liyuxuan3003/PrismGC/Test/lmj/WII_2nd/29366194135649415.jpg

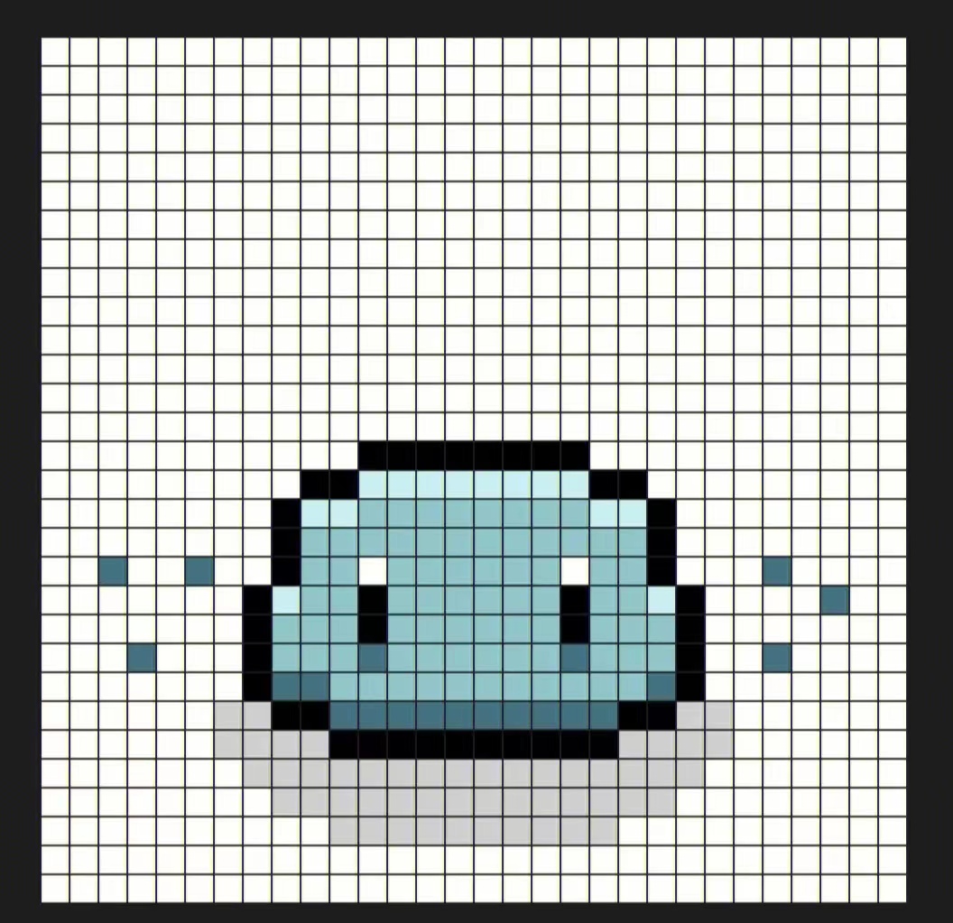
Test/lmj/WII_2nd/29366194135649415.jpg
