liyuxuan3003/PrismGC/Test/lmj/nunchuckarduinoExample-master/Readme.md

README
======

This is an example how to collect the gyroscope from a Nun Chuck device and send the information throught usb port.

Acknowledgments
===============

This project is a modified veriosn of nunchuck library found at:
http://www.windmeadow.com/node/42
