liyuxuan3003/PrismGC/Report/20230817-PrismGCDocumentFinal/Appendix.tex

\section{游戏地图展示}

\begin{TableLong}[游戏地图展示]{|c|c|c|}
    \xcell<c>[2ex][0ex]{}&
    \xcell<c>[2ex][0ex]{}&
    \xcell<c>[2ex][0ex]{}\\*
    \tiny\ttfamily RDRU L&
    \tiny\ttfamily DRUL DRUL D&
    \tiny\ttfamily ULDR DLUR DLU\\*
    关卡01&关卡02&关卡03\\ \hlinelig
    \xcell<c>[2ex][0ex]{}&
    \xcell<c>[2ex][0ex]{}&
    \xcell<c>[2ex][0ex]{}\\*
    \tiny\ttfamily DRRU&
    \tiny\ttfamily DRUL DDRU RDUL D&
    \tiny\ttfamily UDRD LUDR\\*
    关卡04&关卡05&关卡06\\ \hlinelig
    \xcell<c>[2ex][0ex]{}&
    \xcell<c>[2ex][0ex]{}&
    \xcell<c>[2ex][0ex]{}\\*
    \tiny\ttfamily DRDR LDRR UDR&
    \tiny\ttfamily RDLU RLUL D&
    \tiny\ttfamily DRRU RDLU DRL\\*
    关卡07&关卡08&关卡09\\ \hlinelig
    \xcell<c>[2ex][0ex]{}&
    \xcell<c>[2ex][0ex]{}&
    \xcell<c>[2ex][0ex]{}\\*
    \tiny\ttfamily DRDL URDU L&
    \tiny\ttfamily LULR RDDU&
    \tiny\ttfamily UURR UULL DURD DRDD D\\*
    关卡10&关卡11&关卡12\\ \hlinelig
    \xcell<c>[2ex][0ex]{}&
    \xcell<c>[2ex][0ex]{}&
    \xcell<c>[2ex][0ex]{}\\*
    \tiny\ttfamily DRUU LDLD DRRU U&
    \tiny\ttfamily RRDU UULL LDDD RRRR U&
    \tiny\ttfamily RLDU RDRU DDD\\*
    关卡13&关卡14&关卡15\\ \hlinelig
    \xcell<c>[2ex][0ex]{}&
    \xcell<c>[2ex][0ex]{}&
    \xcell<c>[2ex][0ex]{}\\*
    \tiny\ttfamily RDLD RDLL URRD&
    \tiny\ttfamily RULD LUDR URDR&
    \tiny\ttfamily DLUR DRUR DR\\*
    关卡16&关卡17&关卡18\\ \hlinelig
    \xcell<c>[2ex][0ex]{}&
    \xcell<c>[2ex][0ex]{}&
    \xcell<c>[2ex][0ex]{}\\*
    \tiny\ttfamily DRUL DR&
    \tiny\ttfamily LDRU RLLD RULD LURU LDRD&
    \tiny\ttfamily LURU LDRU LDDL RRUU L\\*
    关卡19&关卡20&关卡21\\ \hlinelig
    \xcell<c>[2ex][0ex]{}&
    \xcell<c>[2ex][0ex]{}&
    \xcell<c>[2ex][0ex]{}\\*
    \tiny\ttfamily DDDL RURU RDLL URDL RUR&
    \tiny\ttfamily LDRD LDRL URD&
    \tiny\ttfamily DURD RDLU RDDL DLUR UDLU RDLU\\*
    关卡22&关卡23&关卡24\\ \hlinelig
    \xcell<c>[2ex][0ex]{}&
    \xcell<c>[2ex][0ex]{}&
    \xcell<c>[2ex][0ex]{}\\*
    \tiny\ttfamily DRUL RUDR ULRD UD&
    \tiny\ttfamily RDLL LLLD DRDD L&
    \tiny\ttfamily URDL LULD RULD RRDL UULU RDRU RD\\*
    关卡25&关卡26&关卡27\\ \hlinelig
    \xcell<c>[2ex][0ex]{}&
    \xcell<c>[2ex][0ex]{}&
    \xcell<c>[2ex][0ex]{}\\*
    \tiny\ttfamily RDLU DRUR DRUL&
    \tiny\ttfamily LRUL URD&
    \tiny\ttfamily ULRU LDUL LDLU RU\\*
    关卡28&关卡29&关卡30\\ \hlinelig
    \xcell<c>[2ex][0ex]{}&
    \xcell<c>[2ex][0ex]{}&
    \xcell<c>[2ex][0ex]{}\\*
    \tiny\ttfamily LDRD URDL LRD&
    \tiny\ttfamily LDLD DULD LUU&
    \tiny\ttfamily LDUR DRU\\*
    关卡31&关卡32&关卡33\\ \hlinelig
    \xcell<c>[2ex][0ex]{}&
    \xcell<c>[2ex][0ex]{}&
    \xcell<c>[2ex][0ex]{}\\*
    \tiny\ttfamily RDLU RDRU&
    \tiny\ttfamily RDLU RURU&
    \tiny\ttfamily RULR DURD LDLU RDRU DLUR DURU LURD\\*
    关卡34&关卡35&关卡36\\ \hlinelig
    \xcell<c>[2ex][0ex]{}&
    \xcell<c>[2ex][0ex]{}&
    \xcell<c>[2ex][0ex]{}\\*
    \tiny\ttfamily UURL DLUL URUR DLRR DLUL DLUR ULDR&
    \tiny\ttfamily LUUU RRDL UURU D&
    \tiny\ttfamily DRUL DRUD LLLU RUL\\*
    关卡37&关卡38&关卡39\\ \hlinelig
    \xcell<c>[2ex][0ex]{}&
    \xcell<c>[2ex][0ex]{}&
    \xcell<c>[2ex][0ex]{}\\*
    \tiny\ttfamily URDL RLUL URDL RLRU LDRL DLUL&
    \tiny\ttfamily LRLU LU&
    \tiny\ttfamily DDDR ULDR ULD\\*
    关卡40&关卡41&关卡42\\ \hlinelig
    \xcell<c>[2ex][0ex]{}&
    \xcell<c>[2ex][0ex]{}&
    \xcell<c>[2ex][0ex]{}\\*
    \tiny\ttfamily DRDU LURD DR&
    \tiny\ttfamily ULRL DUDR UDLR LRUL URU&
    \tiny\ttfamily DRUR ULRD L\\*
    关卡43&关卡44&关卡45\\ \hlinelig
    \xcell<c>[2ex][0ex]{}&
    \xcell<c>[2ex][0ex]{}&
    \xcell<c>[2ex][0ex]{}\\*
    \tiny\ttfamily RDRU LDLU URLD LRDU RDL&
    \tiny\ttfamily LUDL DRD&
    \tiny\ttfamily DRUR DLDL RUL\\*
    关卡46&关卡47&关卡48\\ \hlinelig
\end{TableLong}
