liyuxuan3003/PrismGC/Inventor/Datasheet.md

# 数据
- 定位孔横向间距 111.760mm（一半是55.880mm）
- 定位孔纵向间距  59.696mm（一半是29.848mm）
- 板子横向距离 119.380mm
- 板子纵向距离  67.310mm
- 内部横向距离 120.380mm
- 内部纵向距离  88.000mm
- 外部横向距离 122.780mm
- 外部纵向距离  95.400mm
- 板间距  15.11mm
- 单板厚度 10.00mm
- 电路板厚度 1.60mm
- USB中心距离下侧边沿 15.240mm 距离中心 +18.415mm
- USB下边沿上 距离 电路板下 2.95mm
- USB上边沿上 距离 电路板下 9.05mm
- USB边沿厚度 1.00mm
- USB下侧开槽 距离 电路板下 0.95mm
- USB上册开槽 距离 电路板下 10.05mm
- USB横向宽度 14.40mm
- USB横向开槽 16.40mm
- HDMI中心距离下测边沿 38.100mm 距离中心 -4.445mm
- HDMI下边沿上 距离 电路板下 2.80mm
- HDMI上边沿上 距离 电路板下 7.85mm
- HDMI下侧开槽 距离 电路板下 1.30mm
- HDMI上侧开槽 距离 电路板下 8.85mm
- HDMI边沿厚度 0.50mm
- HDMI横向宽度 15.10mm
- HDMI横向开槽 17.10mm

- 3.5中心距离下测边沿 55.118mm 距离中心 21.463mm
- 3.5直径 5mm
- 3.5开槽直径 6mm
- 3.5中心距板底 4.1mm

- WII横向 12.25mm
- WII纵向 7.20mm 5.88mm
- 向上 3.94mm
- 向下 5.26mm
- 向左 向右 7.125mm
- WII中心距离下侧边沿 14.478mm 距离中心 -19.177 

- TypeC中心距离下侧边沿 34.290 距离中心 0.635
- TypeC横向 9.00mm
- TypeC纵向 3.30mm /2=1.65mm
- TypeC横向开槽 11.00mm
- TypeC纵向开槽 5.30mm
