liyuxuan3003/PrismGC/Project/AHBLiteList.md

# AHBLite 外设列表
0. RAMCODE      0x0000_0000 - 0x0000_FFFF
1. RAMDATA      0x2000_0000 - 0x2000_FFFF
2. SDRAM        0x4000_0000
3. Timer        0x6000_0000
4. GPIO         0x6001_0000
5. UART         0x6002_0000
6. IIC          0x6003_0000
7. GPULite      0x6004_0000
8. Buzzer       0x6005_0000
9. Digit        0x6006_0000
10. KeyBoard    0x6007_0000
