liyuxuan3003/PrismGC/Report/20230817-PrismGCDocumentFinal/image/FrontPage.docx

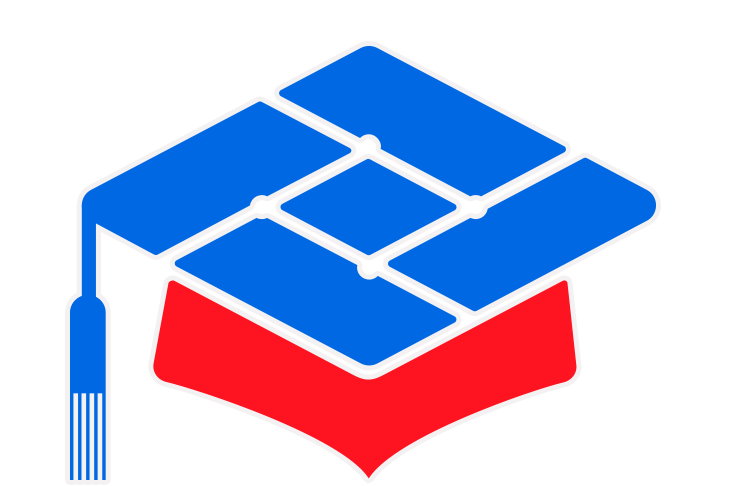
[picture p3: figure]
bff91a9c0ef4a7c5f3d8e6b5bfef969

第七届

全国大学生集成电路创新创业大赛

报告类型*： 设计报告

参赛杯赛*： 安谋科技（Arm China）杯

作品名称*： PrismGC

队伍编号*： CICC1164

团队名称*： 棱镜
