liyuxuan3003/PrismGC/Report/20230819-PrismGCpptFinal/演讲稿_视频版.md

# 基于ARM处理器的智能游戏机 演讲稿

大家好，我们是棱镜项目组。

这是我们游戏机系统的总体框图，以安路科技EG4S20为中心，输入外设主要是WII Nunchunk手柄，输出的话，画面是通过HDMI协议，到这块显示屏，分辨率为1024x600。音频就是通过3.5mm音频接口，到这个外置的扬声器。

这个是我们游戏机系统的一个硬件构成，电路板是有两层，上面是硬木课堂EG4S20核心板，下面呢是我们决赛期间自制的扩展板。自制扩展板的主要用途就是从核心板引出各个对外的接口，比如HDMI接口、3.5mm音频接口、II Nunchunk手柄接口。

我们的系统架构如下，硬件部分主要是M0处理器和AHBLite总线，以及一些需要复杂时序的功能的模块，比如显示编码，硬件部分的意义就是将外设封装为若干寄存器，使得软件部分不需要关心驱动外设所需的时序，而是可以直接通过寄存器操作外设的工作状态。软件部分就主要是用来实现游戏的具体内容等。

我们主要有两个设计亮点。

其一是HDMI显示。硬件上我们是自己实现了HDMI编码和VESA时序，这里面过程充运用了安路提供的IP资源，包括硬件锁相环PLL和端口倍频ODDR。硬件上SDRAM做了一块显存，显示内容是由软件控制，所以我们游戏画面就可以做的比较丰富，比如这个史莱姆和苹果啊，还有字符的显示。尤其值得一提的是，显示中我们引入了Ping Pong机制，有效避免了屏幕闪烁的问题。

其二是WII Nunchunk手柄，它通讯用的是IIC协议，通过挂GPIO然后软件实现。手柄的功能很丰富，这边C和Z两个按键，有一个摇杆，内部还有加速度传感器，实现了体感控制，提供给我们游戏机一个智能化的的交互体验。

接下来，将通过实机演示展示游戏机功能。
