liyuxuan3003/PrismGC/Report/20230817-PrismGCDocumentFinal/PrismGCDocumentFinal.tex

\documentclass{xDocument}

\usepackage{pdfpages}

\usepackage{xCommon}
\usepackage{xMath}
\usepackage{xFloat}
\usepackage{xTikz}

\usepackage{Local}

\begin{document}

\title{PrismGC 设计报告}

\includepdf{image/FrontPage.pdf}

\pagestyle{fancy}

\input{Abstract.tex}
\clearpage

\tableofcontents
\clearpage

\input{Section01.tex}
\clearpage
\input{Section02.tex}
\clearpage
\input{Section03.tex}
\clearpage
\input{Section04.tex}
\clearpage
\appendix
\input{Appendix.tex}

\end{document}
