liyuxuan3003/PrismGC/Test/lmj/lmjreport/gamediscription.md

# 游戏背景
一只小史莱姆在它的旅程中经过一片极地，恰逢此时，雪霁银装素，桔高映琼枝。新奇的景色勾起史莱姆的一片玩心。而史莱姆在雪地上撒欢了一段时间后发现，它已经迷失在雪地中，在这天寒地冻的环境中，它迫切地需要收集食物并达到庇护点以存活下去。因此，史莱姆开始了它的行动……
# 游戏简介
## 基本玩法介绍
在每一关游戏开始时，史莱姆会从固定出发点出发，它可以在冰面上沿着一个方向直线滑行，直到其遇到其他方块。史莱姆的目标是进入到木屋躲避严寒，在这个基础上，史莱姆还会收集尽可能多的食物以抵御严寒。
## 方块介绍
- 冰面：最普遍的基本方块；史莱姆可以自由通过方块，但无法主动停下。
- 雪堆：基本方块之一；虽然冰面难以停下，但借助雪堆的阻挡，史莱姆可以停止在冰面上。
- 碎石：堆积在冰面上的碎石，可以阻拦一次冲撞，但被冲撞之后会破碎，无法再阻挡史莱姆。
- 法阵：疑似本地土著留下的神秘法阵；一般成对出现，经过时会被强制传送至另外一处。
- 木屋：在雪地中提供保护的场所；是史莱姆行动的终点，也是其得以存活的依靠。
- 机关：雪地中残留的弹射机关；史莱姆经过时，机关会启动，将史莱姆往对应方向弹射。（
- 苹果：史莱姆的食物；在达到庇护所的路程中，史莱姆想收集足够多的苹果。
- 更多方块正在发现中……
## 游戏操作
史莱姆和选关菜单内的游标的移动方向主要包括上下左右四个方向的移动，分别由按钮10，2，7，5操作；此外，按键15可以用于返回主界面，3可用于从主界面进入选关菜单，6可用于确认选关而进入对应关卡。顺便一提，选关游标达到边界时会自动翻页，若达到边界（目前是32关）则不再移动。
## 智能输入
由于按键操作较为复杂，并不直观，因此我们采用了鸡腿手柄作为智能输入。玩家可以通过操作手柄上摇杆的横纵坐标达成对应的上下左右的移动，C按钮控制确认。当玩家按住Z按钮时，可以通过甩动手柄，达成上下左右的移动。

# 游戏类型
## 游戏分类
该游戏属于休闲益智类游戏。
## 游戏评分
其成绩评判主要有：是否抵达庇护所、收集的食物数量（以苹果表示）以及整个过程所用的步数。玩家应使用尽可能短的步程，收集足够多的食物并达到庇护所。因此，行动过程中与特殊方格的交互及其顺序就比较考验玩家的思考。
