liyuxuan3003/PrismGC/Test/lmj/lmjreport/shit_preparation.md

# 采用鸡腿手柄输入的方法和意义
1. 方法不知道（思路：介绍手柄协议-如何实现和板子的连接-最后达成什么功能）
2. 意义是解决了键盘输入不边界、不直观的问题，并且可以和投屏机器搭配使用，让玩家在游玩的同时又可以有身体交互，防止久坐引发的一系列健康问题。
# 存储相关（小概率）
# 显示相关（小概率）
# 如何制成移动效果，如何交互，如何判定移动到某处结束
# 设计过程中碰到了什么困难，如何解决
# 如何绘制地图和判定地图上每个方格的逻辑
### 个人意见：zy做的部分应该是重点提问部分；至于lmj做的显示图层，实际上可提问内容较少；另外，lyx做的硬件部分，除非很专业的老师当答辩老师，不然不会作为重点
