liyuxuan3003/PrismGC/Project/Resouce.md

# 资源链接汇总

请各位积极添加觉得有用的资源链接，先添加，后整理。

## 报名网站
- 赛题：http://univ.ciciec.com/nd.jsp?id=553#_jcp=1
- 赛氪报名平台：https://www.saikr.com/

## 菜鸟教程
- Verilog：https://www.runoob.com/w3cnote/verilog-tutorial.html
- Git：https://www.runoob.com/git/git-tutorial.html
- C：https://www.runoob.com/cprogramming/c-tutorial.html

## 硬木课堂（FPGA板卡）
- 购买链接（EG4S20板卡）：https://m.tb.cn/h.UKXtKNy?tk=QpYEd85fy2n
- 购买链接（PH1A60板卡）：https://m.tb.cn/h.UphTriw?tk=f27Xd85UWIf
- EG4S20资料1（x）：https://www.yuque.com/yingmuketang/01/qha859
- EG4S20资料2（v）：https://www.yuque.com/yingmuketang/01/zhdvgh
- Cortex-M0资料：https://www.yuque.com/yingmuketang/01/evn0qh

## 正点原子（STM32单片机）
- 购买链接：https://m.tb.cn/h.UnNLJDv?tk=er2AdhwGp7E
- 购买型号：精英+4.3存屏+STLINK下载器
- 资料：http://openedv.com/thread-340250-1-1.html

## WII手柄
- 手柄购买链接（左手弯柄又名鸡腿）：https://m.tb.cn/h.UpxegpN?tk=SNyRd8YcN7s
- 手柄转接器购买链接：https://m.tb.cn/h.UKwwcpI?tk=5UGsd857Dhc
- 资料：https://www.instructables.com/Wii-Nunchuck-as-general-purpose-controller-via-Ard/
- 用Verilog实现IIC协议：https://blog.csdn.net/qq_43550173/article/details/90384126
- https://blog.csdn.net/ssj925319/article/details/126427237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
- IIC总线协议详情：https://zhuanlan.zhihu.com/p/149364473
- WII手柄直连经验：https://tieba.baidu.com/p/6314558646 （doubtful）
## 梯子
- 鹰云VPN：https://yinyun.me/

## ARM
- Compiler5下载页面：https://developer.arm.com/downloads/view/ACOMP5

## 零散资料
- Cortex-M0软件开发与Keil开发工具实战介绍：https://www.bilibili.com/video/BV1YV411r7M2/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
- Keil配置Compiler5：https://blog.csdn.net/mikusure/article/details/124899626
