liyuxuan3003/PrismGC/Report/20230817-PrismGCDocumentFinal/image/002_3D.pdf

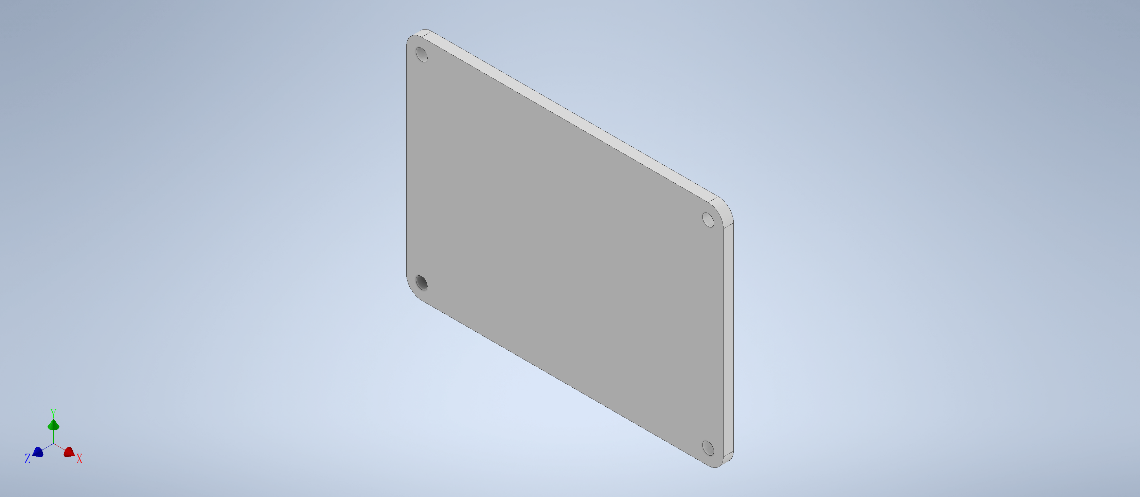
[picture p24: page 1]
