liyuxuan3003/PrismGC/Report/20230817-PrismGCDocumentFinal/image/PrismGCNew_3D.pdf

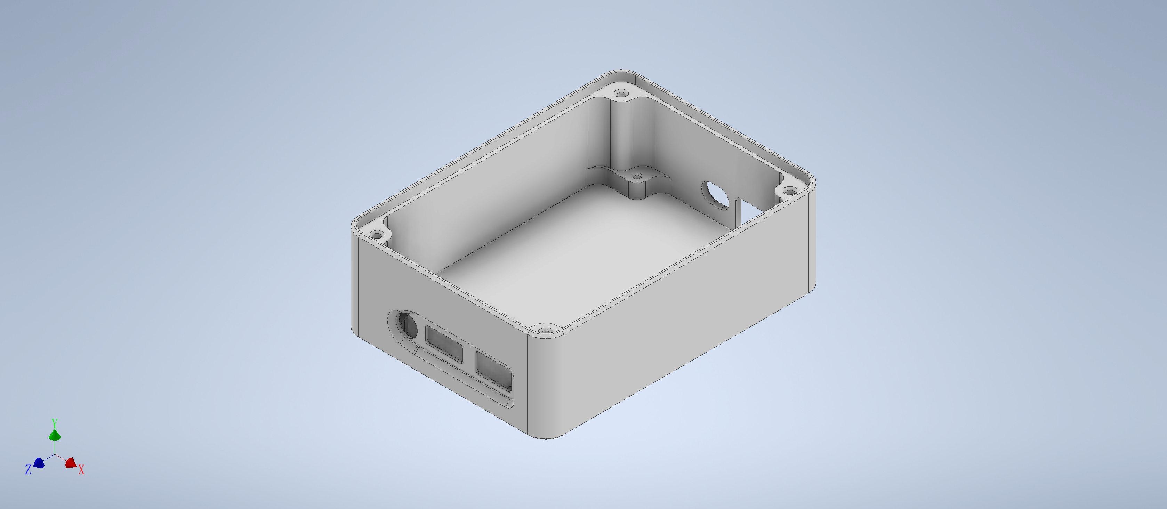
[picture p25: page 1]
