liyuxuan3003/PrismGC/Report/20230817-PrismGCDocumentFinal/image/1.png

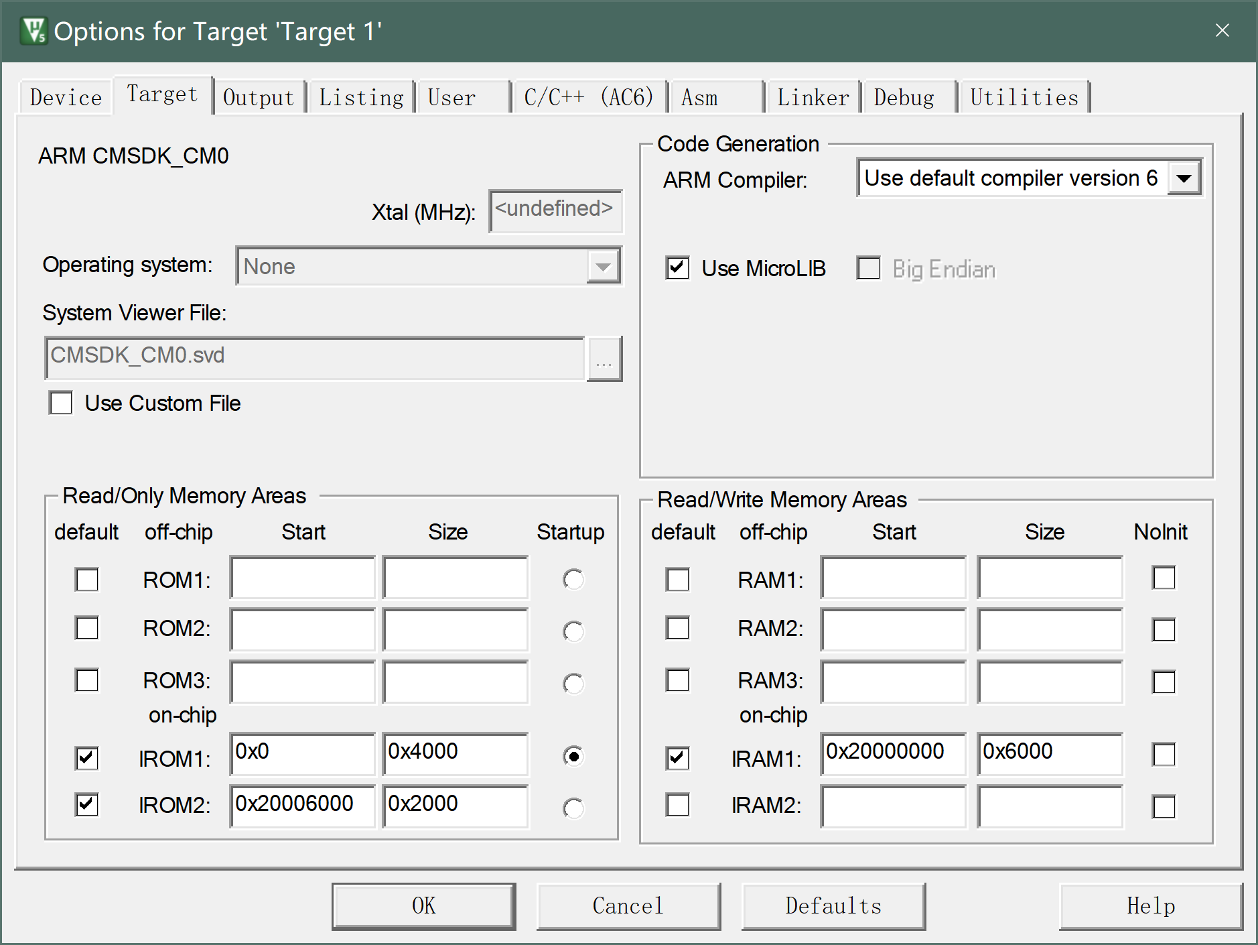
Report/20230817-PrismGCDocumentFinal/image/1.png
