liyuxuan3003/PrismGC/Report/20230817-PrismGCDocumentFinal/image/2.png

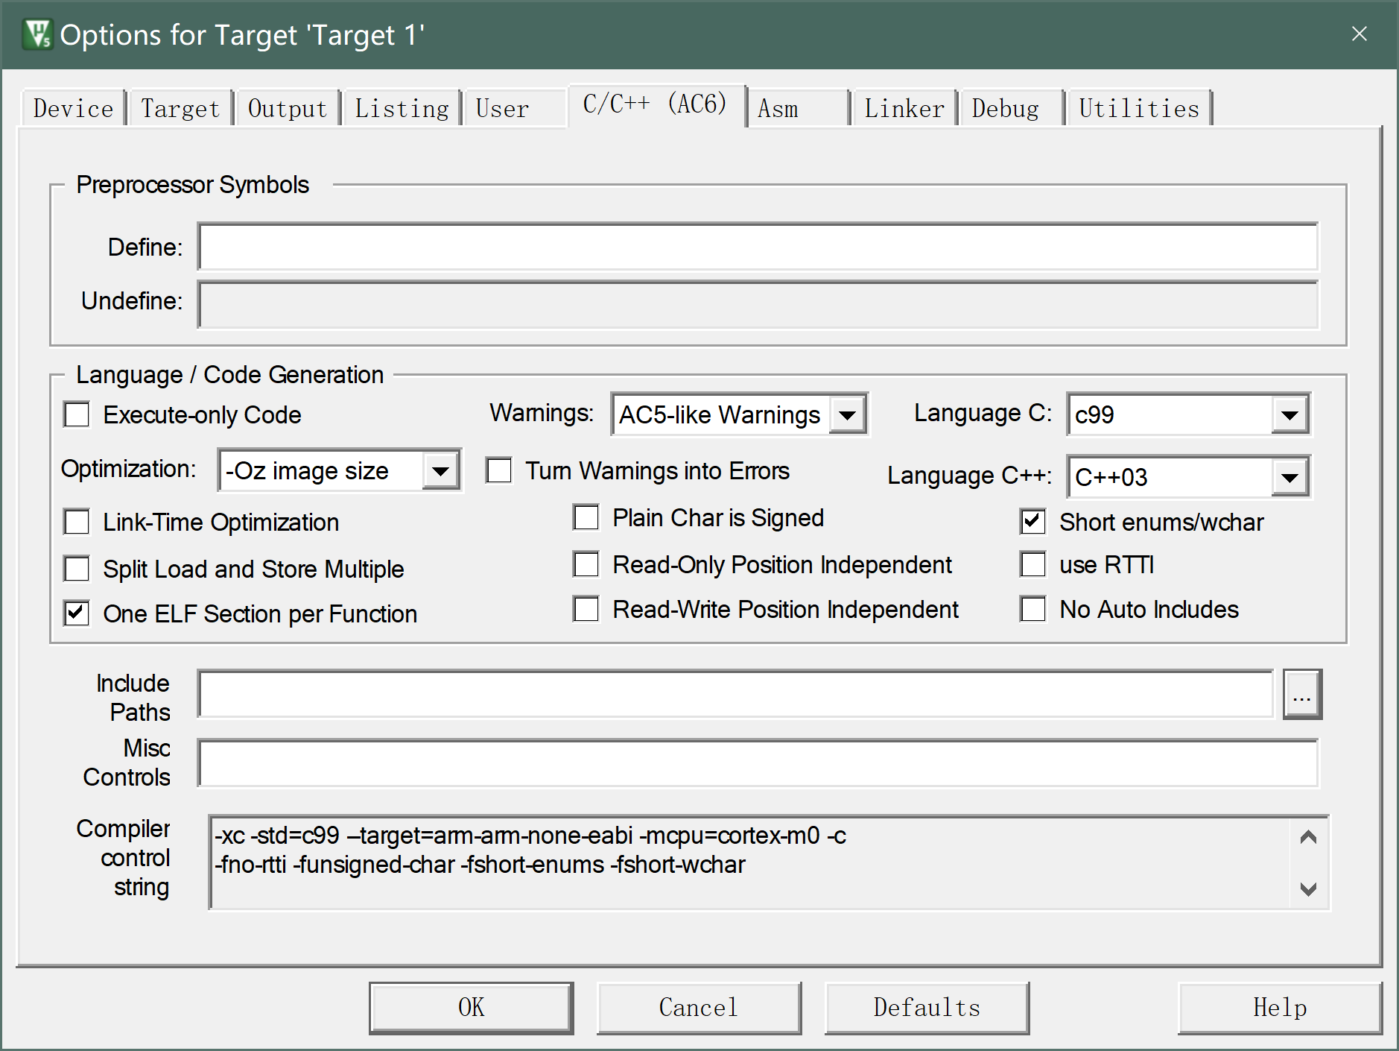
Report/20230817-PrismGCDocumentFinal/image/2.png
