liyuxuan3003/PrismGC/Report/20230819-PrismGCpptFinal/2.png

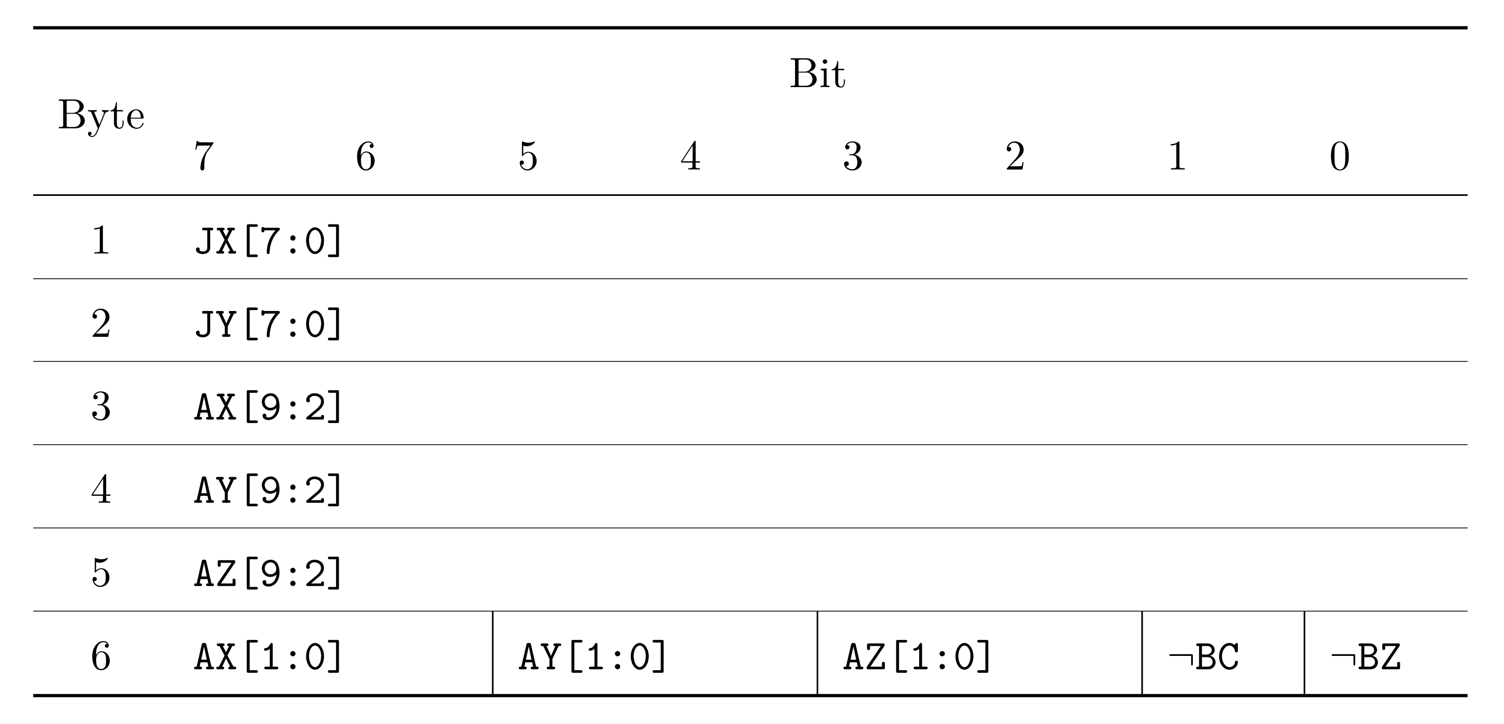
Report/20230819-PrismGCpptFinal/2.png
