liyuxuan3003/PrismGC/Report/20230819-PrismGCpptFinal/WII.jpg

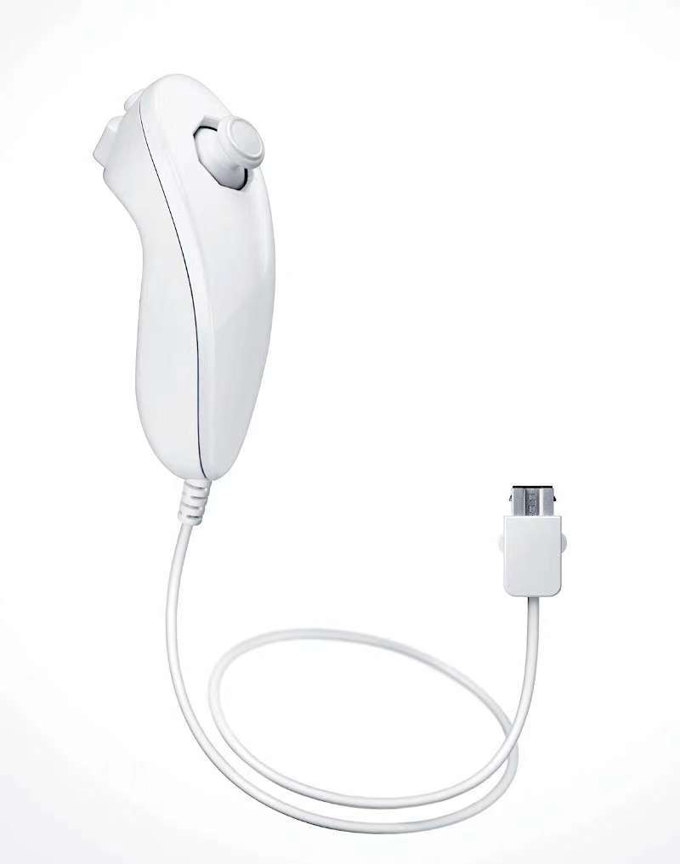
Report/20230819-PrismGCpptFinal/WII.jpg
