liyuxuan3003/PrismGC/Report/20230819-PrismGCpptFinal/屏幕截图 2023-08-19 195324.png

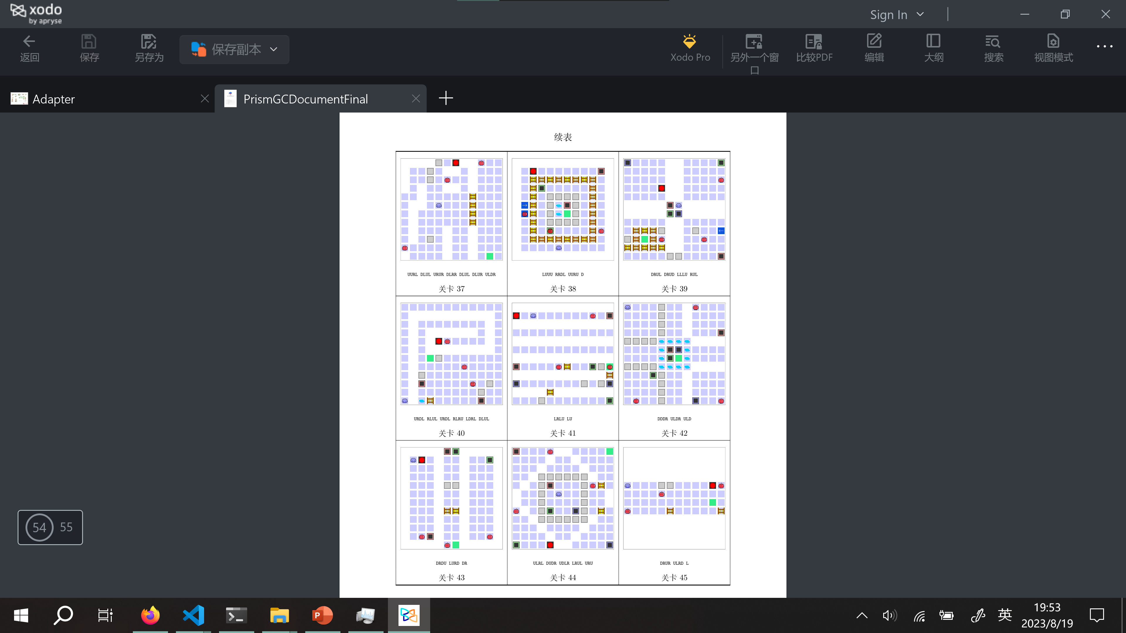
Report/20230819-PrismGCpptFinal/屏幕截图 2023-08-19 195324.png
