liyuxuan3003/PrismGC/Inventor/PrismGCUpNew.stp

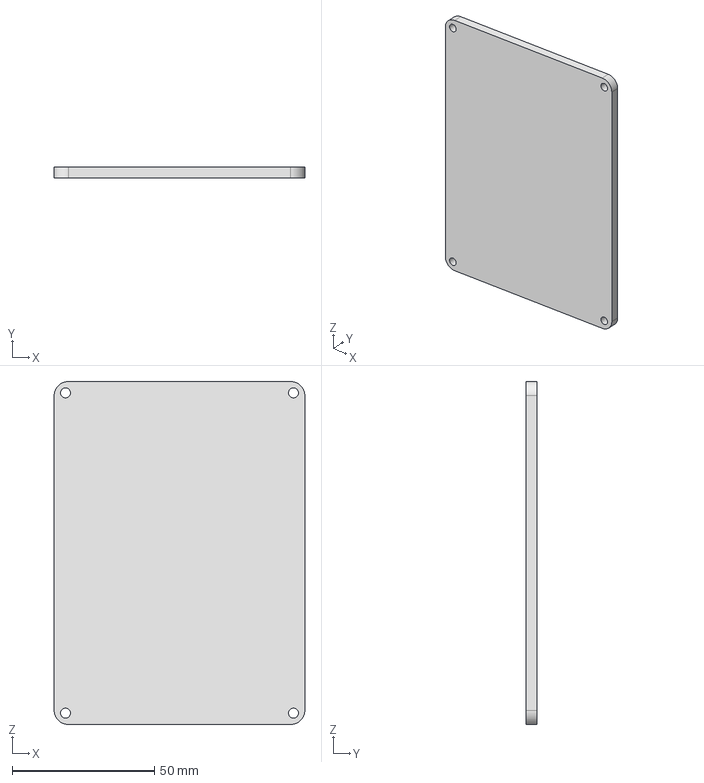
[picture p38: CAD file, 2023-08-12]
Inventor/PrismGCUpNew.stp
88.0 x 4.00 x 120.4 mm
