liyuxuan3003/PrismGC/Inventor/Upload/PrismGCNew.stp

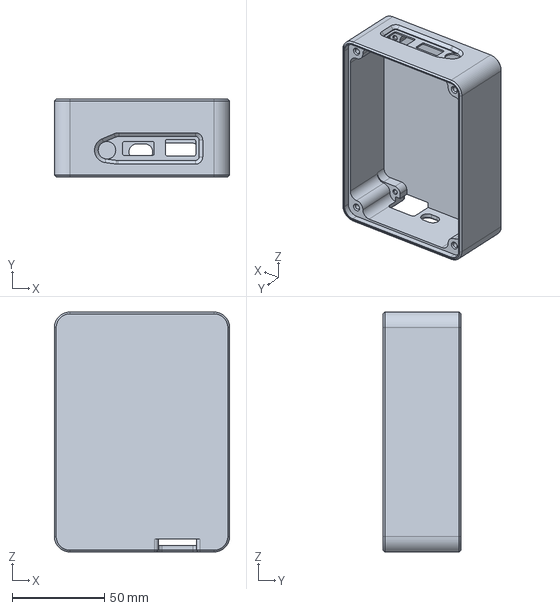
[picture p39: CAD file, 2023-08-12]
Inventor/Upload/PrismGCNew.stp
95.0 x 42.1 x 130.0 mm
