liyuxuan3003/PrismGC/Inventor/PrismGCNew.stp

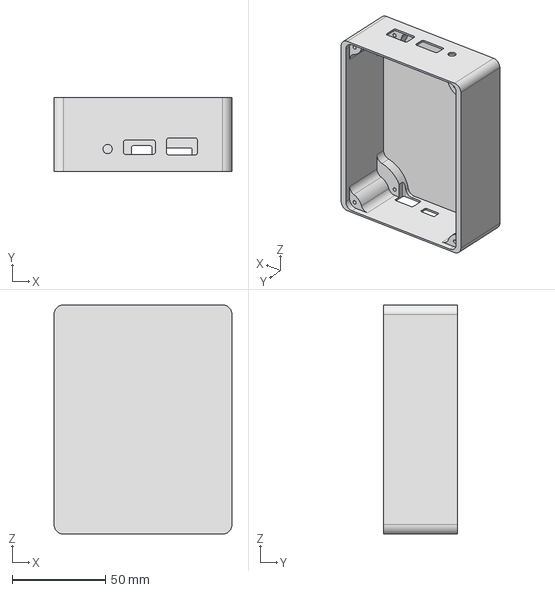
[picture p40: CAD file, 2023-08-12]
Inventor/PrismGCNew.stp
95.4 x 39.8 x 122.8 mm
