liyuxuan3003/PrismGC/Inventor/Upload/Product1.stp

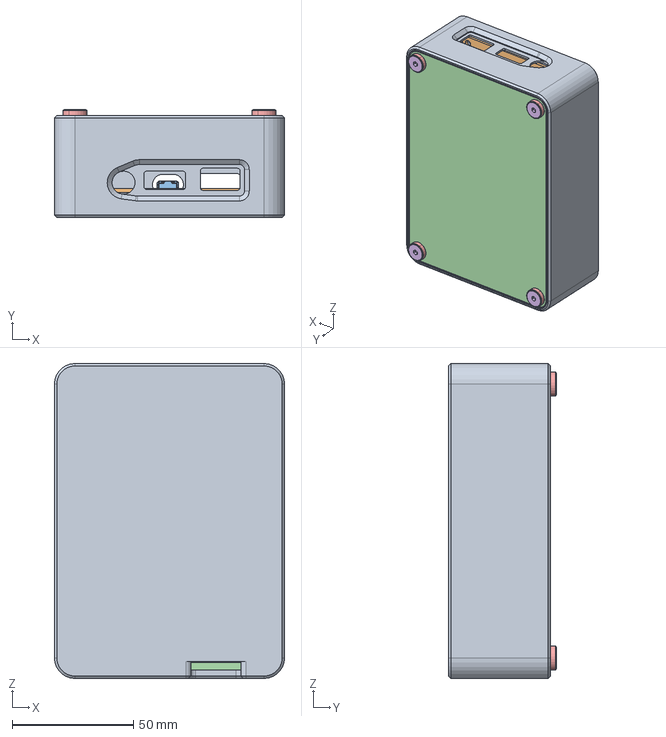
[picture p41: CAD file, 2023-08-12]
Inventor/Upload/Product1.stp
95.0 x 44.6 x 130.0 mm
