liyuxuan3003/PrismGC/Inventor/Upload/002.stp

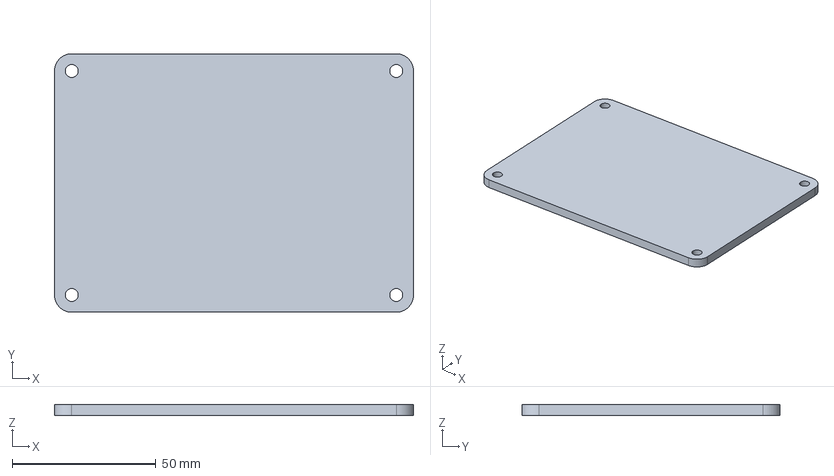
[picture p42: CAD file, 2023-08-12]
Inventor/Upload/002.stp
125.0 x 90.0 x 4.00 mm
