liyuxuan3003/PrismGC/(list of files, cad)

Other CAD files:
Inventor/OldVersions/PrismGCUpNew.0001.dwg
Inventor/OldVersions/PrismGCNew.0004.dwg
Inventor/OldVersions/PrismGC.0004.ipt
Inventor/OldVersions/PrismGCNew.0015.ipt
Inventor/OldVersions/PrismGCUpNew.0001.ipt
Inventor/PrismGC.ipt
Inventor/PrismGCNew.dwg
Inventor/PrismGCNew.ipt
Inventor/PrismGCUpNew.dwg
Inventor/PrismGCUpNew.ipt
Inventor/Upload/002.dwg
Inventor/Upload/PrismGCNew.dwg
