liyuxuan3003/PrismGC/Test/lmj/M0_Experiments/Experiments/Task1/keil/code.htm

# Static Call Graph for image .\code.axf

#<CALLGRAPH># ARM Linker, 6160001: Last Updated: Thu Mar 17 17:03:38 2022

### Maximum Stack Usage = 0 bytes + Unknown(Untraceable Function Pointers)

### Call chain for Maximum Stack Depth:

### Function Pointers

- Reset_Handler from startup_cmsdk_cm0.o(.text) referenced from startup_cmsdk_cm0.o(RESET)

### Global Symbols

Reset_Handler (Thumb, 12 bytes, Stack size 0 bytes, startup_cmsdk_cm0.o(.text))
[Address Reference Count : 1]

- startup_cmsdk_cm0.o(RESET)

### Local Symbols

### Undefined Global Symbols
