liyuxuan3003/PrismGC/Test/lmj/M0_Experiments/Experiments/Task4/keil/code.htm

# Static Call Graph for image .\code.axf

#<CALLGRAPH># ARM Linker, 5060960: Last Updated: Sat Apr 02 21:36:13 2022

### Maximum Stack Usage = 8 bytes + Unknown(Untraceable Function Pointers)

### Call chain for Maximum Stack Depth:

KEY0_Handler ⇒ KEY0

### Function Pointers

- KEY0_Handler from startup_cmsdk_cm0.o(.text) referenced from startup_cmsdk_cm0.o(RESET)
- KEY1_Handler from startup_cmsdk_cm0.o(.text) referenced from startup_cmsdk_cm0.o(RESET)
- KEY2_Handler from startup_cmsdk_cm0.o(.text) referenced from startup_cmsdk_cm0.o(RESET)
- KEY3_Handler from startup_cmsdk_cm0.o(.text) referenced from startup_cmsdk_cm0.o(RESET)
- Reset_Handler from startup_cmsdk_cm0.o(.text) referenced from startup_cmsdk_cm0.o(RESET)
- __main from entry.o(.ARM.Collect$$$$00000000) referenced from startup_cmsdk_cm0.o(.text)
- main from main.o(i.main) referenced from entry9a.o(.ARM.Collect$$$$0000000B)

### Global Symbols

__main (Thumb, 0 bytes, Stack size unknown bytes, entry.o(.ARM.Collect$$$$00000000))
[Address Reference Count : 1]

- startup_cmsdk_cm0.o(.text)

_main_stk (Thumb, 0 bytes, Stack size unknown bytes, entry2.o(.ARM.Collect$$$$00000001))

_main_scatterload (Thumb, 0 bytes, Stack size unknown bytes, entry5.o(.ARM.Collect$$$$00000004))

[Calls]

- >> __scatterload

__main_after_scatterload (Thumb, 0 bytes, Stack size unknown bytes, entry5.o(.ARM.Collect$$$$00000004))

[Called By]

- >> __scatterload

_main_clock (Thumb, 0 bytes, Stack size unknown bytes, entry7b.o(.ARM.Collect$$$$00000008))

_main_cpp_init (Thumb, 0 bytes, Stack size unknown bytes, entry8b.o(.ARM.Collect$$$$0000000A))

_main_init (Thumb, 0 bytes, Stack size unknown bytes, entry9a.o(.ARM.Collect$$$$0000000B))

__rt_lib_shutdown_fini (Thumb, 0 bytes, Stack size unknown bytes, entry12b.o(.ARM.Collect$$$$0000000E))

[Calls]

- >> __arm_fini_ (Weak Reference)

__rt_final_cpp (Thumb, 0 bytes, Stack size unknown bytes, entry10a.o(.ARM.Collect$$$$0000000F))

__rt_final_exit (Thumb, 0 bytes, Stack size unknown bytes, entry11a.o(.ARM.Collect$$$$00000011))

Reset_Handler (Thumb, 8 bytes, Stack size 0 bytes, startup_cmsdk_cm0.o(.text))

KEY0_Handler (Thumb, 8 bytes, Stack size 0 bytes, startup_cmsdk_cm0.o(.text))

[Stack]

- Max Depth = 8
- Call Chain = KEY0_Handler ⇒ KEY0

[Calls]

- >> KEY0

[Address Reference Count : 1]

- startup_cmsdk_cm0.o(RESET)

KEY1_Handler (Thumb, 8 bytes, Stack size 0 bytes, startup_cmsdk_cm0.o(.text))

[Stack]

- Max Depth = 8
- Call Chain = KEY1_Handler ⇒ KEY1

[Calls]

- >> KEY1

[Address Reference Count : 1]

- startup_cmsdk_cm0.o(RESET)

KEY2_Handler (Thumb, 8 bytes, Stack size 0 bytes, startup_cmsdk_cm0.o(.text))

[Stack]

- Max Depth = 8
- Call Chain = KEY2_Handler ⇒ KEY2

[Calls]

- >> KEY2

[Address Reference Count : 1]

- startup_cmsdk_cm0.o(RESET)

KEY3_Handler (Thumb, 8 bytes, Stack size 0 bytes, startup_cmsdk_cm0.o(.text))

[Stack]

- Max Depth = 8
- Call Chain = KEY3_Handler ⇒ KEY3

[Calls]

- >> KEY3

[Address Reference Count : 1]

- startup_cmsdk_cm0.o(RESET)

__scatterload (Thumb, 28 bytes, Stack size 0 bytes, init.o(.text))

[Calls]

- >> __main_after_scatterload

[Called By]

- >> _main_scatterload

__scatterload_rt2 (Thumb, 0 bytes, Stack size 0 bytes, init.o(.text), UNUSED)

KEY0 (Thumb, 10 bytes, Stack size 8 bytes, keyboard.o(i.KEY0))

[Stack]

- Max Depth = 8
- Call Chain = KEY0

[Calls]

- >> SetWaterLightMode

[Called By]

- >> KEY0_Handler

KEY1 (Thumb, 10 bytes, Stack size 8 bytes, keyboard.o(i.KEY1))

[Stack]

- Max Depth = 8
- Call Chain = KEY1

[Calls]

- >> SetWaterLightMode

[Called By]

- >> KEY1_Handler

KEY2 (Thumb, 10 bytes, Stack size 8 bytes, keyboard.o(i.KEY2))

[Stack]

- Max Depth = 8
- Call Chain = KEY2

[Calls]

- >> SetWaterLightMode

[Called By]

- >> KEY2_Handler

KEY3 (Thumb, 10 bytes, Stack size 8 bytes, keyboard.o(i.KEY3))

[Stack]

- Max Depth = 8
- Call Chain = KEY3

[Calls]

- >> SetWaterLightMode

[Called By]

- >> KEY3_Handler

SetWaterLightMode (Thumb, 8 bytes, Stack size 0 bytes, code_def.o(i.SetWaterLightMode))

[Called By]

- >> KEY3
- >> KEY2
- >> KEY1
- >> KEY0

SetWaterLightSpeed (Thumb, 8 bytes, Stack size 0 bytes, code_def.o(i.SetWaterLightSpeed))

[Called By]

- >> main

__scatterload_copy (Thumb, 14 bytes, Stack size unknown bytes, handlers.o(i.__scatterload_copy), UNUSED)

__scatterload_null (Thumb, 2 bytes, Stack size unknown bytes, handlers.o(i.__scatterload_null), UNUSED)

__scatterload_zeroinit (Thumb, 14 bytes, Stack size unknown bytes, handlers.o(i.__scatterload_zeroinit), UNUSED)

main (Thumb, 16 bytes, Stack size 0 bytes, main.o(i.main))

[Calls]

- >> SetWaterLightSpeed

[Address Reference Count : 1]

- entry9a.o(.ARM.Collect$$$$0000000B)

### Local Symbols

### Undefined Global Symbols

__arm_fini_ (Unknown, 0 bytes, Stack size 0 bytes, UNDEFINED)

[Called By]

- >> __rt_lib_shutdown_fini
