liyuxuan3003/PrismGC/Test/lmj/M0_Experiments/Experiments/Task8/keil/code.htm

# Static Call Graph for image .\code.axf

#<CALLGRAPH># ARM Linker, 5060960: Last Updated: Sun Apr 03 13:05:47 2022

### Maximum Stack Usage = 28 bytes + Unknown(Untraceable Function Pointers)

### Call chain for Maximum Stack Depth:

UART_Handler ⇒ UARTHandle ⇒ UARTString ⇒ WriteUART

### Function Pointers

- Reset_Handler from startup_cmsdk_cm0.o(.text) referenced from startup_cmsdk_cm0.o(RESET)
- UART_Handler from startup_cmsdk_cm0.o(.text) referenced from startup_cmsdk_cm0.o(RESET)
- __main from entry.o(.ARM.Collect$$$$00000000) referenced from startup_cmsdk_cm0.o(.text)
- main from main.o(i.main) referenced from entry9a.o(.ARM.Collect$$$$0000000B)

### Global Symbols

__main (Thumb, 0 bytes, Stack size unknown bytes, entry.o(.ARM.Collect$$$$00000000))
[Address Reference Count : 1]

- startup_cmsdk_cm0.o(.text)

_main_stk (Thumb, 0 bytes, Stack size unknown bytes, entry2.o(.ARM.Collect$$$$00000001))

_main_scatterload (Thumb, 0 bytes, Stack size unknown bytes, entry5.o(.ARM.Collect$$$$00000004))

[Calls]

- >> __scatterload

__main_after_scatterload (Thumb, 0 bytes, Stack size unknown bytes, entry5.o(.ARM.Collect$$$$00000004))

[Called By]

- >> __scatterload

_main_clock (Thumb, 0 bytes, Stack size unknown bytes, entry7b.o(.ARM.Collect$$$$00000008))

_main_cpp_init (Thumb, 0 bytes, Stack size unknown bytes, entry8b.o(.ARM.Collect$$$$0000000A))

_main_init (Thumb, 0 bytes, Stack size unknown bytes, entry9a.o(.ARM.Collect$$$$0000000B))

__rt_lib_shutdown_fini (Thumb, 0 bytes, Stack size unknown bytes, entry12b.o(.ARM.Collect$$$$0000000E))

[Calls]

- >> __arm_fini_ (Weak Reference)

__rt_final_cpp (Thumb, 0 bytes, Stack size unknown bytes, entry10a.o(.ARM.Collect$$$$0000000F))

__rt_final_exit (Thumb, 0 bytes, Stack size unknown bytes, entry11a.o(.ARM.Collect$$$$00000011))

Reset_Handler (Thumb, 8 bytes, Stack size 0 bytes, startup_cmsdk_cm0.o(.text))

UART_Handler (Thumb, 8 bytes, Stack size 0 bytes, startup_cmsdk_cm0.o(.text))

[Stack]

- Max Depth = 28
- Call Chain = UART_Handler ⇒ UARTHandle ⇒ UARTString ⇒ WriteUART

[Calls]

- >> UARTHandle

[Address Reference Count : 1]

- startup_cmsdk_cm0.o(RESET)

strlen (Thumb, 14 bytes, Stack size 0 bytes, strlen.o(.text))

[Called By]

- >> UARTString

__scatterload (Thumb, 28 bytes, Stack size 0 bytes, init.o(.text))

[Calls]

- >> __main_after_scatterload

[Called By]

- >> _main_scatterload

__scatterload_rt2 (Thumb, 0 bytes, Stack size 0 bytes, init.o(.text), UNUSED)

Delay (Thumb, 18 bytes, Stack size 0 bytes, code_def.o(i.Delay))

[Called By]

- >> main

ReadUART (Thumb, 10 bytes, Stack size 0 bytes, code_def.o(i.ReadUART))

[Called By]

- >> UARTHandle

ReadUARTState (Thumb, 10 bytes, Stack size 0 bytes, code_def.o(i.ReadUARTState))

[Called By]

- >> WriteUART

SetWaterLightMode (Thumb, 8 bytes, Stack size 0 bytes, code_def.o(i.SetWaterLightMode))

[Called By]

- >> main

SetWaterLightSpeed (Thumb, 8 bytes, Stack size 0 bytes, code_def.o(i.SetWaterLightSpeed))

[Called By]

- >> main

UARTHandle (Thumb, 28 bytes, Stack size 8 bytes, code_def.o(i.UARTHandle))

[Stack]

- Max Depth = 28
- Call Chain = UARTHandle ⇒ UARTString ⇒ WriteUART

[Calls]

- >> WriteUART
- >> UARTString
- >> ReadUART

[Called By]

- >> UART_Handler

UARTString (Thumb, 28 bytes, Stack size 16 bytes, code_def.o(i.UARTString))

[Stack]

- Max Depth = 20
- Call Chain = UARTString ⇒ WriteUART

[Calls]

- >> strlen
- >> WriteUART

[Called By]

- >> main
- >> UARTHandle

WriteUART (Thumb, 22 bytes, Stack size 4 bytes, code_def.o(i.WriteUART))

[Stack]

- Max Depth = 4
- Call Chain = WriteUART

[Calls]

- >> ReadUARTState

[Called By]

- >> UARTString
- >> UARTHandle

__scatterload_copy (Thumb, 14 bytes, Stack size unknown bytes, handlers.o(i.__scatterload_copy), UNUSED)

__scatterload_null (Thumb, 2 bytes, Stack size unknown bytes, handlers.o(i.__scatterload_null), UNUSED)

__scatterload_zeroinit (Thumb, 14 bytes, Stack size unknown bytes, handlers.o(i.__scatterload_zeroinit), UNUSED)

main (Thumb, 94 bytes, Stack size 0 bytes, main.o(i.main))

[Stack]

- Max Depth = 20
- Call Chain = main ⇒ UARTString ⇒ WriteUART

[Calls]

- >> UARTString
- >> SetWaterLightSpeed
- >> SetWaterLightMode
- >> Delay

[Address Reference Count : 1]

- entry9a.o(.ARM.Collect$$$$0000000B)

### Local Symbols

### Undefined Global Symbols

__arm_fini_ (Unknown, 0 bytes, Stack size 0 bytes, UNDEFINED)

[Called By]

- >> __rt_lib_shutdown_fini
