liyuxuan3003/PrismGC/Test/lmj/M0_Experiments/Experiments/Task9/keil/BuzzerNLCD.htm

# Static Call Graph for image .\BuzzerNLCD.axf

#<CALLGRAPH># ARM Linker, 5060960: Last Updated: Sun Apr 03 21:48:30 2022

### Maximum Stack Usage = 156 bytes + Unknown(Functions without stacksize, Untraceable Function Pointers)

### Call chain for Maximum Stack Depth:

__rt_entry_main ⇒ main ⇒ PlayCol ⇒ drawCol ⇒ LCD_Fill ⇒ LCD_SetCursor ⇒ LCD_WR_REG

### Functions with no stack information

- __user_initial_stackheap

### Function Pointers

- BeatFin_Handler from startup_cmsdk_cm0.o(.text) referenced from startup_cmsdk_cm0.o(RESET)
- KEY_Handler from startup_cmsdk_cm0.o(.text) referenced from startup_cmsdk_cm0.o(RESET)
- LCDINI_Handler from startup_cmsdk_cm0.o(.text) referenced from startup_cmsdk_cm0.o(RESET)
- Reset_Handler from startup_cmsdk_cm0.o(.text) referenced from startup_cmsdk_cm0.o(RESET)
- SysTick_Handler from startup_cmsdk_cm0.o(.text) referenced from startup_cmsdk_cm0.o(RESET)
- __main from __main.o(!!!main) referenced from startup_cmsdk_cm0.o(.text)

### Global Symbols

__main (Thumb, 8 bytes, Stack size 0 bytes, __main.o(!!!main))

[Calls]

- >> __scatterload
- >> __rt_entry

__scatterload (Thumb, 0 bytes, Stack size unknown bytes, __scatter.o(!!!scatter))

[Called By]

- >> __main

__scatterload_rt2 (Thumb, 52 bytes, Stack size unknown bytes, __scatter.o(!!!scatter), UNUSED)

[Calls]

- >> __rt_entry

__scatterload_rt2_thumb_only (Thumb, 0 bytes, Stack size unknown bytes, __scatter.o(!!!scatter), UNUSED)

__scatterload_null (Thumb, 0 bytes, Stack size unknown bytes, __scatter.o(!!!scatter), UNUSED)

__scatterload_zeroinit (Thumb, 28 bytes, Stack size unknown bytes, __scatter_zi.o(!!handler_zi), UNUSED)

__rt_lib_init (Thumb, 0 bytes, Stack size unknown bytes, libinit.o(.ARM.Collect$$libinit$$00000000))

[Called By]

- >> __rt_entry_li

__rt_lib_init_alloca_1 (Thumb, 0 bytes, Stack size unknown bytes, libinit2.o(.ARM.Collect$$libinit$$0000002E))

__rt_lib_init_argv_1 (Thumb, 0 bytes, Stack size unknown bytes, libinit2.o(.ARM.Collect$$libinit$$0000002C))

__rt_lib_init_atexit_1 (Thumb, 0 bytes, Stack size unknown bytes, libinit2.o(.ARM.Collect$$libinit$$0000001B))

__rt_lib_init_clock_1 (Thumb, 0 bytes, Stack size unknown bytes, libinit2.o(.ARM.Collect$$libinit$$00000021))

__rt_lib_init_cpp_1 (Thumb, 0 bytes, Stack size unknown bytes, libinit2.o(.ARM.Collect$$libinit$$00000032))

__rt_lib_init_exceptions_1 (Thumb, 0 bytes, Stack size unknown bytes, libinit2.o(.ARM.Collect$$libinit$$00000030))

__rt_lib_init_fp_1 (Thumb, 0 bytes, Stack size unknown bytes, libinit2.o(.ARM.Collect$$libinit$$00000002))

__rt_lib_init_fp_trap_1 (Thumb, 0 bytes, Stack size unknown bytes, libinit2.o(.ARM.Collect$$libinit$$0000001F))

__rt_lib_init_getenv_1 (Thumb, 0 bytes, Stack size unknown bytes, libinit2.o(.ARM.Collect$$libinit$$00000023))

__rt_lib_init_heap_1 (Thumb, 0 bytes, Stack size unknown bytes, libinit2.o(.ARM.Collect$$libinit$$0000000A))

__rt_lib_init_lc_collate_1 (Thumb, 0 bytes, Stack size unknown bytes, libinit2.o(.ARM.Collect$$libinit$$00000011))

__rt_lib_init_lc_ctype_1 (Thumb, 0 bytes, Stack size unknown bytes, libinit2.o(.ARM.Collect$$libinit$$00000013))

__rt_lib_init_lc_monetary_1 (Thumb, 0 bytes, Stack size unknown bytes, libinit2.o(.ARM.Collect$$libinit$$00000015))

__rt_lib_init_lc_numeric_1 (Thumb, 0 bytes, Stack size unknown bytes, libinit2.o(.ARM.Collect$$libinit$$00000017))

__rt_lib_init_lc_time_1 (Thumb, 0 bytes, Stack size unknown bytes, libinit2.o(.ARM.Collect$$libinit$$00000019))

__rt_lib_init_preinit_1 (Thumb, 0 bytes, Stack size unknown bytes, libinit2.o(.ARM.Collect$$libinit$$00000004))

__rt_lib_init_rand_1 (Thumb, 0 bytes, Stack size unknown bytes, libinit2.o(.ARM.Collect$$libinit$$0000000E))

__rt_lib_init_return (Thumb, 0 bytes, Stack size unknown bytes, libinit2.o(.ARM.Collect$$libinit$$00000033))

__rt_lib_init_signal_1 (Thumb, 0 bytes, Stack size unknown bytes, libinit2.o(.ARM.Collect$$libinit$$0000001D))

__rt_lib_init_stdio_1 (Thumb, 0 bytes, Stack size unknown bytes, libinit2.o(.ARM.Collect$$libinit$$00000025))

__rt_lib_init_user_alloc_1 (Thumb, 0 bytes, Stack size unknown bytes, libinit2.o(.ARM.Collect$$libinit$$0000000C))

__rt_lib_shutdown (Thumb, 0 bytes, Stack size unknown bytes, libshutdown.o(.ARM.Collect$$libshutdown$$00000000))

[Called By]

- >> __rt_exit_ls

__rt_lib_shutdown_cpp_1 (Thumb, 0 bytes, Stack size unknown bytes, libshutdown2.o(.ARM.Collect$$libshutdown$$00000004))

__rt_lib_shutdown_fini_1 (Thumb, 0 bytes, Stack size unknown bytes, libshutdown2.o(.ARM.Collect$$libshutdown$$00000002))

__rt_lib_shutdown_fp_trap_1 (Thumb, 0 bytes, Stack size unknown bytes, libshutdown2.o(.ARM.Collect$$libshutdown$$00000009))

__rt_lib_shutdown_heap_1 (Thumb, 0 bytes, Stack size unknown bytes, libshutdown2.o(.ARM.Collect$$libshutdown$$00000011))

__rt_lib_shutdown_return (Thumb, 0 bytes, Stack size unknown bytes, libshutdown2.o(.ARM.Collect$$libshutdown$$00000012))

__rt_lib_shutdown_signal_1 (Thumb, 0 bytes, Stack size unknown bytes, libshutdown2.o(.ARM.Collect$$libshutdown$$0000000C))

__rt_lib_shutdown_stdio_1 (Thumb, 0 bytes, Stack size unknown bytes, libshutdown2.o(.ARM.Collect$$libshutdown$$00000006))

__rt_lib_shutdown_user_alloc_1 (Thumb, 0 bytes, Stack size unknown bytes, libshutdown2.o(.ARM.Collect$$libshutdown$$0000000E))

__rt_entry (Thumb, 0 bytes, Stack size unknown bytes, __rtentry.o(.ARM.Collect$$rtentry$$00000000))

[Called By]

- >> __scatterload_rt2
- >> __main

__rt_entry_presh_1 (Thumb, 0 bytes, Stack size unknown bytes, __rtentry2.o(.ARM.Collect$$rtentry$$00000002))

__rt_entry_sh (Thumb, 0 bytes, Stack size unknown bytes, __rtentry4.o(.ARM.Collect$$rtentry$$00000004))

[Stack]

- Max Depth = 8 + Unknown Stack Size
- Call Chain = __rt_entry_sh ⇒ __user_setup_stackheap

[Calls]

- >> __user_setup_stackheap

__rt_entry_li (Thumb, 0 bytes, Stack size unknown bytes, __rtentry2.o(.ARM.Collect$$rtentry$$0000000A))

[Calls]

- >> __rt_lib_init

__rt_entry_postsh_1 (Thumb, 0 bytes, Stack size unknown bytes, __rtentry2.o(.ARM.Collect$$rtentry$$00000009))

__rt_entry_main (Thumb, 0 bytes, Stack size unknown bytes, __rtentry2.o(.ARM.Collect$$rtentry$$0000000D))

[Stack]

- Max Depth = 156 + Unknown Stack Size
- Call Chain = __rt_entry_main ⇒ main ⇒ PlayCol ⇒ drawCol ⇒ LCD_Fill ⇒ LCD_SetCursor ⇒ LCD_WR_REG

[Calls]

- >> exit
- >> main

__rt_entry_postli_1 (Thumb, 0 bytes, Stack size unknown bytes, __rtentry2.o(.ARM.Collect$$rtentry$$0000000C))

__rt_exit (Thumb, 0 bytes, Stack size unknown bytes, rtexit.o(.ARM.Collect$$rtexit$$00000000))

[Called By]

- >> exit

__rt_exit_ls (Thumb, 0 bytes, Stack size unknown bytes, rtexit2.o(.ARM.Collect$$rtexit$$00000003))

[Calls]

- >> __rt_lib_shutdown

__rt_exit_prels_1 (Thumb, 0 bytes, Stack size unknown bytes, rtexit2.o(.ARM.Collect$$rtexit$$00000002))

__rt_exit_exit (Thumb, 0 bytes, Stack size unknown bytes, rtexit2.o(.ARM.Collect$$rtexit$$00000004))

[Calls]

- >> _sys_exit

Reset_Handler (Thumb, 8 bytes, Stack size 0 bytes, startup_cmsdk_cm0.o(.text))

SysTick_Handler (Thumb, 8 bytes, Stack size 0 bytes, startup_cmsdk_cm0.o(.text))

[Stack]

- Max Depth = 4
- Call Chain = SysTick_Handler ⇒ SysTickHandler

[Calls]

- >> SysTickHandler

[Address Reference Count : 1]

- startup_cmsdk_cm0.o(RESET)

KEY_Handler (Thumb, 8 bytes, Stack size 0 bytes, startup_cmsdk_cm0.o(.text))

[Stack]

- Max Depth = 8
- Call Chain = KEY_Handler ⇒ KEY

[Calls]

- >> KEY

[Address Reference Count : 1]

- startup_cmsdk_cm0.o(RESET)

LCDINI_Handler (Thumb, 8 bytes, Stack size 0 bytes, startup_cmsdk_cm0.o(.text))

[Calls]

- >> LCD_INI_FINISH

[Address Reference Count : 1]

- startup_cmsdk_cm0.o(RESET)

BeatFin_Handler (Thumb, 8 bytes, Stack size 0 bytes, startup_cmsdk_cm0.o(.text))

[Calls]

- >> BEAT

[Address Reference Count : 1]

- startup_cmsdk_cm0.o(RESET)

__user_initial_stackheap (Thumb, 0 bytes, Stack size unknown bytes, startup_cmsdk_cm0.o(.text))

[Called By]

- >> __user_setup_stackheap

_memset_w (Thumb, 26 bytes, Stack size 0 bytes, rt_memclr.o(.text), UNUSED)

[Called By]

- >> __rt_memclr_w
- >> _memset

_memset (Thumb, 30 bytes, Stack size 0 bytes, rt_memclr.o(.text), UNUSED)

[Calls]

- >> _memset_w

[Called By]

- >> __aeabi_memclr

__aeabi_memclr (Thumb, 4 bytes, Stack size 0 bytes, rt_memclr.o(.text), UNUSED)

[Calls]

- >> _memset

__rt_memclr (Thumb, 0 bytes, Stack size 0 bytes, rt_memclr.o(.text), UNUSED)

__aeabi_memclr4 (Thumb, 0 bytes, Stack size 0 bytes, rt_memclr.o(.text))

[Called By]

- >> PlayCol

__aeabi_memclr8 (Thumb, 0 bytes, Stack size 0 bytes, rt_memclr.o(.text), UNUSED)

__rt_memclr_w (Thumb, 4 bytes, Stack size 0 bytes, rt_memclr.o(.text), UNUSED)

[Calls]

- >> _memset_w

__aeabi_uidiv (Thumb, 0 bytes, Stack size 0 bytes, aeabi_sdiv.o(.text), UNUSED)

__aeabi_uidivmod (Thumb, 20 bytes, Stack size 0 bytes, aeabi_sdiv.o(.text))

[Called By]

- >> drawCol

__aeabi_idiv (Thumb, 0 bytes, Stack size 8 bytes, aeabi_sdiv.o(.text), UNUSED)

__aeabi_idivmod (Thumb, 326 bytes, Stack size 8 bytes, aeabi_sdiv.o(.text), UNUSED)

__use_two_region_memory (Thumb, 2 bytes, Stack size 0 bytes, heapauxi.o(.text), UNUSED)

__rt_heap_escrow$2region (Thumb, 2 bytes, Stack size 0 bytes, heapauxi.o(.text), UNUSED)

__rt_heap_expand$2region (Thumb, 2 bytes, Stack size 0 bytes, heapauxi.o(.text), UNUSED)

__user_setup_stackheap (Thumb, 62 bytes, Stack size 8 bytes, sys_stackheap_outer.o(.text))

[Stack]

- Max Depth = 8 + Unknown Stack Size
- Call Chain = __user_setup_stackheap

[Calls]

- >> __user_perproc_libspace
- >> __user_initial_stackheap

[Called By]

- >> __rt_entry_sh

exit (Thumb, 16 bytes, Stack size 8 bytes, exit.o(.text))

[Stack]

- Max Depth = 8 + Unknown Stack Size
- Call Chain = exit

[Calls]

- >> __rt_exit
- >> _call_atexit_fns (Weak Reference)

[Called By]

- >> __rt_entry_main

__user_libspace (Thumb, 8 bytes, Stack size 0 bytes, libspace.o(.text), UNUSED)

__user_perproc_libspace (Thumb, 0 bytes, Stack size 0 bytes, libspace.o(.text))

[Called By]

- >> __user_setup_stackheap

__user_perthread_libspace (Thumb, 0 bytes, Stack size 0 bytes, libspace.o(.text), UNUSED)

_sys_exit (Thumb, 8 bytes, Stack size 0 bytes, sys_exit.o(.text))

[Called By]

- >> __rt_exit_exit

__I$use$semihosting (Thumb, 0 bytes, Stack size 0 bytes, use_no_semi.o(.text), UNUSED)

__use_no_semihosting_swi (Thumb, 2 bytes, Stack size 0 bytes, use_no_semi.o(.text), UNUSED)

__decompress (Thumb, 0 bytes, Stack size unknown bytes, __dclz77c.o(.text), UNUSED)

__decompress2 (Thumb, 96 bytes, Stack size unknown bytes, __dclz77c.o(.text), UNUSED)

__semihosting_library_function (Thumb, 0 bytes, Stack size unknown bytes, indicate_semi.o(.text), UNUSED)

BEAT (Thumb, 20 bytes, Stack size 0 bytes, main.o(i.BEAT))

[Called By]

- >> BeatFin_Handler

KEY (Thumb, 126 bytes, Stack size 8 bytes, main.o(i.KEY))

[Stack]

- Max Depth = 8
- Call Chain = KEY

[Calls]

- >> StopBGM
- >> StartBGM
- >> ResetBGM
- >> PlayBGM

[Called By]

- >> KEY_Handler

LCD_Fill (Thumb, 80 bytes, Stack size 44 bytes, lcd.o(i.LCD_Fill))

[Stack]

- Max Depth = 60
- Call Chain = LCD_Fill ⇒ LCD_SetCursor ⇒ LCD_WR_REG

[Calls]

- >> LCD_WriteRAM_Prepare
- >> LCD_WR_DATA
- >> LCD_SetCursor

[Called By]

- >> drawCol

LCD_INI_FINISH (Thumb, 8 bytes, Stack size 0 bytes, code_def.o(i.LCD_INI_FINISH))

[Called By]

- >> LCDINI_Handler

LCD_Init (Thumb, 12 bytes, Stack size 0 bytes, lcd.o(i.LCD_Init))

[Called By]

- >> main

LCD_SetCursor (Thumb, 44 bytes, Stack size 12 bytes, lcd.o(i.LCD_SetCursor))

[Stack]

- Max Depth = 16
- Call Chain = LCD_SetCursor ⇒ LCD_WR_REG

[Calls]

- >> LCD_WR_REG
- >> LCD_WR_DATA

[Called By]

- >> LCD_Fill

LCD_WR_DATA (Thumb, 34 bytes, Stack size 4 bytes, lcd.o(i.LCD_WR_DATA))

[Stack]

- Max Depth = 4
- Call Chain = LCD_WR_DATA

[Calls]

- >> MakeData

[Called By]

- >> LCD_SetCursor
- >> LCD_Fill

LCD_WR_REG (Thumb, 32 bytes, Stack size 4 bytes, lcd.o(i.LCD_WR_REG))

[Stack]

- Max Depth = 4
- Call Chain = LCD_WR_REG

[Calls]

- >> MakeData

[Called By]

- >> LCD_WriteRAM_Prepare
- >> LCD_SetCursor

LCD_WriteRAM_Prepare (Thumb, 10 bytes, Stack size 4 bytes, lcd.o(i.LCD_WriteRAM_Prepare))

[Stack]

- Max Depth = 8
- Call Chain = LCD_WriteRAM_Prepare ⇒ LCD_WR_REG

[Calls]

- >> LCD_WR_REG

[Called By]

- >> LCD_Fill

MakeData (Thumb, 130 bytes, Stack size 0 bytes, lcd.o(i.MakeData))

[Called By]

- >> LCD_WR_REG
- >> LCD_WR_DATA

PlayBGM (Thumb, 28 bytes, Stack size 0 bytes, code_def.o(i.PlayBGM))

[Called By]

- >> KEY

PlayCol (Thumb, 148 bytes, Stack size 64 bytes, main.o(i.PlayCol))

[Stack]

- Max Depth = 156
- Call Chain = PlayCol ⇒ drawCol ⇒ LCD_Fill ⇒ LCD_SetCursor ⇒ LCD_WR_REG

[Calls]

- >> __aeabi_memclr4
- >> drawCol

[Called By]

- >> main

ResetBGM (Thumb, 16 bytes, Stack size 0 bytes, code_def.o(i.ResetBGM))

[Called By]

- >> KEY

SYSInit (Thumb, 16 bytes, Stack size 8 bytes, code_def.o(i.SYSInit))

[Stack]

- Max Depth = 8
- Call Chain = SYSInit

[Calls]

- >> Set_SysTick_CTRL

[Called By]

- >> main

Set_SysTick_CTRL (Thumb, 6 bytes, Stack size 0 bytes, systick.o(i.Set_SysTick_CTRL))

[Called By]

- >> SysTickHandler
- >> SYSInit

StartBGM (Thumb, 18 bytes, Stack size 0 bytes, code_def.o(i.StartBGM))

[Called By]

- >> KEY

StopBGM (Thumb, 16 bytes, Stack size 0 bytes, code_def.o(i.StopBGM))

[Called By]

- >> KEY

SysTickHandler (Thumb, 24 bytes, Stack size 4 bytes, systick.o(i.SysTickHandler))

[Stack]

- Max Depth = 4
- Call Chain = SysTickHandler

[Calls]

- >> Set_SysTick_CTRL

[Called By]

- >> SysTick_Handler

drawCol (Thumb, 134 bytes, Stack size 32 bytes, main.o(i.drawCol))

[Stack]

- Max Depth = 92
- Call Chain = drawCol ⇒ LCD_Fill ⇒ LCD_SetCursor ⇒ LCD_WR_REG

[Calls]

- >> __aeabi_uidivmod
- >> LCD_Fill

[Called By]

- >> PlayCol

main (Thumb, 80 bytes, Stack size 0 bytes, main.o(i.main))

[Stack]

- Max Depth = 156
- Call Chain = main ⇒ PlayCol ⇒ drawCol ⇒ LCD_Fill ⇒ LCD_SetCursor ⇒ LCD_WR_REG

[Calls]

- >> PlayCol
- >> LCD_Init
- >> SYSInit

[Called By]

- >> __rt_entry_main

### Local Symbols

### Undefined Global Symbols

_call_atexit_fns (ARM, 0 bytes, Stack size 0 bytes, UNDEFINED)

[Called By]

- >> exit
