liyuxuan3003/PrismGC/Test/zy/Keil/ProjectFolderTemplate/Output/atk_f103.htm

# Static Call Graph for image ..\..\Output\atk_f103.axf

#<CALLGRAPH># ARM Linker, 5060960: Last Updated: Sat Mar 18 14:53:30 2023

### Maximum Stack Usage = 128 bytes + Unknown(Functions without stacksize, Cycles, Untraceable Function Pointers)

### Call chain for Maximum Stack Depth:

__rt_entry_main ⇒ main ⇒ __2printf ⇒ _printf_char_file ⇒ _printf_char_common ⇒ __printf

### Functions with no stack information

- __user_initial_stackheap

### Mutually Recursive functions

- NMI_Handler ⇒ NMI_Handler
- HardFault_Handler ⇒ HardFault_Handler
- MemManage_Handler ⇒ MemManage_Handler
- BusFault_Handler ⇒ BusFault_Handler
- UsageFault_Handler ⇒ UsageFault_Handler
- SVC_Handler ⇒ SVC_Handler
- DebugMon_Handler ⇒ DebugMon_Handler
- PendSV_Handler ⇒ PendSV_Handler
- SysTick_Handler ⇒ SysTick_Handler
- ADC1_2_IRQHandler ⇒ ADC1_2_IRQHandler

### Function Pointers

- ADC1_2_IRQHandler from startup_stm32f103xe.o(.text) referenced from startup_stm32f103xe.o(RESET)
- ADC3_IRQHandler from startup_stm32f103xe.o(.text) referenced from startup_stm32f103xe.o(RESET)
- BusFault_Handler from startup_stm32f103xe.o(.text) referenced from startup_stm32f103xe.o(RESET)
- CAN1_RX1_IRQHandler from startup_stm32f103xe.o(.text) referenced from startup_stm32f103xe.o(RESET)
- CAN1_SCE_IRQHandler from startup_stm32f103xe.o(.text) referenced from startup_stm32f103xe.o(RESET)
- DMA1_Channel1_IRQHandler from startup_stm32f103xe.o(.text) referenced from startup_stm32f103xe.o(RESET)
- DMA1_Channel2_IRQHandler from startup_stm32f103xe.o(.text) referenced from startup_stm32f103xe.o(RESET)
- DMA1_Channel3_IRQHandler from startup_stm32f103xe.o(.text) referenced from startup_stm32f103xe.o(RESET)
- DMA1_Channel4_IRQHandler from startup_stm32f103xe.o(.text) referenced from startup_stm32f103xe.o(RESET)
- DMA1_Channel5_IRQHandler from startup_stm32f103xe.o(.text) referenced from startup_stm32f103xe.o(RESET)
- DMA1_Channel6_IRQHandler from startup_stm32f103xe.o(.text) referenced from startup_stm32f103xe.o(RESET)
- DMA1_Channel7_IRQHandler from startup_stm32f103xe.o(.text) referenced from startup_stm32f103xe.o(RESET)
- DMA2_Channel1_IRQHandler from startup_stm32f103xe.o(.text) referenced from startup_stm32f103xe.o(RESET)
- DMA2_Channel2_IRQHandler from startup_stm32f103xe.o(.text) referenced from startup_stm32f103xe.o(RESET)
- DMA2_Channel3_IRQHandler from startup_stm32f103xe.o(.text) referenced from startup_stm32f103xe.o(RESET)
- DMA2_Channel4_5_IRQHandler from startup_stm32f103xe.o(.text) referenced from startup_stm32f103xe.o(RESET)
- DebugMon_Handler from startup_stm32f103xe.o(.text) referenced from startup_stm32f103xe.o(RESET)
- EXTI0_IRQHandler from startup_stm32f103xe.o(.text) referenced from startup_stm32f103xe.o(RESET)
- EXTI15_10_IRQHandler from startup_stm32f103xe.o(.text) referenced from startup_stm32f103xe.o(RESET)
- EXTI1_IRQHandler from startup_stm32f103xe.o(.text) referenced from startup_stm32f103xe.o(RESET)
- EXTI2_IRQHandler from startup_stm32f103xe.o(.text) referenced from startup_stm32f103xe.o(RESET)
- EXTI3_IRQHandler from startup_stm32f103xe.o(.text) referenced from startup_stm32f103xe.o(RESET)
- EXTI4_IRQHandler from startup_stm32f103xe.o(.text) referenced from startup_stm32f103xe.o(RESET)
- EXTI9_5_IRQHandler from startup_stm32f103xe.o(.text) referenced from startup_stm32f103xe.o(RESET)
- FLASH_IRQHandler from startup_stm32f103xe.o(.text) referenced from startup_stm32f103xe.o(RESET)
- FSMC_IRQHandler from startup_stm32f103xe.o(.text) referenced from startup_stm32f103xe.o(RESET)
- HardFault_Handler from startup_stm32f103xe.o(.text) referenced from startup_stm32f103xe.o(RESET)
- I2C1_ER_IRQHandler from startup_stm32f103xe.o(.text) referenced from startup_stm32f103xe.o(RESET)
- I2C1_EV_IRQHandler from startup_stm32f103xe.o(.text) referenced from startup_stm32f103xe.o(RESET)
- I2C2_ER_IRQHandler from startup_stm32f103xe.o(.text) referenced from startup_stm32f103xe.o(RESET)
- I2C2_EV_IRQHandler from startup_stm32f103xe.o(.text) referenced from startup_stm32f103xe.o(RESET)
- MemManage_Handler from startup_stm32f103xe.o(.text) referenced from startup_stm32f103xe.o(RESET)
- NMI_Handler from startup_stm32f103xe.o(.text) referenced from startup_stm32f103xe.o(RESET)
- PVD_IRQHandler from startup_stm32f103xe.o(.text) referenced from startup_stm32f103xe.o(RESET)
- PendSV_Handler from startup_stm32f103xe.o(.text) referenced from startup_stm32f103xe.o(RESET)
- RCC_IRQHandler from startup_stm32f103xe.o(.text) referenced from startup_stm32f103xe.o(RESET)
- RTC_Alarm_IRQHandler from startup_stm32f103xe.o(.text) referenced from startup_stm32f103xe.o(RESET)
- RTC_IRQHandler from startup_stm32f103xe.o(.text) referenced from startup_stm32f103xe.o(RESET)
- Reset_Handler from startup_stm32f103xe.o(.text) referenced from startup_stm32f103xe.o(RESET)
- SDIO_IRQHandler from startup_stm32f103xe.o(.text) referenced from startup_stm32f103xe.o(RESET)
- SPI1_IRQHandler from startup_stm32f103xe.o(.text) referenced from startup_stm32f103xe.o(RESET)
- SPI2_IRQHandler from startup_stm32f103xe.o(.text) referenced from startup_stm32f103xe.o(RESET)
- SPI3_IRQHandler from startup_stm32f103xe.o(.text) referenced from startup_stm32f103xe.o(RESET)
- SVC_Handler from startup_stm32f103xe.o(.text) referenced from startup_stm32f103xe.o(RESET)
- SysTick_Handler from startup_stm32f103xe.o(.text) referenced from startup_stm32f103xe.o(RESET)
- TAMPER_IRQHandler from startup_stm32f103xe.o(.text) referenced from startup_stm32f103xe.o(RESET)
- TIM1_BRK_IRQHandler from startup_stm32f103xe.o(.text) referenced from startup_stm32f103xe.o(RESET)
- TIM1_CC_IRQHandler from startup_stm32f103xe.o(.text) referenced from startup_stm32f103xe.o(RESET)
- TIM1_TRG_COM_IRQHandler from startup_stm32f103xe.o(.text) referenced from startup_stm32f103xe.o(RESET)
- TIM1_UP_IRQHandler from startup_stm32f103xe.o(.text) referenced from startup_stm32f103xe.o(RESET)
- TIM2_IRQHandler from startup_stm32f103xe.o(.text) referenced from startup_stm32f103xe.o(RESET)
- TIM3_IRQHandler from startup_stm32f103xe.o(.text) referenced from startup_stm32f103xe.o(RESET)
- TIM4_IRQHandler from startup_stm32f103xe.o(.text) referenced from startup_stm32f103xe.o(RESET)
- TIM5_IRQHandler from startup_stm32f103xe.o(.text) referenced from startup_stm32f103xe.o(RESET)
- TIM6_IRQHandler from startup_stm32f103xe.o(.text) referenced from startup_stm32f103xe.o(RESET)
- TIM7_IRQHandler from startup_stm32f103xe.o(.text) referenced from startup_stm32f103xe.o(RESET)
- TIM8_BRK_IRQHandler from startup_stm32f103xe.o(.text) referenced from startup_stm32f103xe.o(RESET)
- TIM8_CC_IRQHandler from startup_stm32f103xe.o(.text) referenced from startup_stm32f103xe.o(RESET)
- TIM8_TRG_COM_IRQHandler from startup_stm32f103xe.o(.text) referenced from startup_stm32f103xe.o(RESET)
- TIM8_UP_IRQHandler from startup_stm32f103xe.o(.text) referenced from startup_stm32f103xe.o(RESET)
- UART4_IRQHandler from startup_stm32f103xe.o(.text) referenced from startup_stm32f103xe.o(RESET)
- UART5_IRQHandler from startup_stm32f103xe.o(.text) referenced from startup_stm32f103xe.o(RESET)
- USART1_IRQHandler from usart.o(i.USART1_IRQHandler) referenced from startup_stm32f103xe.o(RESET)
- USART2_IRQHandler from startup_stm32f103xe.o(.text) referenced from startup_stm32f103xe.o(RESET)
- USART3_IRQHandler from startup_stm32f103xe.o(.text) referenced from startup_stm32f103xe.o(RESET)
- USBWakeUp_IRQHandler from startup_stm32f103xe.o(.text) referenced from startup_stm32f103xe.o(RESET)
- USB_HP_CAN1_TX_IRQHandler from startup_stm32f103xe.o(.text) referenced from startup_stm32f103xe.o(RESET)
- USB_LP_CAN1_RX0_IRQHandler from startup_stm32f103xe.o(.text) referenced from startup_stm32f103xe.o(RESET)
- UsageFault_Handler from startup_stm32f103xe.o(.text) referenced from startup_stm32f103xe.o(RESET)
- WWDG_IRQHandler from startup_stm32f103xe.o(.text) referenced from startup_stm32f103xe.o(RESET)
- __main from __main.o(!!!main) referenced from startup_stm32f103xe.o(.text)
- _printf_input_char from _printf_char_common.o(.text) referenced from _printf_char_common.o(.text)
- fputc from usart.o(i.fputc) referenced from _printf_char_file.o(.text)

### Global Symbols

__main (Thumb, 8 bytes, Stack size 0 bytes, __main.o(!!!main))

[Calls]

- >> __rt_entry
- >> __scatterload

__scatterload (Thumb, 0 bytes, Stack size unknown bytes, __scatter.o(!!!scatter))

[Called By]

- >> __main

__scatterload_rt2 (Thumb, 44 bytes, Stack size unknown bytes, __scatter.o(!!!scatter), UNUSED)

[Calls]

- >> __rt_entry

__scatterload_rt2_thumb_only (Thumb, 0 bytes, Stack size unknown bytes, __scatter.o(!!!scatter), UNUSED)

__scatterload_null (Thumb, 0 bytes, Stack size unknown bytes, __scatter.o(!!!scatter), UNUSED)

__scatterload_copy (Thumb, 26 bytes, Stack size unknown bytes, __scatter_copy.o(!!handler_copy), UNUSED)

[Calls]

- >> __scatterload_copy

[Called By]

- >> __scatterload_copy

__scatterload_zeroinit (Thumb, 28 bytes, Stack size unknown bytes, __scatter_zi.o(!!handler_zi), UNUSED)

_printf_d (Thumb, 0 bytes, Stack size unknown bytes, _printf_d.o(.ARM.Collect$$_printf_percent$$00000009))

[Stack]

- Max Depth = 56 + Unknown Stack Size
- Call Chain = _printf_d ⇒ _printf_int_dec ⇒ _printf_int_common

[Calls]

- >> _printf_int_dec

_printf_percent (Thumb, 0 bytes, Stack size unknown bytes, _printf_percent.o(.ARM.Collect$$_printf_percent$$00000000))

[Called By]

- >> __printf

_printf_percent_end (Thumb, 0 bytes, Stack size unknown bytes, _printf_percent_end.o(.ARM.Collect$$_printf_percent$$00000017))

__rt_lib_init (Thumb, 0 bytes, Stack size unknown bytes, libinit.o(.ARM.Collect$$libinit$$00000000))

[Called By]

- >> __rt_entry_li

__rt_lib_init_alloca_1 (Thumb, 0 bytes, Stack size unknown bytes, libinit2.o(.ARM.Collect$$libinit$$0000002E))

__rt_lib_init_argv_1 (Thumb, 0 bytes, Stack size unknown bytes, libinit2.o(.ARM.Collect$$libinit$$0000002C))

__rt_lib_init_atexit_1 (Thumb, 0 bytes, Stack size unknown bytes, libinit2.o(.ARM.Collect$$libinit$$0000001B))

__rt_lib_init_clock_1 (Thumb, 0 bytes, Stack size unknown bytes, libinit2.o(.ARM.Collect$$libinit$$00000021))

__rt_lib_init_cpp_1 (Thumb, 0 bytes, Stack size unknown bytes, libinit2.o(.ARM.Collect$$libinit$$00000032))

__rt_lib_init_exceptions_1 (Thumb, 0 bytes, Stack size unknown bytes, libinit2.o(.ARM.Collect$$libinit$$00000030))

__rt_lib_init_fp_1 (Thumb, 0 bytes, Stack size unknown bytes, libinit2.o(.ARM.Collect$$libinit$$00000002))

__rt_lib_init_fp_trap_1 (Thumb, 0 bytes, Stack size unknown bytes, libinit2.o(.ARM.Collect$$libinit$$0000001F))

__rt_lib_init_getenv_1 (Thumb, 0 bytes, Stack size unknown bytes, libinit2.o(.ARM.Collect$$libinit$$00000023))

__rt_lib_init_heap_1 (Thumb, 0 bytes, Stack size unknown bytes, libinit2.o(.ARM.Collect$$libinit$$0000000A))

__rt_lib_init_lc_collate_1 (Thumb, 0 bytes, Stack size unknown bytes, libinit2.o(.ARM.Collect$$libinit$$00000011))

__rt_lib_init_lc_ctype_1 (Thumb, 0 bytes, Stack size unknown bytes, libinit2.o(.ARM.Collect$$libinit$$00000013))

__rt_lib_init_lc_monetary_1 (Thumb, 0 bytes, Stack size unknown bytes, libinit2.o(.ARM.Collect$$libinit$$00000015))

__rt_lib_init_lc_numeric_1 (Thumb, 0 bytes, Stack size unknown bytes, libinit2.o(.ARM.Collect$$libinit$$00000017))

__rt_lib_init_lc_time_1 (Thumb, 0 bytes, Stack size unknown bytes, libinit2.o(.ARM.Collect$$libinit$$00000019))

__rt_lib_init_preinit_1 (Thumb, 0 bytes, Stack size unknown bytes, libinit2.o(.ARM.Collect$$libinit$$00000004))

__rt_lib_init_rand_1 (Thumb, 0 bytes, Stack size unknown bytes, libinit2.o(.ARM.Collect$$libinit$$0000000E))

__rt_lib_init_return (Thumb, 0 bytes, Stack size unknown bytes, libinit2.o(.ARM.Collect$$libinit$$00000033))

__rt_lib_init_signal_1 (Thumb, 0 bytes, Stack size unknown bytes, libinit2.o(.ARM.Collect$$libinit$$0000001D))

__rt_lib_init_stdio_1 (Thumb, 0 bytes, Stack size unknown bytes, libinit2.o(.ARM.Collect$$libinit$$00000025))

__rt_lib_init_user_alloc_1 (Thumb, 0 bytes, Stack size unknown bytes, libinit2.o(.ARM.Collect$$libinit$$0000000C))

__rt_lib_shutdown (Thumb, 0 bytes, Stack size unknown bytes, libshutdown.o(.ARM.Collect$$libshutdown$$00000000))

[Called By]

- >> __rt_exit_ls

__rt_lib_shutdown_cpp_1 (Thumb, 0 bytes, Stack size unknown bytes, libshutdown2.o(.ARM.Collect$$libshutdown$$00000004))

__rt_lib_shutdown_fini_1 (Thumb, 0 bytes, Stack size unknown bytes, libshutdown2.o(.ARM.Collect$$libshutdown$$00000002))

__rt_lib_shutdown_fp_trap_1 (Thumb, 0 bytes, Stack size unknown bytes, libshutdown2.o(.ARM.Collect$$libshutdown$$00000009))

__rt_lib_shutdown_heap_1 (Thumb, 0 bytes, Stack size unknown bytes, libshutdown2.o(.ARM.Collect$$libshutdown$$00000011))

__rt_lib_shutdown_return (Thumb, 0 bytes, Stack size unknown bytes, libshutdown2.o(.ARM.Collect$$libshutdown$$00000012))

__rt_lib_shutdown_signal_1 (Thumb, 0 bytes, Stack size unknown bytes, libshutdown2.o(.ARM.Collect$$libshutdown$$0000000C))

__rt_lib_shutdown_stdio_1 (Thumb, 0 bytes, Stack size unknown bytes, libshutdown2.o(.ARM.Collect$$libshutdown$$00000006))

__rt_lib_shutdown_user_alloc_1 (Thumb, 0 bytes, Stack size unknown bytes, libshutdown2.o(.ARM.Collect$$libshutdown$$0000000E))

__rt_entry (Thumb, 0 bytes, Stack size unknown bytes, __rtentry.o(.ARM.Collect$$rtentry$$00000000))

[Called By]

- >> __main
- >> __scatterload_rt2

__rt_entry_presh_1 (Thumb, 0 bytes, Stack size unknown bytes, __rtentry2.o(.ARM.Collect$$rtentry$$00000002))

__rt_entry_sh (Thumb, 0 bytes, Stack size unknown bytes, __rtentry4.o(.ARM.Collect$$rtentry$$00000004))

[Stack]

- Max Depth = 8 + Unknown Stack Size
- Call Chain = __rt_entry_sh ⇒ __user_setup_stackheap

[Calls]

- >> __user_setup_stackheap

__rt_entry_li (Thumb, 0 bytes, Stack size unknown bytes, __rtentry2.o(.ARM.Collect$$rtentry$$0000000A))

[Calls]

- >> __rt_lib_init

__rt_entry_postsh_1 (Thumb, 0 bytes, Stack size unknown bytes, __rtentry2.o(.ARM.Collect$$rtentry$$00000009))

__rt_entry_main (Thumb, 0 bytes, Stack size unknown bytes, __rtentry2.o(.ARM.Collect$$rtentry$$0000000D))

[Stack]

- Max Depth = 128 + Unknown Stack Size
- Call Chain = __rt_entry_main ⇒ main ⇒ __2printf ⇒ _printf_char_file ⇒ _printf_char_common ⇒ __printf

[Calls]

- >> exit
- >> main

__rt_entry_postli_1 (Thumb, 0 bytes, Stack size unknown bytes, __rtentry2.o(.ARM.Collect$$rtentry$$0000000C))

__rt_exit (Thumb, 0 bytes, Stack size unknown bytes, rtexit.o(.ARM.Collect$$rtexit$$00000000))

[Called By]

- >> exit

__rt_exit_ls (Thumb, 0 bytes, Stack size unknown bytes, rtexit2.o(.ARM.Collect$$rtexit$$00000003))

[Calls]

- >> __rt_lib_shutdown

__rt_exit_prels_1 (Thumb, 0 bytes, Stack size unknown bytes, rtexit2.o(.ARM.Collect$$rtexit$$00000002))

__rt_exit_exit (Thumb, 0 bytes, Stack size unknown bytes, rtexit2.o(.ARM.Collect$$rtexit$$00000004))

[Calls]

- >> _sys_exit

Reset_Handler (Thumb, 4 bytes, Stack size 0 bytes, startup_stm32f103xe.o(.text))
[Address Reference Count : 1]

- startup_stm32f103xe.o(RESET)

NMI_Handler (Thumb, 2 bytes, Stack size 0 bytes, startup_stm32f103xe.o(.text))

[Calls]

- >> NMI_Handler

[Called By]

- >> NMI_Handler

[Address Reference Count : 1]

- startup_stm32f103xe.o(RESET)

HardFault_Handler (Thumb, 2 bytes, Stack size 0 bytes, startup_stm32f103xe.o(.text))

[Calls]

- >> HardFault_Handler

[Called By]

- >> HardFault_Handler

[Address Reference Count : 1]

- startup_stm32f103xe.o(RESET)

MemManage_Handler (Thumb, 2 bytes, Stack size 0 bytes, startup_stm32f103xe.o(.text))

[Calls]

- >> MemManage_Handler

[Called By]

- >> MemManage_Handler

[Address Reference Count : 1]

- startup_stm32f103xe.o(RESET)

BusFault_Handler (Thumb, 2 bytes, Stack size 0 bytes, startup_stm32f103xe.o(.text))

[Calls]

- >> BusFault_Handler

[Called By]

- >> BusFault_Handler

[Address Reference Count : 1]

- startup_stm32f103xe.o(RESET)

UsageFault_Handler (Thumb, 2 bytes, Stack size 0 bytes, startup_stm32f103xe.o(.text))

[Calls]

- >> UsageFault_Handler

[Called By]

- >> UsageFault_Handler

[Address Reference Count : 1]

- startup_stm32f103xe.o(RESET)

SVC_Handler (Thumb, 2 bytes, Stack size 0 bytes, startup_stm32f103xe.o(.text))

[Calls]

- >> SVC_Handler

[Called By]

- >> SVC_Handler

[Address Reference Count : 1]

- startup_stm32f103xe.o(RESET)

DebugMon_Handler (Thumb, 2 bytes, Stack size 0 bytes, startup_stm32f103xe.o(.text))

[Calls]

- >> DebugMon_Handler

[Called By]

- >> DebugMon_Handler

[Address Reference Count : 1]

- startup_stm32f103xe.o(RESET)

PendSV_Handler (Thumb, 2 bytes, Stack size 0 bytes, startup_stm32f103xe.o(.text))

[Calls]

- >> PendSV_Handler

[Called By]

- >> PendSV_Handler

[Address Reference Count : 1]

- startup_stm32f103xe.o(RESET)

SysTick_Handler (Thumb, 2 bytes, Stack size 0 bytes, startup_stm32f103xe.o(.text))

[Calls]

- >> SysTick_Handler

[Called By]

- >> SysTick_Handler

[Address Reference Count : 1]

- startup_stm32f103xe.o(RESET)

ADC1_2_IRQHandler (Thumb, 0 bytes, Stack size 0 bytes, startup_stm32f103xe.o(.text))

[Calls]

- >> ADC1_2_IRQHandler

[Called By]

- >> ADC1_2_IRQHandler

[Address Reference Count : 1]

- startup_stm32f103xe.o(RESET)

ADC3_IRQHandler (Thumb, 0 bytes, Stack size 0 bytes, startup_stm32f103xe.o(.text))
[Address Reference Count : 1]

- startup_stm32f103xe.o(RESET)

CAN1_RX1_IRQHandler (Thumb, 0 bytes, Stack size 0 bytes, startup_stm32f103xe.o(.text))
[Address Reference Count : 1]

- startup_stm32f103xe.o(RESET)

CAN1_SCE_IRQHandler (Thumb, 0 bytes, Stack size 0 bytes, startup_stm32f103xe.o(.text))
[Address Reference Count : 1]

- startup_stm32f103xe.o(RESET)

DMA1_Channel1_IRQHandler (Thumb, 0 bytes, Stack size 0 bytes, startup_stm32f103xe.o(.text))
[Address Reference Count : 1]

- startup_stm32f103xe.o(RESET)

DMA1_Channel2_IRQHandler (Thumb, 0 bytes, Stack size 0 bytes, startup_stm32f103xe.o(.text))
[Address Reference Count : 1]

- startup_stm32f103xe.o(RESET)

DMA1_Channel3_IRQHandler (Thumb, 0 bytes, Stack size 0 bytes, startup_stm32f103xe.o(.text))
[Address Reference Count : 1]

- startup_stm32f103xe.o(RESET)

DMA1_Channel4_IRQHandler (Thumb, 0 bytes, Stack size 0 bytes, startup_stm32f103xe.o(.text))
[Address Reference Count : 1]

- startup_stm32f103xe.o(RESET)

DMA1_Channel5_IRQHandler (Thumb, 0 bytes, Stack size 0 bytes, startup_stm32f103xe.o(.text))
[Address Reference Count : 1]

- startup_stm32f103xe.o(RESET)

DMA1_Channel6_IRQHandler (Thumb, 0 bytes, Stack size 0 bytes, startup_stm32f103xe.o(.text))
[Address Reference Count : 1]

- startup_stm32f103xe.o(RESET)

DMA1_Channel7_IRQHandler (Thumb, 0 bytes, Stack size 0 bytes, startup_stm32f103xe.o(.text))
[Address Reference Count : 1]

- startup_stm32f103xe.o(RESET)

DMA2_Channel1_IRQHandler (Thumb, 0 bytes, Stack size 0 bytes, startup_stm32f103xe.o(.text))
[Address Reference Count : 1]

- startup_stm32f103xe.o(RESET)

DMA2_Channel2_IRQHandler (Thumb, 0 bytes, Stack size 0 bytes, startup_stm32f103xe.o(.text))
[Address Reference Count : 1]

- startup_stm32f103xe.o(RESET)

DMA2_Channel3_IRQHandler (Thumb, 0 bytes, Stack size 0 bytes, startup_stm32f103xe.o(.text))
[Address Reference Count : 1]

- startup_stm32f103xe.o(RESET)

DMA2_Channel4_5_IRQHandler (Thumb, 0 bytes, Stack size 0 bytes, startup_stm32f103xe.o(.text))
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

TIM4_IRQHandler (Thumb, 0 bytes, Stack size 0 bytes, startup_stm32f103xe.o(.text))
[Address Reference Count : 1]

- startup_stm32f103xe.o(RESET)

TIM5_IRQHandler (Thumb, 0 bytes, Stack size 0 bytes, startup_stm32f103xe.o(.text))
[Address Reference Count : 1]

- startup_stm32f103xe.o(RESET)

TIM6_IRQHandler (Thumb, 0 bytes, Stack size 0 bytes, startup_stm32f103xe.o(.text))
[Address Reference Count : 1]

- startup_stm32f103xe.o(RESET)

TIM7_IRQHandler (Thumb, 0 bytes, Stack size 0 bytes, startup_stm32f103xe.o(.text))
[Address Reference Count : 1]

- startup_stm32f103xe.o(RESET)

TIM8_BRK_IRQHandler (Thumb, 0 bytes, Stack size 0 bytes, startup_stm32f103xe.o(.text))
[Address Reference Count : 1]

- startup_stm32f103xe.o(RESET)

TIM8_CC_IRQHandler (Thumb, 0 bytes, Stack size 0 bytes, startup_stm32f103xe.o(.text))
[Address Reference Count : 1]

- startup_stm32f103xe.o(RESET)

TIM8_TRG_COM_IRQHandler (Thumb, 0 bytes, Stack size 0 bytes, startup_stm32f103xe.o(.text))
[Address Reference Count : 1]

- startup_stm32f103xe.o(RESET)

TIM8_UP_IRQHandler (Thumb, 0 bytes, Stack size 0 bytes, startup_stm32f103xe.o(.text))
[Address Reference Count : 1]

- startup_stm32f103xe.o(RESET)

UART4_IRQHandler (Thumb, 0 bytes, Stack size 0 bytes, startup_stm32f103xe.o(.text))
[Address Reference Count : 1]

- startup_stm32f103xe.o(RESET)

UART5_IRQHandler (Thumb, 0 bytes, Stack size 0 bytes, startup_stm32f103xe.o(.text))
[Address Reference Count : 1]

- startup_stm32f103xe.o(RESET)

USART2_IRQHandler (Thumb, 0 bytes, Stack size 0 bytes, startup_stm32f103xe.o(.text))
[Address Reference Count : 1]

- startup_stm32f103xe.o(RESET)

USART3_IRQHandler (Thumb, 0 bytes, Stack size 0 bytes, startup_stm32f103xe.o(.text))
[Address Reference Count : 1]

- startup_stm32f103xe.o(RESET)

USBWakeUp_IRQHandler (Thumb, 0 bytes, Stack size 0 bytes, startup_stm32f103xe.o(.text))
[Address Reference Count : 1]

- startup_stm32f103xe.o(RESET)

USB_HP_CAN1_TX_IRQHandler (Thumb, 0 bytes, Stack size 0 bytes, startup_stm32f103xe.o(.text))
[Address Reference Count : 1]

- startup_stm32f103xe.o(RESET)

USB_LP_CAN1_RX0_IRQHandler (Thumb, 0 bytes, Stack size 0 bytes, startup_stm32f103xe.o(.text))
[Address Reference Count : 1]

- startup_stm32f103xe.o(RESET)

WWDG_IRQHandler (Thumb, 0 bytes, Stack size 0 bytes, startup_stm32f103xe.o(.text))
[Address Reference Count : 1]

- startup_stm32f103xe.o(RESET)

__user_initial_stackheap (Thumb, 0 bytes, Stack size unknown bytes, startup_stm32f103xe.o(.text))

[Called By]

- >> __user_setup_stackheap

__use_no_semihosting (Thumb, 2 bytes, Stack size 0 bytes, use_no_semi_2.o(.text), UNUSED)

__2printf (Thumb, 20 bytes, Stack size 24 bytes, noretval__2printf.o(.text))

[Stack]

- Max Depth = 128 + Unknown Stack Size
- Call Chain = __2printf ⇒ _printf_char_file ⇒ _printf_char_common ⇒ __printf

[Calls]

- >> _printf_char_file

[Called By]

- >> main

__printf (Thumb, 104 bytes, Stack size 24 bytes, __printf.o(.text))

[Stack]

- Max Depth = 24 + Unknown Stack Size
- Call Chain = __printf

[Calls]

- >> _printf_percent

[Called By]

- >> _printf_char_common

_printf_int_dec (Thumb, 104 bytes, Stack size 24 bytes, _printf_dec.o(.text))

[Stack]

- Max Depth = 56
- Call Chain = _printf_int_dec ⇒ _printf_int_common

[Calls]

- >> _printf_int_common

[Called By]

- >> _printf_d

__use_two_region_memory (Thumb, 2 bytes, Stack size 0 bytes, heapauxi.o(.text), UNUSED)

__rt_heap_escrow$2region (Thumb, 2 bytes, Stack size 0 bytes, heapauxi.o(.text), UNUSED)

__rt_heap_expand$2region (Thumb, 2 bytes, Stack size 0 bytes, heapauxi.o(.text), UNUSED)

__semihosting$guard (Thumb, 0 bytes, Stack size 0 bytes, use_no_semi.o(.text), UNUSED)

__use_no_semihosting_swi (Thumb, 2 bytes, Stack size 0 bytes, use_no_semi.o(.text), UNUSED)

_printf_int_common (Thumb, 178 bytes, Stack size 32 bytes, _printf_intcommon.o(.text))

[Stack]

- Max Depth = 32
- Call Chain = _printf_int_common

[Called By]

- >> _printf_int_dec

_printf_char_file (Thumb, 32 bytes, Stack size 16 bytes, _printf_char_file.o(.text))

[Stack]

- Max Depth = 104 + Unknown Stack Size
- Call Chain = _printf_char_file ⇒ _printf_char_common ⇒ __printf

[Calls]

- >> ferror
- >> _printf_char_common

[Called By]

- >> __2printf

_printf_char_common (Thumb, 32 bytes, Stack size 64 bytes, _printf_char_common.o(.text))

[Stack]

- Max Depth = 88 + Unknown Stack Size
- Call Chain = _printf_char_common ⇒ __printf

[Calls]

- >> __printf

[Called By]

- >> _printf_char_file

ferror (Thumb, 8 bytes, Stack size 0 bytes, ferror.o(.text))

[Called By]

- >> _printf_char_file

__user_setup_stackheap (Thumb, 74 bytes, Stack size 8 bytes, sys_stackheap_outer.o(.text))

[Stack]

- Max Depth = 8 + Unknown Stack Size
- Call Chain = __user_setup_stackheap

[Calls]

- >> __user_perproc_libspace
- >> __user_initial_stackheap

[Called By]

- >> __rt_entry_sh

exit (Thumb, 18 bytes, Stack size 8 bytes, exit.o(.text))

[Stack]

- Max Depth = 8 + Unknown Stack Size
- Call Chain = exit

[Calls]

- >> __rt_exit

[Called By]

- >> __rt_entry_main

__user_libspace (Thumb, 8 bytes, Stack size 0 bytes, libspace.o(.text), UNUSED)

__user_perproc_libspace (Thumb, 0 bytes, Stack size 0 bytes, libspace.o(.text))

[Called By]

- >> __user_setup_stackheap

__user_perthread_libspace (Thumb, 0 bytes, Stack size 0 bytes, libspace.o(.text), UNUSED)

USART1_IRQHandler (Thumb, 118 bytes, Stack size 0 bytes, usart.o(i.USART1_IRQHandler))
[Address Reference Count : 1]

- startup_stm32f103xe.o(RESET)

_sys_exit (Thumb, 4 bytes, Stack size 0 bytes, usart.o(i._sys_exit))

[Called By]

- >> __rt_exit_exit

delay_init (Thumb, 34 bytes, Stack size 0 bytes, delay.o(i.delay_init))

[Called By]

- >> main

delay_ms (Thumb, 50 bytes, Stack size 16 bytes, delay.o(i.delay_ms))

[Stack]

- Max Depth = 16
- Call Chain = delay_ms

[Calls]

- >> delay_us

[Called By]

- >> main

delay_us (Thumb, 72 bytes, Stack size 0 bytes, delay.o(i.delay_us))

[Called By]

- >> delay_ms

fputc (Thumb, 24 bytes, Stack size 0 bytes, usart.o(i.fputc))
[Address Reference Count : 1]

- _printf_char_file.o(.text)

main (Thumb, 48 bytes, Stack size 0 bytes, main.o(i.main))

[Stack]

- Max Depth = 128 + Unknown Stack Size
- Call Chain = main ⇒ __2printf ⇒ _printf_char_file ⇒ _printf_char_common ⇒ __printf

[Calls]

- >> __2printf
- >> usart_init
- >> sys_stm32_clock_init
- >> delay_ms
- >> delay_init

[Called By]

- >> __rt_entry_main

sys_clock_set (Thumb, 164 bytes, Stack size 8 bytes, sys.o(i.sys_clock_set))

[Stack]

- Max Depth = 8
- Call Chain = sys_clock_set

[Called By]

- >> sys_stm32_clock_init

sys_gpio_set (Thumb, 234 bytes, Stack size 36 bytes, sys.o(i.sys_gpio_set))

[Stack]

- Max Depth = 36
- Call Chain = sys_gpio_set

[Called By]

- >> usart_init

sys_nvic_init (Thumb, 116 bytes, Stack size 24 bytes, sys.o(i.sys_nvic_init))

[Stack]

- Max Depth = 24
- Call Chain = sys_nvic_init

[Calls]

- >> sys_nvic_priority_group_config

[Called By]

- >> usart_init

sys_nvic_set_vector_table (Thumb, 12 bytes, Stack size 0 bytes, sys.o(i.sys_nvic_set_vector_table))

[Called By]

- >> sys_stm32_clock_init

sys_stm32_clock_init (Thumb, 100 bytes, Stack size 8 bytes, sys.o(i.sys_stm32_clock_init))

[Stack]

- Max Depth = 16
- Call Chain = sys_stm32_clock_init ⇒ sys_clock_set

[Calls]

- >> sys_nvic_set_vector_table
- >> sys_clock_set

[Called By]

- >> main

usart_init (Thumb, 180 bytes, Stack size 24 bytes, usart.o(i.usart_init))

[Stack]

- Max Depth = 60
- Call Chain = usart_init ⇒ sys_gpio_set

[Calls]

- >> sys_nvic_init
- >> sys_gpio_set

[Called By]

- >> main

### Local Symbols

sys_nvic_priority_group_config (Thumb, 32 bytes, Stack size 0 bytes, sys.o(i.sys_nvic_priority_group_config))

[Called By]

- >> sys_nvic_init

_printf_input_char (Thumb, 10 bytes, Stack size 0 bytes, _printf_char_common.o(.text))
[Address Reference Count : 1]

- _printf_char_common.o(.text)

### Undefined Global Symbols
