liyuxuan3003/PrismGC/Test/lmj/M0_Experiments/Experiments/Task7/keil/code.htm

# Static Call Graph for image .\code.axf

#<CALLGRAPH># ARM Linker, 5060960: Last Updated: Sat Apr 02 21:43:45 2022

### Maximum Stack Usage = 0 bytes + Unknown(Untraceable Function Pointers)

### Call chain for Maximum Stack Depth:

### Function Pointers

- KEY_Handler from startup_cmsdk_cm0.o(.text) referenced from startup_cmsdk_cm0.o(RESET)
- Reset_Handler from startup_cmsdk_cm0.o(.text) referenced from startup_cmsdk_cm0.o(RESET)
- __main from main.o(i.__main) referenced from startup_cmsdk_cm0.o(.text)

### Global Symbols

Reset_Handler (Thumb, 8 bytes, Stack size 0 bytes, startup_cmsdk_cm0.o(.text))

KEY_Handler (Thumb, 8 bytes, Stack size 0 bytes, startup_cmsdk_cm0.o(.text))

[Calls]

- >> KEY_ISR

[Address Reference Count : 1]

- startup_cmsdk_cm0.o(RESET)

KEY_ISR (Thumb, 8 bytes, Stack size 0 bytes, keyboard.o(i.KEY_ISR))

[Called By]

- >> KEY_Handler

__main (Thumb, 82 bytes, Stack size 0 bytes, main.o(i.__main))
[Address Reference Count : 1]

- startup_cmsdk_cm0.o(.text)

### Local Symbols

### Undefined Global Symbols
