liyuxuan3003/PrismGC/Test/lmj/apple.png

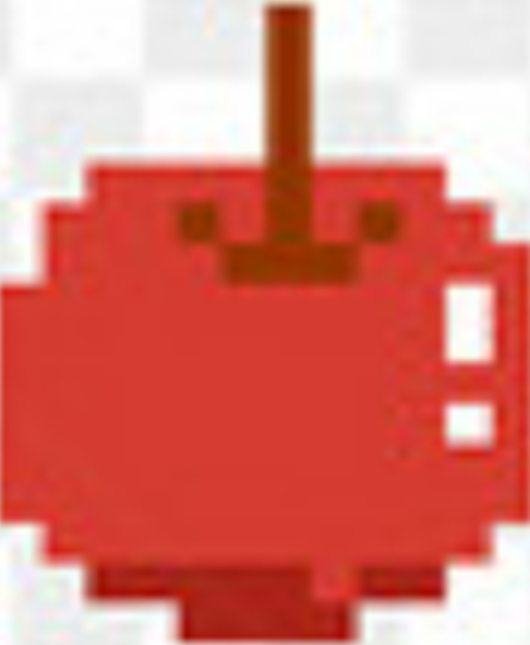
Test/lmj/apple.png
