liyuxuan3003/PrismGC/Test/lmj/slime2.png

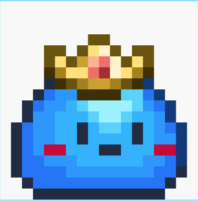
Test/lmj/slime2.png
