liyuxuan3003/PrismGC/Project/Todo.md

# 任务列表

## 考试周假期

- 解决VPN的问题，我用的VPN在Resource.md中有，但2023/03/10时访问提示403，如果你们仍然遇到这个问题，请考虑自行寻找其他的VPN提供商，但建议选择可以使用Clash For Windows客户端的VPN服务，开源的代理软件相对让人放心一些。
- 积极在Resource.md中记录你在学习中觉得有用的链接。
- 张岩的任务
    1. 安装新版本的Code Block，确保之前经过李宇轩修改后的猜数字的游戏可以被正确的编译。
    2. 在Resource.md中填写一下，上次让你买的正点原子的单片机具体是哪个配置的（找找你的淘宝记录），我之后可能考虑也要买一块。
    3. 初步研究正点原子的那块板子的教程（购买链接里面有教程链接），找到你现阶段需要的基础教程，梳理一下你要学什么，尽快就此向我做汇报。
    4. 深入研究正点原子的板子，开学时我需要看到显示屏能被点亮且可以显示你希望显示的内容。
- 李铭杰的任务
    1. 继续学习Resource.md中EG4S20资料2内的12个实验，开学时我需要看到你能完成并理解这12个实验，创造性的改动是鼓励的。
- 李宇轩的任务
    1. 继续研究如何在FPGA上烧写并使用Cortex-M0。

这一周任务仍以学习为主，开学后项目就要开始逐步推进。
