liyuxuan3003/PrismGC/Static/EG4S20_BG256.pdf

D | D
C | C
B | B
A | A

Title

Size | Number | | Revision

A3

Date: | 2021/12/31 | Sheet | of
File: | D:\work\..\Connector.SchDoc | Drawn By:
正面 | 背面

# 双排母

1 | 2
3 | 4
5 | 6
7 | 8
9 | 10
11 12
13 14
15 16
17 18
19 20
21 22
23 24
25 26
27 28
29 30
31 32
33 34
35 36
37 38
39 40

P2

贴片2.54mm，2x20,双排母,有固定柱

2 | 1
4 | 3
6 | 5
8 | 7
10 | 9
12 11
14 13
16 15
18 17
20 19
22 21
24 23
26 25
28 27
30 29
32 31
34 33
36 35
38 37
40 39

Y

贴片2.54mm，2x20,双排母,有固定柱

P3

OUT_3.3V | GND | OUT_3.3V | GND T4 | R5 | T4 | R5
T5 | T6 | T5 | T6
T7 | T8 | T7 | T8
T9 | R9 | T9 | R9
T12 | R12 | T12 | R12
T13 | N5 | T13 | N5
P5 | M6 | P5 | M6
N6 | P6 | N6 | P6
L7 | M7 | L7 | M7
T14 | R14 | T14 | R14
T15 | R15 | T15 | R15
P7 | L8 | P7 | L8
N8 | P8 | N8 | P8
M9 | N9 | M9 | N9
P9 | L10 | P9 | L10
M10 | P11 | M10 | P11
M12 | N12 | M12 | N12
P12 | R16 | P12 | R16
VBUS | GND | VBUS | GND
GND | GND | GND
GND | OUT_3.3V

VBUS

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
上 1 2

3 4

5 6

7 8

9 10

11 12

13 14

15 16

17 18

19 20

21 22

23 24

25 26

27 28

29 30

31 32

33 34

35 36

37 38

39 40

41 42

43 44

45 46

47 48

49 50

51 52

53 54

55 56

57 58

59 60 30X2排针，2.54mm

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
# N3 双排针

VBUS

GND

OUT_3.3V

GNGDNGDNGDNGDNGDND | GND | GND
GND
GNGDNGDNGDNGDNGDNGDNGDNGDND | GNGDND | GNGDND | GND
| | | OUT_3.3V

VBUS

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
下 1 2

3 4

5 6

7 8

9 10

11 12

13 14

15 16

17 18

19 20

21 22

23 24

25 26

27 28

29 30

31 32

33 34

35 36

37 38

39 40

41 42

43 44

45 46

47 48

49 50

51 52

53 54

55 56

57 58

59 60 30X2排针，2.54mm

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
PIP5019 | PIP5020
PIP5021 | PIP5022
PIP5023 | PIP5024

## COP5

PIP602 | PIP601
PIP604 | PIP603
PIP606 | PIP605
PIP608 | PIP607
PIP6010 | PIP609
PIP6012 | PIP6011
PIP6014 | PIP6013
PIP6016 | PIP6015
PIP6018 | PIP6017
PIP6020 | PIP6019
PIP6022 | PIP6021
PIP6024 | PIP6023

## COP6

# BANK0

# BANK1

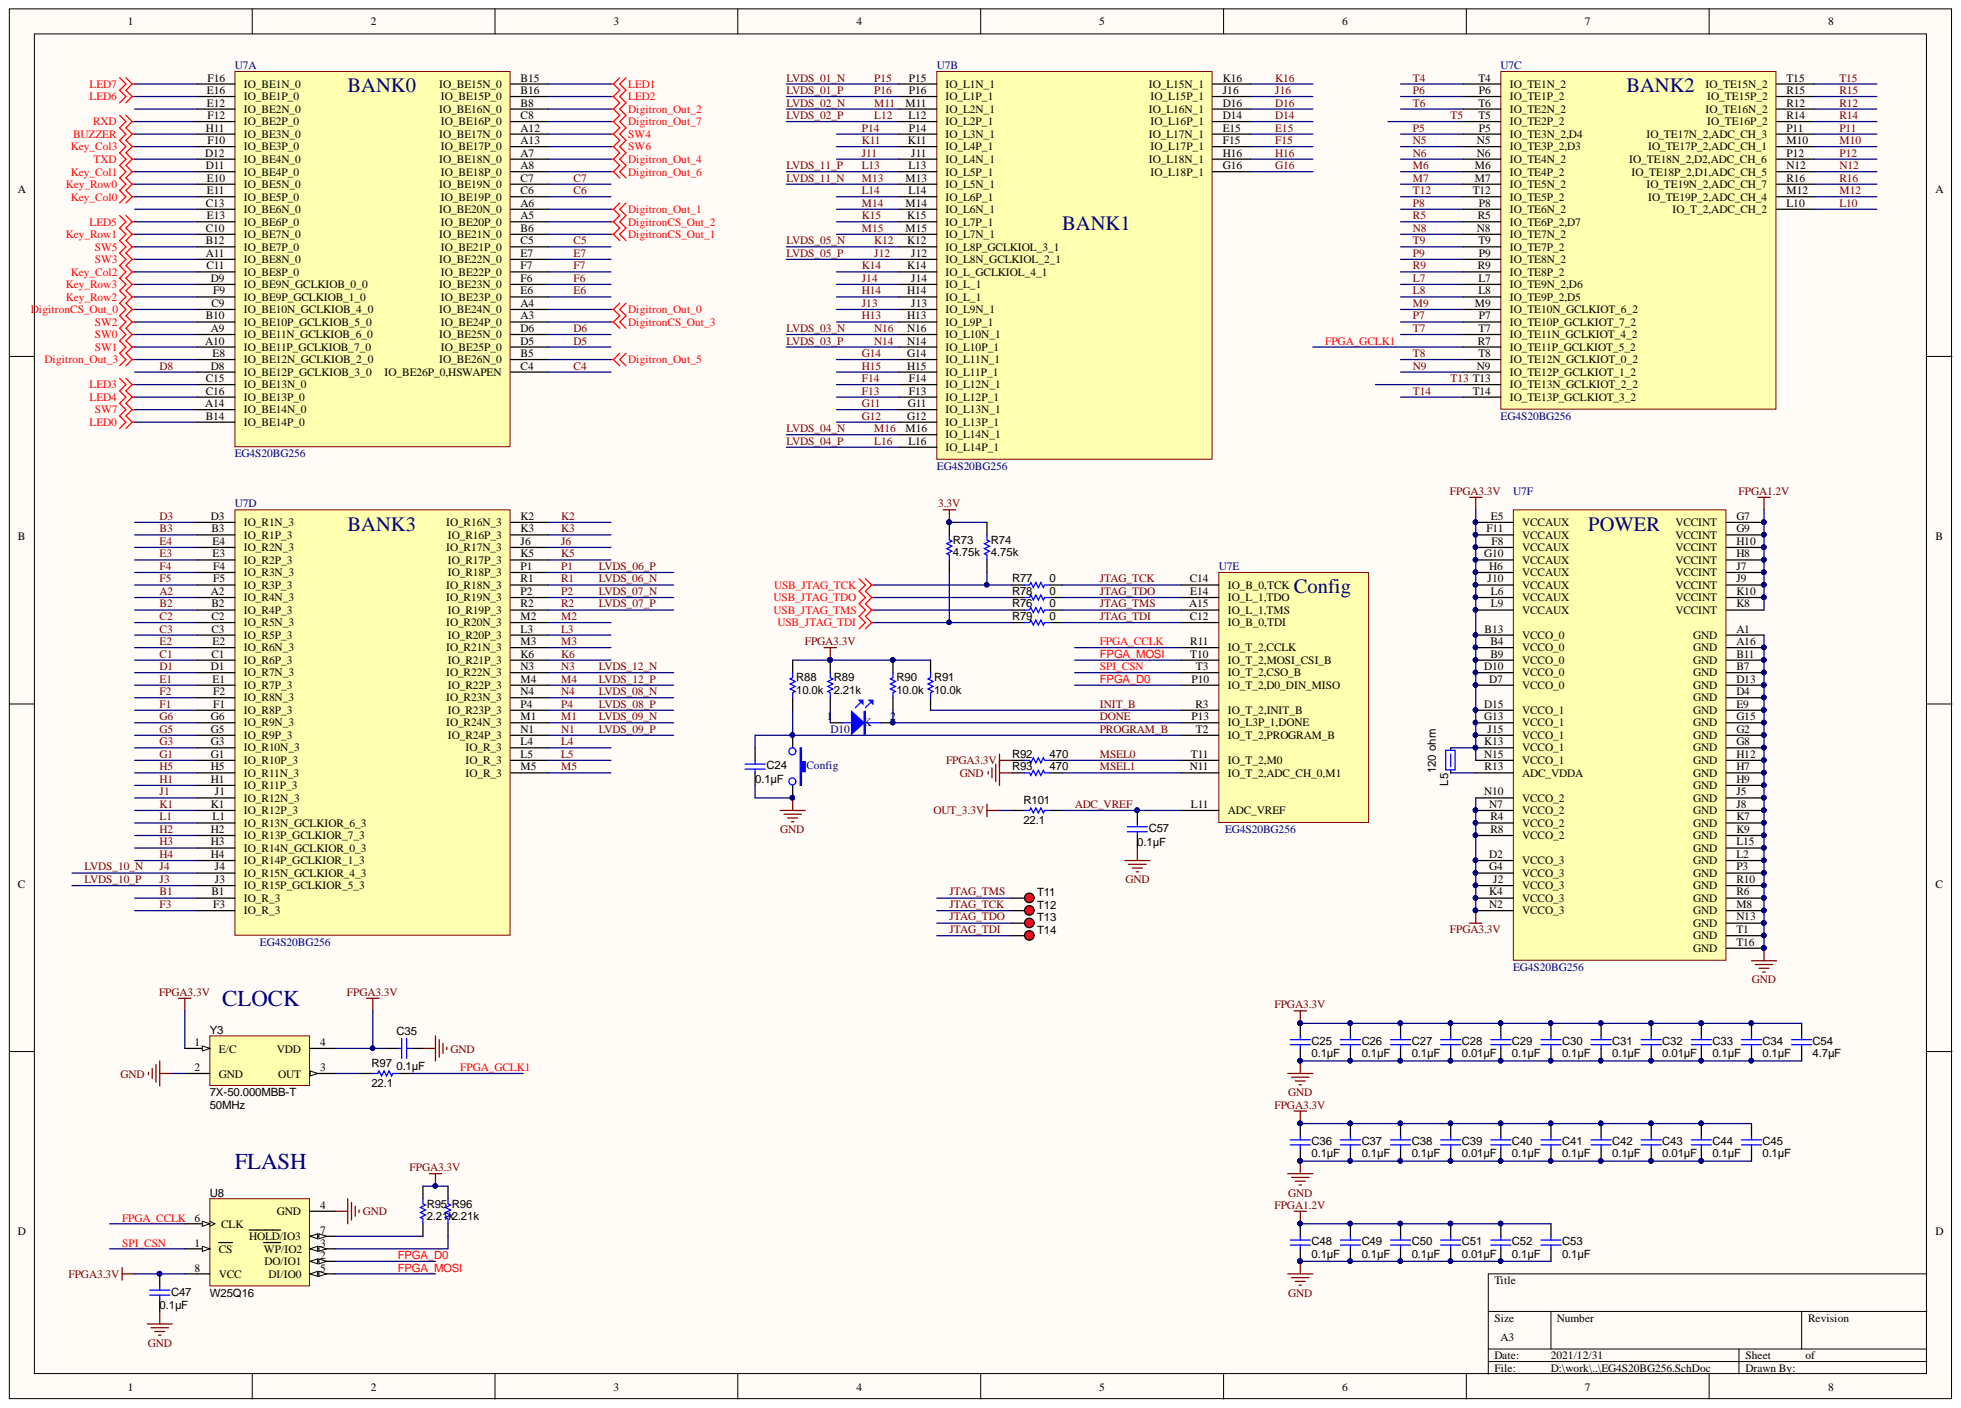
[picture p45: page 2]

A | A

## USB2_D1+

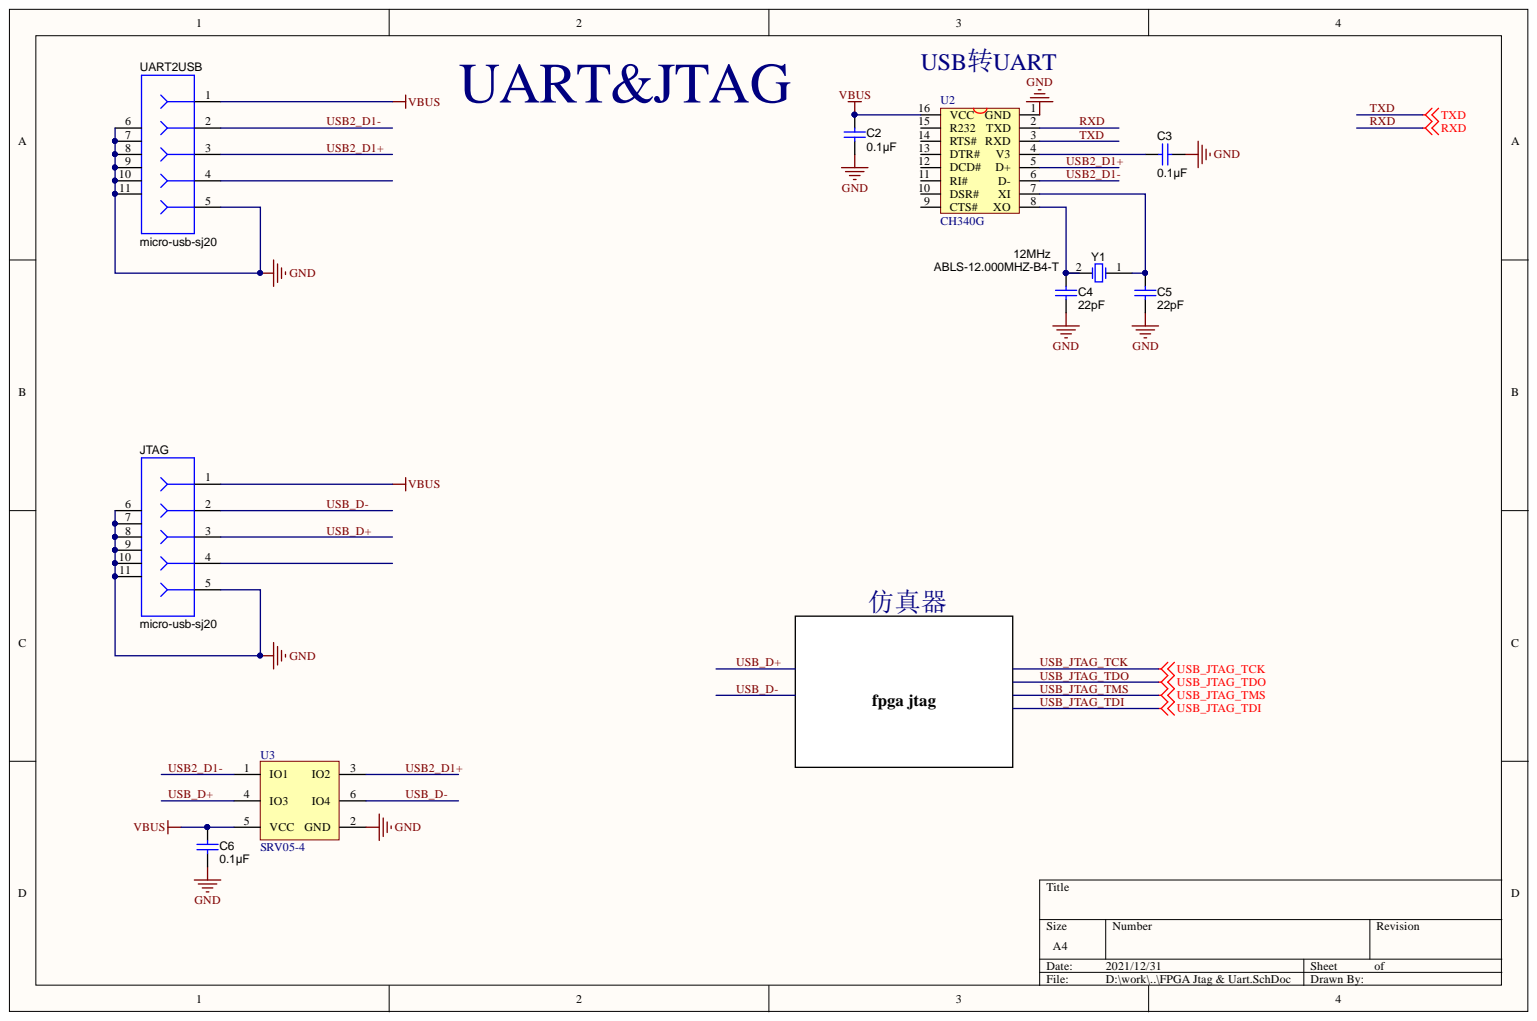
[picture p46: page 3]

SW

# 四位共阴数码管

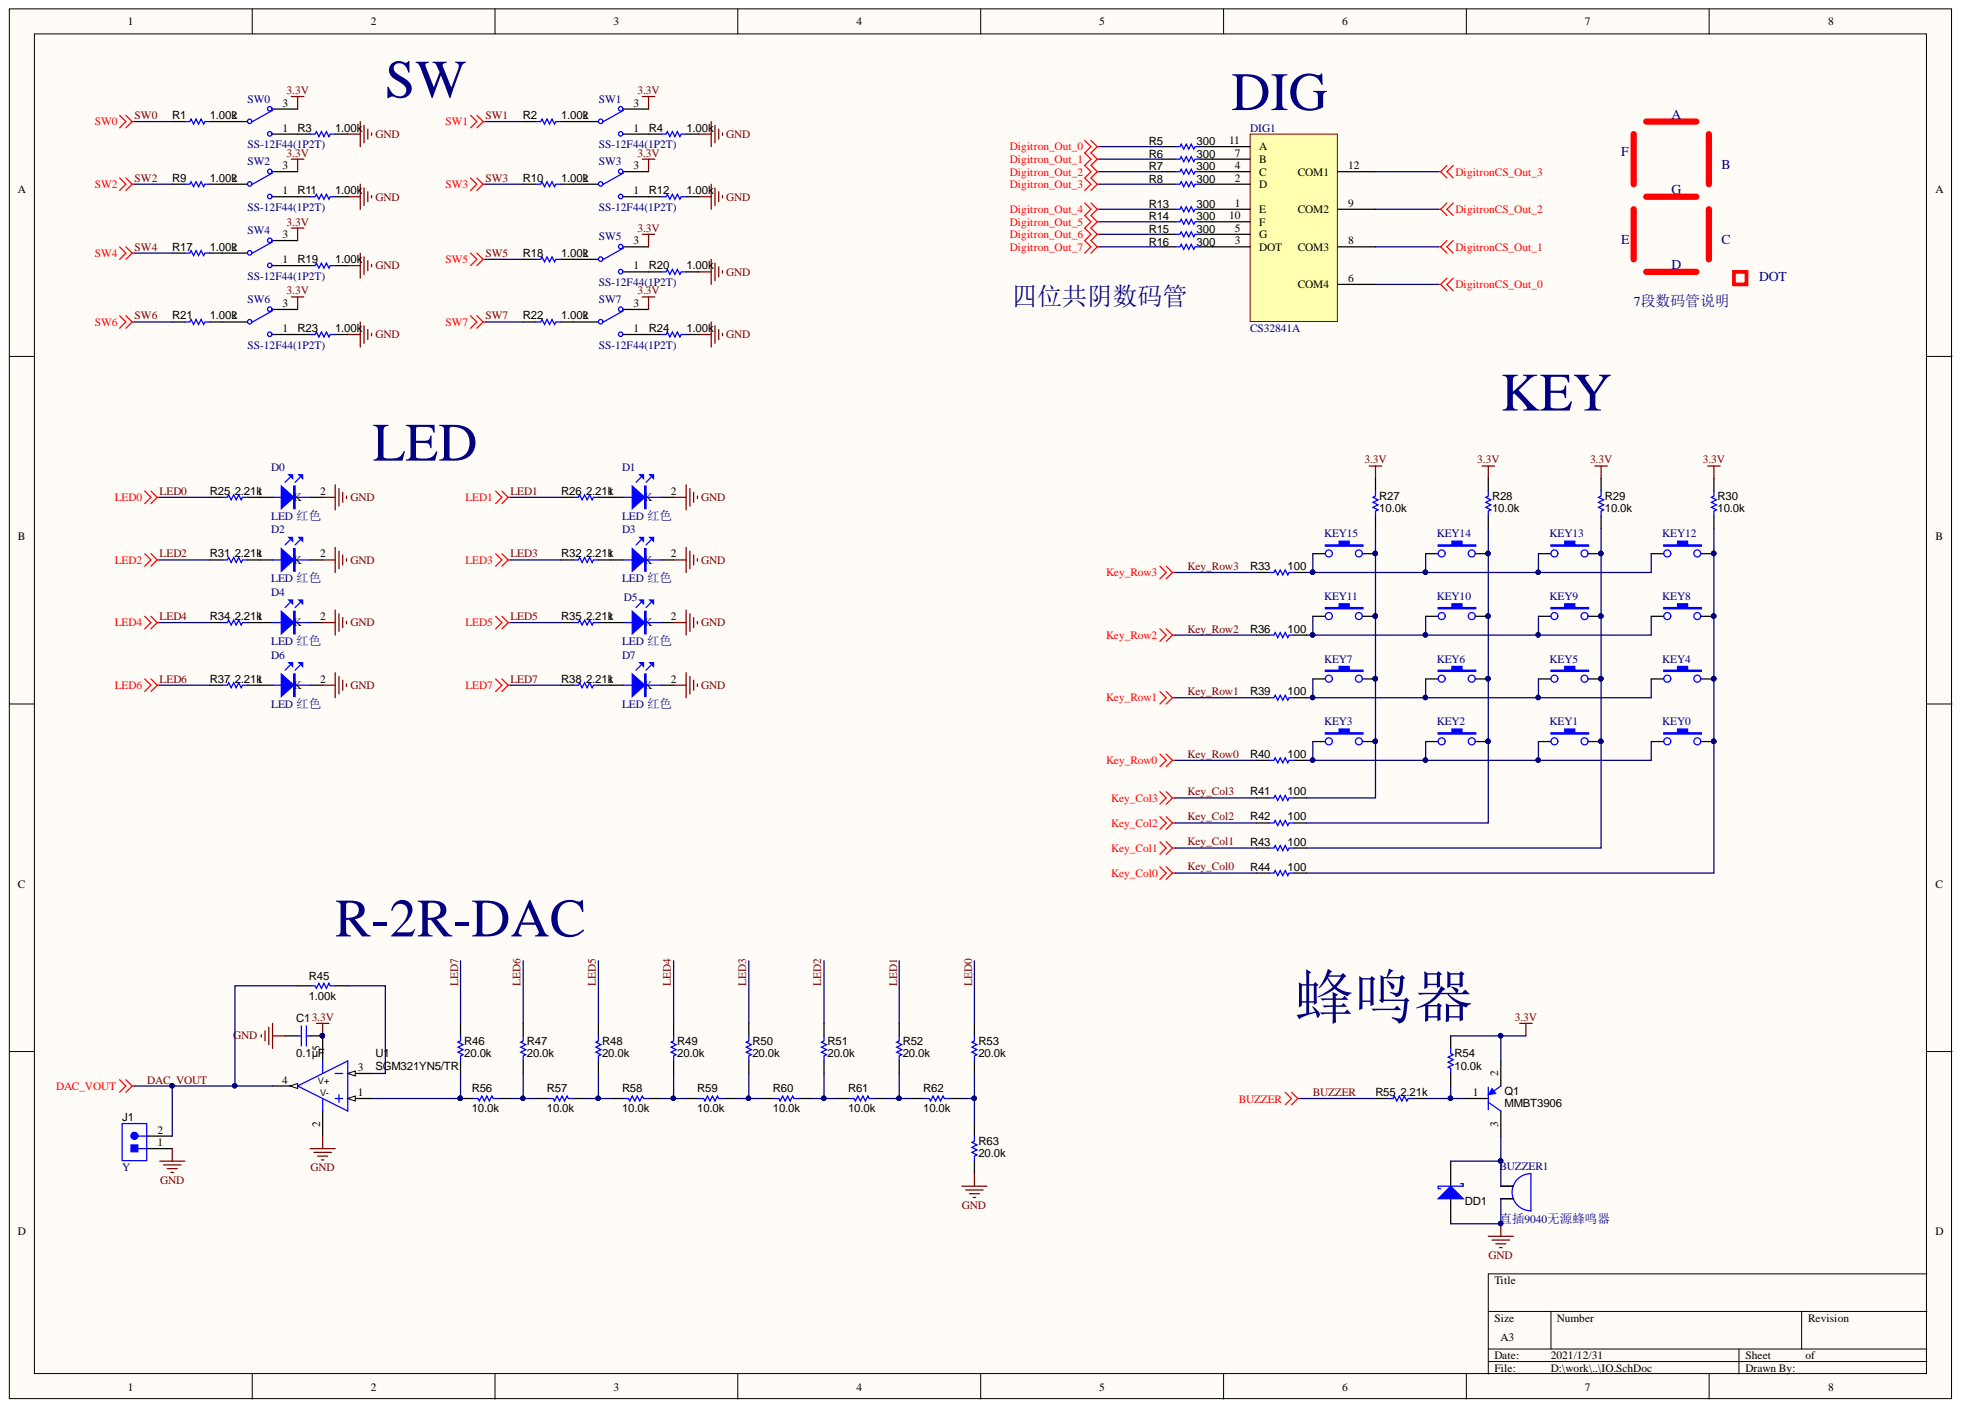
[picture p47: page 4]

A | A

# Power

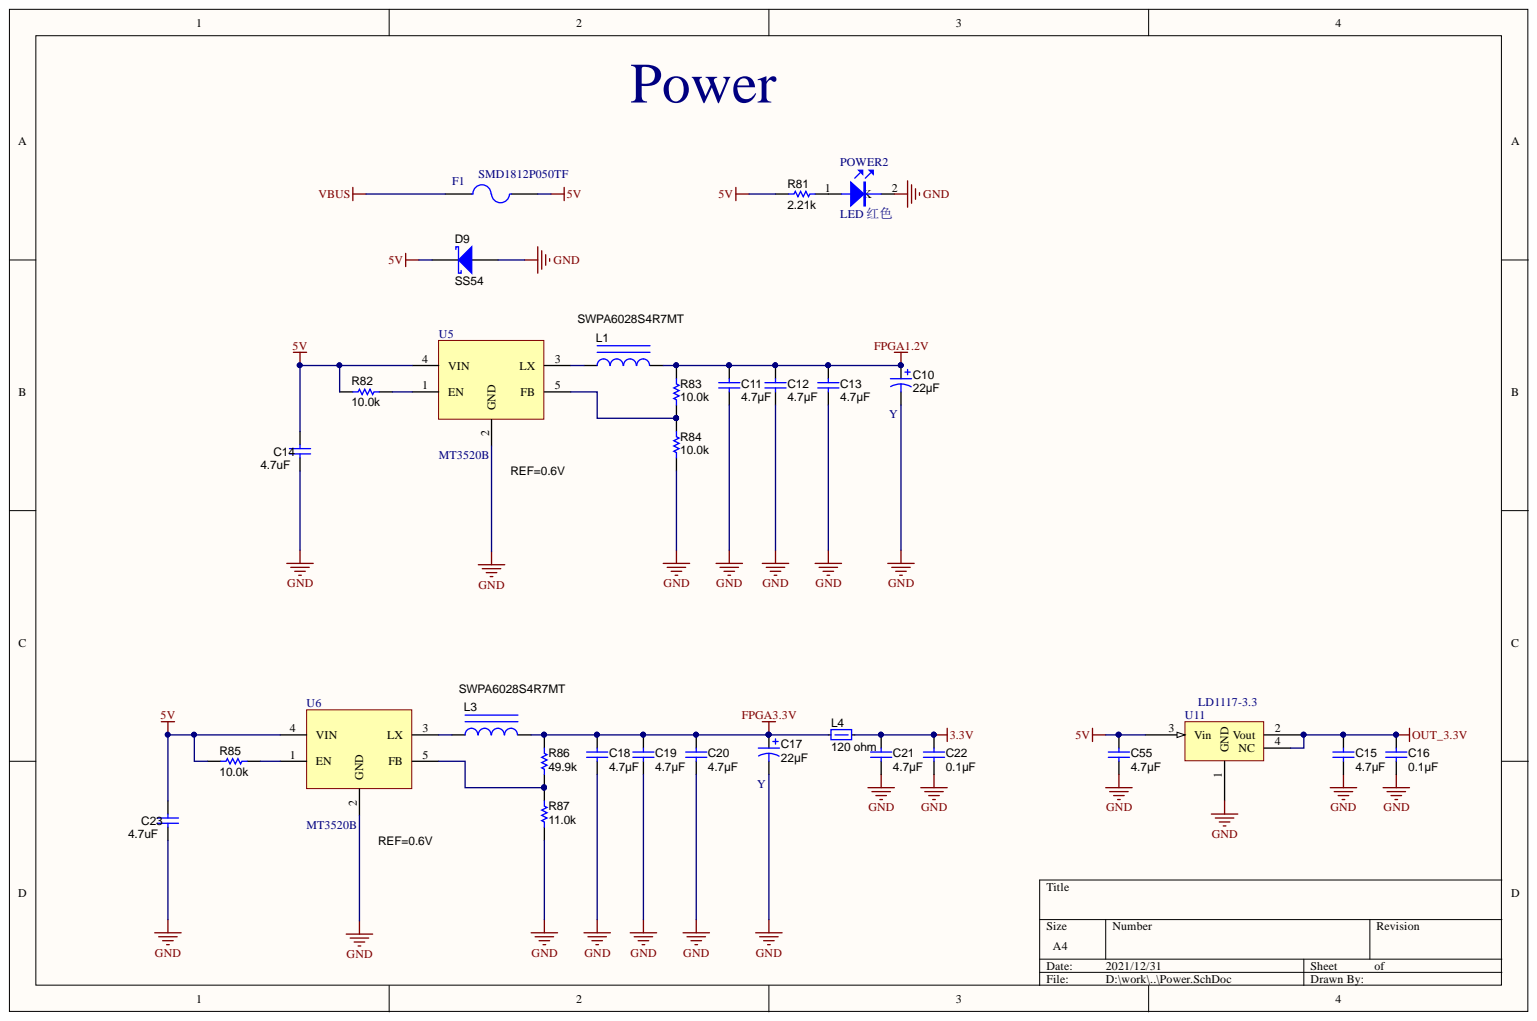
[picture p48: page 5]
