liyuxuan3003/PrismGC/Inventor/Upload/002.pdf

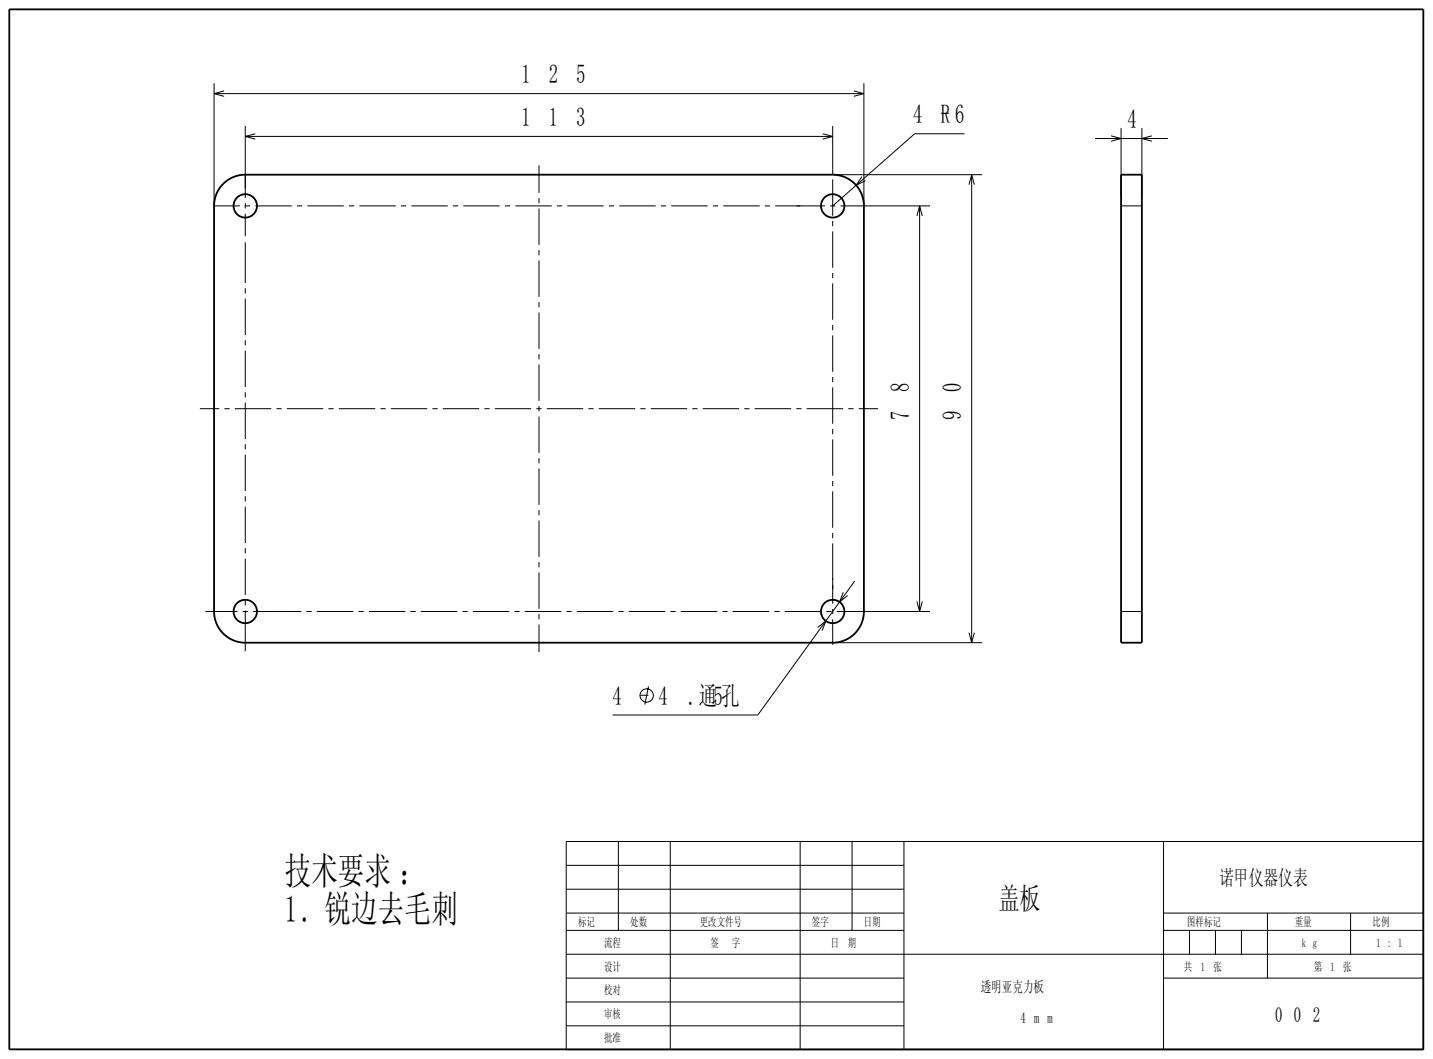
[picture p49: page 1]

标记 | 处数 | 更改文件号 | 签字 | 日期 | 图样标记 | 重量 | 比例
流程 | 签 字 | 日 期 | | | | | kg | 1:1

设计 | | | 透明亚克力板 4mm | 共 1 张 | | | 第 1 张

校对 | | | | 002
审核
