liyuxuan3003/PrismGC/Report/20230817-PrismGCDocumentFinal/image/Adapter_PCB.pdf

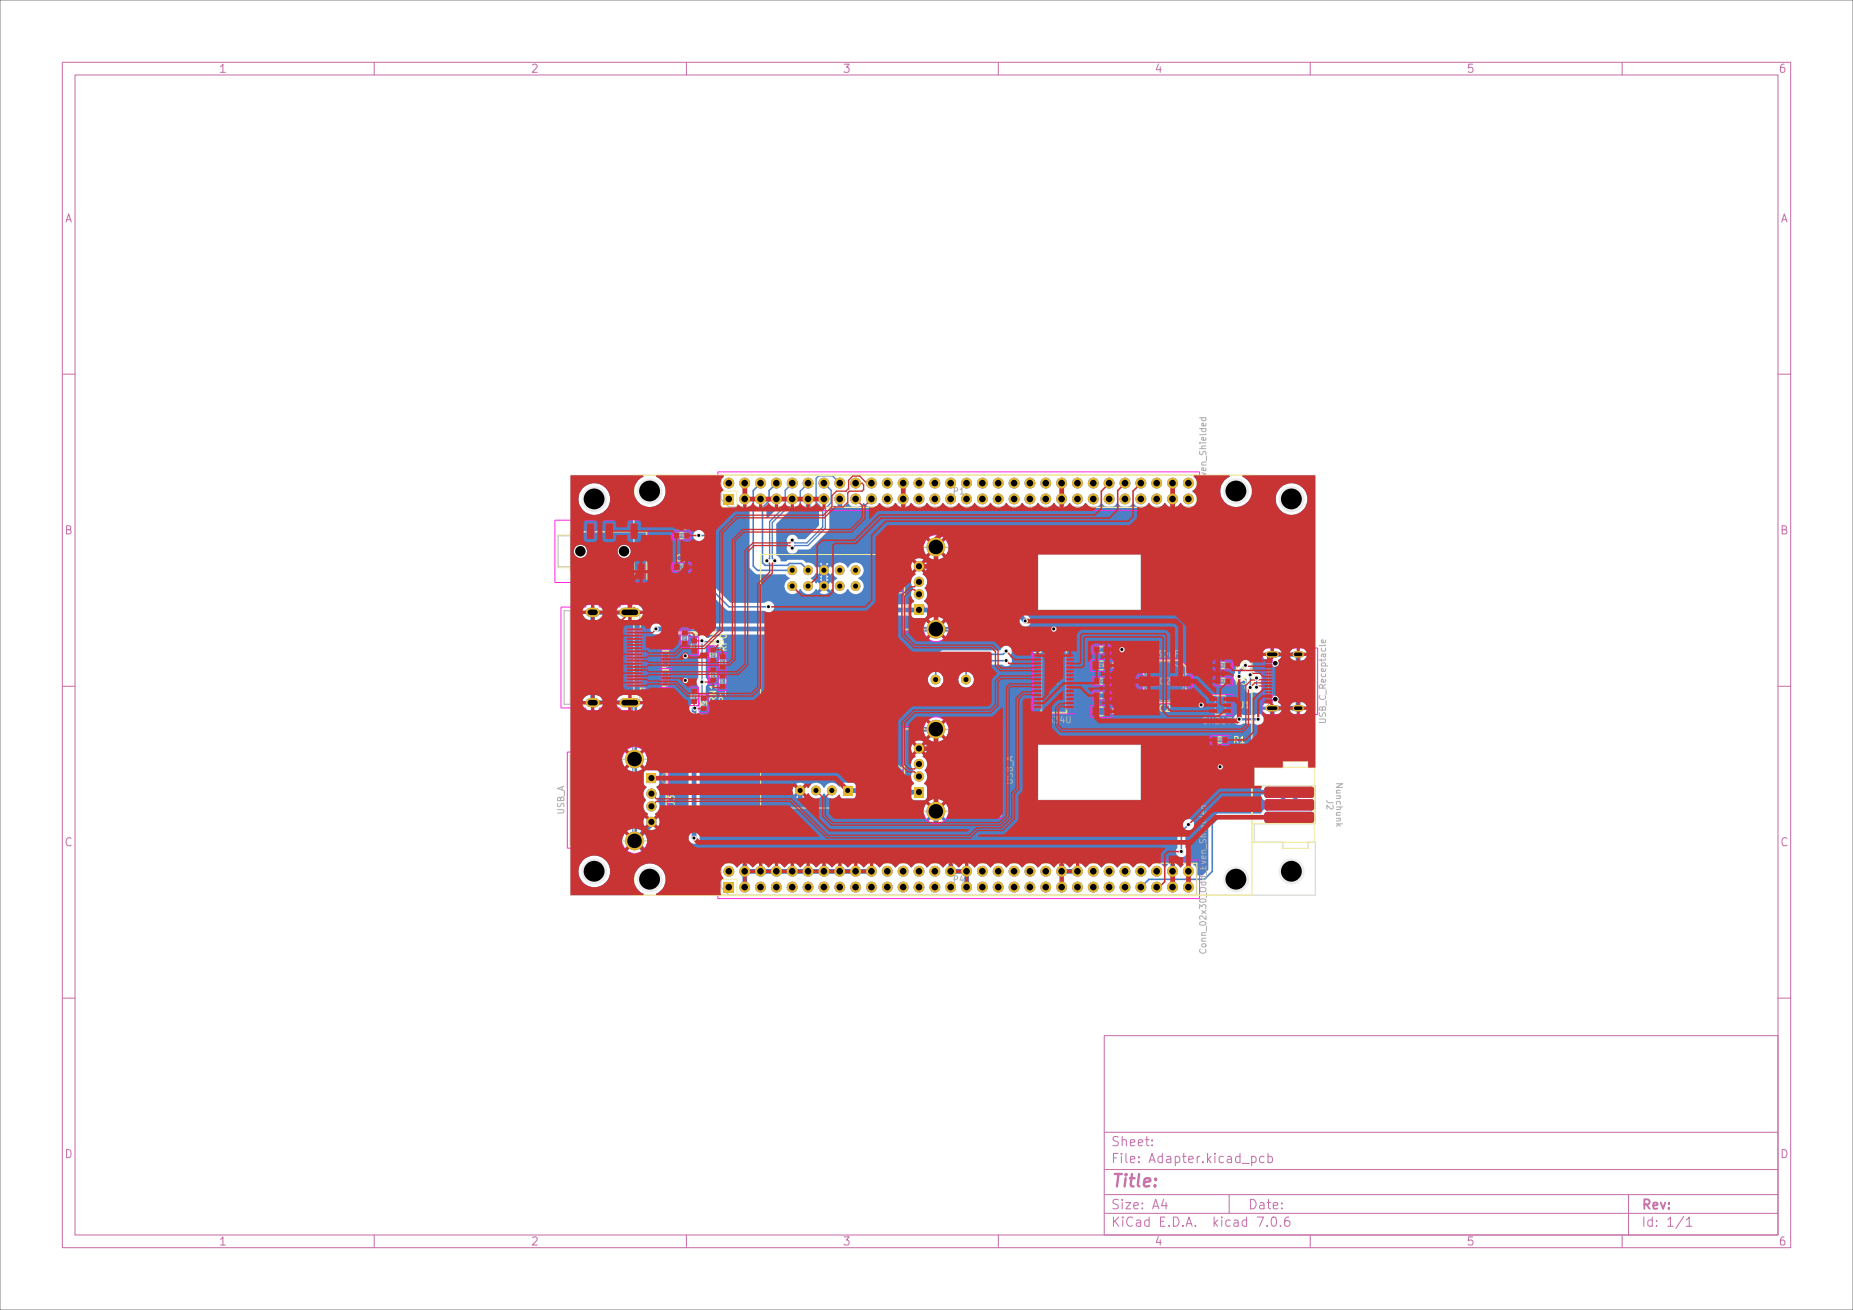
[picture p50: page 1]
