liyuxuan3003/PrismGC/Report/20230817-PrismGCDocumentFinal/image/Adapter.pdf

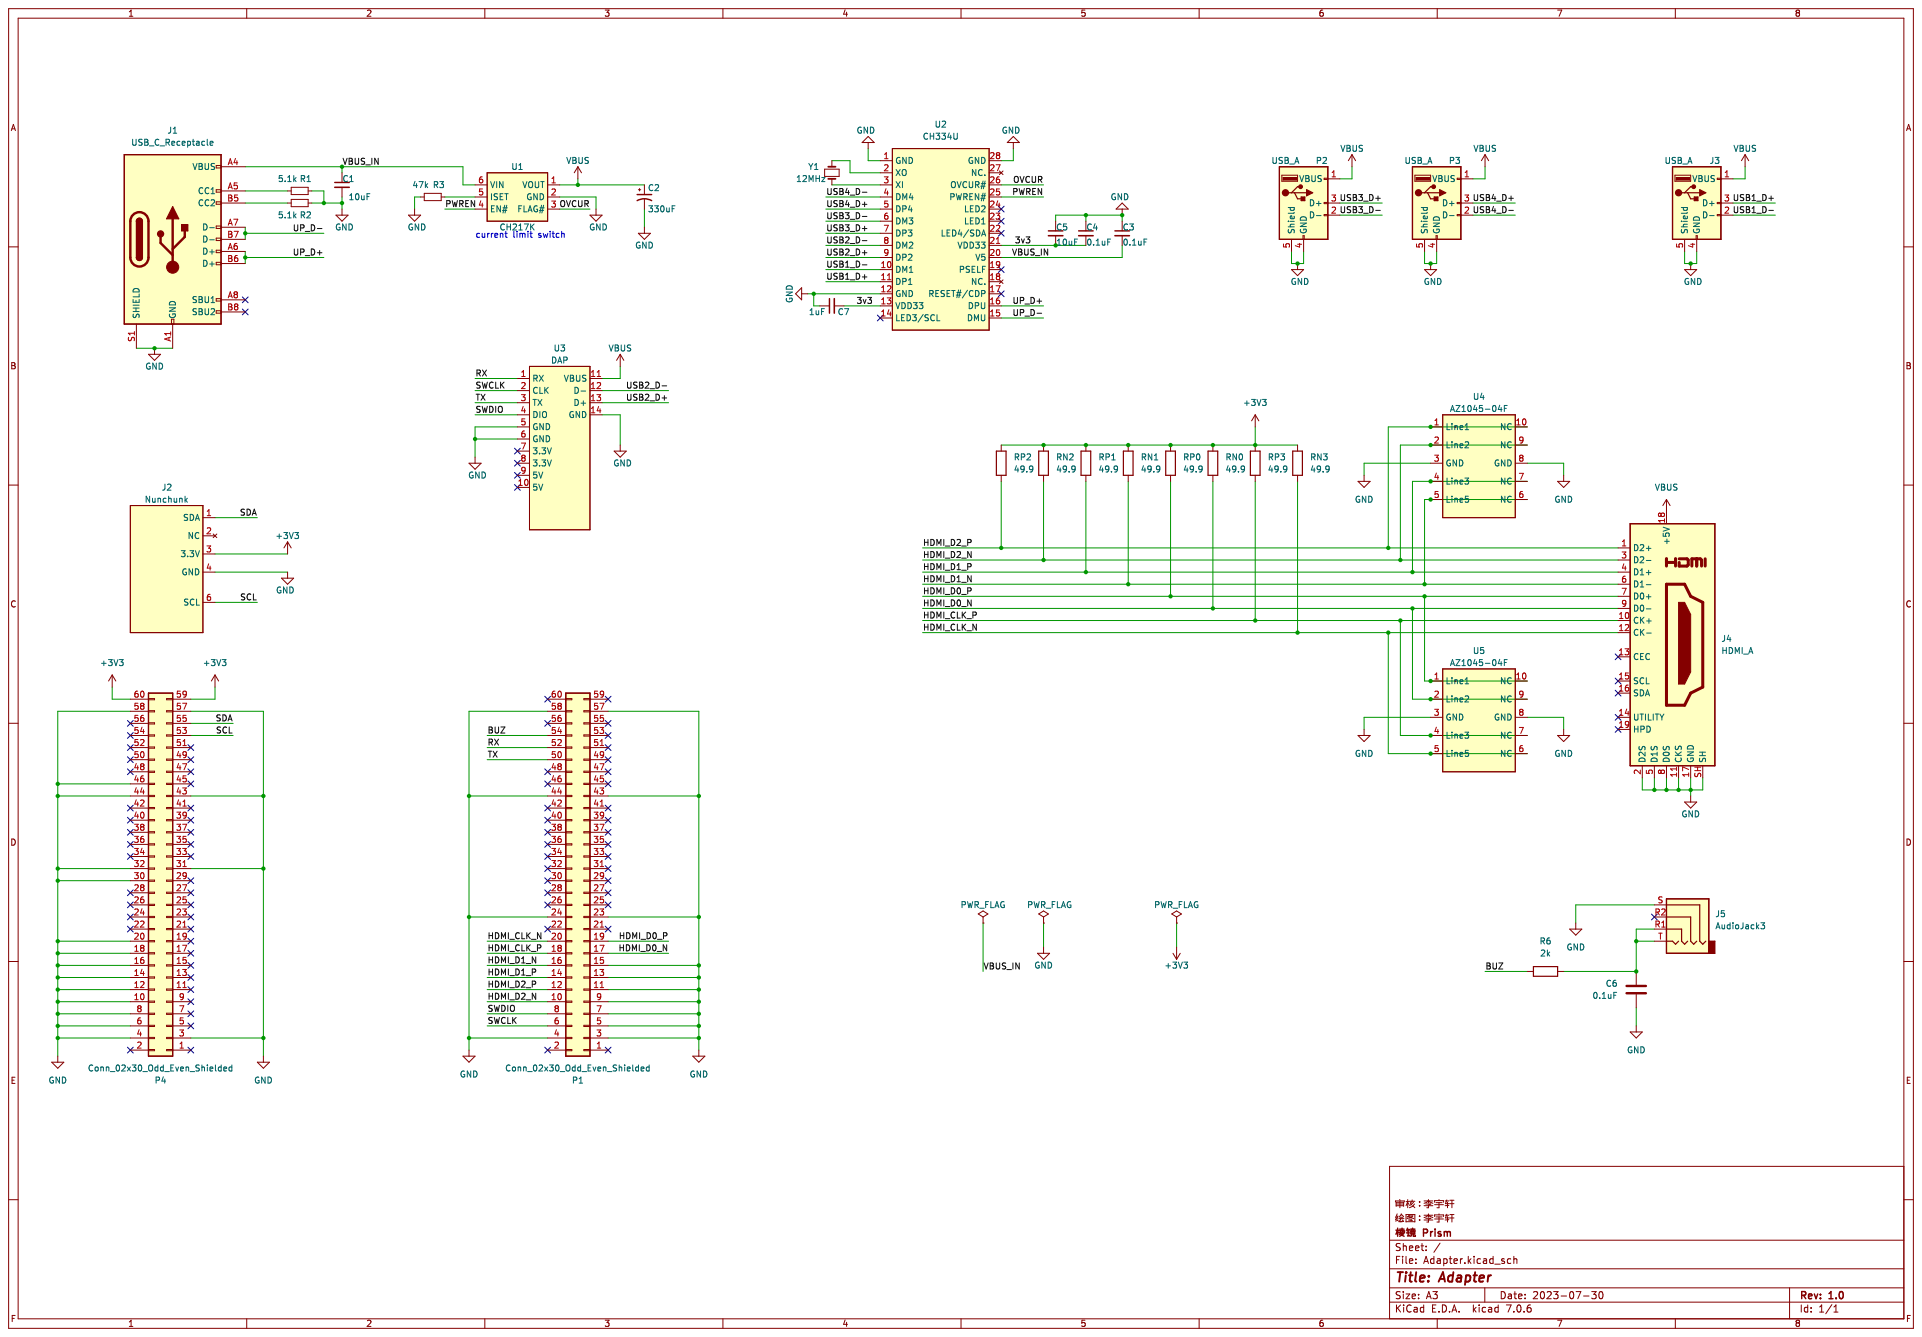
[picture p51: page 1]
