liyuxuan3003/PrismGC/Inventor/PrismGCNew.pdf

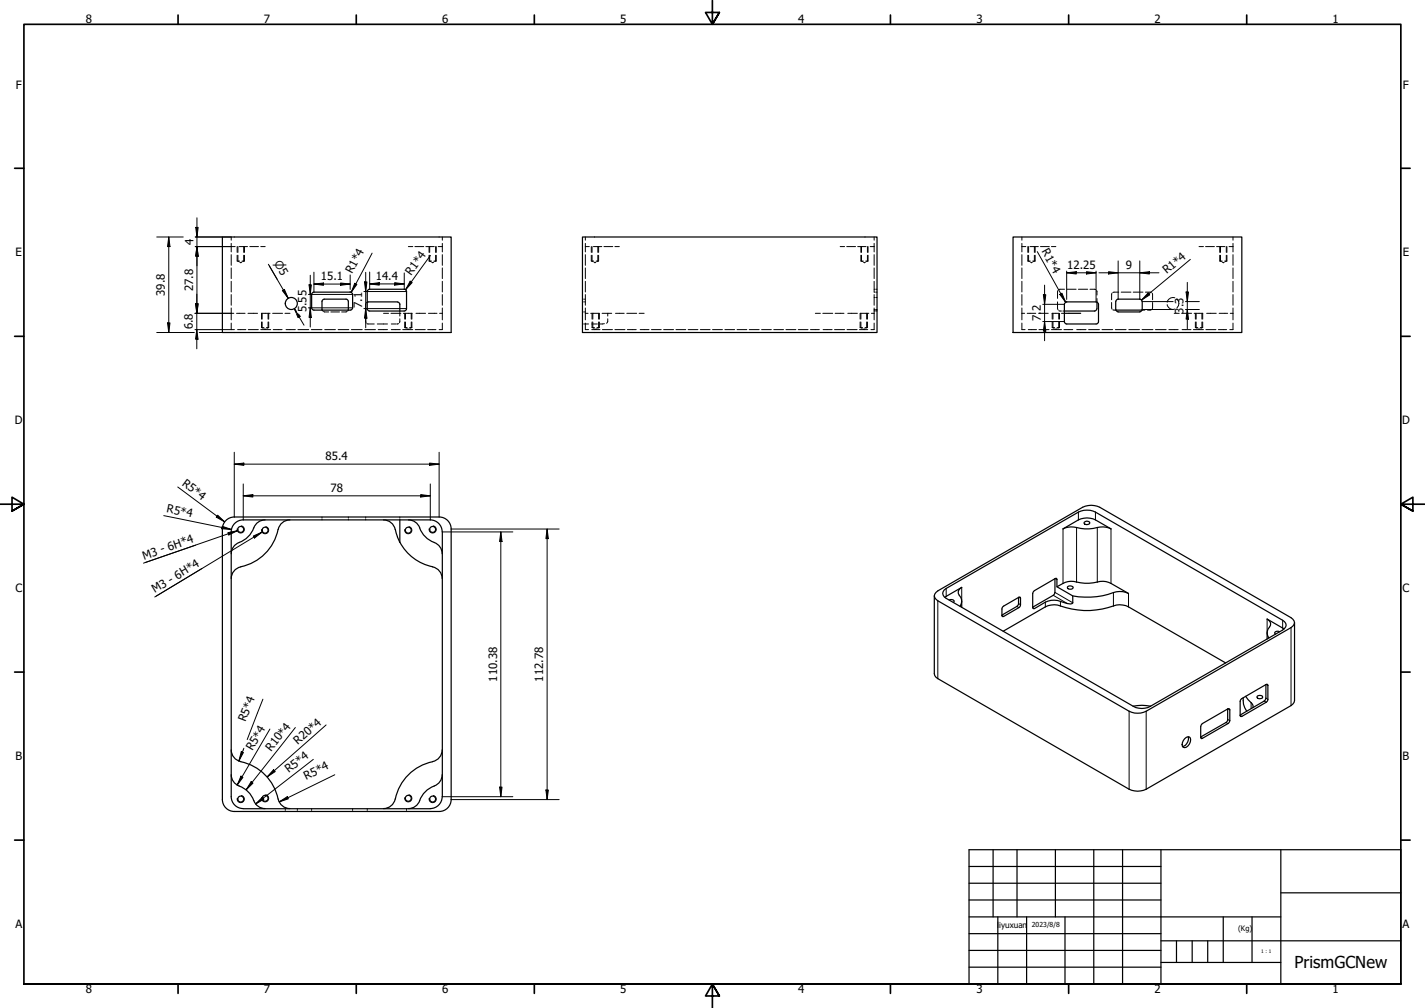
[picture p52: page 1]
F liyuxuan; PrismGCNew 1 : 1
