liyuxuan3003/PrismGC/Inventor/PrismGCUpNew.pdf

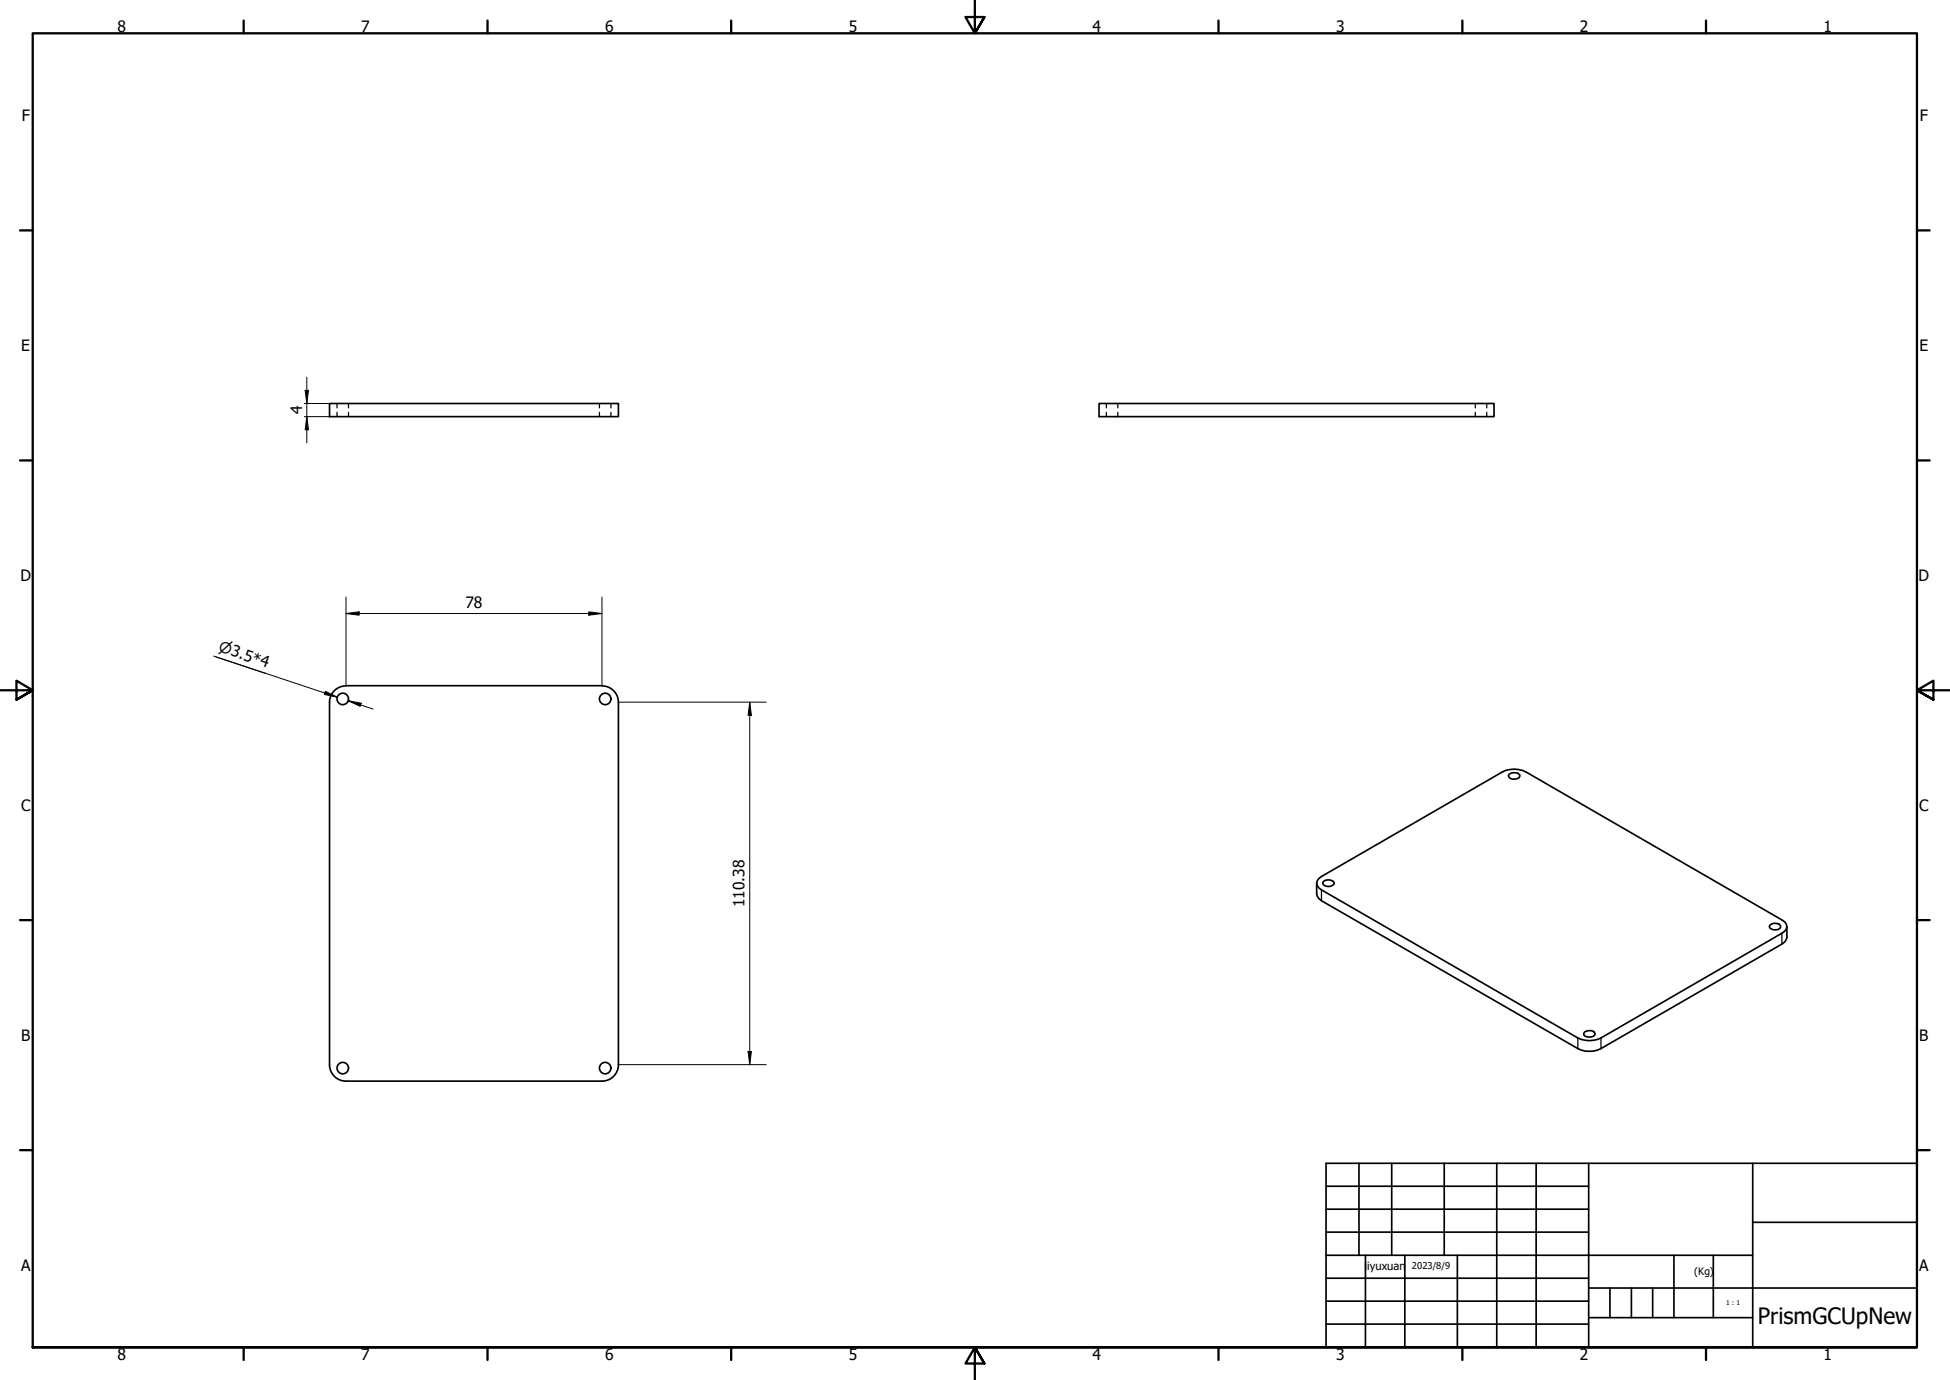
[picture p53: page 1]
