liyuxuan3003/PrismGC/Static/EG4S_VGA_HDMI_Ethnernet_SD_DAP.pdf

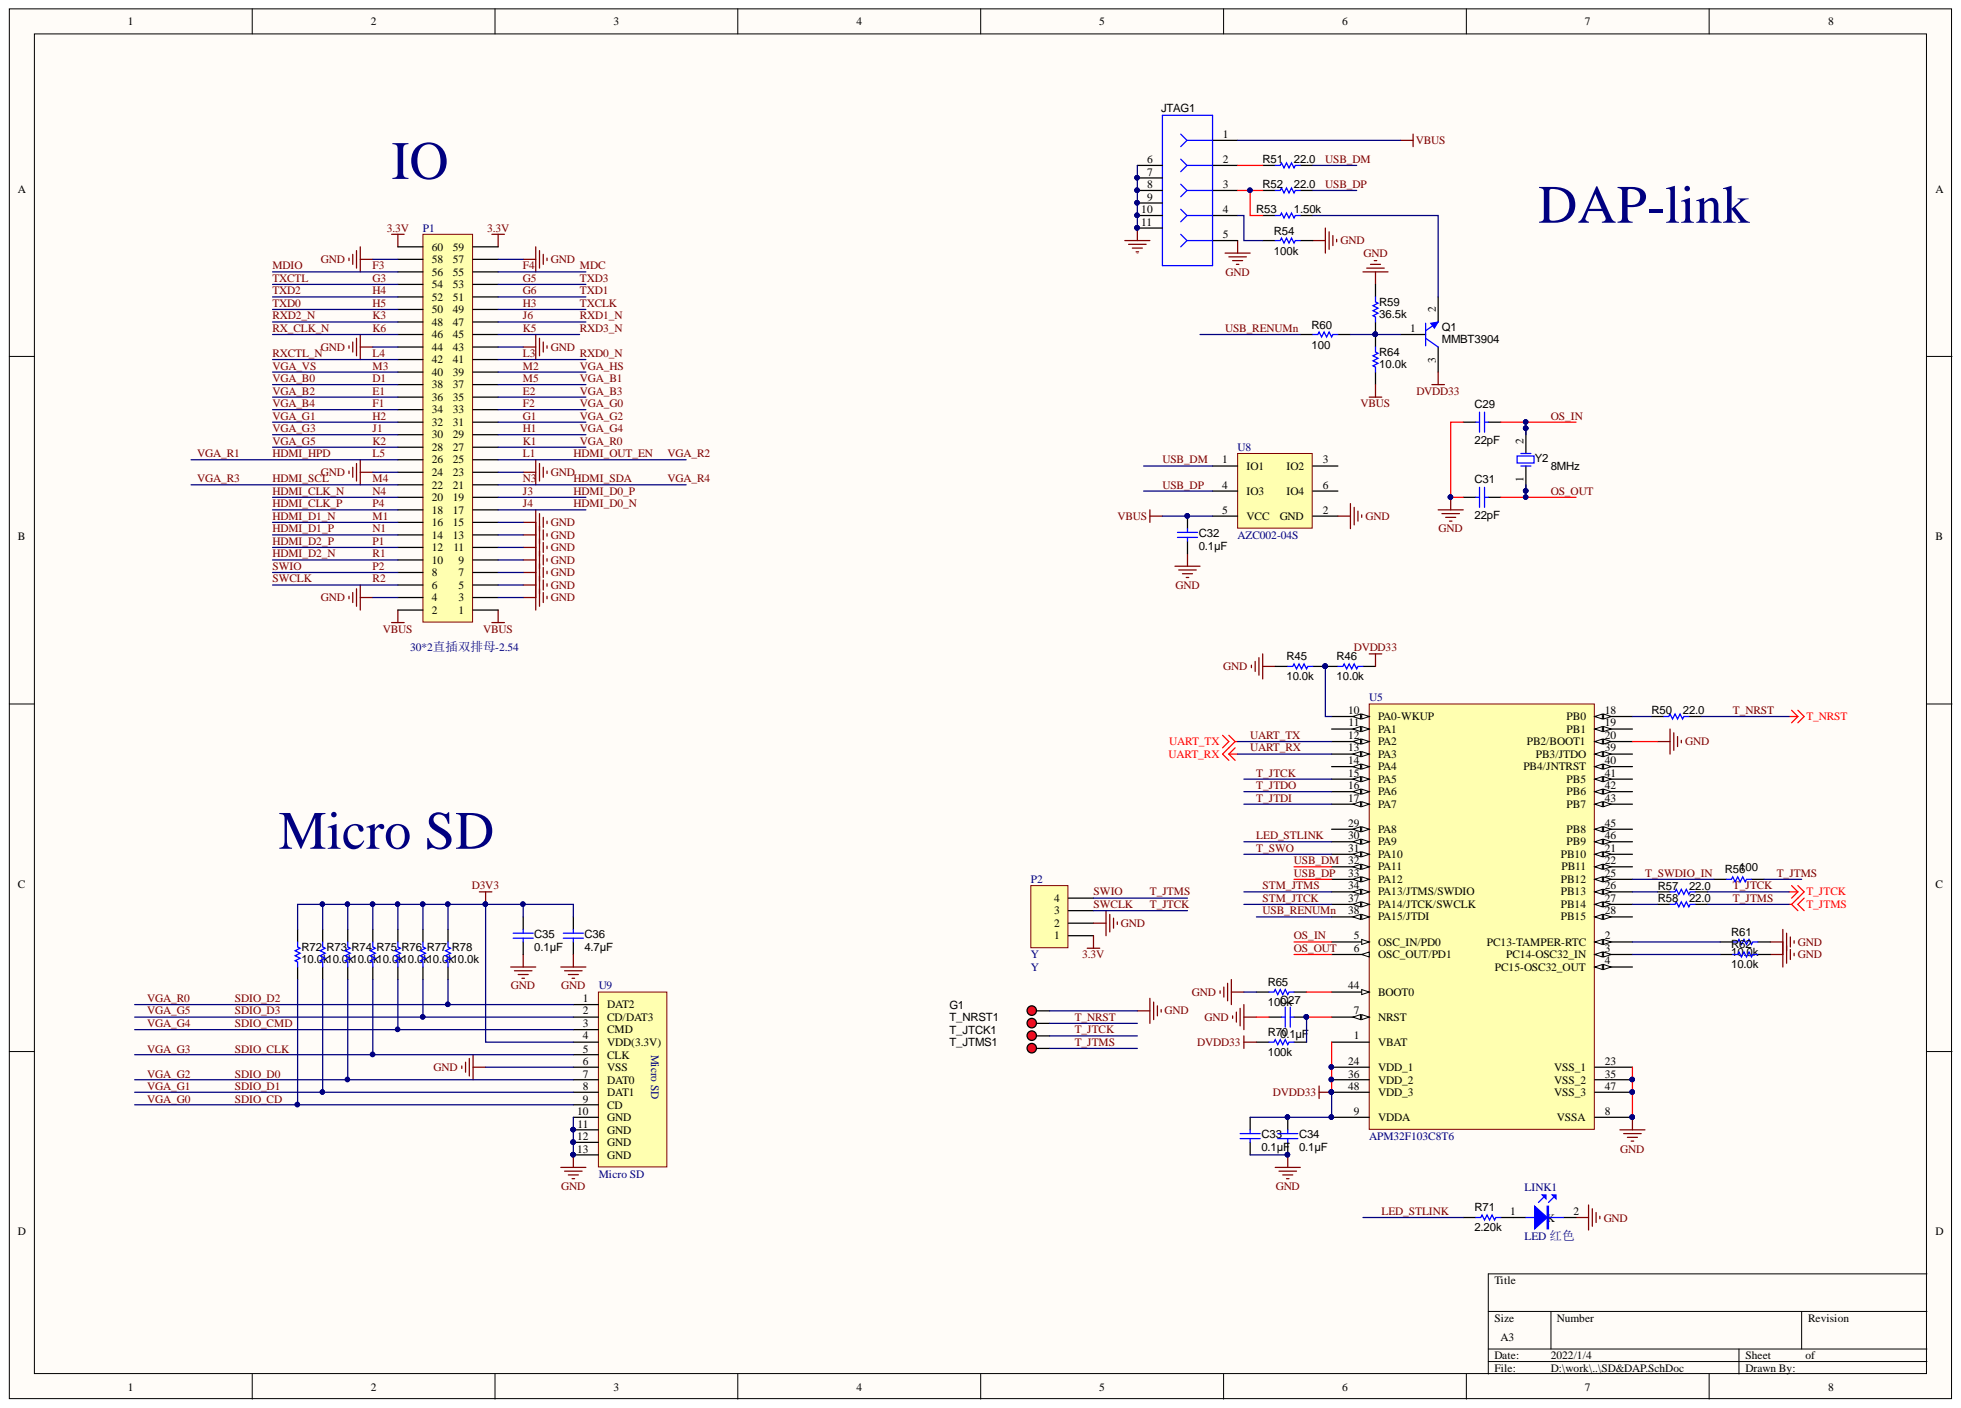
[picture p54: page 1]

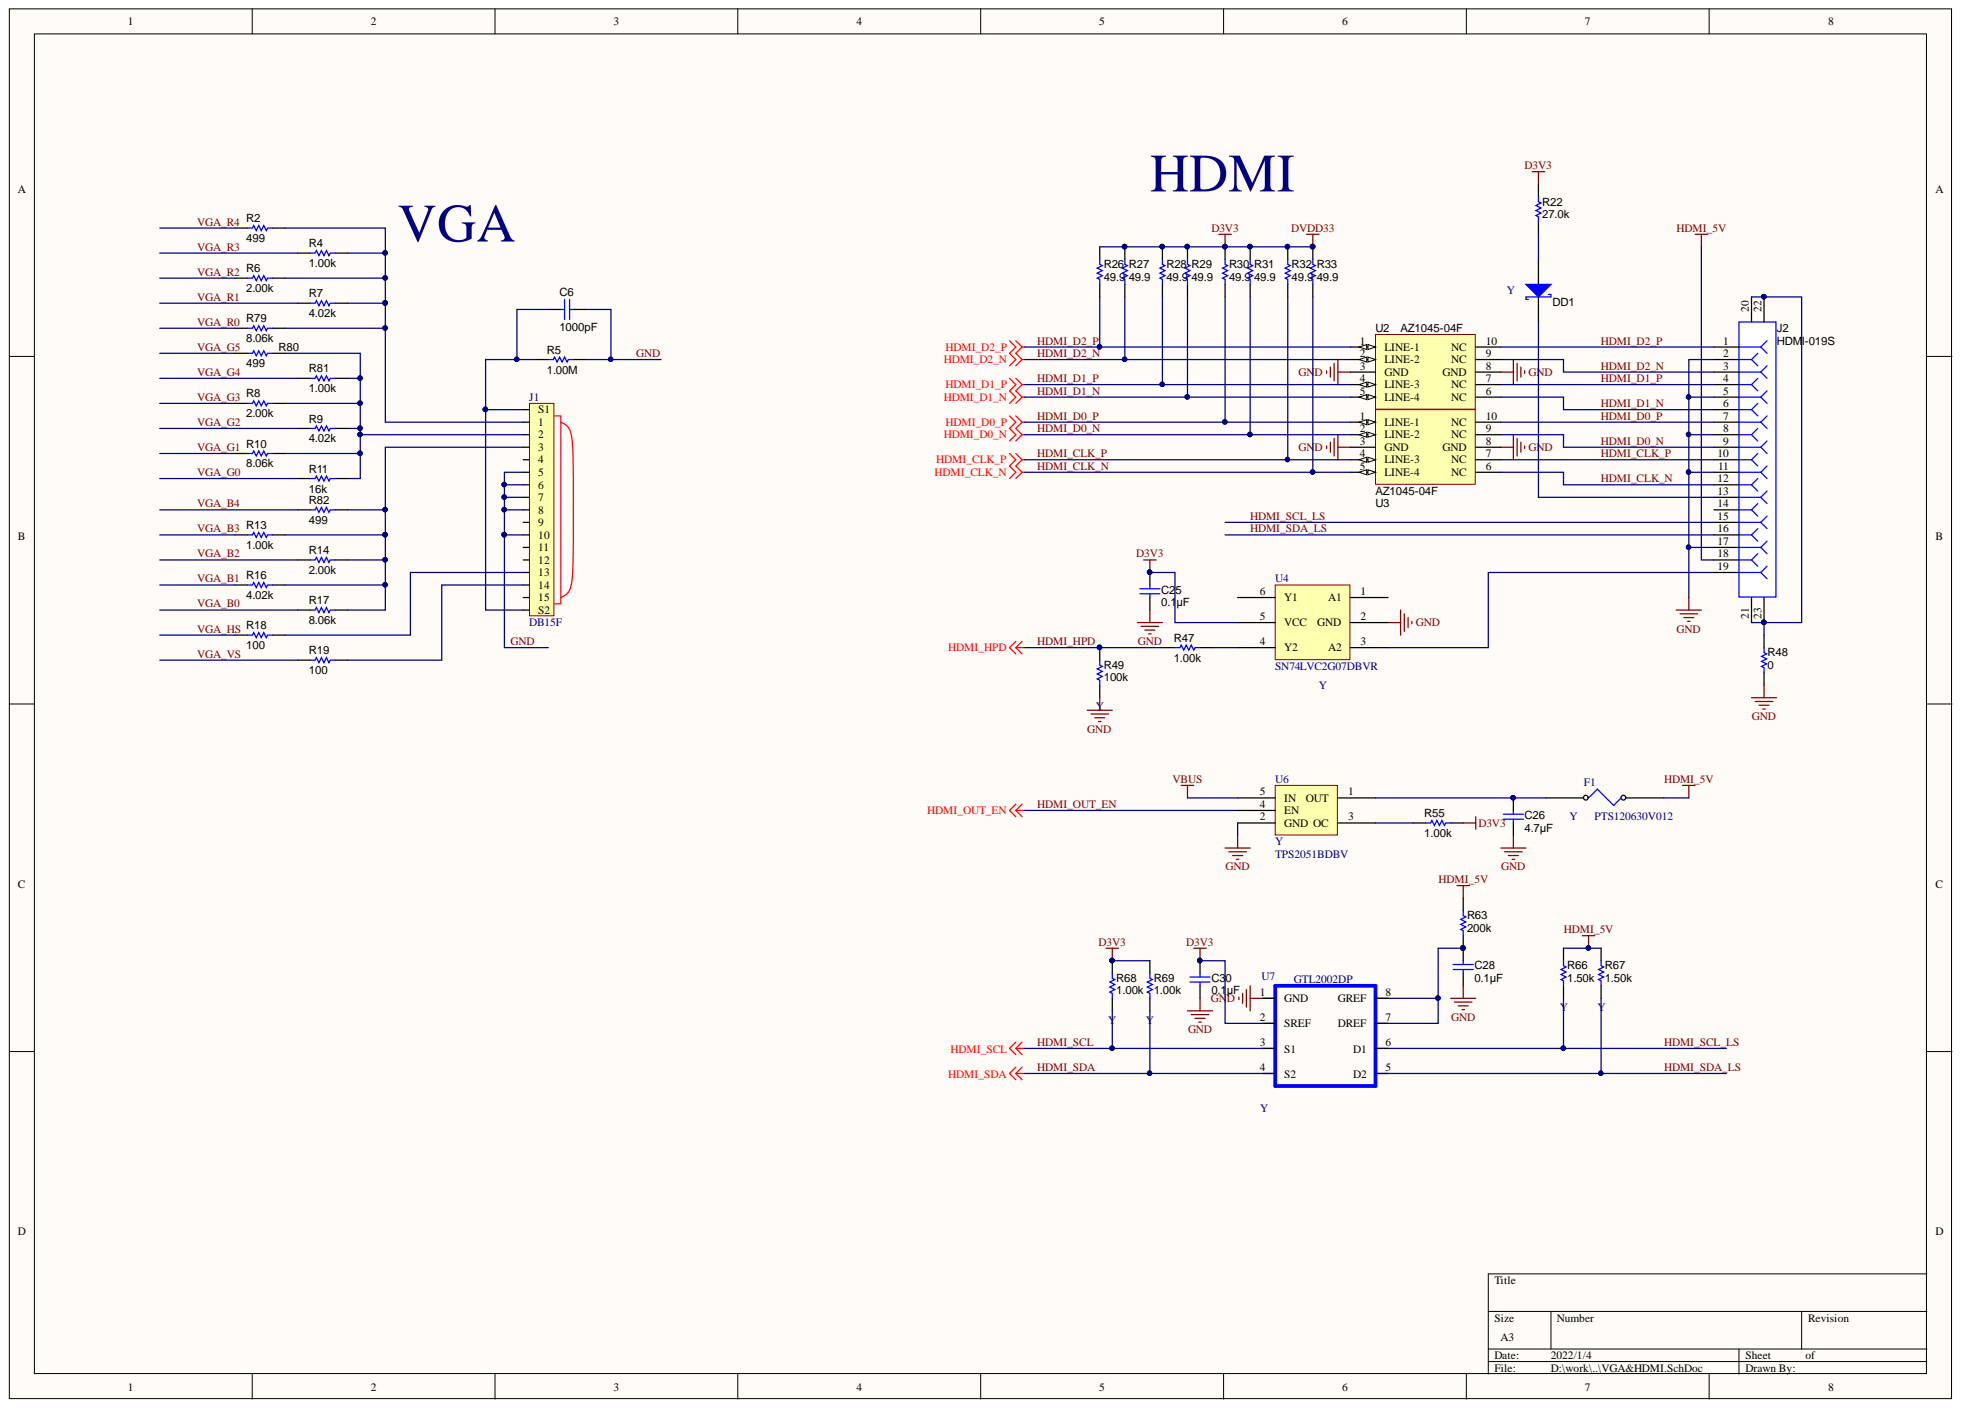
[picture p55: page 2]

6 | | 3456789

8 | G | N D H D M I_D0_N
7 | | H D M I_C L K_P | 1011

17
18

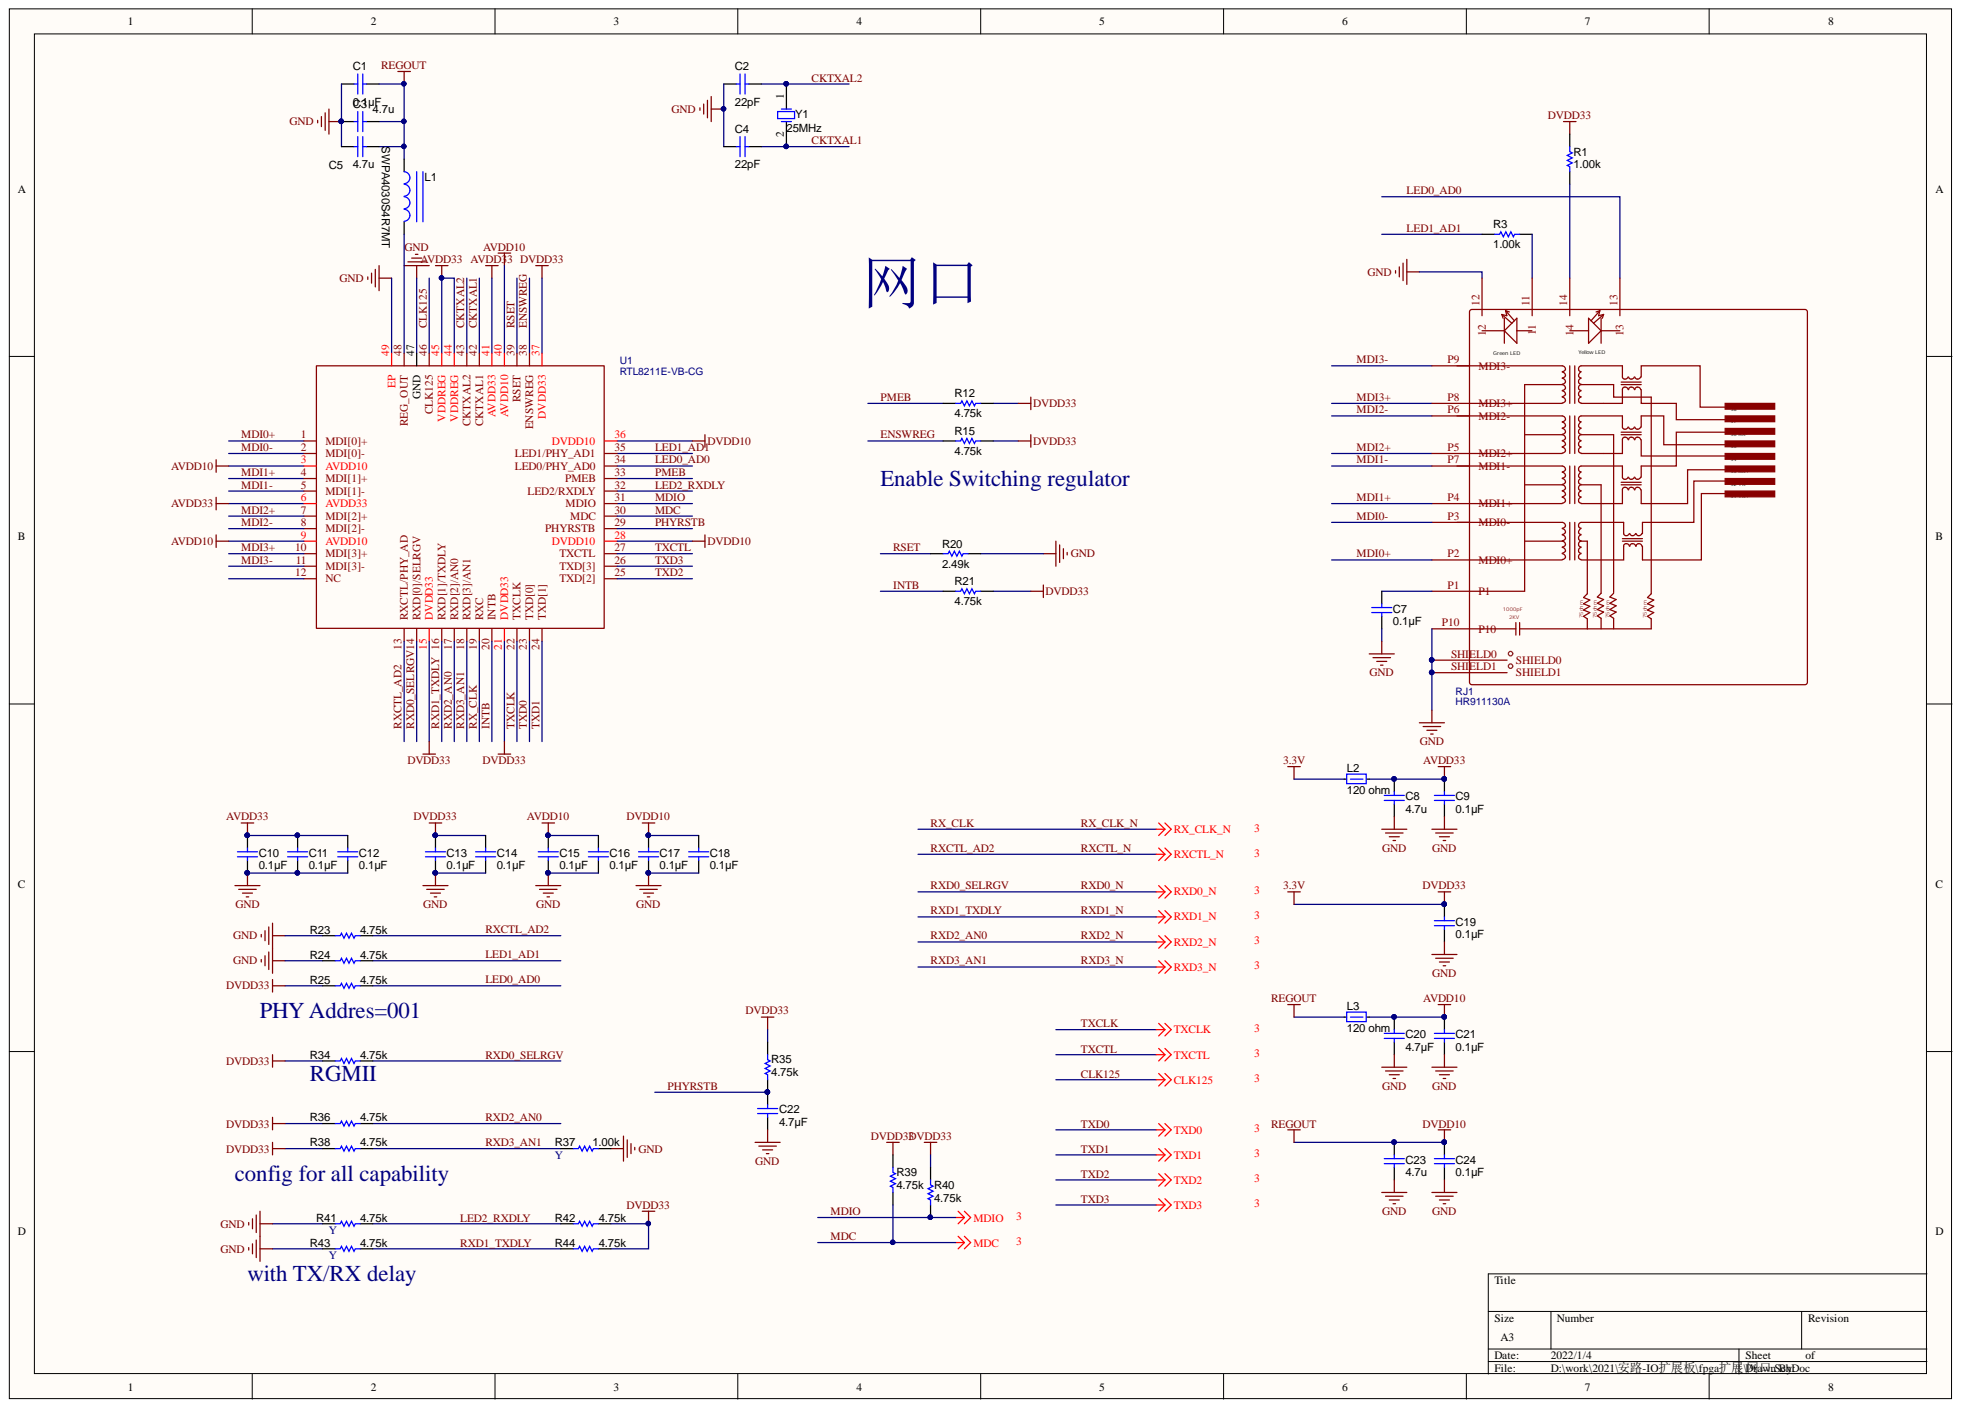
[picture p56: page 3]

with TX/RX delay
