liyuxuan3003/PrismGC/Inventor/Upload/PrismGCNew.pdf

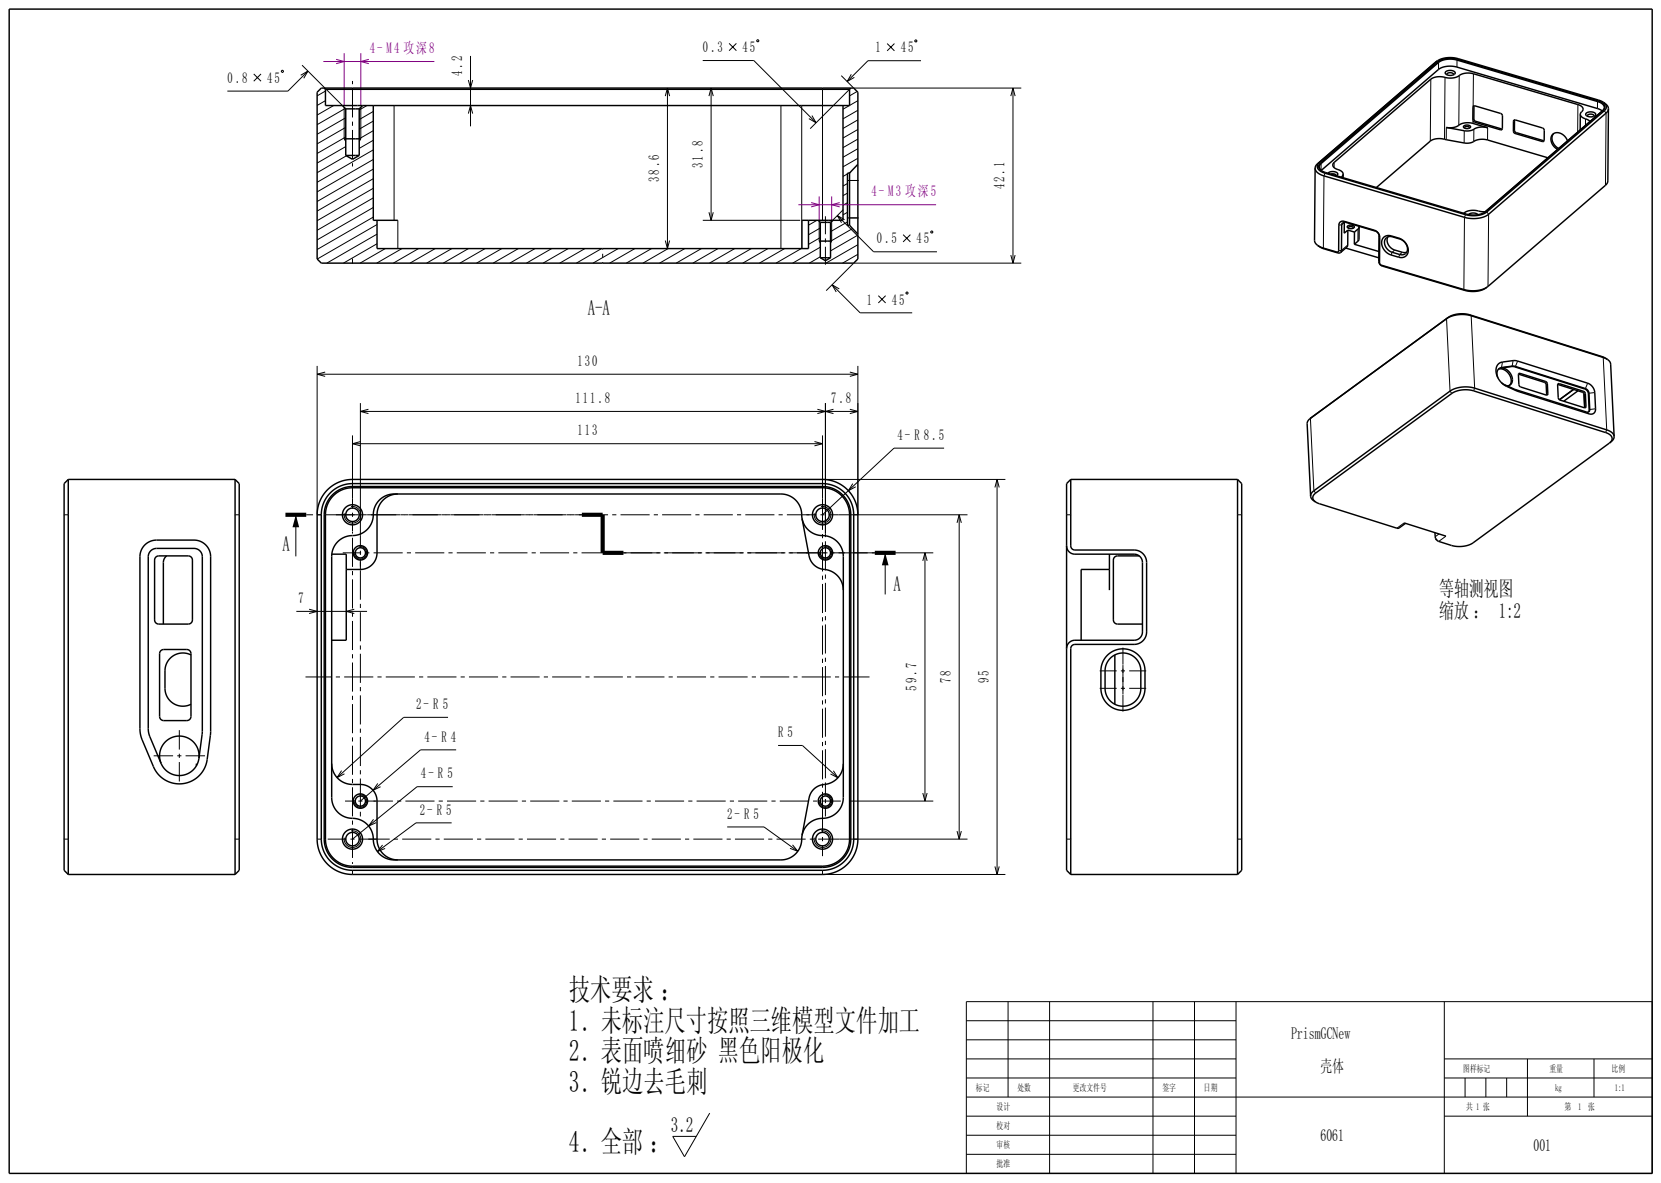
[picture p57: page 1]
1. 未标注尺寸按照三维模型文件加工 2. 表面喷细砂 黑色阳极化 3. 锐边去毛刺

PrismGCNew 壳体

图样标记 | 重量 | 比例

标记 | 处数 | 更改文件号 | 签字 | 日期 | | | kg | 1:1

校对 | | | | | | 001
审核
