liyuxuan3003/PrismGC/KiCad/Adapter/Adapter.kicad_pcb

## KiCad design KiCad/Adapter/Adapter.kicad_pcb (2023-08-06)

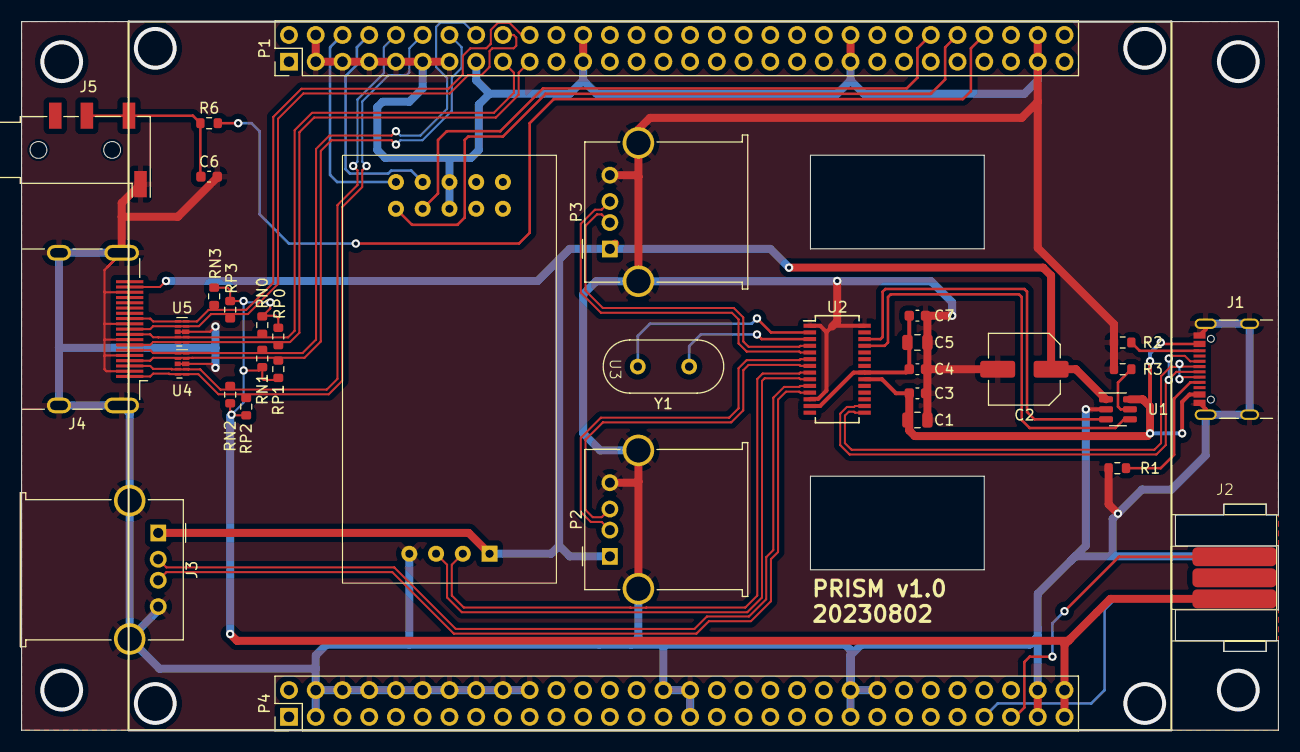
[picture p58: board Adapter.kicad_pcb from above]

Board: 2 copper layers, 119.4 x 67.3 mm, 34 parts (0 on the bottom side), 38 nets.

Parts:
C1, C5: 10uF; C_0805_2012Metric
C2: 330uF; C_Elec_6.3x5.8
C3, C4, C6: 0.1uF; C_0603_1608Metric
C7: 1uF; C_0603_1608Metric
J1: USB_C_Receptacle; USB_C_Receptacle_GCT_USB4105-xx-A_16P_TopMnt_Horizontal
J2: Nunchunk
J3: USB_A; USB_A_Molex_67643_Horizontal
J4: HDMI_A; HDMI_A_Molex_208658-1001_Horizontal
J5: AudioJack3; Jack_3.5mm_KoreanHropartsElec_PJ-320D-4A_Horizontal
P1, P4: Conn_02x30_Odd_Even_Shielded; PinHeader_2x30_P2.54mm_Vertical
P2, P3: USB_A; USB_A_Molex_67643_Horizontal
R1, R2: 5.1k; R_0603_1608Metric
R3: 47k; R_0603_1608Metric
R6: 2k; R_0603_1608Metric
RN0, RN1, RN2, RN3: 49.9; R_0603_1608Metric
RP0, RP1, RP2, RP3: 49.9; R_0603_1608Metric
U1: CH217K; SOT-23-6
U2: CH334U; SSOP-28_3.9x9.9mm_P0.635mm
U3: DAP
U4, U5: AZ1045-04F; Diodes_UDFN-10_1.0x2.5mm_P0.5mm
Y1: 12MHz; Crystal_HC49-4H_Vertical

Connections:
+3V3: J2.3 (3.3V), P4.59, P4.60, RN0.1, RN1.1, RN2.1, RN3.1, RP0.1, RP1.1, RP2.1, RP3.1
/3v3: C4.2, C5.2, C7.2, U2.13 (VDD33), U2.21 (VDD33)
/BUZ: P1.54, R6.2
/HDMI_CLK_N: J4.12 (CK-), P1.20, RN3.2, U5.5 (Line5), U5.6 (NC)
/HDMI_CLK_P: J4.10 (CK+), P1.18, RP3.2, U5.4 (Line3), U5.7 (NC)
/HDMI_D0_N: J4.9 (D0-), P1.17, RN0.2, U5.2 (Line2), U5.9 (NC)
/HDMI_D0_P: J4.7 (D0+), P1.19, RP0.2, U5.1 (Line1), U5.10 (NC)
/HDMI_D1_N: J4.6 (D1-), P1.16, RN1.2, U4.5 (Line5), U4.6 (NC)
/HDMI_D1_P: J4.4 (D1+), P1.14, RP1.2, U4.4 (Line3), U4.7 (NC)
/HDMI_D2_N: J4.3 (D2-), P1.10, RN2.2, U4.2 (Line2), U4.9 (NC)
/HDMI_D2_P: J4.1 (D2+), P1.12, RP2.2, U4.1 (Line1), U4.10 (NC)
/OVCUR: U1.3 (FLAG#), U2.26 (OVCUR#)
/PWREN: U1.4 (EN#), U2.25 (PWREN#)
/RX: P1.52, U3.1 (RX)
/SCL: J2.6 (SCL), P4.53
/SDA: J2.1 (SDA), P4.55
/SWCLK: P1.6, U3.2 (CLK)
/SWDIO: P1.8, U3.4 (DIO)
/TX: P1.50, U3.3 (TX)
/UP_D+: J1.A6 (D+), J1.B6 (D+), U2.16 (DPU)
/UP_D-: J1.A7 (D-), J1.B7 (D-), U2.15 (DMU)
/USB1_D+: J3.3 (D+), U2.11 (DP1)
/USB1_D-: J3.2 (D-), U2.10 (DM1)
/USB2_D+: U2.9 (DP2), U3.13 (D+)
/USB2_D-: U2.8 (DM2), U3.12 (D-)
/USB3_D+: P2.3 (D+), U2.7 (DP3)
/USB3_D-: P2.2 (D-), U2.6 (DM3)
/USB4_D+: P3.3 (D+), U2.5 (DP4)
/USB4_D-: P3.2 (D-), U2.4 (DM4)
/VBUS_IN: C1.1, C3.2, J1.A4 (VBUS), J1.A9 (VBUS), J1.B4 (VBUS), J1.B9 (VBUS), U1.6 (VIN), U2.20 (V5)
GND: C1.2, C2.2, C3.1, C4.1, C5.1, C6.2, C7.1, J1.A1 (GND), J1.A12 (GND), J1.B1 (GND), J1.B12 (GND), J1.S1 (SHIELD), J2.4 (GND), J3.4 (GND), J3.5 (Shield), J4.2 (D2S), J4.5 (D1S), J4.8 (D0S), J4.11 (CKS), J4.17 (GND), J4.SH, J5.S, P1.3, P1.4, P1.5, P1.7, P1.9, P1.11, P1.13, P1.15, P1.23, P1.24, P1.43, P1.44, P1.57, P1.58, P2.4 (GND), P2.5 (Shield), P3.4 (GND), P3.5 (Shield), P4.3, P4.4, P4.6, P4.8, P4.10, P4.12, P4.14, P4.16, P4.18, P4.20, P4.30, P4.31, P4.32, P4.43, P4.44, P4.46, P4.57, P4.58, R1.2, R2.2, R3.1, U1.2 (GND), U2.1 (GND), U2.12 (GND), U2.28 (GND), U3.5 (GND), U3.6 (GND), U3.14 (GND), U4.3 (GND), U4.8 (GND), U5.3 (GND), U5.8 (GND)
unnamed: C6.1, J5.R1, J5.T, R6.1
unnamed: J1.A5 (CC1), R1.1
unnamed: J1.B5 (CC2), R2.1
unnamed: R3.2, U1.5 (ISET)
unnamed: U2.3 (XI), Y1.1
unnamed: U2.2 (XO), Y1.2
VBUS: C2.1, J3.1 (VBUS), J4.18 (+5V), P2.1 (VBUS), P3.1 (VBUS), U1.1 (VOUT), U3.11 (VBUS)
