liyuxuan3003/PrismGC/PrismGC/Keil/src/BlockMap.c

#include "BlockMap.h"

MapCoord _MapCoord(int32_t i,int32_t j)
{
    MapCoord coord={i,j};
    return coord;
}

MapCoord MapCoordPlus(MapCoord a,MapCoord b)
{
    MapCoord result;
    result.i=a.i+b.i;
    result.j=a.j+b.j;
    return result;
}

MapCoord MapCoordMinus(MapCoord a,MapCoord b)
{
    MapCoord result;
    result.i=a.i-b.i;
    result.j=a.j-b.j;
    return result;
}

uint8_t MapCoordEqual(MapCoord a,MapCoord b)
{
    return (a.i==b.i && a.j==b.j);
}

MapCoord PortalAnother(MapCoord here,PortalPair portal)
{
    if(MapCoordEqual(portal.p1,here))
        return portal.p2;
    else
        return portal.p1;
}

void PortalWrite(MapCoord coord,PortalPair *portal)
{
    switch(portal->marker)
    {
        case 0: portal->p1=coord; portal->marker++; break;
        case 1: portal->p2=coord; portal->marker++; break;
        default: break;
    }
}

const LevelMap level1=
{
    {
        {B_BAR,B_BAR,B_BAR,B_BAR,B_BAR,B_BAR,B_BAR,B_BAR,B_BAR,B_BAR,B_BAR,B_BAR},
        {B_BAR,B_BAR,B_BAR,B_BAR,B_BAR,B_BAR,B_BAR,B_BAR,B_BAR,B_BAR,B_BAR,B_BAR},
        {B_BAR,B_BAR,B_BAR,B_BAR,B_BAR,B_BAR,B_BAR,B_BAR,B_BAR,B_BAR,B_BAR,B_BAR},
        {B_BAR,B_BAR,B_BAR,B_BAR,B_BAR,B_BAR,B_BAR,B_BAR,B_BAR,B_BAR,B_BAR,B_BAR},
        {B_ICE,B_ICE,B_ICE,B_ICE,B_ICE,B_BAR,B_BAR,B_ICE,B_ICE,B_ICE,B_END,B_ICE},
        {B_ICE,B_ICE,B_ICE,B_ICE,B_ICE,B_ICE,B_ICE,B_ICE,B_ICE,B_ICE,B_ICE,B_ICE},
        {B_ICE,B_ICE,B_ICE,B_ICE,B_ICE,B_ICE,B_ICE,B_ICE,B_ICE,B_ICE,B_ICE,B_ICE},
        {B_ICE,B_ICE,B_ICE,B_ICE,B_ICE,B_ICE,B_ICE,B_ICE,B_ICE,B_ICE,B_ICE,B_ICE},
        {B_BAR,B_BAR,B_BAR,B_BAR,B_BAR,B_BAR,B_BAR,B_BAR,B_BAR,B_BAR,B_BAR,B_BAR},
        {B_BAR,B_BAR,B_BAR,B_BAR,B_BAR,B_BAR,B_BAR,B_BAR,B_BAR,B_BAR,B_BAR,B_BAR},
        {B_BAR,B_BAR,B_BAR,B_BAR,B_BAR,B_BAR,B_BAR,B_BAR,B_BAR,B_BAR,B_BAR,B_BAR},
        {B_BAR,B_BAR,B_BAR,B_BAR,B_BAR,B_BAR,B_BAR,B_BAR,B_BAR,B_BAR,B_BAR,B_BAR}
    },
    {4,0},
    {{7,4},{4,4},{5,11}},
};
// RDRU L

const LevelMap level2=
{
    {
        {B_ICE,B_BAR,B_ICE,B_ICE,B_ICE,B_ICE,B_BAR,B_ICE,B_ICE,B_ICE,B_ICE,B_ICE},
        {B_ICE,B_ICE,B_ICE,B_ICE,B_ICE,B_ICE,B_ICE,B_ICE,B_ICE,B_ICE,B_ICE,B_ICE},
        {B_ICE,B_ICE,B_ICE,B_ICE,B_ICE,B_ICE,B_ICE,B_ICE,B_ICE,B_ICE,B_ICE,B_ICE},
        {B_ICE,B_ICE,B_ICE,B_ICE,B_ICE,B_BAR,B_ICE,B_ICE,B_ICE,B_ICE,B_ICE,B_ICE},
        {B_BAR,B_ICE,B_ICE,B_ICE,B_ICE,B_ICE,B_ICE,B_ICE,B_ICE,B_ICE,B_ICE,B_ICE},
        {B_ICE,B_ICE,B_ICE,B_ICE,B_ICE,B_ICE,B_ICE,B_ICE,B_ICE,B_ICE,B_ICE,B_ICE},
        {B_BAR,B_ICE,B_ICE,B_ICE,B_ICE,B_ICE,B_ICE,B_ICE,B_ICE,B_ICE,B_ICE,B_ICE},
        {B_ICE,B_ICE,B_ICE,B_ICE,B_ICE,B_ICE,B_ICE,B_ICE,B_ICE,B_ICE,B_BAR,B_ICE},
        {B_ICE,B_ICE,B_ICE,B_ICE,B_ICE,B_ICE,B_ICE,B_ICE,B_ICE,B_ICE,B_ICE,B_ICE},
        {B_ICE,B_ICE,B_ICE,B_ICE,B_ICE,B_ICE,B_ICE,B_ICE,B_ICE,B_ICE,B_ICE,B_ICE},
        {B_ICE,B_ICE,B_BAR,B_ICE,B_ICE,B_ICE,B_ICE,B_ICE,B_ICE,B_ICE,B_ICE,B_ICE},
        {B_ICE,B_ICE,B_ICE,B_ICE,B_ICE,B_ICE,B_ICE,B_END,B_ICE,B_ICE,B_ICE,B_ICE}
    },
    {0,0},
    {{3,0},{0,7},{10,7}},
};
//DRUL DRUL D

const LevelMap level3=
{
    {
        {B_ICE,B_ICE,B_ICE,B_ICE,B_BAR,B_ICE,B_ICE,B_ICE,B_ICE,B_ICE,B_ICE,B_ICE},
        {B_ICE,B_BAR,B_ICE,B_ICE,B_ICE,B_ICE,B_ICE,B_ICE,B_ICE,B_ICE,B_ICE,B_ICE},
        {B_ICE,B_ICE,B_ICE,B_ICE,B_ICE,B_ICE,B_ICE,B_ICE,B_ICE,B_ICE,B_ICE,B_ICE},
        {B_ICE,B_ICE,B_ICE,B_ICE,B_ICE,B_ICE,B_ICE,B_ICE,B_ICE,B_ICE,B_END,B_ICE},
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
        {B_ICE,B_ICE,B_ICE,B_ICE,B_ICE,B_ICE,B_ICE,B_ICE,B_ICE,B_ICE,B_ICE,B_ICE},
        {B_ICE,B_ICE,B_ICE,B_ICE,BUDIR,B_ICE,B_ICE,B_ICE,B_ICE,B_ICE,B_ICE,B_END}
    },
    {0,0},
    {{1,5},{1,11},{5,1}},
};
//DRDR LDRR UDR

const LevelMap level8=
{
    {
        {B_ICE,B_ICE,B_ICE,B_ICE,B_ICE,B_ICE,B_ICE,B_ICE,B_ICE,BDDIR,B_ICE,B_ICE},
        {B_ICE,B_ICE,B_ICE,B_ICE,B_ICE,B_ICE,B_ICE,B_ICE,B_ICE,B_ICE,B_ICE,B_ICE},
        {B_ICE,B_ICE,B_ICE,B_ICE,B_ICE,B_ICE,B_ICE,B_ICE,B_ICE,B_ICE,B_ICE,B_ICE},
        {B_ICE,BDDIR,B_ICE,B_ICE,B_BAR,B_ICE,B_ICE,B_ICE,B_ICE,B_ICE,B_ICE,B_ICE},
        {B_ICE,B_ICE,B_ICE,B_ICE,B_ICE,B_ICE,B_ICE,B_ICE,B_ICE,B_ICE,BLDIR,B_ICE},
        {B_ICE,B_ICE,B_ICE,B_ICE,B_ICE,B_ICE,BUDIR,B_ICE,B_ICE,B_ICE,B_ICE,B_ICE},
        {B_ICE,B_ICE,B_ICE,B_ICE,B_ICE,BLDIR,B_ICE,BRDIR,B_ICE,B_ICE,B_ICE,B_ICE},
        {B_ICE,BRDIR,B_ICE,B_ICE,B_ICE,B_ICE,BDDIR,B_ICE,B_ICE,B_ICE,B_ICE,B_ICE},
        {B_ICE,B_ICE,B_ICE,B_ICE,B_ICE,B_BAR,B_ICE,B_ICE,B_ICE,B_ICE,B_ICE,B_ICE},
        {B_ICE,B_ICE,B_ICE,B_ICE,B_ICE,B_ICE,B_ICE,B_ICE,B_ICE,B_ICE,B_ICE,B_ICE},
        {B_ICE,B_ICE,B_ICE,B_ICE,B_ICE,B_ICE,B_ICE,B_ICE,B_ICE,B_ICE,B_ICE,B_ICE},
        {B_END,B_ICE,B_BAR,B_ICE,B_ICE,B_ICE,B_ICE,B_ICE,B_ICE,B_ICE,B_ICE,B_ICE}
    },
    {6,6},
    {{8,3},{0,7},{7,11}},
};
//RDLU RLUL D

const LevelMap level9=
{
    {
        {B_ICE,B_ICE,B_ICE,BDDIR,B_END,B_ICE,B_ICE,B_ICE,BRDIR,B_ICE,B_ICE,B_ICE},
        {B_ICE,B_ICE,B_ICE,B_ICE,B_ICE,B_ICE,B_ICE,B_ICE,B_ICE,B_ICE,B_ICE,B_ICE},
        {B_ICE,B_ICE,B_ICE,B_ICE,B_ICE,B_ICE,B_ICE,B_ICE,B_ICE,B_ICE,B_ICE,B_ICE},
        {B_ICE,B_ICE,B_ICE,B_ICE,B_ICE,B_ICE,B_ICE,B_ICE,B_ICE,B_ICE,B_ICE,B_ICE},
        {B_ICE,B_ICE,B_ICE,B_BAR,B_ICE,B_ICE,B_ICE,B_ICE,B_ICE,B_ICE,B_ICE,B_ICE},
        {B_ICE,B_ICE,B_ICE,B_ICE,B_ICE,B_ICE,BDDIR,B_ICE,B_ICE,B_ICE,B_ICE,B_ICE},
        {B_BAR,B_ICE,B_ICE,B_ICE,B_ICE,B_ICE,B_ICE,B_ICE,B_ICE,B_ICE,B_ICE,B_ICE},
        {B_ICE,B_ICE,B_ICE,B_ICE,B_ICE,B_ICE,B_ICE,B_ICE,B_ICE,B_ICE,B_ICE,B_ICE},
        {B_ICE,B_ICE,B_ICE,B_ICE,B_ICE,B_ICE,B_ICE,B_ICE,B_ICE,B_ICE,B_ICE,B_ICE},
        {B_ICE,B_ICE,B_ICE,B_ICE,B_ICE,B_ICE,B_ICE,B_ICE,B_ICE,B_ICE,B_ICE,B_ICE},
        {B_ICE,B_ICE,B_ICE,B_ICE,B_ICE,B_ICE,B_ICE,B_ICE,B_ICE,B_ICE,B_ICE,B_ICE},
        {B_ICE,B_ICE,B_ICE,B_ICE,B_ICE,BUDIR,B_ICE,B_ICE,B_ICE,B_ICE,B_ICE,B_BAR}
    },
    {0,0},
    {{7,0},{0,10},{10,7}},
};
//DRRU RDLU DRL

const LevelMap level10=
{
    {
        {B_ICE,B_BAR,B_ICE,B_ICE,B_ICE,B_ICE,B_ICE,B_ICE,B_ICE,BLDIR,B_ICE,B_BAR},
        {B_ICE,B_ICE,B_ICE,B_ICE,B_ICE,B_ICE,B_ICE,B_ICE,B_ICE,B_ICE,B_END,B_ICE},
        {B_ICE,B_ICE,B_ICE,B_ICE,B_ICE,BDDIR,B_ICE,B_ICE,B_ICE,B_ICE,B_ICE,B_ICE},
        {B_ICE,B_ICE,B_ICE,B_BAR,B_ICE,B_ICE,B_ICE,B_ICE,B_ICE,B_ICE,B_ICE,B_ICE},
        {B_ICE,B_ICE,B_ICE,B_ICE,B_ICE,B_ICE,BLDIR,B_ICE,B_ICE,B_ICE,B_ICE,B_ICE},
        {B_ICE,B_ICE,B_ICE,B_ICE,B_ICE,B_ICE,B_ICE,B_ICE,B_ICE,B_ICE,B_ICE,B_ICE},
        {B_ICE,B_ICE,BDDIR,B_ICE,B_ICE,B_ICE,B_ICE,B_ICE,B_ICE,B_ICE,B_ICE,B_ICE},
        {B_BAR,B_ICE,BRDIR,B_ICE,B_ICE,B_ICE,B_ICE,B_ICE,B_ICE,B_ICE,B_ICE,B_ICE},
        {B_ICE,B_ICE,B_ICE,B_ICE,B_ICE,B_ICE,B_ICE,B_ICE,B_ICE,BUDIR,B_ICE,B_ICE},
        {B_ICE,B_ICE,B_ICE,B_ICE,B_ICE,B_ICE,B_ICE,B_ICE,B_ICE,B_ICE,B_ICE,B_ICE},
        {B_ICE,B_ICE,B_ICE,B_ICE,B_ICE,B_BAR,B_ICE,B_ICE,B_ICE,B_ICE,B_ICE,B_ICE},
        {B_ICE,B_ICE,B_ICE,B_ICE,B_ICE,BLDIR,B_ICE,B_ICE,B_ICE,B_ICE,B_ICE,B_ICE}
    },
    {0,0},
    {{7,3},{8,0},{1,11}},
};
//DRDL URDU L

const LevelMap level11=
{
    {
        {B_ICE,B_GRA,B_ICE,B_ICE,B_ICE,B_ICE,B_ICE,B_ICE,B_ICE,B_ICE,B_ICE,B_GRA},
        {B_GRA,B_ICE,B_ICE,B_ICE,B_ICE,B_ICE,B_ICE,B_ICE,B_ICE,B_ICE,B_GRA,B_ICE},
        {B_ICE,B_ICE,B_ICE,B_ICE,B_GRA,B_ICE,B_ICE,B_ICE,B_ICE,B_ICE,B_ICE,B_GRA},
        {B_ICE,B_ICE,B_ICE,B_ICE,B_ICE,B_ICE,B_ICE,B_ICE,B_ICE,B_ICE,B_ICE,B_ICE},
        {B_ICE,B_ICE,B_ICE,B_ICE,B_ICE,B_ICE,B_ICE,B_ICE,B_ICE,B_ICE,B_ICE,B_ICE},
        {B_ICE,BUDIR,B_ICE,B_ICE,B_ICE,B_GRA,B_END,B_ICE,B_ICE,B_ICE,B_ICE,B_ICE},
        {B_BAR,B_ICE,B_ICE,B_ICE,B_ICE,B_GRA,B_ICE,B_ICE,B_ICE,B_ICE,B_ICE,BLDIR},
        {B_ICE,B_ICE,B_ICE,B_ICE,B_ICE,B_ICE,B_ICE,B_ICE,B_ICE,B_ICE,B_ICE,B_ICE},
        {B_ICE,B_ICE,B_ICE,B_ICE,B_ICE,B_ICE,B_ICE,B_ICE,B_ICE,B_ICE,B_ICE,B_ICE},
        {B_ICE,B_ICE,BRDIR,B_ICE,B_ICE,B_ICE,B_ICE,B_ICE,B_ICE,B_ICE,B_ICE,B_ICE},
        {B_ICE,B_ICE,B_ICE,B_ICE,B_ICE,B_ICE,B_ICE,B_GRA,B_ICE,B_ICE,B_ICE,B_ICE},
        {B_ICE,B_ICE,B_ICE,B_ICE,B_ICE,B_ICE,B_ICE,B_ICE,B_ICE,BUDIR,B_ICE,B_ICE}
    },
    {5,4},
    {{0,0},{1,11},{6,10}},
};
//LULR RDDU

const LevelMap level12=
{
    {
        {B_ICE,B_ICE,B_ICE,B_ICE,B_ICE,B_GRA,B_GRA,B_ICE,B_ICE,B_ICE,B_ICE,B_ICE},
        {B_ICE,B_ICE,B_ICE,B_GRA,B_ICE,B_ICE,B_ICE,B_ICE,B_GRA,B_ICE,B_ICE,B_ICE},
        {B_ICE,B_GRA,B_ICE,B_ICE,B_ICE,B_GRA,B_GRA,B_ICE,B_ICE,B_ICE,B_GRA,B_ICE},
        {B_GRA,B_ICE,B_ICE,B_ICE,B_ICE,B_ICE,B_ICE,B_ICE,B_ICE,B_ICE,B_ICE,B_GRA},
        {B_ICE,B_ICE,B_GRA,B_ICE,B_ICE,B_ICE,B_ICE,B_ICE,B_ICE,B_GRA,B_ICE,B_ICE},
        {B_GRA,B_ICE,B_ICE,B_ICE,B_GRA,B_ICE,B_ICE,B_GRA,B_ICE,B_ICE,B_ICE,B_GRA},
        {B_ICE,B_ICE,B_GRA,B_ICE,B_GRA,B_ICE,B_ICE,B_GRA,B_ICE,B_GRA,B_ICE,B_ICE},
        {B_ICE,B_ICE,B_ICE,B_ICE,B_ICE,B_GRA,B_GRA,B_ICE,B_ICE,B_ICE,B_ICE,B_ICE},
        {B_ICE,B_ICE,B_ICE,B_ICE,B_GRA,B_ICE,B_ICE,B_GRA,B_ICE,B_ICE,B_ICE,B_ICE},
        {B_ICE,B_ICE,B_ICE,B_GRA,B_ICE,B_GRA,B_GRA,B_ICE,B_GRA,B_ICE,B_ICE,B_ICE},
        {B_ICE,B_ICE,B_GRA,B_ICE,B_GRA,B_ICE,B_ICE,B_GRA,B_ICE,B_GRA,B_ICE,B_ICE},
        {B_ICE,B_GRA,B_ICE,B_GRA,B_ICE,B_ICE,B_END,B_ICE,B_GRA,B_ICE,B_GRA,B_ICE}
    },
    {11,5},
    {{6,3},{5,6},{8,9}},
};
//UURR UULL DURD DRDD D

const LevelMap level13=
{
    {
        {B_BAR,B_ICE,B_ICE,B_BAR,B_ICE,B_ICE,B_BAR,B_ICE,B_ICE,B_BAR,B_ICE,B_ICE},
        {B_ICE,B_ICE,B_ICE,B_ICE,B_ICE,B_ICE,B_ICE,B_ICE,B_ICE,B_ICE,B_ICE,B_ICE},
        {B_ICE,B_GRA,B_GRA,B_ICE,B_GRA,B_GRA,B_ICE,B_GRA,B_GRA,B_ICE,B_GRA,B_GRA},
        {B_ICE,B_ICE,B_ICE,B_ICE,B_ICE,B_ICE,B_ICE,B_ICE,B_ICE,B_ICE,B_ICE,B_ICE},
        {B_GRA,B_ICE,B_ICE,B_GRA,B_ICE,B_ICE,B_GRA,B_ICE,B_ICE,B_GRA,B_ICE,B_ICE},
        {B_ICE,B_ICE,B_ICE,B_ICE,B_ICE,B_ICE,B_ICE,B_ICE,B_ICE,B_ICE,B_ICE,B_ICE},
        {B_ICE,B_GRA,B_GRA,B_ICE,B_GRA,B_GRA,B_ICE,B_GRA,B_GRA,B_ICE,B_GRA,B_GRA},
        {B_ICE,B_ICE,B_ICE,B_ICE,B_ICE,B_ICE,B_ICE,B_ICE,B_END,B_ICE,B_ICE,B_ICE},
        {B_ICE,B_ICE,B_GRA,B_GRA,B_GRA,B_GRA,B_GRA,B_GRA,B_GRA,B_GRA,B_ICE,B_ICE},
        {B_ICE,B_ICE,B_GRA,B_ICE,B_ICE,B_ICE,B_ICE,B_ICE,B_ICE,B_GRA,B_ICE,B_ICE},
        {B_ICE,B_ICE,B_GRA,B_ICE,B_ICE,B_ICE,B_ICE,B_ICE,B_ICE,B_GRA,B_ICE,B_ICE},
        {B_ICE,B_ICE,B_GRA,B_ICE,B_ICE,B_ICE,B_ICE,B_ICE,B_ICE,B_GRA,B_ICE,B_ICE}
    },
    {3,1},
    {{11,5},{5,5},{1,9}},
};
//DRUU LDLD DRRU U

const LevelMap level14=
{
    {
        {B_ICE,B_ICE,B_GRA,B_ICE,B_ICE,B_ICE,B_ICE,B_ICE,B_ICE,B_GRA,B_ICE,B_ICE},
        {B_ICE,B_ICE,B_GRA,B_ICE,B_ICE,BDDIR,BDDIR,B_ICE,B_ICE,B_GRA,B_ICE,B_ICE},
        {B_GRA,B_GRA,B_GRA,B_ICE,B_ICE,B_ICE,B_ICE,B_ICE,B_END,B_GRA,B_GRA,B_GRA},
        {B_ICE,B_ICE,B_ICE,B_ICE,B_ICE,B_ICE,B_ICE,B_ICE,B_ICE,B_ICE,B_ICE,B_ICE},
        {B_ICE,B_ICE,BDDIR,B_ICE,B_ICE,BLDIR,BLDIR,B_ICE,B_ICE,BDDIR,B_ICE,B_ICE},
        {B_ICE,B_ICE,B_ICE,B_ICE,BRDIR,B_ICE,B_ICE,BDDIR,B_ICE,B_ICE,B_ICE,B_ICE},
        {B_ICE,B_ICE,B_ICE,B_ICE,BRDIR,B_ICE,B_ICE,BDDIR,B_ICE,B_ICE,B_ICE,B_ICE},
        {B_ICE,B_ICE,B_GRA,B_ICE,B_ICE,BUDIR,BDDIR,B_ICE,B_ICE,B_GRA,B_ICE,B_ICE},
        {B_ICE,B_ICE,B_ICE,B_ICE,B_ICE,B_ICE,B_ICE,B_ICE,B_ICE,B_ICE,B_ICE,B_ICE},
        {B_GRA,B_GRA,B_GRA,B_ICE,B_ICE,B_ICE,B_ICE,B_ICE,B_ICE,B_GRA,B_GRA,B_GRA},
        {B_ICE,B_ICE,B_GRA,B_ICE,BLDIR,B_ICE,B_ICE,BRDIR,B_ICE,B_GRA,B_ICE,B_ICE},
        {B_ICE,B_ICE,B_GRA,B_ICE,B_ICE,B_GRA,B_GRA,B_ICE,B_ICE,B_GRA,B_ICE,B_ICE}
    },
    {10,6},
    {{3,0},{0,7},{10,7}},
};
//RRDU UULL LDDD RRRR U

const LevelMap level15=
{
    {
        {B_ICE,B_ICE,BLDIR,B_ICE,B_ICE,B_ICE,B_ICE,B_ICE,B_ICE,B_ICE,B_GRA,B_GRA},
        {B_GRA,B_ICE,B_GRA,B_ICE,B_ICE,B_ICE,B_ICE,B_ICE,B_ICE,BLDIR,B_ICE,B_ICE},
        {BUDIR,B_GRA,B_BAR,B_ICE,B_ICE,B_ICE,B_ICE,B_ICE,B_ICE,B_ICE,B_ICE,B_ICE},
        {B_ICE,B_ICE,B_ICE,B_ICE,B_ICE,B_ICE,B_ICE,B_ICE,B_ICE,B_ICE,B_ICE,B_ICE},
        {B_ICE,B_ICE,B_ICE,B_ICE,B_ICE,B_ICE,B_ICE,B_ICE,B_ICE,B_ICE,B_ICE,B_GRA},
        {B_ICE,B_ICE,B_ICE,B_ICE,B_ICE,B_GRA,B_GRA,B_ICE,B_ICE,B_ICE,B_ICE,B_ICE},
        {B_ICE,B_ICE,B_ICE,B_ICE,B_ICE,B_GRA,B_GRA,B_ICE,B_ICE,B_ICE,B_ICE,B_ICE},
        {B_GRA,B_ICE,B_ICE,B_ICE,B_ICE,B_ICE,B_ICE,B_ICE,B_ICE,B_ICE,B_ICE,B_ICE},
        {B_ICE,B_ICE,B_ICE,B_ICE,B_ICE,B_ICE,B_ICE,B_ICE,B_ICE,B_ICE,B_ICE,B_ICE},
        {B_ICE,B_ICE,B_ICE,B_ICE,B_ICE,B_ICE,B_ICE,B_ICE,B_ICE,B_BAR,B_GRA,BDDIR},
        {B_ICE,BRDIR,B_ICE,B_ICE,B_ICE,B_ICE,B_ICE,B_ICE,B_ICE,B_GRA,B_ICE,B_ICE},
        {B_ICE,B_ICE,B_ICE,B_ICE,B_ICE,BUDIR,BUDIR,B_ICE,B_ICE,BRDIR,B_ICE,B_END}
    },
    {11,0},
    {{1,1},{0,9},{10,10}},
};
//RLDU RDRU DDD

const LevelMap level16=
{
    {
        {B_ICE,B_ICE,B_ICE,B_ICE,B_ICE,B_ICE,B_ICE,B_ICE,B_ICE,B_ICE,B_ICE,B_ICE},
        {B_ICE,B_ICE,B_ICE,B_ICE,B_ICE,B_ICE,B_GRA,B_ICE,B_ICE,B_ICE,B_ICE,B_ICE},
        {B_ICE,B_ICE,B_ICE,B_ICE,B_GRA,B_ICE,B_ICE,B_ICE,B_ICE,B_ICE,B_ICE,B_ICE},
        {B_ICE,B_ICE,BDDIR,BLDIR,B_GRA,B_ICE,BLDIR,BLDIR,B_ICE,B_ICE,B_ICE,B_ICE},
        {B_ICE,B_ICE,BDDIR,BRDIR,BRDIR,B_ICE,B_GRA,BUDIR,B_ICE,B_ICE,B_ICE,B_ICE},
        {B_ICE,B_GRA,BDDIR,BUDIR,B_ICE,B_ICE,B_ICE,BUDIR,B_GRA,B_ICE,B_ICE,B_ICE},
        {B_ICE,B_ICE,B_ICE,B_ICE,B_ICE,B_END,B_ICE,B_ICE,B_ICE,B_ICE,B_ICE,B_GRA},
        {B_GRA,B_ICE,BDDIR,BDDIR,B_ICE,B_ICE,B_ICE,BUDIR,B_ICE,B_GRA,B_ICE,B_ICE},
        {B_ICE,B_ICE,BDDIR,BRDIR,BRDIR,B_ICE,B_GRA,BUDIR,B_ICE,B_ICE,B_ICE,B_ICE},
        {B_ICE,B_ICE,BRDIR,BRDIR,BRDIR,B_ICE,B_GRA,BUDIR,B_ICE,B_ICE,B_ICE,B_ICE},
        {B_ICE,B_ICE,B_ICE,B_ICE,B_ICE,B_ICE,B_GRA,B_ICE,B_ICE,B_ICE,B_ICE,B_ICE},
        {B_ICE,B_ICE,B_ICE,B_ICE,B_GRA,B_ICE,B_ICE,B_ICE,B_ICE,B_ICE,B_ICE,B_ICE}
    },
    {0,0},
    {{6,9},{11,11},{6,7}},
};
//RDLD RDLL URRD

const LevelMap level17=
{
    {
        {B_BAR,B_BAR,B_ICE,B_ICE,B_ICE,B_BAR,B_BAR,B_ICE,B_ICE,B_BAR,B_BAR,B_BAR},
        {B_ICE,B_ICE,B_ICE,B_ICE,B_ICE,B_ICE,B_ICE,B_ICE,B_ICE,B_ICE,B_BAR,B_BAR},
        {B_ICE,B_ICE,B_ICE,B_ICE,B_ICE,B_ICE,B_ICE,B_ICE,B_ICE,B_ICE,B_ICE,B_BAR},
        {B_ICE,B_ICE,B_ICE,B_ICE,B_ICE,B_ICE,B_ICE,B_ICE,B_ICE,B_ICE,B_ICE,B_ICE},
        {B_ICE,B_ICE,B_ICE,B_ICE,B_ICE,B_ICE,B_ICE,B_ICE,B_ICE,B_ICE,B_ICE,B_ICE},
        {B_ICE,B_ICE,B_ICE,B_ICE,B_ICE,B_ICE,B_ICE,B_ICE,B_ICE,B_ICE,B_ICE,B_ICE},
        {B_ICE,B_ICE,B_ICE,B_ICE,B_GRA,B_ICE,B_ICE,B_ICE,B_ICE,B_ICE,B_ICE,B_ICE},
        {B_ICE,B_ICE,B_ICE,B_ICE,B_ICE,B_ICE,B_ICE,B_ICE,B_ICE,B_ICE,B_ICE,B_ICE},
        {B_ICE,B_ICE,B_ICE,B_ICE,B_ICE,B_ICE,B_ICE,B_ICE,B_ICE,B_ICE,B_ICE,B_BAR},
        {B_ICE,B_ICE,B_ICE,B_ICE,B_ICE,B_ICE,B_ICE,B_ICE,B_ICE,B_ICE,B_ICE,B_END},
        {B_ICE,B_ICE,B_ICE,B_GRA,B_GRA,B_ICE,B_ICE,B_ICE,B_ICE,B_ICE,B_ICE,B_BAR},
        {B_BAR,B_BAR,B_BAR,B_BAR,B_BAR,B_BAR,B_BAR,B_BAR,B_BAR,B_BAR,B_BAR,B_BAR}
    },
    {6,0},
    {{0,4},{9,0},{10,2}},
};
//RULD LUDR URDR

const LevelMap level18=
{
    {
        {B_BAR,B_BAR,B_BAR,B_BAR,B_BAR,B_BAR,B_BAR,B_BAR,B_BAR,B_BAR,B_BAR,B_BAR},
        {B_BAR,B_BAR,B_BAR,B_BAR,B_BAR,B_BAR,B_BAR,B_BAR,B_BAR,B_BAR,B_BAR,B_BAR},
        {B_BAR,B_BAR,B_BAR,B_BAR,B_BAR,B_ICE,B_ICE,B_ICE,B_GRA,B_ICE,B_ICE,B_BAR},
        {B_ICE,B_ICE,B_ICE,B_ICE,B_BAR,B_ICE,B_ICE,B_ICE,B_ICE,B_ICE,B_ICE,B_ICE},
        {B_GRA,B_ICE,B_ICE,B_ICE,B_ICE,B_ICE,B_ICE,B_ICE,B_ICE,B_ICE,B_ICE,B_BAR},
        {B_ICE,B_ICE,B_ICE,B_ICE,B_ICE,B_ICE,B_ICE,B_ICE,B_ICE,B_ICE,B_GRA,B_END},
        {B_ICE,B_ICE,B_ICE,B_ICE,B_ICE,B_ICE,B_ICE,B_GRA,B_ICE,B_ICE,B_ICE,B_BAR},
        {B_ICE,B_ICE,B_ICE,B_ICE,B_ICE,B_ICE,B_ICE,B_ICE,B_ICE,B_ICE,B_ICE,B_ICE},
        {B_ICE,B_ICE,B_ICE,B_ICE,B_ICE,B_ICE,B_ICE,B_ICE,B_ICE,B_ICE,B_ICE,B_ICE},
        {B_ICE,B_ICE,B_ICE,B_ICE,B_ICE,B_ICE,B_ICE,B_ICE,B_ICE,B_ICE,B_ICE,B_ICE},
        {B_ICE,B_ICE,B_ICE,B_ICE,B_ICE,B_ICE,B_ICE,B_ICE,B_ICE,B_GRA,B_BAR,B_BAR},
        {B_ICE,B_ICE,B_ICE,B_ICE,B_ICE,B_ICE,B_GRA,B_ICE,B_ICE,B_GRA,B_ICE,B_ICE}
    },
    {2,10},
    {{2,5},{3,3},{11,5}},
};
//DLUR DRUR DR

const LevelMap level19=
{
    {
        {B_BAR,B_BAR,B_BAR,B_BAR,B_BAR,B_BAR,B_BAR,B_BAR,B_BAR,B_BAR,B_BAR,B_BAR},
        {B_BAR,B_BAR,B_BAR,B_BAR,B_BAR,B_BAR,B_BAR,B_BAR,B_BAR,B_BAR,B_BAR,B_BAR},
        {B_ICE,B_ICE,B_ICE,B_ICE,B1POR,B_ICE,B_ICE,B_ICE,B_ICE,B_ICE,B_ICE,B_END},
        {B_ICE,B_ICE,B_BAR,B_BAR,B_ICE,B_ICE,B_ICE,B_ICE,B_ICE,B_ICE,B_ICE,B_BAR},
        {B_ICE,B_ICE,B_BAR,B_BAR,B_ICE,B_ICE,B_ICE,B_ICE,B_ICE,B_ICE,B_ICE,B_BAR},
        {B_ICE,B1POR,B_ICE,B_ICE,B_ICE,B_ICE,B_ICE,B_ICE,B_ICE,B_ICE,B_ICE,B_ICE},
        {B_BAR,B_BAR,B_BAR,B_BAR,B_ICE,B_ICE,B_ICE,B_ICE,B_ICE,B_ICE,B_ICE,B_ICE},
        {B_BAR,B_BAR,B_BAR,B_BAR,B_ICE,B_ICE,B_ICE,B_ICE,B_ICE,B_ICE,B_ICE,B_ICE},
        {B_BAR,B_BAR,B_BAR,B_BAR,B_ICE,B_ICE,B_ICE,B_ICE,B_ICE,B_ICE,B_ICE,B_ICE},
        {B_BAR,B_BAR,B_BAR,B_BAR,B_ICE,B_ICE,B_ICE,B_ICE,B_ICE,B_ICE,B_ICE,B_ICE},
        {B_BAR,B_BAR,B_BAR,B_BAR,B_ICE,B_ICE,B_ICE,B_ICE,B_ICE,B_ICE,B_ICE,B_ICE},
        {B_BAR,B_BAR,B_BAR,B_BAR,B_ICE,B_ICE,B_ICE,B_ICE,B_ICE,B_ICE,B_ICE,B_ICE}
    },
    {2,1},
    {{2,0},{5,4},{11,11}},
};
//DRUL DR

const LevelMap level20=
{
    {
        {B_BAR,B_BAR,B_BAR,B_BAR,B_BAR,B_BAR,B_BAR,B_BAR,B_BAR,B_BAR,B_BAR,B_BAR},
        {B_GRA,B_ICE,B_ICE,B_ICE,B_ICE,B_ICE,B_ICE,B_ICE,B_ICE,B_ICE,B_ICE,B_BAR},
        {B_ICE,B1POR,B_ICE,B_ICE,B_BAR,B_BAR,B_BAR,B_ICE,B_ICE,B_ICE,B_ICE,B_BAR},
        {B_BAR,B_BAR,B_BAR,B_BAR,B_ICE,B_ICE,B_ICE,B_ICE,B_ICE,B_ICE,B_ICE,B_BAR},
        {B_ICE,B_ICE,B_ICE,B_ICE,B_ICE,B_ICE,B_ICE,B_GRA,B_ICE,B_ICE,B_ICE,B_BAR},
        {B_ICE,B_ICE,B_ICE,B_ICE,B_ICE,B_ICE,B_ICE,B_GRA,B_ICE,B_ICE,B_ICE,B_BAR},
        {B_ICE,B_ICE,B_ICE,B_ICE,B_ICE,B_ICE,B_ICE,B_ICE,B_ICE,B_ICE,B_GRA,B_BAR},
        {B_ICE,B_ICE,B_ICE,B_BAR,B_BAR,B_ICE,B_ICE,B_ICE,B_BAR,B_ICE,B_GRA,B_BAR},
        {B_ICE,B_ICE,B_ICE,B_BAR,B_ICE,B_ICE,B_ICE,B_BAR,B_BAR,B_ICE,B_BAR,B_BAR},
        {B_ICE,B_ICE,B_ICE,B_BAR,B_ICE,B_ICE,B_ICE,B_ICE,B_BAR,B_END,B_ICE,B_BAR},
        {B_ICE,B_ICE,B_ICE,B_ICE,B_ICE,B_ICE,B_ICE,B_ICE,B_BAR,B_ICE,B_ICE,B_BAR},
        {B_ICE,B_ICE,B_ICE,B_ICE,B_ICE,B1POR,B_ICE,B_ICE,B_BAR,B_ICE,B_ICE,B_BAR}
    },
    {9,7},
    {{1,10},{11,7},{3,5}},
};
//LDRU RLLD RULD LURU LDRD

const LevelMap level21=
{
    {
        {B3POR,B_ICE,B_ICE,B_ICE,B_BAR,B_ICE,B_ICE,B_BAR,B_ICE,B_ICE,B_ICE,B_ICE},
        {B_ICE,B_ICE,B_GRA,B_GRA,B_BAR,B_ICE,B_ICE,B_BAR,B_ICE,B_GRA,B_ICE,B_ICE},
        {B_ICE,B_ICE,B_GRA,B_ICE,B_BAR,B_ICE,B_ICE,B_BAR,B_ICE,BDDIR,B_GRA,B_ICE},
        {B_ICE,B_ICE,B_GRA,B_ICE,B_BAR,B_ICE,B_GRA,B_BAR,B_ICE,B_ICE,B_ICE,B_ICE},
        {B_BAR,B_BAR,B_BAR,B_BAR,B1POR,B_ICE,B_ICE,B2POR,B_BAR,B_BAR,B_BAR,B_BAR},
        {B_ICE,B_ICE,B_ICE,B_ICE,BUDIR,B_ICE,B_ICE,BRDIR,B_ICE,B_ICE,B_ICE,B_ICE},
        {B_ICE,B_ICE,B_ICE,B_ICE,B_ICE,B_ICE,B_ICE,B_ICE,B_ICE,B_ICE,B_ICE,B_ICE},
        {B_ICE,B_ICE,B_ICE,B_ICE,BDDIR,B_ICE,B_ICE,BDDIR,B_ICE,B_ICE,B_ICE,B_ICE},
        {B_BAR,B_BAR,B_BAR,B_BAR,B_END,B_ICE,B_ICE,B3POR,B_BAR,B_BAR,B_BAR,B_BAR},
        {B_ICE,B_ICE,B_ICE,B_ICE,B_BAR,B_GRA,B_ICE,B_BAR,B_ICE,B_ICE,B_ICE,B_ICE},
        {B_ICE,B_ICE,B_ICE,B_ICE,B_BAR,B_ICE,B_ICE,B_BAR,B_ICE,B_ICE,B_ICE,B_GRA},
        {B2POR,B_ICE,B_ICE,B_ICE,B_BAR,B_ICE,B_ICE,B_BAR,B_ICE,B_ICE,B_ICE,B1POR}
    },
    {6,5},
    {{5,2},{10,8},{2,3}},
};
//LURU LDRU LDDL RRUU L

const LevelMap level22=
{
    {
        {B_ICE,B_GRA,B_GRA,B_ICE,B_BAR,B_ICE,B_ICE,B_BAR,B_ICE,BDDIR,B_ICE,B3POR},
        {B_ICE,B_ICE,B_ICE,B_ICE,B_BAR,B_ICE,B_ICE,B_BAR,B_ICE,B_ICE,B_ICE,B_ICE},
        {B_ICE,B_ICE,B_ICE,B_ICE,B_BAR,B_ICE,B_ICE,B_BAR,B_ICE,B_ICE,B_ICE,B_ICE},
        {B_ICE,B_ICE,B_ICE,B_ICE,B_BAR,B_ICE,B_ICE,B_BAR,B_ICE,B_ICE,B_ICE,B_ICE},
        {B_ICE,B_ICE,B_ICE,B_ICE,B_BAR,B_ICE,B_ICE,B_BAR,B_ICE,B_ICE,B_ICE,B_ICE},
        {B_ICE,B2POR,BDDIR,B_ICE,B_BAR,B_GRA,B_GRA,B_BAR,B_ICE,B_ICE,B_ICE,B_ICE},
        {B_ICE,B_ICE,B_ICE,B_BAR,B_ICE,B_ICE,B_ICE,B_ICE,B_BAR,B_ICE,B_ICE,B_GRA},
        {B_ICE,B_ICE,B_BAR,B_ICE,B_ICE,BLDIR,BRDIR,B_ICE,B_ICE,B_BAR,B_ICE,B_ICE},
        {B_ICE,B_BAR,B_ICE,B_ICE,BRDIR,BRDIR,BRDIR,BDDIR,B_ICE,B_ICE,B_BAR,B_ICE},
        {B_BAR,B1POR,B_ICE,B_ICE,BRDIR,B_ICE,B_END,BDDIR,B1POR,B_ICE,B2POR,B_BAR},
        {B_ICE,B_ICE,B_ICE,B_ICE,BUDIR,BLDIR,BLDIR,BLDIR,B_ICE,B_ICE,B_ICE,B_ICE},
        {B3POR,B_ICE,B_ICE,B_ICE,B_ICE,B_ICE,B_ICE,B_ICE,B_ICE,B_ICE,B_ICE,B_GRA}
    },
    {0,5},
    {{9,5},{5,3},{1,10}},
};
//DDDL RURU RDLL URDL RUR

const LevelMap level23=
{
    {
        {B_BAR,B_ICE,B_ICE,B_ICE,B_ICE,B_ICE,B_ICE,B_ICE,B_ICE,B_ICE,B_ICE,B_BAR},
        {B_BAR,B_ICE,B_ICE,B_ICE,B_ICE,B_ICE,B_ICE,B_ICE,B_ICE,B_GRA,B_ICE,B_BAR},
        {B_GRA,B_BAR,B_ICE,B_ICE,B_ICE,B_ICE,B_ICE,B_ICE,B_ICE,B_ICE,B_BAR,B_ICE},
        {B_ICE,B_ICE,B_BAR,B_ICE,B_GRA,B_ICE,B_ICE,B_ICE,B_ICE,B_BAR,B_ICE,B_ICE},
        {B_ICE,B_ICE,B_ICE,B_BAR,B_ICE,B_ICE,B_ICE,B_ICE,B_BAR,B_ICE,B_ICE,B_ICE},
        {B_ICE,B2POR,B1POR,B_ICE,B_BAR,B1POR,B_ICE,B_BAR,B_ICE,B_ICE,B_ICE,B_ICE},
        {B_ICE,B_ICE,B_ICE,B_ICE,B_ICE,B_BAR,B_BAR,B_ICE,B_ICE,B_ICE,B_ICE,B_ICE},
        {B_ICE,B_GRA,BRDIR,BDDIR,B_ICE,B_BAR,B_BAR,B_ICE,B_ICE,B_ICE,B_ICE,B_ICE},
        {B_ICE,B_ICE,B_ICE,BDDIR,B2POR,B_BAR,B_BAR,B_ICE,B_ICE,B_ICE,B_ICE,B_ICE},
        {B_ICE,BUDIR,BLDIR,BLDIR,B_ICE,B_BAR,B_BAR,B_ICE,B_ICE,B_ICE,B_ICE,B_ICE},
        {B_ICE,B_ICE,B_ICE,B_ICE,B_ICE,B_BAR,B_BAR,B_ICE,B_ICE,B_BAR,B3POR,B_ICE},
        {B_ICE,B_ICE,B_ICE,B_ICE,B3POR,B_BAR,B_BAR,B_ICE,B_ICE,B_BAR,B_END,B_BAR}
    },
    {0,5},
    {{8,2},{0,1},{1,7}},
};
//LDRD LDRL URD

const LevelMap level24=
{
    {
        {B_ICE,B_ICE,B_ICE,B_ICE,B_BAR,B_ICE,B_ICE,B_BAR,B_ICE,B_ICE,B_GRA,B_ICE},
        {BRDIR,B_ICE,B_ICE,B_ICE,BRDIR,B_ICE,B_GRA,BRDIR,B_ICE,B_ICE,B_ICE,B_ICE},
        {BUDIR,B_ICE,B_ICE,B_ICE,B_BAR,B_ICE,B_GRA,B_BAR,B_ICE,B_ICE,B_ICE,B_ICE},
        {B_BAR,B_BAR,BUDIR,B_BAR,B_BAR,B_BAR,B_BAR,B_BAR,B_BAR,BDDIR,B_BAR,B_BAR},
        {B_ICE,B_ICE,B_ICE,B_ICE,B_BAR,B_ICE,B_ICE,B_BAR,B_ICE,B_ICE,B_GRA,B_ICE},
        {B_ICE,B_ICE,B_ICE,B_ICE,B_ICE,B_ICE,B_ICE,B_ICE,B_ICE,B_ICE,B_ICE,B_ICE},
        {B_ICE,B_ICE,BRDIR,B_ICE,B_ICE,B_ICE,B_ICE,B_END,B_ICE,BRDIR,B_ICE,B_ICE},
        {B_ICE,B_ICE,B_ICE,B_ICE,B_BAR,B_ICE,B_ICE,B_BAR,B_GRA,B_ICE,B_ICE,B_ICE},
        {B_BAR,B_BAR,BUDIR,B_BAR,B_BAR,B_BAR,B_BAR,B_BAR,B_BAR,BDDIR,B_BAR,B_BAR},
        {B_ICE,B_ICE,B_ICE,B_ICE,B_BAR,B_ICE,B_ICE,B_BAR,B_GRA,B_ICE,B_ICE,B_ICE},
        {B_ICE,B_ICE,B_ICE,B_ICE,BLDIR,B_ICE,B_ICE,BLDIR,B_ICE,B_ICE,B_ICE,B_ICE},
        {B_ICE,B_GRA,B_ICE,B_ICE,B_BAR,B_ICE,B_ICE,B_BAR,B_ICE,B_ICE,B_ICE,B_GRA}
    },
    {0,0},
    {{0,5},{10,11},{9,0}},
};
//DURD RDLU RDDL DLUR UDLU RDLU

const LevelMap level25=
{
    {
        {B_ICE,B_ICE,B_ICE,B_ICE,B_ICE,B_BAR,B_BAR,B2POR,B3POR,B_ICE,B_ICE,B_ICE},
        {B_ICE,B_ICE,B_ICE,B_ICE,B_ICE,B_BAR,B_BAR,B_ICE,B_ICE,B_ICE,B_ICE,B_ICE},
        {B_ICE,B_ICE,B_ICE,B_ICE,B_ICE,B_BAR,B_BAR,B_ICE,B_ICE,B_ICE,B_ICE,B_ICE},
        {B_ICE,B_ICE,B_ICE,B_ICE,B2POR,B_BAR,B_BAR,B_ICE,B_ICE,B_ICE,B_ICE,B_ICE},
        {B1POR,B_ICE,B_ICE,B_ICE,B_ICE,B_BAR,B_BAR,B_ICE,B_ICE,B_ICE,B_ICE,B_ICE},
        {B_BAR,B_BAR,B_BAR,B_BAR,B_BAR,B_BAR,B_BAR,B_BAR,B_BAR,B_BAR,B_BAR,B_BAR},
        {B_BAR,B_BAR,B_BAR,B_BAR,B_BAR,B_BAR,B_BAR,B_BAR,B_BAR,B_BAR,B_BAR,B_BAR},
        {B1POR,B_ICE,B_ICE,B_ICE,B_ICE,B_BAR,B_BAR,B3POR,B_ICE,B_ICE,B_BAR,B_ICE},
        {B_ICE,B_ICE,B_ICE,B_ICE,B_ICE,B_BAR,B_BAR,B_ICE,B_ICE,B_ICE,B_ICE,B_ICE},
        {B_ICE,B_ICE,B_ICE,B_ICE,B_ICE,B_BAR,B_BAR,B_ICE,B_ICE,BRDIR,B_ICE,B_ICE},
        {B_ICE,B_ICE,B_ICE,B_ICE,B_ICE,B_BAR,B_BAR,B_ICE,B_ICE,B_ICE,B_ICE,B_ICE},
        {B_ICE,B_ICE,B_ICE,B_GRA,B_ICE,B_BAR,B_BAR,B_ICE,B_GRA,B_ICE,B_ICE,B_END}
    },
    {0,0},
    {{8,2},{1,7},{8,11}},
};
//DRUL RUDR ULRD UD

const LevelMap level26=
{
    {
        {B_ICE,B_ICE,B_ICE,B_GRA,B_ICE,B_GRA,B_GRA,B_ICE,B_ICE,B_ICE,B_ICE,B1POR},
        {B_ICE,B_ICE,B_ICE,B_ICE,B_ICE,B_GRA,B_GRA,B_ICE,B_ICE,B_ICE,B_ICE,B_ICE},
        {B_ICE,B_ICE,B_ICE,B_ICE,B_ICE,B_GRA,B_GRA,B_ICE,B_ICE,B_ICE,B_ICE,B_ICE},
        {B_GRA,B_ICE,B_ICE,B_ICE,B_ICE,B_GRA,B_GRA,B_ICE,B_ICE,B_ICE,B_ICE,B_ICE},
        {B_ICE,B2POR,B1POR,B_ICE,B_ICE,B_GRA,B_GRA,B_ICE,B_ICE,B_ICE,B_ICE,B_ICE},
        {B_BAR,B_BAR,B_BAR,B_BAR,B_BAR,B_BAR,B_BAR,B_BAR,B_BAR,B_BAR,B_BAR,B_BAR},
        {B_BAR,B_BAR,B_BAR,B_BAR,B_BAR,B_BAR,B_BAR,B_BAR,B_BAR,B_BAR,B_BAR,B_BAR},
        {B2POR,B_ICE,B_ICE,B_ICE,BRDIR,BRDIR,BRDIR,BRDIR,B_ICE,B_ICE,B_ICE,B_ICE},
        {B_ICE,B_ICE,B_GRA,B_ICE,BUDIR,B_ICE,B_ICE,BDDIR,B_ICE,B_GRA,B_ICE,B_ICE},
        {B_ICE,B_GRA,B_GRA,B_ICE,BUDIR,B_ICE,B_ICE,BDDIR,B_ICE,B_GRA,B_GRA,B_ICE},
        {B_ICE,B_ICE,B_ICE,B_ICE,BUDIR,B_ICE,B_ICE,BDDIR,B_ICE,B_ICE,B_ICE,B_ICE},
        {B_ICE,B_END,B_ICE,B_ICE,BLDIR,BLDIR,BLDIR,BLDIR,B_ICE,B_ICE,B_ICE,B_GRA}
    },
    {0,0},
    {{2,2},{4,3},{8,11}},
};
//RDLL LLLD DRDD L

const LevelMap level27=
{
    {
        {B1POR,B_ICE,B_ICE,B_ICE,B_ICE,B_BAR,B_BAR,B_ICE,B_ICE,BDDIR,B_ICE,B_ICE},
        {BDDIR,B_GRA,B_ICE,B_ICE,B_ICE,B_BAR,B_BAR,B_ICE,B_ICE,B_ICE,B_ICE,B3POR},
        {B_ICE,B_ICE,BDDIR,B_ICE,B_ICE,B_BAR,B_BAR,B_ICE,B_ICE,B_ICE,B_ICE,B_ICE},
        {B_ICE,B_ICE,B_ICE,B_ICE,B_BAR,B_ICE,B_ICE,B_BAR,B_ICE,B_ICE,B_ICE,B_ICE},
        {B_ICE,BUDIR,B_ICE,B_BAR,B_GRA,B_ICE,B_ICE,B_GRA,B_BAR,B_GRA,B_ICE,B_GRA},
        {B_BAR,B_BAR,B_BAR,B_ICE,B_ICE,B1POR,B3POR,B_ICE,B_ICE,B_BAR,B_BAR,B_BAR},
        {B_BAR,B_BAR,B_BAR,B_ICE,B_ICE,B2POR,B_END,B_ICE,B_ICE,B_BAR,B_BAR,B_BAR},
        {B_ICE,B_ICE,B_ICE,B_BAR,B_GRA,B_ICE,B_ICE,B_GRA,B_GRA,B_ICE,B_ICE,B_ICE},
        {B_ICE,B_ICE,B_ICE,B_ICE,B_BAR,B_ICE,B_ICE,B_GRA,B_ICE,B_ICE,B_ICE,B_ICE},
        {B_ICE,B_ICE,B_ICE,B_ICE,B_ICE,B_BAR,B_BAR,B_ICE,B_ICE,B_ICE,B_ICE,B_ICE},
        {B_ICE,B_ICE,B_ICE,B_ICE,B_ICE,B_BAR,B_BAR,B_ICE,B_ICE,B_ICE,B_ICE,B_ICE},
        {B2POR,B_ICE,B_ICE,B_ICE,B_ICE,B_BAR,B_BAR,B_ICE,B_ICE,B_ICE,B_ICE,B_ICE}
    },
    {6,4},
    {{11,11},{11,1},{0,7}},
};
//URDL LULD RULD RRDL UULU RDRU RD

const LevelMap level28=
{
    {
        {B_BAR,B_BAR,B_BAR,B_BAR,B_BAR,B_BAR,B_BAR,B_BAR,B_BAR,B_BAR,B_BAR,B_BAR},
        {B_ICE,B_ICE,B_ICE,B_ICE,B_BAR,B_ICE,B_ICE,B_ICE,B_BAR,B_BAR,B_BAR,B_ICE},
        {B_BAR,B_ICE,B_ICE,B_ICE,B_ICE,B_ICE,B_ICE,B_ICE,B_BAR,B_GRA,B_GRA,B_ICE},
        {B_ICE,B_END,B_ICE,B_ICE,B_ICE,B_ICE,B_ICE,B_ICE,B_ICE,B_ICE,B_ICE,B_ICE},
        {B_BAR,B_ICE,B_ICE,B_ICE,B_ICE,B_ICE,B_ICE,B_ICE,B_ICE,B_ICE,B_ICE,B_ICE},
        {B_ICE,B_ICE,B_ICE,B_ICE,B_ICE,B_ICE,B_ICE,B_ICE,B_ICE,B_ICE,B_ICE,B_ICE},
        {B_ICE,B_ICE,B_ICE,B_ICE,B_ICE,B_ICE,B_ICE,B_ICE,B_ICE,B_ICE,B_ICE,B_ICE},
        {B_ICE,B_ICE,B_ICE,B_ICE,B_ICE,B_ICE,B_ICE,B_ICE,B_ICE,B_ICE,B_ICE,B_ICE},
        {B_ICE,B_ICE,B_ICE,B_ICE,B_ICE,B_ICE,B_ICE,B_ICE,B_ICE,B_ICE,B_ICE,B_ICE},
        {B_ICE,B_ICE,B_ICE,B_ICE,B_ICE,B_ICE,B_ICE,B_ICE,B_ICE,B_ICE,B_ICE,B_ICE},
        {B_ICE,B_ICE,B_ICE,B_ICE,B_ICE,B_ICE,B_ICE,B_ICE,B_ICE,B_ICE,B_ICE,B_BAR},
        {B_ICE,B_ICE,B_ICE,B_BAR,B_ICE,B_ICE,B_ICE,B_ICE,B_ICE,B_ICE,B_ICE,B_ICE}
    },
    {1,0},
    {{5,0},{11,2},{10,10}},
};
//RDLU DRUR DRUL

const LevelMap level29=
{
    {
        {B_BAR,B_BAR,B_BAR,B_BAR,B_BAR,B_BAR,B_BAR,B_BAR,B_BAR,B_BAR,B_BAR,B_BAR},
        {B_BAR,B_BAR,B_BAR,B_BAR,B_BAR,B_BAR,B_BAR,B_BAR,B_BAR,B_BAR,B_BAR,B_BAR},
        {B_BAR,B_BAR,B_ICE,B_ICE,B_ICE,B_ICE,B_ICE,B_ICE,B_ICE,B_ICE,B_GRA,B_BAR},
        {B_BAR,B_ICE,B_ICE,B_ICE,B_ICE,B_ICE,B_ICE,B_ICE,B_ICE,B_ICE,B_ICE,B_BAR},
        {B_BAR,B_ICE,B_ICE,B_ICE,B_BAR,B_BAR,B_BAR,B_ICE,B_ICE,B_ICE,B_ICE,B_BAR},
        {B_BAR,B_ICE,B_ICE,B_ICE,B_GRA,B_GRA,B_GRA,B_ICE,B_ICE,B_ICE,B_BAR,B_BAR},
        {B_BAR,B_ICE,B_ICE,B_ICE,B_ICE,B_ICE,B_GRA,B_ICE,B_ICE,B_ICE,B_ICE,B_BAR},
        {B_BAR,B_GRA,B_ICE,B_ICE,B_ICE,B_ICE,B_ICE,B_ICE,B_ICE,B_ICE,B_ICE,B_BAR},
        {B_BAR,B_ICE,B_ICE,B_ICE,B_ICE,B_ICE,B_ICE,B_BAR,B_BAR,B_END,B_BAR,B_BAR},
        {B_BAR,B_BAR,B_BAR,B_BAR,B_ICE,B_ICE,B_ICE,B_BAR,B_BAR,B_ICE,B_ICE,B_BAR},
        {B_BAR,B_BAR,B_BAR,B_BAR,B_BAR,B_BAR,B_BAR,B_BAR,B_BAR,B_BAR,B_BAR,B_BAR},
        {B_BAR,B_BAR,B_BAR,B_BAR,B_BAR,B_BAR,B_BAR,B_BAR,B_BAR,B_BAR,B_BAR,B_BAR}
    },
    {9,6},
    {{9,4},{6,2},{5,9}},
};
//LRUL URD

const LevelMap level30=
{
    {
        {B_BAR,B_BAR,B_BAR,B_BAR,B_BAR,B_BAR,B_BAR,B_BAR,B_BAR,B_BAR,B_BAR,B_BAR},
        {B_ICE,B_ICE,B_END,B_GRA,B_GRA,B_GRA,B_GRA,B_GRA,B_ICE,B_ICE,B_ICE,B_BAR},
        {B_BAR,B_BAR,B_ICE,B_BAR,B_ICE,B_ICE,B_ICE,B_ICE,B_ICE,B_ICE,B_ICE,B_BAR},
        {B_BAR,B_ICE,B_ICE,B_ICE,B_ICE,B_ICE,B_ICE,B_ICE,B_ICE,B_ICE,B_ICE,B_BAR},
        {B_BAR,B_ICE,B_ICE,B_ICE,B_ICE,B_ICE,B_ICE,B_ICE,B_ICE,B_ICE,B_ICE,B_BAR},
        {B_ICE,B_ICE,B_ICE,B_GRA,B_ICE,B_ICE,B_ICE,B_ICE,B_ICE,B_ICE,B_ICE,B_BAR},
        {B_ICE,B_ICE,B_ICE,B_ICE,B_GRA,B_ICE,B_ICE,B_ICE,B_BAR,B_BAR,B_ICE,B_BAR},
        {B_ICE,B_BAR,B_BAR,B_ICE,B_ICE,B_ICE,B_ICE,B_ICE,B_ICE,B_ICE,B_ICE,B_BAR},
        {B_ICE,B_ICE,B_ICE,B_ICE,B_ICE,B_ICE,B_ICE,B_ICE,B_ICE,B_ICE,B_ICE,B_BAR},
        {B_ICE,B_ICE,B_ICE,B_ICE,B_ICE,B_ICE,B_ICE,B_ICE,B_ICE,B_ICE,B_ICE,B_BAR},
        {B_ICE,B_ICE,B_ICE,B_ICE,B_ICE,B_ICE,B_ICE,B_ICE,B_ICE,B_ICE,B_ICE,B_BAR},
        {B_BAR,B_BAR,B_BAR,B_ICE,B_ICE,B_ICE,B_BAR,B_ICE,B_ICE,B_ICE,B_ICE,B_BAR}
    },
    {10,4},
    {{7,3},{5,8},{2,2}},
};
//ULRU LDUL LDLU RU

const LevelMap level31=
{
    {
        {B_BAR,B_BAR,B_BAR,B_ICE,B_ICE,B_ICE,B_ICE,B_ICE,B_ICE,B_ICE,B_ICE,B_ICE},
        {B_BAR,B_BAR,B_ICE,B_ICE,B_ICE,B_ICE,B_ICE,B_ICE,B_ICE,B_ICE,B_BAR,B_ICE},
        {B_BAR,B_BAR,B_ICE,B_ICE,B_ICE,B_ICE,B_ICE,B_ICE,B_ICE,B_ICE,B_ICE,B_ICE},
        {B_BAR,B_BAR,B_ICE,B_ICE,B_ICE,B_ICE,B_ICE,B_ICE,B_ICE,B_ICE,B_BAR,B_ICE},
        {B_BAR,B_BAR,B_ICE,B_ICE,B_ICE,B_ICE,B_ICE,B_ICE,B_ICE,B_ICE,B_BAR,B_ICE},
        {B_ICE,B_ICE,B_ICE,B_ICE,B_ICE,B_ICE,B_ICE,B_ICE,B_ICE,B_ICE,B_BAR,B_ICE},
        {B_BAR,B_ICE,B_ICE,B_ICE,B_ICE,B_ICE,B_ICE,B_ICE,B_ICE,B_ICE,B_BAR,B_ICE},
        {B_BAR,BUDIR,B_ICE,B_ICE,B_ICE,B_ICE,B_ICE,B_ICE,B_ICE,B_ICE,B_BAR,B_ICE},
        {B_BAR,BDDIR,B_GRA,B_GRA,B_ICE,B_ICE,B_ICE,B_ICE,B_ICE,B_ICE,B_ICE,B_ICE},
        {B_BAR,B_ICE,B_BAR,B_BAR,B_BAR,B_BAR,B_ICE,B_ICE,B_ICE,B_ICE,B_BAR,B_BAR},
        {B_BAR,B_ICE,B_ICE,B_GRA,B_ICE,B_ICE,B_ICE,B_ICE,B_ICE,B_ICE,B_BAR,B_BAR},
        {B_BAR,B_BAR,B_END,B_ICE,B_BAR,B_BAR,B_BAR,B_BAR,B_BAR,B_BAR,B_BAR,B_BAR}
    },
    {3,9},
    {{7,9},{10,9},{0,11}},
};
//LDRD URDL LRD

const LevelMap level32=
{
    {
        {B_ICE,B_ICE,B_ICE,B_BAR,B_BAR,B_BAR,B_BAR,B_GRA,B_ICE,B_ICE,B_ICE,B_BAR},
        {B_BAR,B_END,B_ICE,B_ICE,B_ICE,B_ICE,B_ICE,B_ICE,B_ICE,B_ICE,B_ICE,B_BAR},
        {B_ICE,B_ICE,B_ICE,B_ICE,B_ICE,B_ICE,B_ICE,B_ICE,B_ICE,B_ICE,B_ICE,B_BAR},
        {B_ICE,B_ICE,B_ICE,B_ICE,B_ICE,B_ICE,B_ICE,B_ICE,B_ICE,B_ICE,B_ICE,B_BAR},
        {B_ICE,B_ICE,B_ICE,B_BAR,B_BAR,B_BAR,B_BAR,B_ICE,B_ICE,B_ICE,B_ICE,B_BAR},
        {B_BAR,B_GRA,B_GRA,B_BAR,B_GRA,B_BAR,BRDIR,B_ICE,B_ICE,B_ICE,B_ICE,B_ICE},
        {B_ICE,B_ICE,B_ICE,B_ICE,B_ICE,B_ICE,B_BAR,B_ICE,B_ICE,B_ICE,B_ICE,B_ICE},
        {B_ICE,B_ICE,B_ICE,B_ICE,B_ICE,B_ICE,B_ICE,B_ICE,B_ICE,B_ICE,B_ICE,B_BAR},
        {B_ICE,B_ICE,B_ICE,B_ICE,B_ICE,B_ICE,B_ICE,B_ICE,B_ICE,B_ICE,B_ICE,B_BAR},
        {B_ICE,B_ICE,B_ICE,B_ICE,B_ICE,B_ICE,B_ICE,B_ICE,B_ICE,B_ICE,B_ICE,B_BAR},
        {B_GRA,B_ICE,B_ICE,B_ICE,B_ICE,B_ICE,B_ICE,B_GRA,B_ICE,B_ICE,B_ICE,B_BAR},
        {B_BAR,B_GRA,B_ICE,B_ICE,B_ICE,B_ICE,B_ICE,B1POR,B_BAR,B1POR,B_ICE,B_BAR}
    },
    {5,11},
    {{5,7},{1,9},{9,1}},
};
//LDLD DULD LUU

const LevelMap level33=
{
    {
        {B_BAR,B_BAR,B_BAR,B_BAR,B_BAR,B_BAR,B_BAR,B_BAR,B_BAR,B_BAR,B_BAR,B_BAR},
        {B_ICE,B_ICE,B_ICE,B_ICE,B_ICE,B_ICE,B_ICE,B_ICE,B_ICE,B_ICE,B_ICE,B_GRA},
        {B_ICE,B_ICE,B_ICE,B_ICE,B_ICE,B_ICE,B_ICE,B_ICE,B_ICE,B_ICE,B_ICE,B_GRA},
        {B_ICE,B_ICE,B_ICE,B_ICE,B_ICE,B_ICE,B_ICE,B_ICE,B_ICE,B_ICE,B_ICE,B_ICE},
        {B_ICE,B_ICE,B_ICE,B_ICE,B_BAR,B_BAR,B_BAR,B_BAR,B_ICE,B_ICE,B_ICE,B_END},
        {B_ICE,B_ICE,B_ICE,B_ICE,B_ICE,B_ICE,B_ICE,B_ICE,B_ICE,B_ICE,B_ICE,B_ICE},
        {B_ICE,B_ICE,B_ICE,B_ICE,B_ICE,B_ICE,B_ICE,B_ICE,B_ICE,B_ICE,B_ICE,B_ICE},
        {B_ICE,B_ICE,B_ICE,B_TRP,B_ICE,B_ICE,B_ICE,B_ICE,B_ICE,B_ICE,B_ICE,B_ICE},
        {B_ICE,B_ICE,B_ICE,B_TRP,B_ICE,B_ICE,B_ICE,B_ICE,B_ICE,B_ICE,B_ICE,B_ICE},
        {B_ICE,B_ICE,B_GRA,B_TRP,B_ICE,B_ICE,B_ICE,B_ICE,B_ICE,B_ICE,B_ICE,B_ICE},
        {B_BAR,B_BAR,B_BAR,B_BAR,B_BAR,B_BAR,B_BAR,B_BAR,B_BAR,B_BAR,B_BAR,B_BAR},
        {B_BAR,B_BAR,B_BAR,B_BAR,B_BAR,B_BAR,B_BAR,B_BAR,B_BAR,B_BAR,B_BAR,B_BAR}
    },
    {5,11},
    {{7,0},{1,1},{9,11}},
};
// LDUR DRU

const LevelMap level34=
{
    {
        {B_BAR,B_BAR,B_BAR,B_BAR,B_BAR,B_BAR,B_BAR,B_BAR,B_BAR,B_BAR,B_BAR,B_BAR},
        {B_ICE,B_ICE,B_BAR,B_ICE,BLDIR,B_ICE,B_ICE,B_ICE,B_ICE,B_ICE,B_ICE,B_ICE},
        {B_ICE,B_ICE,B_ICE,B_ICE,B_ICE,B_ICE,B_ICE,B_ICE,B_ICE,B_ICE,B_ICE,B_ICE},
        {B_GRA,B_ICE,B_ICE,B_ICE,B_ICE,B_ICE,B_ICE,B_ICE,B_ICE,B_ICE,B_ICE,B_ICE},
        {B_ICE,B_ICE,B_ICE,B_ICE,BUDIR,B_BAR,B_BAR,B_BAR,B_ICE,B_ICE,B_END,B_ICE},
        {B_ICE,B_ICE,B_ICE,B_BUT,BUDIR,B_ICE,B_ICE,B_ICE,B_ICE,B_ICE,B_ICE,B_ICE},
        {B_ICE,B_ICE,B_ICE,B_ICE,B_MCG,B_ICE,B_ICE,B_ICE,B_ICE,B_ICE,B_ICE,B_MCG},
        {B_ICE,B_ICE,B_ICE,B_ICE,B_GRA,B_ICE,B_ICE,B_ICE,B_ICE,B_ICE,B_ICE,B_MCG},
        {B_ICE,B_ICE,B_ICE,B_MCG,B_MCG,B_ICE,B_ICE,B_ICE,B_ICE,B_ICE,B_ICE,B_ICE},
        {B_ICE,B_ICE,B_ICE,B_ICE,B_ICE,B_ICE,B_ICE,B_ICE,B_ICE,B_ICE,B_ICE,B_ICE},
        {B_ICE,B_ICE,B_ICE,B_ICE,B_ICE,B_ICE,B_ICE,B_ICE,B_ICE,B_ICE,B_ICE,B_GRA},
        {B_BAR,B_BAR,B_BAR,B_BAR,B_BAR,B_BAR,B_BAR,B_BAR,B_BAR,B_BAR,B_BAR,B_BAR}
    },
    {5,0},
    {{1,3},{7,0},{4,0}}
};
// RDLU RDRU

const LevelMap level35=
{
    {
        {B_BAR,B_BAR,B_BAR,B_BAR,B_BAR,B_BAR,B_BAR,B_BAR,B_BAR,B_BAR,B_BAR,B_BAR},
        {B_ICE,B_ICE,B_ICE,B_ICE,B_ICE,B_ICE,B_ICE,B_ICE,B_ICE,B_ICE,B_ICE,B_ICE},
        {B_ICE,B_ICE,B_ICE,B_ICE,B_ICE,B_ICE,B_ICE,B_ICE,B_ICE,B_ICE,B_ICE,B_ICE},
        {B_ICE,B_ICE,B_ICE,B_GRA,B_BAR,B_BAR,B_BAR,B_BAR,B_ICE,B_ICE,B_END,B_ICE},
        {B_ICE,B_ICE,B_ICE,B_GRA,B_ICE,B_ICE,B_ICE,B_ICE,B_ICE,B_ICE,B_ICE,B_MCG},
        {B_ICE,B_ICE,B_ICE,B_ICE,B_ICE,B_ICE,B_ICE,B_ICE,B_ICE,B_ICE,B_ICE,B_MCG},
        {B_GRA,B_ICE,B_ICE,B_ICE,B_MCG,B_ICE,B_ICE,B_ICE,B_ICE,B_ICE,B_ICE,B_ICE},
        {B_ICE,B_ICE,B_BUT,B_ICE,B_MCG,B_TRP,B_ICE,B_ICE,B_ICE,B_ICE,B_ICE,B_ICE},
        {B_ICE,B_ICE,B_ICE,B_ICE,B_ICE,B_ICE,B_ICE,B_ICE,B_ICE,B_ICE,B_ICE,B_ICE},
        {B_ICE,B_ICE,B_ICE,B_ICE,B_ICE,B_ICE,B_ICE,B_ICE,B_ICE,B_ICE,B_ICE,B_ICE},
        {B_BAR,B_BAR,B_BAR,B_BAR,B_BAR,B_BAR,B_BAR,B_BAR,B_BAR,B_BAR,B_BAR,B_BAR},
        {B_BAR,B_BAR,B_BAR,B_BAR,B_BAR,B_BAR,B_BAR,B_BAR,B_BAR,B_BAR,B_BAR,B_BAR}
    },
    {4,0},
    {{7,0},{7,3},{9,2}}
};
// RDLU RURU

const LevelMap level36=
{
    {
        {B_ICE,B_ICE,B_MCG,B_ICE,B_ICE,B_ICE,B_MCG,B_ICE,B_ICE,B_BAR,B_ICE,B1POR},
        {B_ICE,B_ICE,B_MCG,B_ICE,B_ICE,B_ICE,B_ICE,B_ICE,B_ICE,B_BAR,B2POR,B_ICE},
        {B_MCG,B_MCG,B_MCG,B_ICE,B_ICE,B_END,B_ICE,B_ICE,B_ICE,B_BAR,B_BAR,B_BAR},
        {B_ICE,B_ICE,B_ICE,B_ICE,B_ICE,B_ICE,B_ICE,B_ICE,B_ICE,B_ICE,B_ICE,B_ICE},
        {B_ICE,B_ICE,B_ICE,B_ICE,B_ICE,B_ICE,B_ICE,B_ICE,B_ICE,B_ICE,B_ICE,B_ICE},
        {B_ICE,B_ICE,B_ICE,B_ICE,B_ICE,B_ICE,B_ICE,B_ICE,BLDIR,B_ICE,B_ICE,B_ICE},
        {B_ICE,B_ICE,B_ICE,B_ICE,B_ICE,B_ICE,B_ICE,B_ICE,B_ICE,B_ICE,B_ICE,B_ICE},
        {B_ICE,B_ICE,B_ICE,B_ICE,B_ICE,B_ICE,B_ICE,B_ICE,B_ICE,B_ICE,B_ICE,B_ICE},
        {B_ICE,B_ICE,B_ICE,B_ICE,B_ICE,B_ICE,B_ICE,B_ICE,B_ICE,B_ICE,B_ICE,B_ICE},
        {B_ICE,B_ICE,B_ICE,B_ICE,B_ICE,B_ICE,B_ICE,B_ICE,B_ICE,B_BAR,B_BAR,B_BAR},
        {B_ICE,B_ICE,B_ICE,B_ICE,B_ICE,B_ICE,B_ICE,B_ICE,B_ICE,B_BAR,B_BUT,B_ICE},
        {B1POR,B_ICE,B_ICE,B_ICE,B_ICE,B_ICE,B_ICE,B_MCG,B_ICE,B_BAR,B_ICE,B2POR}
    },
    {11,4},
    {{0,0},{3,1},{1,5}}
};
// RULR DURD LDLU RDRU DLUR DURU LURD

const LevelMap level37=
{
    {
        {B_BAR,B_BAR,B_BAR,B_BAR,B_GRA,B_ICE,B_BUT,B_BAR,B_BAR,B_ICE,B_ICE,B_ICE},
        {B_BAR,B_ICE,B_ICE,B_GRA,B_ICE,B_BAR,B_BAR,B_ICE,B_BAR,B_ICE,B_ICE,B_ICE},
        {B_BAR,B_ICE,B_ICE,B_GRA,B_ICE,B_ICE,B_ICE,B_ICE,B_BAR,B_ICE,B_ICE,B_ICE},
        {B_BAR,B_ICE,B_BAR,B_ICE,B_ICE,B_BAR,B_BAR,B_ICE,B_BAR,B_ICE,B_ICE,B_ICE},
        {B_ICE,B_ICE,B_BAR,B_ICE,B_ICE,B_ICE,B_ICE,B_ICE,B_MCG,B_ICE,B_ICE,B_ICE},
        {B_ICE,B_BAR,B_BAR,B_ICE,B_ICE,B_ICE,B_ICE,B_ICE,B_MCG,B_ICE,B_ICE,B_ICE},
        {B_ICE,B_BAR,B_ICE,B_ICE,B_ICE,B_ICE,B_ICE,B_ICE,B_MCG,B_ICE,B_ICE,B_ICE},
        {B_ICE,B_BAR,B_ICE,B_ICE,B_ICE,B_ICE,B_ICE,B_ICE,B_MCG,B_ICE,B_ICE,B_ICE},
        {B_ICE,B_BAR,B_ICE,B_ICE,B_ICE,B_BAR,B_ICE,B_ICE,B_BAR,B_ICE,B_ICE,B_ICE},
        {B_ICE,B_BAR,B_ICE,B_GRA,B_ICE,B_BAR,B_ICE,B_ICE,B_BAR,B_ICE,B_ICE,B_ICE},
        {B_ICE,B_ICE,B_ICE,B_ICE,B_ICE,B_BAR,B_ICE,B_ICE,B_BAR,B_ICE,B_ICE,B_ICE},
        {B_BAR,B_ICE,B_ICE,B_ICE,B_ICE,B_BAR,B_ICE,B_ICE,B_BAR,B_ICE,B_END,B_ICE}
    },
    {5,4},
    {{10,0},{2,5},{0,9}}
};
// UURL DLUL URUR DLRR DLUL DLUR ULDR

const LevelMap level38=
{
    {
        {B_BAR,B_BAR,B_BAR,B_BAR,B_BAR,B_BAR,B_BAR,B_BAR,B_BAR,B_BAR,B_BAR,B_BAR},
        {B_BAR,B_ICE,B_BUT,B_ICE,B_ICE,B_ICE,B_ICE,B_ICE,B_ICE,B_ICE,B1POR,B_BAR},
        {B_BAR,B_ICE,B_MCG,B_MCG,B_MCG,B_MCG,B_MCG,B_MCG,B_MCG,B_MCG,B_ICE,B_BAR},
        {B_BAR,B_ICE,B_MCG,B2POR,B_ICE,B_ICE,B_ICE,B_ICE,B_ICE,B_MCG,B_ICE,B_BAR},
        {B_BAR,B_ICE,B_MCG,B_ICE,B_GRA,B_GRA,B_GRA,B_GRA,B_ICE,B_MCG,B_ICE,B_BAR},
        {B_BAR,BRDIR,B_MCG,B_ICE,B_GRA,B_TRP,B1POR,B_GRA,B_ICE,B_MCG,B_ICE,B_BAR},
        {B_BAR,BRDIR,B_MCG,B_ICE,B_GRA,B_TRP,B_END,B_GRA,B_ICE,B_MCG,B_ICE,B_BAR},
        {B_BAR,B_ICE,B_MCG,B_ICE,B_GRA,B_GRA,B_GRA,B_GRA,B_ICE,B_MCG,B_ICE,B_BAR},
        {B_BAR,B_ICE,B_MCG,B_ICE,B2POR,B_ICE,B_ICE,B_ICE,B_ICE,B_MCG,B_ICE,B_BAR},
        {B_BAR,B_ICE,B_MCG,B_MCG,B_MCG,B_MCG,B_MCG,B_MCG,B_MCG,B_MCG,B_ICE,B_BAR},
        {B_BAR,B_ICE,B_ICE,B_ICE,B_ICE,B_ICE,B_ICE,B_ICE,B_ICE,B_ICE,B_ICE,B_BAR},
        {B_BAR,B_BAR,B_BAR,B_BAR,B_BAR,B_BAR,B_BAR,B_BAR,B_BAR,B_BAR,B_BAR,B_BAR}
    },
    {10,5},
    {{6,1},{8,4},{8,10}}
};
//LUUU RRDL UURU D

const LevelMap level39=
{
    {
        {B3POR,B_ICE,B_ICE,B_ICE,B_ICE,B_BAR,B_BAR,B_ICE,B_ICE,B_ICE,B_ICE,B2POR},
        {B_ICE,B_ICE,B_ICE,B_ICE,B_ICE,B_BAR,B_BAR,B_ICE,B_ICE,B_ICE,B_ICE,B_ICE},
        {B_ICE,B_ICE,B_ICE,B_ICE,B_ICE,B_BAR,B_BAR,B_ICE,B_ICE,B_ICE,B_ICE,B_ICE},
        {B_ICE,B_ICE,B_ICE,B_ICE,B_BUT,B_BAR,B_BAR,B_ICE,B_ICE,B_ICE,B_ICE,B_ICE},
        {B_ICE,B_ICE,B_ICE,B_ICE,B_ICE,B_BAR,B_BAR,B_ICE,B_ICE,B_ICE,B_ICE,B_ICE},
        {B_BAR,B_BAR,B_BAR,B_BAR,B_BAR,B1POR,B_ICE,B_BAR,B_BAR,B_BAR,B_BAR,B_BAR},
        {B_BAR,B_BAR,B_BAR,B_BAR,B_BAR,B2POR,B3POR,B_BAR,B_BAR,B_BAR,B_BAR,B_BAR},
        {B_ICE,B_ICE,B_ICE,B_ICE,B_ICE,B_BAR,B_BAR,B_ICE,B_ICE,B_ICE,B_ICE,B_ICE},
        {B_ICE,B_MCG,B_MCG,B_MCG,B_GRA,B_BAR,B_BAR,B_ICE,B_GRA,B_ICE,B_ICE,BLDIR},
        {B_GRA,B_MCG,B_END,B_MCG,B_ICE,B_BAR,B_BAR,B_ICE,B_ICE,B_ICE,B_ICE,B_ICE},
        {B_MCG,B_MCG,B_MCG,B_MCG,B_MCG,B_BAR,B_BAR,B_ICE,B_ICE,B_ICE,B_ICE,B_ICE},
        {B_ICE,B_ICE,B_ICE,B_ICE,B_ICE,B_GRA,B_GRA,B_ICE,B_ICE,B_ICE,B_ICE,B1POR}
    },
    {5,6},
    {{2,11},{9,4},{9,9}}
};
//DRUL DRUD LLLU RUL

const LevelMap level40=
{
    {
        {B_ICE,B_ICE,B_ICE,B_ICE,B_ICE,B_ICE,B_ICE,B_ICE,B_ICE,B_ICE,B_ICE,B_ICE},
        {B_ICE,B_BAR,B_BAR,B_BAR,B_BAR,B_BAR,B_BAR,B_BAR,B_BAR,B_BAR,B_BAR,B_ICE},
        {B_ICE,B_BAR,B_ICE,B_ICE,B_ICE,B_ICE,B_ICE,B_ICE,B_ICE,B_ICE,B_BAR,B_ICE},
        {B_ICE,B_BAR,B_ICE,B_BAR,B_BAR,B_BAR,B_BAR,B_BAR,B_BAR,B_ICE,B_BAR,B_ICE},
        {B_ICE,B_BAR,B_ICE,B_BAR,B_BUT,B_ICE,B_ICE,B_ICE,B_ICE,B_ICE,B_BAR,B_ICE},
        {B_ICE,B_BAR,B_ICE,B_BAR,B_BAR,B_BAR,B_BAR,B_BAR,B_BAR,B_BAR,B_BAR,B_ICE},
        {B_ICE,B_BAR,B_ICE,B_END,B_GRA,B_ICE,B_ICE,B_ICE,B_ICE,B_ICE,B_ICE,B_ICE},
        {B_ICE,B_BAR,B_ICE,B_ICE,B_ICE,B_ICE,B_ICE,B_ICE,B_ICE,B_ICE,B_ICE,B_ICE},
        {B_ICE,B_BAR,B_GRA,B_ICE,B_ICE,B_ICE,B_ICE,B_ICE,B_ICE,B_ICE,B_ICE,B_ICE},
        {B_ICE,B_BAR,B1POR,B_ICE,B_ICE,B_ICE,B_ICE,B_ICE,B_ICE,B_ICE,B_GRA,B_ICE},
        {B_ICE,B_BAR,B_ICE,B_ICE,B_ICE,B_ICE,B_ICE,B_ICE,B_ICE,B_GRA,B_ICE,B_ICE},
        {B_ICE,B_BAR,B_TRP,B_MCG,B_ICE,B_ICE,B_ICE,B_ICE,B_ICE,B1POR,B_ICE,B_ICE}
    },
    {11,0},
    {{4,5},{9,8},{7,7}}
};
//URDL RLUL URDL RLRU LDRL DLUL

const LevelMap level41=
{
    {
        {B_BAR,B_BAR,B_BAR,B_BAR,B_BAR,B_BAR,B_BAR,B_BAR,B_BAR,B_BAR,B_BAR,B_BAR},
        {B_BUT,B_ICE,B_ICE,B_ICE,B_ICE,B_ICE,B_ICE,B_ICE,B_ICE,B_ICE,B_ICE,B1POR},
        {B_BAR,B_BAR,B_BAR,B_BAR,B_BAR,B_BAR,B_BAR,B_BAR,B_BAR,B_BAR,B_BAR,B_BAR},
        {B_ICE,B_ICE,B_ICE,B_ICE,B_ICE,B_ICE,B_ICE,B_ICE,B_ICE,B_ICE,B_ICE,B_ICE},
        {B_BAR,B_BAR,B_BAR,B_BAR,B_BAR,B_BAR,B_BAR,B_BAR,B_BAR,B_BAR,B_BAR,B_BAR},
        {B_ICE,B_ICE,B_ICE,B_ICE,B_ICE,B_ICE,B_ICE,B_ICE,B_ICE,B_ICE,B_ICE,B_ICE},
        {B_BAR,B_BAR,B_BAR,B_BAR,B_BAR,B_BAR,B_BAR,B_BAR,B_BAR,B_BAR,B_BAR,B_BAR},
        {B1POR,B_ICE,B_ICE,B_ICE,B_ICE,B_ICE,B_MCG,B_ICE,B_ICE,B2POR,B_GRA,B_END},
        {B_BAR,B_BAR,B_BAR,B_BAR,B_BAR,B_BAR,B_BAR,B_BAR,B_BAR,B_BAR,B_BAR,B_MCG},
        {B3POR,B_ICE,B_ICE,B_ICE,B_ICE,B_ICE,B_ICE,B_ICE,B_GRA,B_ICE,B_GRA,B3POR},
        {B_BAR,B_BAR,B_BAR,B_BAR,B_MCG,B_BAR,B_BAR,B_BAR,B_BAR,B_BAR,B_BAR,B_BAR},
        {B_ICE,B_ICE,B_ICE,B_GRA,B_ICE,B_ICE,B_ICE,B_ICE,B_ICE,B_ICE,B_ICE,B2POR}
    },
    {1,2},
    {{1,9},{7,5},{7,11}}
};
//LRLU LU

const LevelMap level42=
{
    {
        {B_ICE,B_ICE,B_ICE,B_ICE,B_GRA,B_ICE,B_ICE,B_BAR,B_ICE,B_ICE,B_ICE,B_ICE},
        {B_ICE,B_ICE,B_ICE,B_ICE,B_GRA,B_ICE,B_ICE,B_BAR,B_ICE,B_ICE,B_ICE,B_ICE},
        {B_ICE,B_ICE,B_ICE,B_ICE,B_GRA,B_ICE,B_ICE,B_BAR,B_ICE,B_ICE,B_ICE,B_ICE},
        {B_ICE,B_ICE,B_ICE,B_ICE,B_GRA,B_ICE,B_ICE,B_BAR,B_ICE,B_ICE,B_ICE,B1POR},
        {B_GRA,B_GRA,B_GRA,B_GRA,B_TRP,B_TRP,B_TRP,B_TRP,B_BAR,B_BAR,B_BAR,B_BAR},
        {B_ICE,B_ICE,B_ICE,B_ICE,B_TRP,B1POR,B3POR,B_TRP,B_ICE,B_ICE,B_ICE,B_ICE},
        {B_ICE,B_ICE,B_ICE,B_ICE,B_TRP,B2POR,B_END,B_TRP,B_ICE,B_ICE,B_ICE,B_ICE},
        {B_GRA,B_GRA,B_GRA,B_GRA,B_TRP,B_TRP,B_TRP,B_TRP,B_BAR,B_BAR,B_BAR,B_BAR},
        {B_ICE,B_ICE,B_ICE,B2POR,B_GRA,B_ICE,B_ICE,B_BAR,B_ICE,B_ICE,B_ICE,B_ICE},
        {B_ICE,B_ICE,B_ICE,B_ICE,B_GRA,B_ICE,B_ICE,B_BAR,B_ICE,B_ICE,B_ICE,B_ICE},
        {B_ICE,B_ICE,B_ICE,B_ICE,B_GRA,B_ICE,B_ICE,B_BAR,B_ICE,B_ICE,B_ICE,B_ICE},
        {B_ICE,B_ICE,B_ICE,B_ICE,B_GRA,B_ICE,B_ICE,B_BAR,B3POR,B_ICE,B_ICE,B_ICE}
    },
    {0,0},
    {{11,1},{0,8},{11,11}}
};
//DDDR ULDR ULD

const LevelMap level43=
{
    {
        {B_BAR,B_BAR,B_BAR,B_BAR,B_BAR,B1POR,B2POR,B_BAR,B_BAR,B_BAR,B_BAR,B_BAR},
        {B_BAR,B_ICE,B_BUT,B_ICE,B_BAR,B_ICE,B_ICE,B_BAR,B_ICE,B_ICE,B2POR,B_BAR},
        {B_BAR,B_ICE,B_ICE,B_ICE,B_BAR,B_ICE,B_ICE,B_BAR,B_ICE,B_ICE,B_ICE,B_BAR},
        {B_BAR,B_ICE,B_ICE,B_ICE,B_BAR,B_ICE,B_ICE,B_BAR,B_ICE,B_ICE,B_ICE,B_BAR},
        {B_BAR,B_ICE,B_ICE,B_ICE,B_BAR,B_GRA,B_GRA,B_BAR,B_ICE,B_ICE,B_ICE,B_BAR},
        {B_BAR,B_ICE,B_ICE,B_ICE,B_BAR,B_ICE,B_ICE,B_BAR,B_ICE,B_ICE,B_ICE,B_BAR},
        {B_BAR,B_ICE,B_ICE,B_ICE,B_BAR,B_ICE,B_ICE,B_BAR,B_ICE,B_ICE,B_ICE,B_BAR},
        {B_BAR,B_ICE,B_ICE,B_ICE,B_BAR,B_MCG,B_MCG,B_BAR,B_ICE,B_ICE,B_ICE,B_BAR},
        {B_BAR,B_ICE,B_ICE,B_ICE,B_BAR,B_ICE,B_ICE,B_BAR,B_ICE,B_ICE,B_ICE,B_BAR},
        {B_BAR,B_ICE,B_ICE,B_ICE,B_BAR,B_ICE,B_ICE,B_BAR,B_ICE,B_ICE,B_ICE,B_BAR},
        {B_BAR,B_ICE,B_ICE,B1POR,B_BAR,B_ICE,B_ICE,B_BAR,B_ICE,B_ICE,B_ICE,B_BAR},
        {B_BAR,B_BAR,B_BAR,B_BAR,B_BAR,B_ICE,B_END,B_BAR,B_BAR,B_BAR,B_BAR,B_BAR}
    },
    {1,1},
    {{10,2},{11,5},{10,10}}
};
//DRDU LURD DR

const LevelMap level44=
{
    {
        {B1POR,B_ICE,B_ICE,B_ICE,B_ICE,B_BAR,B_BAR,B_ICE,B_ICE,B_ICE,B_ICE,B_END},
        {B_ICE,B_ICE,B_ICE,B_ICE,B_BAR,B_ICE,B_ICE,B_BAR,B_ICE,B_ICE,B_ICE,B_ICE},
        {B_ICE,B_ICE,B_ICE,B_BAR,B_ICE,B_ICE,B_ICE,B_ICE,B_BAR,B_ICE,B_ICE,B_ICE},
        {B_ICE,B_ICE,B_BAR,B_GRA,B_GRA,B_GRA,B_GRA,B_GRA,B_GRA,B_BAR,B_ICE,B_ICE},
        {B_ICE,B_BAR,B_ICE,B_GRA,B1POR,B_ICE,B_ICE,B_ICE,B_GRA,B_ICE,B_MCG,B_ICE},
        {B_BAR,B_ICE,B_ICE,B_GRA,B_ICE,B_ICE,B_ICE,B_ICE,B_GRA,B_ICE,B_ICE,B_BAR},
        {B_BAR,B_ICE,B_ICE,B_GRA,B_ICE,B_ICE,B_ICE,B_ICE,B_GRA,B_ICE,B_ICE,B_BAR},
        {B_ICE,B_BAR,B_ICE,B_GRA,B2POR,B_ICE,B_ICE,B3POR,B_GRA,B_ICE,B_MCG,B_ICE},
        {B_ICE,B_ICE,B_BAR,B_GRA,B_GRA,B_GRA,B_GRA,B_GRA,B_GRA,B_BAR,B_ICE,B_ICE},
        {B_ICE,B_ICE,B_ICE,B_BAR,B_ICE,B_ICE,B_ICE,B_ICE,B_BAR,B_ICE,B_ICE,B_ICE},
        {B_ICE,B_ICE,B_ICE,B_ICE,B_BAR,B_ICE,B_ICE,B_BAR,B_ICE,B_ICE,B_ICE,B_ICE},
        {B2POR,B_ICE,B_ICE,B_ICE,B_BUT,B_BAR,B_BAR,B_ICE,B_ICE,B_ICE,B_ICE,B3POR}
    },
    {5,5},
    {{0,4},{7,0},{4,9}}
};
//ULRL DUDR UDLR LRUL URU

const LevelMap level45=
{
    {
        {B_BAR,B_BAR,B_BAR,B_BAR,B_BAR,B_BAR,B_BAR,B_BAR,B_BAR,B_BAR,B_BAR,B_BAR},
        {B_BAR,B_BAR,B_BAR,B_BAR,B_BAR,B_BAR,B_BAR,B_BAR,B_BAR,B_BAR,B_BAR,B_BAR},
        {B_BAR,B_BAR,B_BAR,B_BAR,B_BAR,B_BAR,B_BAR,B_BAR,B_BAR,B_BAR,B_BAR,B_BAR},
        {B_BAR,B_BAR,B_BAR,B_BAR,B_BAR,B_BAR,B_BAR,B_BAR,B_BAR,B_BAR,B_BAR,B_BAR},
        {B_ICE,B_ICE,B_ICE,B_ICE,B_GRA,B_GRA,B_ICE,B_ICE,B_ICE,B_ICE,B_BUT,B_ICE},
        {B_ICE,B_ICE,B_ICE,B_ICE,B_ICE,B_ICE,B_ICE,B_ICE,B_ICE,B_ICE,B_ICE,B_ICE},
        {B_ICE,B_ICE,B_ICE,B_ICE,B_ICE,B_ICE,B_ICE,B_ICE,B_ICE,B_ICE,B_END,B_ICE},
        {B_ICE,B_ICE,B_ICE,B_ICE,B_ICE,B_MCG,B_ICE,B_ICE,B_ICE,B_ICE,B_ICE,B_MCG},
        {B_BAR,B_BAR,B_BAR,B_BAR,B_BAR,B_BAR,B_BAR,B_BAR,B_BAR,B_BAR,B_BAR,B_BAR},
        {B_BAR,B_BAR,B_BAR,B_BAR,B_BAR,B_BAR,B_BAR,B_BAR,B_BAR,B_BAR,B_BAR,B_BAR},
        {B_BAR,B_BAR,B_BAR,B_BAR,B_BAR,B_BAR,B_BAR,B_BAR,B_BAR,B_BAR,B_BAR,B_BAR},
        {B_BAR,B_BAR,B_BAR,B_BAR,B_BAR,B_BAR,B_BAR,B_BAR,B_BAR,B_BAR,B_BAR,B_BAR}
    },
    {4,0},
    {{7,0},{5,4},{4,11}}
};
//DRUR ULRD L

const LevelMap level46=
{
    {
        {B_ICE,B_ICE,B_GRA,B_GRA,B_ICE,B_BAR,B_BAR,B_ICE,B_GRA,B_GRA,B_ICE,B2POR},
        {B_ICE,B_ICE,B_ICE,B_ICE,B_BAR,B_ICE,B_ICE,B_BAR,B_ICE,B_ICE,B_ICE,B_ICE},
        {B_ICE,B_ICE,B_ICE,B_BAR,B_ICE,B_ICE,B_ICE,B_ICE,B_BAR,B_ICE,B_ICE,B_ICE},
        {B_ICE,B_ICE,B_ICE,B_GRA,B_TRP,B_ICE,B_ICE,B_TRP,B_GRA,B_ICE,B_ICE,B_ICE},
        {B_ICE,B_ICE,B_ICE,B_MCG,B_ICE,B_ICE,B_ICE,B_ICE,B_MCG,B_ICE,B_ICE,B_ICE},
        {B_ICE,B_ICE,B_ICE,B_MCG,B_ICE,B_END,B1POR,B_ICE,B_MCG,B_ICE,B_ICE,B_GRA},
        {B_ICE,B_ICE,B_ICE,B_MCG,B_ICE,B3POR,B2POR,B_ICE,B_MCG,B_ICE,B_ICE,B_GRA},
        {B_ICE,B_ICE,B_ICE,B_MCG,B_ICE,B_ICE,B_ICE,B_ICE,B_MCG,B_ICE,B_ICE,B_ICE},
        {B_ICE,B_ICE,B_ICE,B_GRA,B_TRP,B_ICE,B_ICE,B_TRP,B_GRA,B_ICE,B_ICE,B_ICE},
        {B_ICE,B_ICE,B_ICE,B_BAR,B_ICE,B_ICE,B_ICE,B_ICE,B_BAR,B_ICE,B_ICE,B_ICE},
        {B_ICE,B_ICE,B_ICE,B_ICE,B_BAR,B_ICE,B_ICE,B_BAR,B_ICE,B_ICE,B_ICE,B_ICE},
        {B1POR,B_ICE,B_ICE,B_GRA,B_ICE,B_BAR,B_BAR,B_BUT,B_ICE,B_ICE,B_ICE,B3POR}
    },
    {0,0},
    {{11,2},{4,11},{0,10}}
};
//RDRU LDLU URLD LRDU RDL

const LevelMap level47=
{
    {
        {B_BAR,B_BAR,B_BAR,B_BAR,B_BAR,B_BAR,B_BAR,B_BAR,B_BAR,B_BAR,B_BAR,B_BAR},
        {B_BAR,B_BAR,B_BAR,B_BAR,B_BAR,B_BAR,B_BAR,B_BAR,B_BAR,B_BAR,B_BAR,B_BAR},
        {B_BAR,B_BAR,B_BAR,B_BAR,B_BAR,B_BAR,B_BAR,B_BAR,B_BAR,B_BAR,B_BAR,B_BAR},
        {B_BAR,B_BAR,B_ICE,B_ICE,B_ICE,B_ICE,B_ICE,B1POR,B_BAR,B_BAR,B_BAR,B_BAR},
        {B_BAR,B_BAR,B_ICE,B2POR,B_BAR,B_BAR,B_BAR,B_ICE,B_TRP,B_BAR,B_BAR,B_BAR},
        {B_BAR,B_BAR,B_BAR,B_BAR,B_ICE,B_ICE,B_ICE,B_ICE,B_ICE,B_BAR,B_BAR,B_BAR},
        {B_BAR,B_BAR,B2POR,B_BUT,B_ICE,B_MCG,B_ICE,B_ICE,B_GRA,B_BAR,B_BAR,B_BAR},
        {B_BAR,B_BAR,B_ICE,B_BAR,B_ICE,B_ICE,B_BAR,B_ICE,B_BAR,B_BAR,B_BAR,B_BAR},
        {B_BAR,B_BAR,B_ICE,B_BAR,B_ICE,B_ICE,B_BAR,B_END,B_ICE,B_BAR,B_BAR,B_BAR},
        {B_BAR,B_BAR,B1POR,B_ICE,B_ICE,B_GRA,B_BAR,B_ICE,B_ICE,B_BAR,B_BAR,B_BAR},
        {B_BAR,B_BAR,B_BAR,B_BAR,B_BAR,B_BAR,B_BAR,B_BAR,B_BAR,B_BAR,B_BAR,B_BAR},
        {B_BAR,B_BAR,B_BAR,B_BAR,B_BAR,B_BAR,B_BAR,B_BAR,B_BAR,B_BAR,B_BAR,B_BAR}
    },
    {8,5},
    {{3,2},{5,4},{6,7}}
};
// LUDL DRD

const LevelMap level48=
{
    {
        {B_BAR,B_BAR,B_BAR,B_BAR,B_BAR,B_BAR,B_BAR,B_BAR,B_BAR,B_BAR,B_BAR,B_BAR},
        {B_BAR,B_BAR,B_BAR,B_BAR,B_BAR,B_BAR,B_BAR,B_BAR,B_ICE,B_BAR,B_BAR,B_BAR},
        {B_BAR,B_BAR,B_ICE,B_TRP,B_MCG,B_MCG,B_ICE,B_ICE,B_ICE,B_GRA,B_BAR,B_BAR},
        {B_BAR,B_BAR,B_ICE,B_END,B_ICE,B_ICE,B_ICE,B_ICE,B_ICE,B_BAR,B_BAR,B_BAR},
        {B_BAR,B_BAR,B_BAR,B_ICE,B_ICE,B_ICE,B_ICE,B_ICE,B_ICE,B_BAR,B_BAR,B_BAR},
        {B_BAR,B_BAR,B_ICE,B_ICE,B_ICE,B_ICE,B_ICE,B_ICE,B_ICE,B_ICE,B_BAR,B_BAR},
        {B_BAR,B_BAR,B_ICE,B_ICE,B_ICE,B_ICE,B_ICE,B_ICE,B_ICE,B_ICE,B_BAR,B_BAR},
        {B_BAR,B_BAR,B_BAR,B_BAR,B_ICE,B_ICE,B_ICE,B_ICE,B_ICE,B_ICE,B_BAR,B_BAR},
        {B_BAR,B_BAR,B_ICE,B_ICE,B_ICE,B_ICE,B_GRA,B_ICE,B_BAR,B_BAR,B_BAR,B_BAR},
        {B_BAR,B_BAR,B_BUT,B_ICE,B_ICE,B_ICE,B_BAR,B_ICE,B_ICE,B_ICE,B_BAR,B_BAR},
        {B_BAR,B_BAR,B_BAR,B_BAR,B_BAR,B_MCG,B_BAR,B_BAR,B_BAR,B_BAR,B_BAR,B_BAR},
        {B_BAR,B_BAR,B_BAR,B_BAR,B_BAR,B_BAR,B_BAR,B_BAR,B_BAR,B_BAR,B_BAR,B_BAR}
    },
    {8,2},
    {{2,7},{8,5},{7,4}}
};
// DRUR DLDL RUL

// const LevelMap level33=
// {
//     {
//         {B_ICE,B_ICE,B_ICE,B_ICE,B_ICE,B_ICE,B_ICE,B_ICE,B_ICE,B_ICE,B_ICE,B_ICE},
//         {B_ICE,B_ICE,B_ICE,B_ICE,B_ICE,B_ICE,B_ICE,B_ICE,B_ICE,B_ICE,B_ICE,B_ICE},
//         {B_ICE,B_ICE,B_ICE,B_ICE,B_ICE,B_ICE,B_ICE,B_ICE,B_ICE,B_ICE,B_ICE,B_ICE},
//         {B_ICE,B_ICE,B_ICE,B_ICE,B_ICE,B_ICE,B_ICE,B_ICE,B_ICE,B_ICE,B_ICE,B_ICE},
//         {B_ICE,B_ICE,B_ICE,B_ICE,B_ICE,B_ICE,B_ICE,B_ICE,B_ICE,B_ICE,B_ICE,B_ICE},
//         {B_ICE,B_ICE,B_ICE,B_ICE,B_ICE,B_ICE,B_ICE,B_ICE,B_ICE,B_ICE,B_ICE,B_ICE},
//         {B_ICE,B_ICE,B_ICE,B_ICE,B_ICE,B_ICE,B_ICE,B_ICE,B_ICE,B_ICE,B_ICE,B_ICE},
//         {B_ICE,B_ICE,B_ICE,B_ICE,B_ICE,B_ICE,B_ICE,B_ICE,B_ICE,B_ICE,B_ICE,B_ICE},
//         {B_ICE,B_ICE,B_ICE,B_ICE,B_ICE,B_ICE,B_ICE,B_ICE,B_ICE,B_ICE,B_ICE,B_ICE},
//         {B_ICE,B_ICE,B_ICE,B_ICE,B_ICE,B_ICE,B_ICE,B_ICE,B_ICE,B_ICE,B_ICE,B_ICE},
//         {B_ICE,B_ICE,B_ICE,B_ICE,B_ICE,B_ICE,B_ICE,B_ICE,B_ICE,B_ICE,B_ICE,B_ICE},
//         {B_ICE,B_ICE,B_ICE,B_ICE,B_ICE,B_ICE,B_ICE,B_ICE,B_ICE,B_ICE,B_ICE,B_ICE}
//     },
//     {5,11},
//     {{5,7},{1,9},{9,1}},
// };

//LDLD DULD LUU

//LDRU RLLD RULD LURU LDRD
//DULD RURL DLLU RULD RD
