liyuxuan3003/PrismGC/PrismGC/TD/rtl/AHBLite.v

/*
 * Copyright (c) 2023 by Liyuxuan, all rights reserved.
 */

`include "GlobalDefine.v"

module AHBLite
(
    input           HCLK,
    input           HRESETn,
    input[31:0]     HADDR,
    input[2:0]      HBURST,
    input           HMASTLOCK,
    input[3:0]      HPROT,
    input[2:0]      HSIZE,
    input[1:0]      HTRANS,
    input[31:0]     HWDATA,
    input           HWRITE,
    output          HREADY,
    output[31:0]    HRDATA,
    output          HRESP,
    output[31:0]    IRQ,
    output          TXD,
    input           RXD,
    output          HDMI_CLK_P,
    output          HDMI_D2_P,
    output          HDMI_D1_P,
    output          HDMI_D0_P,
    output[4:0]     VGA_R,
    output[5:0]     VGA_G,
    output[4:0]     VGA_B,
    output          VGA_HS,
    output          VGA_VS,
    output[7:0]     SEG,
    output[3:0]     SEGCS,
    output          BUZ,
    output          AUD,
    input[3:0]      COL,
    output[3:0]     ROW,
    inout[31:0]     io_pin0,
    inout[31:0]     io_pin1,
    inout[31:0]     io_pin2,
    inout[31:0]     io_pin3
);

assign IRQ[31:1] = 0;

wire[2**`DEVICES_EXP-1:0]    HSEL_A;
wire[2**`DEVICES_EXP-1:0]    HREADYOUT_A;
wire[2**`DEVICES_EXP-1:0]    HRESP_A;
wire[2**`DEVICES_EXP*32-1:0] HRDATA_A;

// Decoder
AHBLiteDecoder uDecoder
(
    .HADDR(HADDR),
    .HSEL_A(HSEL_A)
);

// Slave MUX
AHBLiteSlaveMux uSlaveMUX
(
    // CLOCK & RST
    .HCLK(HCLK),
    .HRESETn(HRESETn),
    .HREADY(HREADY),

    .HSEL_A(HSEL_A),
    .HREADYOUT_A(HREADYOUT_A),
    .HRESP_A(HRESP_A),
    .HRDATA_A(HRDATA_A),

    .HREADYOUT(HREADY),
    .HRESP(HRESP),
    .HRDATA(HRDATA)
);

// RamCode
AHBLiteBlockROM #(.ADDR_WIDTH(`RAM_CODE_WIDTH)) uAHBROMCode
(
    .HCLK(HCLK),
    .HRESETn(HRESETn),
    .HSEL(HSEL_A[`idRAMCode]),
    .HADDR(HADDR),
    .HPROT(HPROT),
    .HSIZE(HSIZE),
    .HTRANS(HTRANS),
    .HWDATA(HWDATA),
    .HWRITE(HWRITE),
    .HRDATA(HRDATA_A[`idRAMCode*32+:32]),
    .HREADY(HREADY),
    .HREADYOUT(HREADYOUT_A[`idRAMCode]),
    .HRESP(HRESP_A[`idRAMCode])
);
// AHBLiteBlockRAM #(.ADDR_WIDTH(`RAM_CODE_WIDTH)) uAHBRAMCode
// (
//     .HCLK(HCLK),
//     .HRESETn(HRESETn),
//     .HSEL(HSEL_A[`idRAMCode]),
//     .HADDR(HADDR),
//     .HPROT(HPROT),
//     .HSIZE(HSIZE),
//     .HTRANS(HTRANS),
//     .HWDATA(HWDATA),
//     .HWRITE(HWRITE),
//     .HRDATA(HRDATA_A[`idRAMCode*32+:32]),
//     .HREADY(HREADY),
//     .HREADYOUT(HREADYOUT_A[`idRAMCode]),
//     .HRESP(HRESP_A[`idRAMCode])
// );

// RamData
AHBLiteBlockRAM #(.ADDR_WIDTH(`RAM_DATA_WIDTH)) uAHBRAMData
(
    .HCLK(HCLK),
    .HRESETn(HRESETn),
    .HSEL(HSEL_A[`idRAMData]),
    .HADDR(HADDR),
    .HPROT(HPROT),
    .HSIZE(HSIZE),
    .HTRANS(HTRANS),
    .HWDATA(HWDATA),
    .HWRITE(HWRITE),
    .HRDATA(HRDATA_A[`idRAMData*32+:32]),
    .HREADY(HREADY),
    .HREADYOUT(HREADYOUT_A[`idRAMData]),
    .HRESP(HRESP_A[`idRAMData])
);

// GPIO
AHBLiteGPIO uAHBGPIO
(
    .HCLK(HCLK),
    .HRESETn(HRESETn),
    .HSEL(HSEL_A[`idGPIO]),
    .HADDR(HADDR),
    .HPROT(HPROT),
    .HSIZE(HSIZE),
    .HTRANS(HTRANS),
    .HWDATA(HWDATA),
    .HWRITE(HWRITE),
    .HRDATA(HRDATA_A[`idGPIO*32+:32]),
    .HREADY(HREADY),
    .HREADYOUT(HREADYOUT_A[`idGPIO]),
    .HRESP(HRESP_A[`idGPIO]),
    .io_pin0(io_pin0),
    .io_pin1(io_pin1),
    .io_pin2(io_pin2),
    .io_pin3(io_pin3)
);

// UART
AHBLiteUART uAHBUART
(
    .HCLK(HCLK),
    .HRESETn(HRESETn),
    .HSEL(HSEL_A[`idUART]),
    .HADDR(HADDR),
    .HPROT(HPROT),
    .HSIZE(HSIZE),
    .HTRANS(HTRANS),
    .HWDATA(HWDATA),
    .HWRITE(HWRITE),
    .HRDATA(HRDATA_A[`idUART*32+:32]),
    .HREADY(HREADY),
    .HREADYOUT(HREADYOUT_A[`idUART]),
    .HRESP(HRESP_A[`idUART]),
    .IRQ(IRQ[0]),
    .TXD(TXD),
    .RXD(RXD)
);

// Digit
AHBLiteDigit uAHBDigit
(
    .HCLK(HCLK),
    .HRESETn(HRESETn),
    .HSEL(HSEL_A[`idDigit]),
    .HADDR(HADDR),
    .HPROT(HPROT),
    .HSIZE(HSIZE),
    .HTRANS(HTRANS),
    .HWDATA(HWDATA),
    .HWRITE(HWRITE),
    .HRDATA(HRDATA_A[`idDigit*32+:32]),
    .HREADY(HREADY),
    .HREADYOUT(HREADYOUT_A[`idDigit]),
    .HRESP(HRESP_A[`idDigit]),
    .SEG(SEG),
    .SEGCS(SEGCS)
);

// Buzzer
AHBLiteBuzzer uAHBBuzzer
(
    .HCLK(HCLK),
    .HRESETn(HRESETn),
    .HSEL(HSEL_A[`idBuzzer]),
    .HADDR(HADDR),
    .HPROT(HPROT),
    .HSIZE(HSIZE),
    .HTRANS(HTRANS),
    .HWDATA(HWDATA),
    .HWRITE(HWRITE),
    .HRDATA(HRDATA_A[`idBuzzer*32+:32]),
    .HREADY(HREADY),
    .HREADYOUT(HREADYOUT_A[`idBuzzer]),
    .HRESP(HRESP_A[`idBuzzer]),
    .BUZ(BUZ),
    .AUD(AUD)
);

// KeyBoard
AHBLiteKeyBoard uAHBKeyBoard
(
    .HCLK(HCLK),
    .HRESETn(HRESETn),
    .HSEL(HSEL_A[`idKeyBoard]),
    .HADDR(HADDR),
    .HPROT(HPROT),
    .HSIZE(HSIZE),
    .HTRANS(HTRANS),
    .HWDATA(HWDATA),
    .HWRITE(HWRITE),
    .HRDATA(HRDATA_A[`idKeyBoard*32+:32]),
    .HREADY(HREADY),
    .HREADYOUT(HREADYOUT_A[`idKeyBoard]),
    .HRESP(HRESP_A[`idKeyBoard]),
    .COL(COL),
    .ROW(ROW)
);

// Timer
AHBLiteTimer uAHBTimer
(
    .HCLK(HCLK),
    .HRESETn(HRESETn),
    .HSEL(HSEL_A[`idTimer]),
    .HADDR(HADDR),
    .HPROT(HPROT),
    .HSIZE(HSIZE),
    .HTRANS(HTRANS),
    .HWDATA(HWDATA),
    .HWRITE(HWRITE),
    .HRDATA(HRDATA_A[`idTimer*32+:32]),
    .HREADY(HREADY),
    .HREADYOUT(HREADYOUT_A[`idTimer]),
    .HRESP(HRESP_A[`idTimer])
);

// GPU
AHBLiteGPU uAHBGPU
(
    .HCLK(HCLK),
    .HRESETn(HRESETn),
    .HSEL(HSEL_A[`idGPULite]),
    .HADDR(HADDR),
    .HPROT(HPROT),
    .HSIZE(HSIZE),
    .HTRANS(HTRANS),
    .HWDATA(HWDATA),
    .HWRITE(HWRITE),
    .HRDATA(HRDATA_A[`idGPULite*32+:32]),
    .HREADY(HREADY),
    .HREADYOUT(HREADYOUT_A[`idGPULite]),
    .HRESP(HRESP_A[`idGPULite]),
    .HDMI_CLK_P(HDMI_CLK_P),
    .HDMI_D2_P(HDMI_D2_P),
    .HDMI_D1_P(HDMI_D1_P),
    .HDMI_D0_P(HDMI_D0_P)
);

// wire clkPixel;
// wire clkTMDS;
// wire clkSdr;
// wire clkSdrShift;

// SystemPLL uSystemPLL
// (
//     .refclk(HCLK),
//     .reset(~HRESETn),
//     .clk0_out(clkPixel),
//     .clk1_out(clkTMDS),
//     .clk2_out(clkSdr),
//     .clk3_out(clkSdrShift)
// );

endmodule
