liyuxuan3003/PrismGC/PrismGC/Keil/src/GlobalDefine.h

#ifndef GLOBALDEFINE_H
#define GLOBALDEFINE_H

#define PAGE_MAIN       0
#define PAGE_BLOCK_GAME 1
#define PAGE_I2C_TEST   2
#define PAGE_CHAR_TEST  3
#define PAGE_MAZE_GAME  4
#define PAGE_MENU       5
#define PAGE_END        8   // DO NOT USE 6 or 7 HERE !

#define FRAME 150
#define APPLEFRAME 20

#define RED    0xFF0000
#define GREEN  0x00FF00
#define BLUE   0x0000FF
#define BLACK  0x000000
#define WHITE  0xFFFFFF
#define ORANGE 0xFF6633
#define YELLOW 0xFFFF00
#define PURPLE 0x800080
#define CHOCOLATE 0xD2691E
#define SADDLEBROWN 0x8B4513
#define GREYBLUE 0x13458B
#define BISQUE 0xFFE4C4
#define WHI 0xC4E4FF
#define OLIVEDRAB 0x556B2F
#define GOLD 0xFFD700

#endif
