liyuxuan3003/PrismGC/PrismGC/TD/rtl/SystemPLL/SystemInitDelay.v

/*
 * Copyright (c) 2023 by Liyuxuan, all rights reserved.
 */

module SystemInitDelay
#(
    parameter SYS_DELAY_TOP = 24'd2500000    //50ms system init delay
)
(
    //global clock
    input   clk,        //50MHz
    input   rst_n,
    
    //system interface
    output  delay_done
);

//------------------------------------------
//Delay 50ms for steady state when power on
reg    [23:0] delay_cnt = 24'd0;
always@(posedge clk or negedge rst_n)
begin
    if(!rst_n)
        delay_cnt <= 0;
    else if(delay_cnt < SYS_DELAY_TOP - 1'b1)
        delay_cnt <= delay_cnt + 1'b1;
    else
        delay_cnt <= SYS_DELAY_TOP - 1'b1;
end
assign    delay_done = (delay_cnt == SYS_DELAY_TOP - 1'b1)? 1'b1 : 1'b0;

endmodule
