liyuxuan3003/PrismGC/PrismGC/TD/rtl/Mux16_1.v

/*
 * Copyright (c) 2023 by Liyuxuan, all rights reserved.
 */

module Mux16_1 #(parameter WIDTH = 1)
(
    input [16-1:0] sel,
    input [16*WIDTH-1:0] sigIn,
    output[WIDTH-1:0]   sigOut,
    input[WIDTH-1:0]    sigOutDefault
);

assign sigOut = 
    (sel == 16'b0000_0000_0000_0001) ? sigIn[ 1*WIDTH-1: 0*WIDTH] :
    (sel == 16'b0000_0000_0000_0010) ? sigIn[ 2*WIDTH-1: 1*WIDTH] :
    (sel == 16'b0000_0000_0000_0100) ? sigIn[ 3*WIDTH-1: 2*WIDTH] :
    (sel == 16'b0000_0000_0000_1000) ? sigIn[ 4*WIDTH-1: 3*WIDTH] :
    (sel == 16'b0000_0000_0001_0000) ? sigIn[ 5*WIDTH-1: 4*WIDTH] :
    (sel == 16'b0000_0000_0010_0000) ? sigIn[ 6*WIDTH-1: 5*WIDTH] :
    (sel == 16'b0000_0000_0100_0000) ? sigIn[ 7*WIDTH-1: 6*WIDTH] :
    (sel == 16'b0000_0000_1000_0000) ? sigIn[ 8*WIDTH-1: 7*WIDTH] :
    (sel == 16'b0000_0001_0000_0000) ? sigIn[ 9*WIDTH-1: 8*WIDTH] :
    (sel == 16'b0000_0010_0000_0000) ? sigIn[10*WIDTH-1: 9*WIDTH] :
    (sel == 16'b0000_0100_0000_0000) ? sigIn[11*WIDTH-1:10*WIDTH] :
    (sel == 16'b0000_1000_0000_0000) ? sigIn[12*WIDTH-1:11*WIDTH] :
    (sel == 16'b0001_0000_0000_0000) ? sigIn[13*WIDTH-1:12*WIDTH] :
    (sel == 16'b0010_0000_0000_0000) ? sigIn[14*WIDTH-1:13*WIDTH] :
    (sel == 16'b0100_0000_0000_0000) ? sigIn[15*WIDTH-1:14*WIDTH] :
    (sel == 16'b1000_0000_0000_0000) ? sigIn[16*WIDTH-1:15*WIDTH] : sigOutDefault;
    
endmodule
