liyuxuan3003/PrismGC/PrismGC/Keil/src/Peripheral.h

#ifndef PERIPHERAL_H
#define PERIPHERAL_H

#define RAM_CODE_BASE       0x00000000
#define RAM_DATA_BASE       0x20000000
#define SDRAM_BASE          0x40000000
#define TIMER_BASE          0x60010000
#define GPIO_BASE           0x60020000
#define UART_BASE           0x60030000
#define IIC_BASE            0x60040000
#define GPU_LITE_BASE       0x60050000
#define HDMI_BASE           0x60060000
#define BUZZER_BASE         0x60070000
#define DIGIT_BASE          0x60080000
#define KEYBOARD_BASE       0x60090000

#endif
