liyuxuan3003/PrismGC/PrismGC/TD/al_ip/Test2_sim.v

// Verilog netlist created by TD v5.0.30786
// Sun Aug 13 22:34:12 2023

`timescale 1ns / 1ps
module RomTest  // Test2.v(14)
  (
  addra,
  clka,
  rsta,
  doa
  );

  input [12:0] addra;  // Test2.v(18)
  input clka;  // Test2.v(19)
  input rsta;  // Test2.v(20)
  output [31:0] doa;  // Test2.v(16)

  wire [0:0] addra_piped;
  wire inst_doa_i0_000;
  wire inst_doa_i0_001;
  wire inst_doa_i0_002;
  wire inst_doa_i0_003;
  wire inst_doa_i0_004;
  wire inst_doa_i0_005;
  wire inst_doa_i0_006;
  wire inst_doa_i0_007;
  wire inst_doa_i1_000;
  wire inst_doa_i1_001;
  wire inst_doa_i1_002;
  wire inst_doa_i1_003;
  wire inst_doa_i1_004;
  wire inst_doa_i1_005;
  wire inst_doa_i1_006;
  wire inst_doa_i1_007;

  assign doa[31] = doa[15];
  assign doa[30] = doa[14];
  assign doa[29] = doa[13];
  assign doa[28] = doa[12];
  assign doa[27] = doa[11];
  assign doa[26] = doa[10];
  assign doa[25] = doa[1];
  assign doa[24] = doa[0];
  assign doa[23] = doa[15];
  assign doa[22] = doa[14];
  assign doa[21] = doa[13];
  assign doa[20] = doa[12];
  assign doa[19] = doa[11];
  assign doa[18] = doa[10];
  assign doa[17] = doa[1];
  assign doa[16] = doa[0];
  assign doa[9] = doa[1];
  assign doa[8] = doa[0];
  assign doa[7] = doa[15];
  assign doa[6] = doa[14];
  assign doa[5] = doa[13];
  assign doa[4] = doa[12];
  assign doa[3] = doa[11];
  assign doa[2] = doa[10];
  AL_DFF_X addra_pipe (
    .ar(1'b0),
    .as(1'b0),
    .clk(clka),
    .d(addra[12]),
    .en(1'b1),
    .sr(rsta),
    .ss(1'b0),
    .q(addra_piped));
  EG_PHY_CONFIG #(
    .DONE_PERSISTN("ENABLE"),
    .INIT_PERSISTN("ENABLE"),
    .JTAG_PERSISTN("DISABLE"),
    .PROGRAMN_PERSISTN("DISABLE"))
    config_inst ();
  // address_offset=0;data_offset=0;depth=4096;width=8;num_section=1;width_per_section=8;section_size=32;working_depth=4096;working_width=8;mode_ecc=0;address_step=1;bytes_in_per_section=1;
  EG_PHY_BRAM32K #(
    .CLKBMUX("0"),
    .CSAMUX("INV"),
    .CSBMUX("0"),
    .DATA_WIDTH_A("8"),
    .DATA_WIDTH_B("8"),
    .INIT_00(256'hFFFFFFFFFFFFFFFFFFFFFFFFFFFFFFFFFFFFFFFFFFFFFFFFFFFFFFFFFFFFFFFF),
    .INIT_01(256'hFFFFFFFFFFFFFFFFFFFFFFFFFFFFFFFFFFFFFFFFFFFFFFFFFFFFFFFFFFFFFFFF),
    .INIT_02(256'hFFFFFFFFFFFFFFFFFFFFFFFFFFFFFFFFFFFFFFFFFFFFFFFFFFFFFFFFFFFFFFFF),
    .INIT_03(256'hFFFFFFFFFFFFFFFFFFFFFFFFFFFFFFFFFFFFFFFFFFFFFFFFFFFFFFFFFFFFFFFF),
    .INIT_04(256'hFFFFFFFFFFFFFFFFFFFFFFFFFFFFFFFFFFFFFFFFFFFFFFFFFFFFFFFFFFFFFFFF),
    .INIT_05(256'hFFFFFFFFFFFFFFFFFFFFFFFFFFFFFFFFFFFFFFFFFFFFFFFFFFFFFFFFFFFFFFFF),
    .INIT_06(256'hFFFFFFFFFFFFFFFFFFFFFFFFFFFFFFFFFFFFFFFFFFFFFFFFFFFFFFFFFFFFFFFF),
    .INIT_07(256'hFFFFFFFFFFFFFFFFFFFFFFFFFFFFFFFFFFFFFFFFFFFFFFFFFFFFFFFFFFFFFFFF),
    .INIT_08(256'hFFFFFFFFFFFFFFFFFFFFFFFFFFFFFFFFFFFFFFFFFFFFFFFFFFFFFFFFFFFFFFFF),
    .INIT_09(256'hFFFFFFFFFFFFFFFFFFFFFFFFFFFFFFFFFFFFFFFFFFFFFFFFFFFFFFFFFFFFFFFF),
    .INIT_0A(256'hFFFFFFFFFFFFFFFFFFFFFFFFFFFFFFFFFFFFFFFFFFFFFFFFFFFFFFFFFFFFFFFF),
    .INIT_0B(256'hFFFFFFFFFFFFFFFFFFFFFFFFFFFFFFFFFFFFFFFFFFFFFFFFFFFFFFFFFFFFFFFF),
    .INIT_0C(256'hFFFFFFFFFFFFFFFFFFFFFFFFFFFFFFFFFFFFFFFFFFFFFFFFFFFFFFFFFFFFFFFF),
    .INIT_0D(256'hFFFFFFFFFFFFFFFFFFFFFFFFFFFFFFFFFFFFFFFFFFFFFFFFFFFFFFFFFFFFFFFF),
    .INIT_0E(256'hFFFFFFFFFFFFFFFFFFFFFFFFFFFFFFFFFFFFFFFFFFFFFFFFFFFFFFFFFFFFFFFF),
    .INIT_0F(256'hFFFFFFFFFFFFFFFFFFFFFFFFFFFFFFFFFFFFFFFFFFFFFFFFFFFFFFFFFFFFFFFF),
    .INIT_10(256'hFFFFFFFFFFFFFFFFFFFFFFFFFFFFFFFFFFFFFFFFFFFFFFFFFFFFFFFFFFFFFFFF),
    .INIT_11(256'hFFFFFFFFFFFFFFFFFFFFFFFFFFFFFFFFFFFFFFFFFFFFFFFFFFFFFFFFFFFFFFFF),
    .INIT_12(256'hFFFFFFFFFFFFFFFFFFFFFFFFFFFFFFFFFFFFFFFFFFFFFFFFFFFFFFFFFFFFFFFF),
    .INIT_13(256'hFFFFFFFFFFFFFFFFFFFFFFFFFFFFFFFFFFFFFFFFFFFFFFFFFFFFFFFFFFFFFFFF),
    .INIT_14(256'hFFFFFFFFFFFFFFFFFFFFFFFFFFFFFFFFFFFFFFFFFFFFFFFFFFFFFFFFFFFFFFFF),
    .INIT_15(256'hFFFFFFFFFFFFFFFFFFFFFFFFFFFFFFFFFFFFFFFFFFFFFFFFFFFFFFFFFFFFFFFF),
    .INIT_16(256'hFFFFFFFFFFFFFFFFFFFFFFFFFFFFFFFFFFFFFFFFFFFFFFFFFFFFFFFFFFFFFFFF),
    .INIT_17(256'hFFFFFFFFFFFFFFFFFFFFFFFFFFFFFFFFFFFFFFFFFFFFFFFFFFFFFFFFFFFFFFFF),
    .INIT_18(256'hFFFFFFFFFFFFFFFFFFFFFFFFFFFFFFFFFFFFFFFFFFFFFFFFFFFFFFFFFFFFFFFF),
    .INIT_19(256'hFFFFFFFFFFFFFFFFFFFFFFFFFFFFFFFFFFFFFFFFFFFFFFFFFFFFFFFFFFFFFFFF),
    .INIT_1A(256'hFFFFFFFFFFFFFFFFFFFFFFFFFFFFFFFFFFFFFFFFFFFFFFFFFFFFFFFFFFFFFFFF),
    .INIT_1B(256'hFFFFFFFFFFFFFFFFFFFFFFFFFFFFFFFFFFFFFFFFFFFFFFFFFFFFFFFFFFFFFFFF),
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
    .INIT_71(256'hFFFFFFFFFFFFFFFFFFFFFFFFFFFFFFFFFFFFFFFFFFFFFFFFFFFFFFFFFFFFFFFF),
    .INIT_72(256'hFFFFFFFFFFFFFFFFFFFFFFFFFFFFFFFFFFFFFFFFFFFFFFFFFFFFFFFFFFFFFFFF),
    .INIT_73(256'hFFFFFFFFFFFFFFFFFFFFFFFFFFFFFFFFFFFFFFFFFFFFFFFFFFFFFFFFFFFFFFFF),
    .INIT_74(256'hFFFFFFFFFFFFFFFFFFFFFFFFFFFFFFFFFFFFFFFFFFFFFFFFFFFFFFFFFFFFFFFF),
    .INIT_75(256'hFFFFFFFFFFFFFFFFFFFFFFFFFFFFFFFFFFFFFFFFFFFFFFFFFFFFFFFFFFFFFFFF),
    .INIT_76(256'hFFFFFFFFFFFFFFFFFFFFFFFFFFFFFFFFFFFFFFFFFFFFFFFFFFFFFFFFFFFFFFFF),
    .INIT_77(256'hFFFFFFFFFFFFFFFFFFFFFFFFFFFFFFFFFFFFFFFFFFFFFFFFFFFFFFFFFFFFFFFF),
    .INIT_78(256'hFFFFFFFFFFFFFFFFFFFFFFFFFFFFFFFFFFFFFFFFFFFFFFFFFFFFFFFFFFFFFFFF),
    .INIT_79(256'hFFFFFFFFFFFFFFFFFFFFFFFFFFFFFFFFFFFFFFFFFFFFFFFFFFFFFFFFFFFFFFFF),
    .INIT_7A(256'hFFFFFFFFFFFFFFFFFFFFFFFFFFFFFFFFFFFFFFFFFFFFFFFFFFFFFFFFFFFFFFFF),
    .INIT_7B(256'hFFFFFFFFFFFFFFFFFFFFFFFFFFFFFFFFFFFFFFFFFFFFFFFFFFFFFFFFFFFFFFFF),
    .INIT_7C(256'hFFFFFFFFFFFFFFFFFFFFFFFFFFFFFFFFFFFFFFFFFFFFFFFFFFFFFFFFFFFFFFFF),
    .INIT_7D(256'hFFFFFFFFFFFFFFFFFFFFFFFFFFFFFFFFFFFFFFFFFFFFFFFFFFFFFFFFFFFFFFFF),
    .INIT_7E(256'hFFFFFFFFFFFFFFFFFFFFFFFFFFFFFFFFFFFFFFFFFFFFFFFFFFFFFFFFFFFFFFFF),
    .INIT_7F(256'hFFFFFFFFFFFFFFFFFFFFFFFFFFFFFFFFFFFFFFFFFFFFFFFFFFFFFFFFFFFFFFFF),
    .MODE("SP16K"),
    .OCEAMUX("0"),
    .OCEBMUX("0"),
    .REGMODE_A("NOREG"),
    .REGMODE_B("NOREG"),
    .RSTBMUX("0"),
    .SRMODE("SYNC"),
    .WEAMUX("0"),
    .WEBMUX("0"),
    .WRITEMODE_A("NORMAL"),
    .WRITEMODE_B("NORMAL"))
    inst_8192x32_sub_000000_000 (
    .addra(addra[11:1]),
    .addrb(11'b00000000000),
    .bytea(addra[0]),
    .byteb(1'b0),
    .clka(clka),
    .csa(addra[12]),
    .dia({open_n51,open_n52,open_n53,open_n54,open_n55,open_n56,open_n57,open_n58,8'b00000000}),
    .rsta(rsta),
    .doa({open_n80,open_n81,open_n82,open_n83,open_n84,open_n85,open_n86,open_n87,inst_doa_i0_007,inst_doa_i0_006,inst_doa_i0_005,inst_doa_i0_004,inst_doa_i0_003,inst_doa_i0_002,inst_doa_i0_001,inst_doa_i0_000}));
  // address_offset=4096;data_offset=0;depth=4096;width=8;num_section=1;width_per_section=8;section_size=32;working_depth=4096;working_width=8;mode_ecc=0;address_step=1;bytes_in_per_section=1;
  EG_PHY_BRAM32K #(
    .CLKBMUX("0"),
    .CSBMUX("0"),
    .DATA_WIDTH_A("8"),
    .DATA_WIDTH_B("8"),
    .INIT_00(256'hFFFFFFFFFFFFFFFFFFFFFFFFFFFFFFFFFFFFFFFFFFFFFFFFFFFFFFFFFFFFFFFF),
    .INIT_01(256'hFFFFFFFFFFFFFFFFFFFFFFFFFFFFFFFFFFFFFFFFFFFFFFFFFFFFFFFFFFFFFFFF),
    .INIT_02(256'hFFFFFFFFFFFFFFFFFFFFFFFFFFFFFFFFFFFFFFFFFFFFFFFFFFFFFFFFFFFFFFFF),
    .INIT_03(256'hFFFFFFFFFFFFFFFFFFFFFFFFFFFFFFFFFFFFFFFFFFFFFFFFFFFFFFFFFFFFFFFF),
    .INIT_04(256'hFFFFFFFFFFFFFFFFFFFFFFFFFFFFFFFFFFFFFFFFFFFFFFFFFFFFFFFFFFFFFFFF),
    .INIT_05(256'hFFFFFFFFFFFFFFFFFFFFFFFFFFFFFFFFFFFFFFFFFFFFFFFFFFFFFFFFFFFFFFFF),
    .INIT_06(256'hFFFFFFFFFFFFFFFFFFFFFFFFFFFFFFFFFFFFFFFFFFFFFFFFFFFFFFFFFFFFFFFF),
    .INIT_07(256'hFFFFFFFFFFFFFFFFFFFFFFFFFFFFFFFFFFFFFFFFFFFFFFFFFFFFFFFFFFFFFFFF),
    .INIT_08(256'hFFFFFFFFFFFFFFFFFFFFFFFFFFFFFFFFFFFFFFFFFFFFFFFFFFFFFFFFFFFFFFFF),
    .INIT_09(256'hFFFFFFFFFFFFFFFFFFFFFFFFFFFFFFFFFFFFFFFFFFFFFFFFFFFFFFFFFFFFFFFF),
    .INIT_0A(256'hFFFFFFFFFFFFFFFFFFFFFFFFFFFFFFFFFFFFFFFFFFFFFFFFFFFFFFFFFFFFFFFF),
    .INIT_0B(256'hFFFFFFFFFFFFFFFFFFFFFFFFFFFFFFFFFFFFFFFFFFFFFFFFFFFFFFFFFFFFFFFF),
    .INIT_0C(256'hFFFFFFFFFFFFFFFFFFFFFFFFFFFFFFFFFFFFFFFFFFFFFFFFFFFFFFFFFFFFFFFF),
    .INIT_0D(256'hFFFFFFFFFFFFFFFFFFFFFFFFFFFFFFFFFFFFFFFFFFFFFFFFFFFFFFFFFFFFFFFF),
    .INIT_0E(256'hFFFFFFFFFFFFFFFFFFFFFFFFFFFFFFFFFFFFFFFFFFFFFFFFFFFFFFFFFFFFFFFF),
    .INIT_0F(256'hFFFFFFFFFFFFFFFFFFFFFFFFFFFFFFFFFFFFFFFFFFFFFFFFFFFFFFFFFFFFFFFF),
    .INIT_10(256'hFFFFFFFFFFFFFFFFFFFFFFFFFFFFFFFFFFFFFFFFFFFFFFFFFFFFFFFFFFFFFFFF),
    .INIT_11(256'hFFFFFFFFFFFFFFFFFFFFFFFFFFFFFFFFFFFFFFFFFFFFFFFFFFFFFFFFFFFFFFFF),
    .INIT_12(256'hFFFFFFFFFFFFFFFFFFFFFFFFFFFFFFFFFFFFFFFFFFFFFFFFFFFFFFFFFFFFFFFF),
    .INIT_13(256'hFFFFFFFFFFFFFFFFFFFFFFFFFFFFFFFFFFFFFFFFFFFFFFFFFFFFFFFFFFFFFFFF),
    .INIT_14(256'hFFFFFFFFFFFFFFFFFFFFFFFFFFFFFFFFFFFFFFFFFFFFFFFFFFFFFFFFFFFFFFFF),
    .INIT_15(256'hFFFFFFFFFFFFFFFFFFFFFFFFFFFFFFFFFFFFFFFFFFFFFFFFFFFFFFFFFFFFFFFF),
    .INIT_16(256'hFFFFFFFFFFFFFFFFFFFFFFFFFFFFFFFFFFFFFFFFFFFFFFFFFFFFFFFFFFFFFFFF),
    .INIT_17(256'hFFFFFFFFFFFFFFFFFFFFFFFFFFFFFFFFFFFFFFFFFFFFFFFFFFFFFFFFFFFFFFFF),
    .INIT_18(256'hFFFFFFFFFFFFFFFFFFFFFFFFFFFFFFFFFFFFFFFFFFFFFFFFFFFFFFFFFFFFFFFF),
    .INIT_19(256'hFFFFFFFFFFFFFFFFFFFFFFFFFFFFFFFFFFFFFFFFFFFFFFFFFFFFFFFFFFFFFFFF),
    .INIT_1A(256'hFFFFFFFFFFFFFFFFFFFFFFFFFFFFFFFFFFFFFFFFFFFFFFFFFFFFFFFFFFFFFFFF),
    .INIT_1B(256'hFFFFFFFFFFFFFFFFFFFFFFFFFFFFFFFFFFFFFFFFFFFFFFFFFFFFFFFFFFFFFFFF),
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
    .INIT_71(256'hFFFFFFFFFFFFFFFFFFFFFFFFFFFFFFFFFFFFFFFFFFFFFFFFFFFFFFFFFFFFFFFF),
    .INIT_72(256'hFFFFFFFFFFFFFFFFFFFFFFFFFFFFFFFFFFFFFFFFFFFFFFFFFFFFFFFFFFFFFFFF),
    .INIT_73(256'hFFFFFFFFFFFFFFFFFFFFFFFFFFFFFFFFFFFFFFFFFFFFFFFFFFFFFFFFFFFFFFFF),
    .INIT_74(256'hFFFFFFFFFFFFFFFFFFFFFFFFFFFFFFFFFFFFFFFFFFFFFFFFFFFFFFFFFFFFFFFF),
    .INIT_75(256'hFFFFFFFFFFFFFFFFFFFFFFFFFFFFFFFFFFFFFFFFFFFFFFFFFFFFFFFFFFFFFFFF),
    .INIT_76(256'hFFFFFFFFFFFFFFFFFFFFFFFFFFFFFFFFFFFFFFFFFFFFFFFFFFFFFFFFFFFFFFFF),
    .INIT_77(256'hFFFFFFFFFFFFFFFFFFFFFFFFFFFFFFFFFFFFFFFFFFFFFFFFFFFFFFFFFFFFFFFF),
    .INIT_78(256'hFFFFFFFFFFFFFFFFFFFFFFFFFFFFFFFFFFFFFFFFFFFFFFFFFFFFFFFFFFFFFFFF),
    .INIT_79(256'hFFFFFFFFFFFFFFFFFFFFFFFFFFFFFFFFFFFFFFFFFFFFFFFFFFFFFFFFFFFFFFFF),
    .INIT_7A(256'hFFFFFFFFFFFFFFFFFFFFFFFFFFFFFFFFFFFFFFFFFFFFFFFFFFFFFFFFFFFFFFFF),
    .INIT_7B(256'hFFFFFFFFFFFFFFFFFFFFFFFFFFFFFFFFFFFFFFFFFFFFFFFFFFFFFFFFFFFFFFFF),
    .INIT_7C(256'hFFFFFFFFFFFFFFFFFFFFFFFFFFFFFFFFFFFFFFFFFFFFFFFFFFFFFFFFFFFFFFFF),
    .INIT_7D(256'hFFFFFFFFFFFFFFFFFFFFFFFFFFFFFFFFFFFFFFFFFFFFFFFFFFFFFFFFFFFFFFFF),
    .INIT_7E(256'hFFFFFFFFFFFFFFFFFFFFFFFFFFFFFFFFFFFFFFFFFFFFFFFFFFFFFFFFFFFFFFFF),
    .INIT_7F(256'hFFFFFFFFFFFFFFFFFFFFFFFFFFFFFFFFFFFFFFFFFFFFFFFFFFFFFFFFFFFFFFFF),
    .MODE("SP16K"),
    .OCEAMUX("0"),
    .OCEBMUX("0"),
    .REGMODE_A("NOREG"),
    .REGMODE_B("NOREG"),
    .RSTBMUX("0"),
    .SRMODE("SYNC"),
    .WEAMUX("0"),
    .WEBMUX("0"),
    .WRITEMODE_A("NORMAL"),
    .WRITEMODE_B("NORMAL"))
    inst_8192x32_sub_004096_000 (
    .addra(addra[11:1]),
    .addrb(11'b00000000000),
    .bytea(addra[0]),
    .byteb(1'b0),
    .clka(clka),
    .csa(addra[12]),
    .dia({open_n108,open_n109,open_n110,open_n111,open_n112,open_n113,open_n114,open_n115,8'b00000000}),
    .rsta(rsta),
    .doa({open_n137,open_n138,open_n139,open_n140,open_n141,open_n142,open_n143,open_n144,inst_doa_i1_007,inst_doa_i1_006,inst_doa_i1_005,inst_doa_i1_004,inst_doa_i1_003,inst_doa_i1_002,inst_doa_i1_001,inst_doa_i1_000}));
  AL_MUX \inst_doa_mux_b0/al_mux_b0_0_0  (
    .i0(inst_doa_i0_000),
    .i1(inst_doa_i1_000),
    .sel(addra_piped),
    .o(doa[0]));
  AL_MUX \inst_doa_mux_b1/al_mux_b0_0_0  (
    .i0(inst_doa_i0_001),
    .i1(inst_doa_i1_001),
    .sel(addra_piped),
    .o(doa[1]));
  AL_MUX \inst_doa_mux_b10/al_mux_b0_0_0  (
    .i0(inst_doa_i0_002),
    .i1(inst_doa_i1_002),
    .sel(addra_piped),
    .o(doa[10]));
  AL_MUX \inst_doa_mux_b11/al_mux_b0_0_0  (
    .i0(inst_doa_i0_003),
    .i1(inst_doa_i1_003),
    .sel(addra_piped),
    .o(doa[11]));
  AL_MUX \inst_doa_mux_b12/al_mux_b0_0_0  (
    .i0(inst_doa_i0_004),
    .i1(inst_doa_i1_004),
    .sel(addra_piped),
    .o(doa[12]));
  AL_MUX \inst_doa_mux_b13/al_mux_b0_0_0  (
    .i0(inst_doa_i0_005),
    .i1(inst_doa_i1_005),
    .sel(addra_piped),
    .o(doa[13]));
  AL_MUX \inst_doa_mux_b14/al_mux_b0_0_0  (
    .i0(inst_doa_i0_006),
    .i1(inst_doa_i1_006),
    .sel(addra_piped),
    .o(doa[14]));
  AL_MUX \inst_doa_mux_b15/al_mux_b0_0_0  (
    .i0(inst_doa_i0_007),
    .i1(inst_doa_i1_007),
    .sel(addra_piped),
    .o(doa[15]));

endmodule 

module AL_DFF_X
  (
  ar,
  as,
  clk,
  d,
  en,
  sr,
  ss,
  q
  );

  input ar;
  input as;
  input clk;
  input d;
  input en;
  input sr;
  input ss;
  output q;

  wire enout;
  wire srout;
  wire ssout;

  AL_MUX u_en (
    .i0(q),
    .i1(d),
    .sel(en),
    .o(enout));
  AL_MUX u_reset (
    .i0(ssout),
    .i1(1'b0),
    .sel(sr),
    .o(srout));
  AL_DFF u_seq (
    .clk(clk),
    .d(srout),
    .reset(ar),
    .set(as),
    .q(q));
  AL_MUX u_set (
    .i0(enout),
    .i1(1'b1),
    .sel(ss),
    .o(ssout));

endmodule 

module AL_MUX
  (
  input i0,
  input i1,
  input sel,
  output o
  );

  wire not_sel, sel_i0, sel_i1;
  not u0 (not_sel, sel);
  and u1 (sel_i1, sel, i1);
  and u2 (sel_i0, not_sel, i0);
  or u3 (o, sel_i1, sel_i0);

endmodule

module AL_DFF
  (
  input reset,
  input set,
  input clk,
  input d,
  output reg q
  );

  parameter INI = 1'b0;

  // synthesis translate_off
  tri0 gsrn = glbl.gsrn;

  always @(gsrn)
  begin
    if(!gsrn)
      assign q = INI;
    else
      deassign q;
  end
  // synthesis translate_on

  always @(posedge reset or posedge set or posedge clk)
  begin
    if (reset)
      q <= 1'b0;
    else if (set)
      q <= 1'b1;
    else
      q <= d;
  end

endmodule
