liyuxuan3003/PrismGC/PrismGC/TD/al_ip/Test3_sim.v

// Verilog netlist created by TD v5.0.30786
// Sun Aug 13 22:56:59 2023

`timescale 1ns / 1ps
module TestRAM  // Test3.v(14)
  (
  addra,
  addrb,
  cea,
  ceb,
  clka,
  clkb,
  dia,
  oceb,
  rstb,
  dob
  );

  input [12:0] addra;  // Test3.v(35)
  input [12:0] addrb;  // Test3.v(36)
  input cea;  // Test3.v(37)
  input ceb;  // Test3.v(38)
  input clka;  // Test3.v(40)
  input clkb;  // Test3.v(41)
  input [31:0] dia;  // Test3.v(34)
  input oceb;  // Test3.v(39)
  input rstb;  // Test3.v(42)
  output [31:0] dob;  // Test3.v(31)

  parameter ADDR_WIDTH_A = 13;
  parameter ADDR_WIDTH_B = 13;
  parameter DATA_DEPTH_A = 8192;
  parameter DATA_DEPTH_B = 8192;
  parameter DATA_WIDTH_A = 32;
  parameter DATA_WIDTH_B = 32;
  parameter REGMODE_A = "NOREG";
  parameter REGMODE_B = "OUTREG";
  parameter WRITEMODE_A = "NORMAL";
  parameter WRITEMODE_B = "NORMAL";
  wire [0:2] addrb_piped;
  wire [0:2] addrb_piped_piped;
  wire  \inst_dob_mux_b0/B0_0 ;
  wire  \inst_dob_mux_b0/B0_1 ;
  wire  \inst_dob_mux_b0/B0_2 ;
  wire  \inst_dob_mux_b0/B0_3 ;
  wire  \inst_dob_mux_b0/B1_0 ;
  wire  \inst_dob_mux_b0/B1_1 ;
  wire  \inst_dob_mux_b1/B0_0 ;
  wire  \inst_dob_mux_b1/B0_1 ;
  wire  \inst_dob_mux_b1/B0_2 ;
  wire  \inst_dob_mux_b1/B0_3 ;
  wire  \inst_dob_mux_b1/B1_0 ;
  wire  \inst_dob_mux_b1/B1_1 ;
  wire  \inst_dob_mux_b10/B0_0 ;
  wire  \inst_dob_mux_b10/B0_1 ;
  wire  \inst_dob_mux_b10/B0_2 ;
  wire  \inst_dob_mux_b10/B0_3 ;
  wire  \inst_dob_mux_b10/B1_0 ;
  wire  \inst_dob_mux_b10/B1_1 ;
  wire  \inst_dob_mux_b11/B0_0 ;
  wire  \inst_dob_mux_b11/B0_1 ;
  wire  \inst_dob_mux_b11/B0_2 ;
  wire  \inst_dob_mux_b11/B0_3 ;
  wire  \inst_dob_mux_b11/B1_0 ;
  wire  \inst_dob_mux_b11/B1_1 ;
  wire  \inst_dob_mux_b12/B0_0 ;
  wire  \inst_dob_mux_b12/B0_1 ;
  wire  \inst_dob_mux_b12/B0_2 ;
  wire  \inst_dob_mux_b12/B0_3 ;
  wire  \inst_dob_mux_b12/B1_0 ;
  wire  \inst_dob_mux_b12/B1_1 ;
  wire  \inst_dob_mux_b13/B0_0 ;
  wire  \inst_dob_mux_b13/B0_1 ;
  wire  \inst_dob_mux_b13/B0_2 ;
  wire  \inst_dob_mux_b13/B0_3 ;
  wire  \inst_dob_mux_b13/B1_0 ;
  wire  \inst_dob_mux_b13/B1_1 ;
  wire  \inst_dob_mux_b14/B0_0 ;
  wire  \inst_dob_mux_b14/B0_1 ;
  wire  \inst_dob_mux_b14/B0_2 ;
  wire  \inst_dob_mux_b14/B0_3 ;
  wire  \inst_dob_mux_b14/B1_0 ;
  wire  \inst_dob_mux_b14/B1_1 ;
  wire  \inst_dob_mux_b15/B0_0 ;
  wire  \inst_dob_mux_b15/B0_1 ;
  wire  \inst_dob_mux_b15/B0_2 ;
  wire  \inst_dob_mux_b15/B0_3 ;
  wire  \inst_dob_mux_b15/B1_0 ;
  wire  \inst_dob_mux_b15/B1_1 ;
  wire  \inst_dob_mux_b16/B0_0 ;
  wire  \inst_dob_mux_b16/B0_1 ;
  wire  \inst_dob_mux_b16/B0_2 ;
  wire  \inst_dob_mux_b16/B0_3 ;
  wire  \inst_dob_mux_b16/B1_0 ;
  wire  \inst_dob_mux_b16/B1_1 ;
  wire  \inst_dob_mux_b17/B0_0 ;
  wire  \inst_dob_mux_b17/B0_1 ;
  wire  \inst_dob_mux_b17/B0_2 ;
  wire  \inst_dob_mux_b17/B0_3 ;
  wire  \inst_dob_mux_b17/B1_0 ;
  wire  \inst_dob_mux_b17/B1_1 ;
  wire  \inst_dob_mux_b18/B0_0 ;
  wire  \inst_dob_mux_b18/B0_1 ;
  wire  \inst_dob_mux_b18/B0_2 ;
  wire  \inst_dob_mux_b18/B0_3 ;
  wire  \inst_dob_mux_b18/B1_0 ;
  wire  \inst_dob_mux_b18/B1_1 ;
  wire  \inst_dob_mux_b19/B0_0 ;
  wire  \inst_dob_mux_b19/B0_1 ;
  wire  \inst_dob_mux_b19/B0_2 ;
  wire  \inst_dob_mux_b19/B0_3 ;
  wire  \inst_dob_mux_b19/B1_0 ;
  wire  \inst_dob_mux_b19/B1_1 ;
  wire  \inst_dob_mux_b2/B0_0 ;
  wire  \inst_dob_mux_b2/B0_1 ;
  wire  \inst_dob_mux_b2/B0_2 ;
  wire  \inst_dob_mux_b2/B0_3 ;
  wire  \inst_dob_mux_b2/B1_0 ;
  wire  \inst_dob_mux_b2/B1_1 ;
  wire  \inst_dob_mux_b20/B0_0 ;
  wire  \inst_dob_mux_b20/B0_1 ;
  wire  \inst_dob_mux_b20/B0_2 ;
  wire  \inst_dob_mux_b20/B0_3 ;
  wire  \inst_dob_mux_b20/B1_0 ;
  wire  \inst_dob_mux_b20/B1_1 ;
  wire  \inst_dob_mux_b21/B0_0 ;
  wire  \inst_dob_mux_b21/B0_1 ;
  wire  \inst_dob_mux_b21/B0_2 ;
  wire  \inst_dob_mux_b21/B0_3 ;
  wire  \inst_dob_mux_b21/B1_0 ;
  wire  \inst_dob_mux_b21/B1_1 ;
  wire  \inst_dob_mux_b22/B0_0 ;
  wire  \inst_dob_mux_b22/B0_1 ;
  wire  \inst_dob_mux_b22/B0_2 ;
  wire  \inst_dob_mux_b22/B0_3 ;
  wire  \inst_dob_mux_b22/B1_0 ;
  wire  \inst_dob_mux_b22/B1_1 ;
  wire  \inst_dob_mux_b23/B0_0 ;
  wire  \inst_dob_mux_b23/B0_1 ;
  wire  \inst_dob_mux_b23/B0_2 ;
  wire  \inst_dob_mux_b23/B0_3 ;
  wire  \inst_dob_mux_b23/B1_0 ;
  wire  \inst_dob_mux_b23/B1_1 ;
  wire  \inst_dob_mux_b24/B0_0 ;
  wire  \inst_dob_mux_b24/B0_1 ;
  wire  \inst_dob_mux_b24/B0_2 ;
  wire  \inst_dob_mux_b24/B0_3 ;
  wire  \inst_dob_mux_b24/B1_0 ;
  wire  \inst_dob_mux_b24/B1_1 ;
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
  wire inst_dob_i7_015;
  wire inst_dob_i7_016;
  wire inst_dob_i7_017;
  wire inst_dob_i7_018;
  wire inst_dob_i7_019;
  wire inst_dob_i7_020;
  wire inst_dob_i7_021;
  wire inst_dob_i7_022;
  wire inst_dob_i7_023;
  wire inst_dob_i7_024;
  wire inst_dob_i7_025;
  wire inst_dob_i7_026;

  assign dob[31] = inst_dob_i0_031;
  assign dob[30] = inst_dob_i0_030;
  assign dob[29] = inst_dob_i0_029;
  assign dob[28] = inst_dob_i0_028;
  assign dob[27] = inst_dob_i0_027;
  AL_DFF_X addrb_pipe_b0 (
    .ar(1'b0),
    .as(1'b0),
    .clk(clkb),
    .d(addrb[10]),
    .en(ceb),
    .sr(rstb),
    .ss(1'b0),
    .q(addrb_piped[0]));
  AL_DFF_X addrb_pipe_b1 (
    .ar(1'b0),
    .as(1'b0),
    .clk(clkb),
    .d(addrb[11]),
    .en(ceb),
    .sr(rstb),
    .ss(1'b0),
    .q(addrb_piped[1]));
  AL_DFF_X addrb_pipe_b2 (
    .ar(1'b0),
    .as(1'b0),
    .clk(clkb),
    .d(addrb[12]),
    .en(ceb),
    .sr(rstb),
    .ss(1'b0),
    .q(addrb_piped[2]));
  AL_DFF_X addrb_piped_pipe_b0 (
    .ar(1'b0),
    .as(1'b0),
    .clk(clkb),
    .d(addrb_piped[0]),
    .en(ceb),
    .sr(rstb),
    .ss(1'b0),
    .q(addrb_piped_piped[0]));
  AL_DFF_X addrb_piped_pipe_b1 (
    .ar(1'b0),
    .as(1'b0),
    .clk(clkb),
    .d(addrb_piped[1]),
    .en(ceb),
    .sr(rstb),
    .ss(1'b0),
    .q(addrb_piped_piped[1]));
  AL_DFF_X addrb_piped_pipe_b2 (
    .ar(1'b0),
    .as(1'b0),
    .clk(clkb),
    .d(addrb_piped[2]),
    .en(ceb),
    .sr(rstb),
    .ss(1'b0),
    .q(addrb_piped_piped[2]));
  EG_PHY_CONFIG #(
    .DONE_PERSISTN("ENABLE"),
    .INIT_PERSISTN("ENABLE"),
    .JTAG_PERSISTN("DISABLE"),
    .PROGRAMN_PERSISTN("DISABLE"))
    config_inst ();
  // address_offset=0;data_offset=0;depth=1024;width=9;num_section=1;width_per_section=9;section_size=32;working_depth=1024;working_width=9;mode_ecc=0;address_step=1;bytes_in_per_section=1;
  EG_PHY_BRAM #(
    .CSA0("INV"),
    .CSA1("INV"),
    .CSA2("INV"),
    .CSB0("INV"),
    .CSB1("INV"),
    .CSB2("INV"),
    .DATA_WIDTH_A("9"),
    .DATA_WIDTH_B("9"),
    .INITP_00(256'hFFFFFFFFFFFFFFFFFFFFFFFFFFFFFFFFFFFFFFFFFFFFFFFFFFFFFFFFFFFFFFFF),
    .INITP_01(256'hFFFFFFFFFFFFFFFFFFFFFFFFFFFFFFFFFFFFFFFFFFFFFFFFFFFFFFFFFFFFFFFF),
    .INITP_02(256'hFFFFFFFFFFFFFFFFFFFFFFFFFFFFFFFFFFFFFFFFFFFFFFFFFFFFFFFFFFFFFFFF),
    .INITP_03(256'hFFFFFFFFFFFFFFFFFFFFFFFFFFFFFFFFFFFFFFFFFFFFFFFFFFFFFFFFFFFFFFFF),
    .INIT_00(256'hFFFFFFFFFFFFFFFFFFFFFFFFFFFFFFFFFFFFFFFFFFFFFFFFFFFFFFFFFFFFFFFF),
    .INIT_01(256'hFFFFFFFFFFFFFFFFFFFFFFFFFFFFFFFFFFFFFFFFFFFFFFFFFFFFFFFFFFFFFFFF),
    .INIT_02(256'hFFFFFFFFFFFFFFFFFFFFFFFFFFFFFFFFFFFFFFFFFFFFFFFFFFFFFFFFFFFFFFFF),
    .INIT_03(256'hFFFFFFFFFFFFFFFFFFFFFFFFFFFFFFFFFFFFFFFFFFFFFFFFFFFFFFFFFFFFFFFF),
    .INIT_04(256'hFFFFFFFFFFFFFFFFFFFFFFFFFFFFFFFFFFFFFFFFFFFFFFFFFFFFFFFFFFFFFFFF),
    .INIT_05(256'hFFFFFFFFFFFFFFFFFFFFFFFFFFFFFFFFFFFFFFFFFFFFFFFFFFFFFFFFFFFFFFFF),
    .INIT_06(256'hFFFFFFFFFFFFFFFFFFFFFFFFFFFFFFFFFFFFFFFFFFFFFFFFFFFFFFFFFFFFFFFF),
    .INIT_07(256'hFFFFFFFFFFFFFFFFFFFFFFFFFFFFFFFFFFFFFFFFFFFFFFFFFFFFFFFFFFFFFFFF),
    .INIT_08(256'hFFFFFFFFFFFFFFFFFFFFFFFFFFFFFFFFFFFFFFFFFFFFFFFFFFFFFFFFFFFFFFFF),
    .INIT_09(256'hFFFFFFFFFFFFFFFFFFFFFFFFFFFFFFFFFFFFFFFFFFFFFFFFFFFFFFFFFFFFFFFF),
    .INIT_0A(256'hFFFFFFFFFFFFFFFFFFFFFFFFFFFFFFFFFFFFFFFFFFFFFFFFFFFFFFFFFFFFFFFF),
    .INIT_0B(256'hFFFFFFFFFFFFFFFFFFFFFFFFFFFFFFFFFFFFFFFFFFFFFFFFFFFFFFFFFFFFFFFF),
    .INIT_0C(256'hFFFFFFFFFFFFFFFFFFFFFFFFFFFFFFFFFFFFFFFFFFFFFFFFFFFFFFFFFFFFFFFF),
    .INIT_0D(256'hFFFFFFFFFFFFFFFFFFFFFFFFFFFFFFFFFFFFFFFFFFFFFFFFFFFFFFFFFFFFFFFF),
    .INIT_0E(256'hFFFFFFFFFFFFFFFFFFFFFFFFFFFFFFFFFFFFFFFFFFFFFFFFFFFFFFFFFFFFFFFF),
    .INIT_0F(256'hFFFFFFFFFFFFFFFFFFFFFFFFFFFFFFFFFFFFFFFFFFFFFFFFFFFFFFFFFFFFFFFF),
    .INIT_10(256'hFFFFFFFFFFFFFFFFFFFFFFFFFFFFFFFFFFFFFFFFFFFFFFFFFFFFFFFFFFFFFFFF),
    .INIT_11(256'hFFFFFFFFFFFFFFFFFFFFFFFFFFFFFFFFFFFFFFFFFFFFFFFFFFFFFFFFFFFFFFFF),
    .INIT_12(256'hFFFFFFFFFFFFFFFFFFFFFFFFFFFFFFFFFFFFFFFFFFFFFFFFFFFFFFFFFFFFFFFF),
    .INIT_13(256'hFFFFFFFFFFFFFFFFFFFFFFFFFFFFFFFFFFFFFFFFFFFFFFFFFFFFFFFFFFFFFFFF),
    .INIT_14(256'hFFFFFFFFFFFFFFFFFFFFFFFFFFFFFFFFFFFFFFFFFFFFFFFFFFFFFFFFFFFFFFFF),
    .INIT_15(256'hFFFFFFFFFFFFFFFFFFFFFFFFFFFFFFFFFFFFFFFFFFFFFFFFFFFFFFFFFFFFFFFF),
    .INIT_16(256'hFFFFFFFFFFFFFFFFFFFFFFFFFFFFFFFFFFFFFFFFFFFFFFFFFFFFFFFFFFFFFFFF),
    .INIT_17(256'hFFFFFFFFFFFFFFFFFFFFFFFFFFFFFFFFFFFFFFFFFFFFFFFFFFFFFFFFFFFFFFFF),
    .INIT_18(256'hFFFFFFFFFFFFFFFFFFFFFFFFFFFFFFFFFFFFFFFFFFFFFFFFFFFFFFFFFFFFFFFF),
    .INIT_19(256'hFFFFFFFFFFFFFFFFFFFFFFFFFFFFFFFFFFFFFFFFFFFFFFFFFFFFFFFFFFFFFFFF),
    .INIT_1A(256'hFFFFFFFFFFFFFFFFFFFFFFFFFFFFFFFFFFFFFFFFFFFFFFFFFFFFFFFFFFFFFFFF),
    .INIT_1B(256'hFFFFFFFFFFFFFFFFFFFFFFFFFFFFFFFFFFFFFFFFFFFFFFFFFFFFFFFFFFFFFFFF),
    .INIT_1C(256'hFFFFFFFFFFFFFFFFFFFFFFFFFFFFFFFFFFFFFFFFFFFFFFFFFFFFFFFFFFFFFFFF),
    .INIT_1D(256'hFFFFFFFFFFFFFFFFFFFFFFFFFFFFFFFFFFFFFFFFFFFFFFFFFFFFFFFFFFFFFFFF),
    .INIT_1E(256'hFFFFFFFFFFFFFFFFFFFFFFFFFFFFFFFFFFFFFFFFFFFFFFFFFFFFFFFFFFFFFFFF),
    .INIT_1F(256'hFFFFFFFFFFFFFFFFFFFFFFFFFFFFFFFFFFFFFFFFFFFFFFFFFFFFFFFFFFFFFFFF),
    .MODE("DP8K"),
    .OCEAMUX("0"),
    .REGMODE_A("NOREG"),
    .REGMODE_B("OUTREG"),
    .RESETMODE("SYNC"),
    .RSTAMUX("0"),
    .WEAMUX("1"),
    .WEBMUX("0"),
    .WRITEMODE_A("NORMAL"),
    .WRITEMODE_B("NORMAL"))
    inst_8192x32_sub_000000_000 (
    .addra({addra[9:0],3'b111}),
    .addrb({addrb[9:0],3'b111}),
    .cea(cea),
    .ceb(ceb),
    .clka(clka),
    .clkb(clkb),
    .csa(addra[12:10]),
    .csb(addrb[12:10]),
    .dia(dia[8:0]),
    .oceb(oceb),
    .rstb(rstb),
    .dob({inst_dob_i0_008,inst_dob_i0_007,inst_dob_i0_006,inst_dob_i0_005,inst_dob_i0_004,inst_dob_i0_003,inst_dob_i0_002,inst_dob_i0_001,inst_dob_i0_000}));
  // address_offset=0;data_offset=9;depth=1024;width=9;num_section=1;width_per_section=9;section_size=32;working_depth=1024;working_width=9;mode_ecc=0;address_step=1;bytes_in_per_section=1;
  EG_PHY_BRAM #(
    .CSA0("INV"),
    .CSA1("INV"),
    .CSA2("INV"),
    .CSB0("INV"),
    .CSB1("INV"),
    .CSB2("INV"),
    .DATA_WIDTH_A("9"),
    .DATA_WIDTH_B("9"),
    .INITP_00(256'hFFFFFFFFFFFFFFFFFFFFFFFFFFFFFFFFFFFFFFFFFFFFFFFFFFFFFFFFFFFFFFFF),
    .INITP_01(256'hFFFFFFFFFFFFFFFFFFFFFFFFFFFFFFFFFFFFFFFFFFFFFFFFFFFFFFFFFFFFFFFF),
    .INITP_02(256'hFFFFFFFFFFFFFFFFFFFFFFFFFFFFFFFFFFFFFFFFFFFFFFFFFFFFFFFFFFFFFFFF),
    .INITP_03(256'hFFFFFFFFFFFFFFFFFFFFFFFFFFFFFFFFFFFFFFFFFFFFFFFFFFFFFFFFFFFFFFFF),
    .INIT_00(256'hFFFFFFFFFFFFFFFFFFFFFFFFFFFFFFFFFFFFFFFFFFFFFFFFFFFFFFFFFFFFFFFF),
    .INIT_01(256'hFFFFFFFFFFFFFFFFFFFFFFFFFFFFFFFFFFFFFFFFFFFFFFFFFFFFFFFFFFFFFFFF),
    .INIT_02(256'hFFFFFFFFFFFFFFFFFFFFFFFFFFFFFFFFFFFFFFFFFFFFFFFFFFFFFFFFFFFFFFFF),
    .INIT_03(256'hFFFFFFFFFFFFFFFFFFFFFFFFFFFFFFFFFFFFFFFFFFFFFFFFFFFFFFFFFFFFFFFF),
    .INIT_04(256'hFFFFFFFFFFFFFFFFFFFFFFFFFFFFFFFFFFFFFFFFFFFFFFFFFFFFFFFFFFFFFFFF),
    .INIT_05(256'hFFFFFFFFFFFFFFFFFFFFFFFFFFFFFFFFFFFFFFFFFFFFFFFFFFFFFFFFFFFFFFFF),
    .INIT_06(256'hFFFFFFFFFFFFFFFFFFFFFFFFFFFFFFFFFFFFFFFFFFFFFFFFFFFFFFFFFFFFFFFF),
    .INIT_07(256'hFFFFFFFFFFFFFFFFFFFFFFFFFFFFFFFFFFFFFFFFFFFFFFFFFFFFFFFFFFFFFFFF),
    .INIT_08(256'hFFFFFFFFFFFFFFFFFFFFFFFFFFFFFFFFFFFFFFFFFFFFFFFFFFFFFFFFFFFFFFFF),
    .INIT_09(256'hFFFFFFFFFFFFFFFFFFFFFFFFFFFFFFFFFFFFFFFFFFFFFFFFFFFFFFFFFFFFFFFF),
    .INIT_0A(256'hFFFFFFFFFFFFFFFFFFFFFFFFFFFFFFFFFFFFFFFFFFFFFFFFFFFFFFFFFFFFFFFF),
    .INIT_0B(256'hFFFFFFFFFFFFFFFFFFFFFFFFFFFFFFFFFFFFFFFFFFFFFFFFFFFFFFFFFFFFFFFF),
    .INIT_0C(256'hFFFFFFFFFFFFFFFFFFFFFFFFFFFFFFFFFFFFFFFFFFFFFFFFFFFFFFFFFFFFFFFF),
    .INIT_0D(256'hFFFFFFFFFFFFFFFFFFFFFFFFFFFFFFFFFFFFFFFFFFFFFFFFFFFFFFFFFFFFFFFF),
    .INIT_0E(256'hFFFFFFFFFFFFFFFFFFFFFFFFFFFFFFFFFFFFFFFFFFFFFFFFFFFFFFFFFFFFFFFF),
    .INIT_0F(256'hFFFFFFFFFFFFFFFFFFFFFFFFFFFFFFFFFFFFFFFFFFFFFFFFFFFFFFFFFFFFFFFF),
    .INIT_10(256'hFFFFFFFFFFFFFFFFFFFFFFFFFFFFFFFFFFFFFFFFFFFFFFFFFFFFFFFFFFFFFFFF),
    .INIT_11(256'hFFFFFFFFFFFFFFFFFFFFFFFFFFFFFFFFFFFFFFFFFFFFFFFFFFFFFFFFFFFFFFFF),
    .INIT_12(256'hFFFFFFFFFFFFFFFFFFFFFFFFFFFFFFFFFFFFFFFFFFFFFFFFFFFFFFFFFFFFFFFF),
    .INIT_13(256'hFFFFFFFFFFFFFFFFFFFFFFFFFFFFFFFFFFFFFFFFFFFFFFFFFFFFFFFFFFFFFFFF),
    .INIT_14(256'hFFFFFFFFFFFFFFFFFFFFFFFFFFFFFFFFFFFFFFFFFFFFFFFFFFFFFFFFFFFFFFFF),
    .INIT_15(256'hFFFFFFFFFFFFFFFFFFFFFFFFFFFFFFFFFFFFFFFFFFFFFFFFFFFFFFFFFFFFFFFF),
    .INIT_16(256'hFFFFFFFFFFFFFFFFFFFFFFFFFFFFFFFFFFFFFFFFFFFFFFFFFFFFFFFFFFFFFFFF),
    .INIT_17(256'hFFFFFFFFFFFFFFFFFFFFFFFFFFFFFFFFFFFFFFFFFFFFFFFFFFFFFFFFFFFFFFFF),
    .INIT_18(256'hFFFFFFFFFFFFFFFFFFFFFFFFFFFFFFFFFFFFFFFFFFFFFFFFFFFFFFFFFFFFFFFF),
    .INIT_19(256'hFFFFFFFFFFFFFFFFFFFFFFFFFFFFFFFFFFFFFFFFFFFFFFFFFFFFFFFFFFFFFFFF),
    .INIT_1A(256'hFFFFFFFFFFFFFFFFFFFFFFFFFFFFFFFFFFFFFFFFFFFFFFFFFFFFFFFFFFFFFFFF),
    .INIT_1B(256'hFFFFFFFFFFFFFFFFFFFFFFFFFFFFFFFFFFFFFFFFFFFFFFFFFFFFFFFFFFFFFFFF),
    .INIT_1C(256'hFFFFFFFFFFFFFFFFFFFFFFFFFFFFFFFFFFFFFFFFFFFFFFFFFFFFFFFFFFFFFFFF),
    .INIT_1D(256'hFFFFFFFFFFFFFFFFFFFFFFFFFFFFFFFFFFFFFFFFFFFFFFFFFFFFFFFFFFFFFFFF),
    .INIT_1E(256'hFFFFFFFFFFFFFFFFFFFFFFFFFFFFFFFFFFFFFFFFFFFFFFFFFFFFFFFFFFFFFFFF),
    .INIT_1F(256'hFFFFFFFFFFFFFFFFFFFFFFFFFFFFFFFFFFFFFFFFFFFFFFFFFFFFFFFFFFFFFFFF),
    .MODE("DP8K"),
    .OCEAMUX("0"),
    .REGMODE_A("NOREG"),
    .REGMODE_B("OUTREG"),
    .RESETMODE("SYNC"),
    .RSTAMUX("0"),
    .WEAMUX("1"),
    .WEBMUX("0"),
    .WRITEMODE_A("NORMAL"),
    .WRITEMODE_B("NORMAL"))
    inst_8192x32_sub_000000_009 (
    .addra({addra[9:0],3'b111}),
    .addrb({addrb[9:0],3'b111}),
    .cea(cea),
    .ceb(ceb),
    .clka(clka),
    .clkb(clkb),
    .csa(addra[12:10]),
    .csb(addrb[12:10]),
    .dia(dia[17:9]),
    .oceb(oceb),
    .rstb(rstb),
    .dob({inst_dob_i0_017,inst_dob_i0_016,inst_dob_i0_015,inst_dob_i0_014,inst_dob_i0_013,inst_dob_i0_012,inst_dob_i0_011,inst_dob_i0_010,inst_dob_i0_009}));
  // address_offset=0;data_offset=18;depth=1024;width=9;num_section=1;width_per_section=9;section_size=32;working_depth=1024;working_width=9;mode_ecc=0;address_step=1;bytes_in_per_section=1;
  EG_PHY_BRAM #(
    .CSA0("INV"),
    .CSA1("INV"),
    .CSA2("INV"),
    .CSB0("INV"),
    .CSB1("INV"),
    .CSB2("INV"),
    .DATA_WIDTH_A("9"),
    .DATA_WIDTH_B("9"),
    .INITP_00(256'hFFFFFFFFFFFFFFFFFFFFFFFFFFFFFFFFFFFFFFFFFFFFFFFFFFFFFFFFFFFFFFFF),
    .INITP_01(256'hFFFFFFFFFFFFFFFFFFFFFFFFFFFFFFFFFFFFFFFFFFFFFFFFFFFFFFFFFFFFFFFF),
    .INITP_02(256'hFFFFFFFFFFFFFFFFFFFFFFFFFFFFFFFFFFFFFFFFFFFFFFFFFFFFFFFFFFFFFFFF),
    .INITP_03(256'hFFFFFFFFFFFFFFFFFFFFFFFFFFFFFFFFFFFFFFFFFFFFFFFFFFFFFFFFFFFFFFFF),
    .INIT_00(256'hFFFFFFFFFFFFFFFFFFFFFFFFFFFFFFFFFFFFFFFFFFFFFFFFFFFFFFFFFFFFFFFF),
    .INIT_01(256'hFFFFFFFFFFFFFFFFFFFFFFFFFFFFFFFFFFFFFFFFFFFFFFFFFFFFFFFFFFFFFFFF),
    .INIT_02(256'hFFFFFFFFFFFFFFFFFFFFFFFFFFFFFFFFFFFFFFFFFFFFFFFFFFFFFFFFFFFFFFFF),
    .INIT_03(256'hFFFFFFFFFFFFFFFFFFFFFFFFFFFFFFFFFFFFFFFFFFFFFFFFFFFFFFFFFFFFFFFF),
    .INIT_04(256'hFFFFFFFFFFFFFFFFFFFFFFFFFFFFFFFFFFFFFFFFFFFFFFFFFFFFFFFFFFFFFFFF),
    .INIT_05(256'hFFFFFFFFFFFFFFFFFFFFFFFFFFFFFFFFFFFFFFFFFFFFFFFFFFFFFFFFFFFFFFFF),
    .INIT_06(256'hFFFFFFFFFFFFFFFFFFFFFFFFFFFFFFFFFFFFFFFFFFFFFFFFFFFFFFFFFFFFFFFF),
    .INIT_07(256'hFFFFFFFFFFFFFFFFFFFFFFFFFFFFFFFFFFFFFFFFFFFFFFFFFFFFFFFFFFFFFFFF),
    .INIT_08(256'hFFFFFFFFFFFFFFFFFFFFFFFFFFFFFFFFFFFFFFFFFFFFFFFFFFFFFFFFFFFFFFFF),
    .INIT_09(256'hFFFFFFFFFFFFFFFFFFFFFFFFFFFFFFFFFFFFFFFFFFFFFFFFFFFFFFFFFFFFFFFF),
    .INIT_0A(256'hFFFFFFFFFFFFFFFFFFFFFFFFFFFFFFFFFFFFFFFFFFFFFFFFFFFFFFFFFFFFFFFF),
    .INIT_0B(256'hFFFFFFFFFFFFFFFFFFFFFFFFFFFFFFFFFFFFFFFFFFFFFFFFFFFFFFFFFFFFFFFF),
    .INIT_0C(256'hFFFFFFFFFFFFFFFFFFFFFFFFFFFFFFFFFFFFFFFFFFFFFFFFFFFFFFFFFFFFFFFF),
    .INIT_0D(256'hFFFFFFFFFFFFFFFFFFFFFFFFFFFFFFFFFFFFFFFFFFFFFFFFFFFFFFFFFFFFFFFF),
    .INIT_0E(256'hFFFFFFFFFFFFFFFFFFFFFFFFFFFFFFFFFFFFFFFFFFFFFFFFFFFFFFFFFFFFFFFF),
    .INIT_0F(256'hFFFFFFFFFFFFFFFFFFFFFFFFFFFFFFFFFFFFFFFFFFFFFFFFFFFFFFFFFFFFFFFF),
    .INIT_10(256'hFFFFFFFFFFFFFFFFFFFFFFFFFFFFFFFFFFFFFFFFFFFFFFFFFFFFFFFFFFFFFFFF),
    .INIT_11(256'hFFFFFFFFFFFFFFFFFFFFFFFFFFFFFFFFFFFFFFFFFFFFFFFFFFFFFFFFFFFFFFFF),
    .INIT_12(256'hFFFFFFFFFFFFFFFFFFFFFFFFFFFFFFFFFFFFFFFFFFFFFFFFFFFFFFFFFFFFFFFF),
    .INIT_13(256'hFFFFFFFFFFFFFFFFFFFFFFFFFFFFFFFFFFFFFFFFFFFFFFFFFFFFFFFFFFFFFFFF),
    .INIT_14(256'hFFFFFFFFFFFFFFFFFFFFFFFFFFFFFFFFFFFFFFFFFFFFFFFFFFFFFFFFFFFFFFFF),
    .INIT_15(256'hFFFFFFFFFFFFFFFFFFFFFFFFFFFFFFFFFFFFFFFFFFFFFFFFFFFFFFFFFFFFFFFF),
    .INIT_16(256'hFFFFFFFFFFFFFFFFFFFFFFFFFFFFFFFFFFFFFFFFFFFFFFFFFFFFFFFFFFFFFFFF),
    .INIT_17(256'hFFFFFFFFFFFFFFFFFFFFFFFFFFFFFFFFFFFFFFFFFFFFFFFFFFFFFFFFFFFFFFFF),
    .INIT_18(256'hFFFFFFFFFFFFFFFFFFFFFFFFFFFFFFFFFFFFFFFFFFFFFFFFFFFFFFFFFFFFFFFF),
    .INIT_19(256'hFFFFFFFFFFFFFFFFFFFFFFFFFFFFFFFFFFFFFFFFFFFFFFFFFFFFFFFFFFFFFFFF),
    .INIT_1A(256'hFFFFFFFFFFFFFFFFFFFFFFFFFFFFFFFFFFFFFFFFFFFFFFFFFFFFFFFFFFFFFFFF),
    .INIT_1B(256'hFFFFFFFFFFFFFFFFFFFFFFFFFFFFFFFFFFFFFFFFFFFFFFFFFFFFFFFFFFFFFFFF),
    .INIT_1C(256'hFFFFFFFFFFFFFFFFFFFFFFFFFFFFFFFFFFFFFFFFFFFFFFFFFFFFFFFFFFFFFFFF),
    .INIT_1D(256'hFFFFFFFFFFFFFFFFFFFFFFFFFFFFFFFFFFFFFFFFFFFFFFFFFFFFFFFFFFFFFFFF),
    .INIT_1E(256'hFFFFFFFFFFFFFFFFFFFFFFFFFFFFFFFFFFFFFFFFFFFFFFFFFFFFFFFFFFFFFFFF),
    .INIT_1F(256'hFFFFFFFFFFFFFFFFFFFFFFFFFFFFFFFFFFFFFFFFFFFFFFFFFFFFFFFFFFFFFFFF),
    .MODE("DP8K"),
    .OCEAMUX("0"),
    .REGMODE_A("NOREG"),
    .REGMODE_B("OUTREG"),
    .RESETMODE("SYNC"),
    .RSTAMUX("0"),
    .WEAMUX("1"),
    .WEBMUX("0"),
    .WRITEMODE_A("NORMAL"),
    .WRITEMODE_B("NORMAL"))
    inst_8192x32_sub_000000_018 (
    .addra({addra[9:0],3'b111}),
    .addrb({addrb[9:0],3'b111}),
    .cea(cea),
    .ceb(ceb),
    .clka(clka),
    .clkb(clkb),
    .csa(addra[12:10]),
    .csb(addrb[12:10]),
    .dia(dia[26:18]),
    .oceb(oceb),
    .rstb(rstb),
    .dob({inst_dob_i0_026,inst_dob_i0_025,inst_dob_i0_024,inst_dob_i0_023,inst_dob_i0_022,inst_dob_i0_021,inst_dob_i0_020,inst_dob_i0_019,inst_dob_i0_018}));
  // address_offset=0;data_offset=27;depth=8192;width=1;num_section=1;width_per_section=1;section_size=32;working_depth=8192;working_width=1;mode_ecc=0;address_step=1;bytes_in_per_section=1;
  EG_PHY_BRAM #(
    .CSA0("1"),
    .CSA1("1"),
    .CSA2("1"),
    .CSB0("1"),
    .CSB1("1"),
    .CSB2("1"),
    .DATA_WIDTH_A("1"),
    .DATA_WIDTH_B("1"),
    .INITP_00(256'h0000000000000000000000000000000000000000000000000000000000000000),
    .INITP_01(256'h0000000000000000000000000000000000000000000000000000000000000000),
    .INITP_02(256'h0000000000000000000000000000000000000000000000000000000000000000),
    .INITP_03(256'h0000000000000000000000000000000000000000000000000000000000000000),
    .INIT_00(256'hFFFFFFFFFFFFFFFFFFFFFFFFFFFFFFFFFFFFFFFFFFFFFFFFFFFFFFFFFFFFFFFF),
    .INIT_01(256'hFFFFFFFFFFFFFFFFFFFFFFFFFFFFFFFFFFFFFFFFFFFFFFFFFFFFFFFFFFFFFFFF),
    .INIT_02(256'hFFFFFFFFFFFFFFFFFFFFFFFFFFFFFFFFFFFFFFFFFFFFFFFFFFFFFFFFFFFFFFFF),
    .INIT_03(256'hFFFFFFFFFFFFFFFFFFFFFFFFFFFFFFFFFFFFFFFFFFFFFFFFFFFFFFFFFFFFFFFF),
    .INIT_04(256'hFFFFFFFFFFFFFFFFFFFFFFFFFFFFFFFFFFFFFFFFFFFFFFFFFFFFFFFFFFFFFFFF),
    .INIT_05(256'hFFFFFFFFFFFFFFFFFFFFFFFFFFFFFFFFFFFFFFFFFFFFFFFFFFFFFFFFFFFFFFFF),
    .INIT_06(256'hFFFFFFFFFFFFFFFFFFFFFFFFFFFFFFFFFFFFFFFFFFFFFFFFFFFFFFFFFFFFFFFF),
    .INIT_07(256'hFFFFFFFFFFFFFFFFFFFFFFFFFFFFFFFFFFFFFFFFFFFFFFFFFFFFFFFFFFFFFFFF),
    .INIT_08(256'hFFFFFFFFFFFFFFFFFFFFFFFFFFFFFFFFFFFFFFFFFFFFFFFFFFFFFFFFFFFFFFFF),
    .INIT_09(256'hFFFFFFFFFFFFFFFFFFFFFFFFFFFFFFFFFFFFFFFFFFFFFFFFFFFFFFFFFFFFFFFF),
    .INIT_0A(256'hFFFFFFFFFFFFFFFFFFFFFFFFFFFFFFFFFFFFFFFFFFFFFFFFFFFFFFFFFFFFFFFF),
    .INIT_0B(256'hFFFFFFFFFFFFFFFFFFFFFFFFFFFFFFFFFFFFFFFFFFFFFFFFFFFFFFFFFFFFFFFF),
    .INIT_0C(256'hFFFFFFFFFFFFFFFFFFFFFFFFFFFFFFFFFFFFFFFFFFFFFFFFFFFFFFFFFFFFFFFF),
    .INIT_0D(256'hFFFFFFFFFFFFFFFFFFFFFFFFFFFFFFFFFFFFFFFFFFFFFFFFFFFFFFFFFFFFFFFF),
    .INIT_0E(256'hFFFFFFFFFFFFFFFFFFFFFFFFFFFFFFFFFFFFFFFFFFFFFFFFFFFFFFFFFFFFFFFF),
    .INIT_0F(256'hFFFFFFFFFFFFFFFFFFFFFFFFFFFFFFFFFFFFFFFFFFFFFFFFFFFFFFFFFFFFFFFF),
    .INIT_10(256'hFFFFFFFFFFFFFFFFFFFFFFFFFFFFFFFFFFFFFFFFFFFFFFFFFFFFFFFFFFFFFFFF),
    .INIT_11(256'hFFFFFFFFFFFFFFFFFFFFFFFFFFFFFFFFFFFFFFFFFFFFFFFFFFFFFFFFFFFFFFFF),
    .INIT_12(256'hFFFFFFFFFFFFFFFFFFFFFFFFFFFFFFFFFFFFFFFFFFFFFFFFFFFFFFFFFFFFFFFF),
    .INIT_13(256'hFFFFFFFFFFFFFFFFFFFFFFFFFFFFFFFFFFFFFFFFFFFFFFFFFFFFFFFFFFFFFFFF),
    .INIT_14(256'hFFFFFFFFFFFFFFFFFFFFFFFFFFFFFFFFFFFFFFFFFFFFFFFFFFFFFFFFFFFFFFFF),
    .INIT_15(256'hFFFFFFFFFFFFFFFFFFFFFFFFFFFFFFFFFFFFFFFFFFFFFFFFFFFFFFFFFFFFFFFF),
    .INIT_16(256'hFFFFFFFFFFFFFFFFFFFFFFFFFFFFFFFFFFFFFFFFFFFFFFFFFFFFFFFFFFFFFFFF),
    .INIT_17(256'hFFFFFFFFFFFFFFFFFFFFFFFFFFFFFFFFFFFFFFFFFFFFFFFFFFFFFFFFFFFFFFFF),
    .INIT_18(256'hFFFFFFFFFFFFFFFFFFFFFFFFFFFFFFFFFFFFFFFFFFFFFFFFFFFFFFFFFFFFFFFF),
    .INIT_19(256'hFFFFFFFFFFFFFFFFFFFFFFFFFFFFFFFFFFFFFFFFFFFFFFFFFFFFFFFFFFFFFFFF),
    .INIT_1A(256'hFFFFFFFFFFFFFFFFFFFFFFFFFFFFFFFFFFFFFFFFFFFFFFFFFFFFFFFFFFFFFFFF),
    .INIT_1B(256'hFFFFFFFFFFFFFFFFFFFFFFFFFFFFFFFFFFFFFFFFFFFFFFFFFFFFFFFFFFFFFFFF),
    .INIT_1C(256'hFFFFFFFFFFFFFFFFFFFFFFFFFFFFFFFFFFFFFFFFFFFFFFFFFFFFFFFFFFFFFFFF),
    .INIT_1D(256'hFFFFFFFFFFFFFFFFFFFFFFFFFFFFFFFFFFFFFFFFFFFFFFFFFFFFFFFFFFFFFFFF),
    .INIT_1E(256'hFFFFFFFFFFFFFFFFFFFFFFFFFFFFFFFFFFFFFFFFFFFFFFFFFFFFFFFFFFFFFFFF),
    .INIT_1F(256'hFFFFFFFFFFFFFFFFFFFFFFFFFFFFFFFFFFFFFFFFFFFFFFFFFFFFFFFFFFFFFFFF),
    .MODE("DP8K"),
    .OCEAMUX("0"),
    .REGMODE_A("NOREG"),
    .REGMODE_B("OUTREG"),
    .RESETMODE("SYNC"),
    .RSTAMUX("0"),
    .WEAMUX("1"),
    .WEBMUX("0"),
    .WRITEMODE_A("NORMAL"),
    .WRITEMODE_B("NORMAL"))
    inst_8192x32_sub_000000_027 (
    .addra(addra),
    .addrb(addrb),
    .cea(cea),
    .ceb(ceb),
    .clka(clka),
    .clkb(clkb),
    .dia({open_n119,open_n120,open_n121,open_n122,open_n123,open_n124,open_n125,dia[27],open_n126}),
    .oceb(oceb),
    .rstb(rstb),
    .dob({open_n149,open_n150,open_n151,open_n152,open_n153,open_n154,open_n155,open_n156,inst_dob_i0_027}));
  // address_offset=0;data_offset=28;depth=8192;width=1;num_section=1;width_per_section=1;section_size=32;working_depth=8192;working_width=1;mode_ecc=0;address_step=1;bytes_in_per_section=1;
  EG_PHY_BRAM #(
    .CSA0("1"),
    .CSA1("1"),
    .CSA2("1"),
    .CSB0("1"),
    .CSB1("1"),
    .CSB2("1"),
    .DATA_WIDTH_A("1"),
    .DATA_WIDTH_B("1"),
    .INITP_00(256'h0000000000000000000000000000000000000000000000000000000000000000),
    .INITP_01(256'h0000000000000000000000000000000000000000000000000000000000000000),
    .INITP_02(256'h0000000000000000000000000000000000000000000000000000000000000000),
    .INITP_03(256'h0000000000000000000000000000000000000000000000000000000000000000),
    .INIT_00(256'hFFFFFFFFFFFFFFFFFFFFFFFFFFFFFFFFFFFFFFFFFFFFFFFFFFFFFFFFFFFFFFFF),
    .INIT_01(256'hFFFFFFFFFFFFFFFFFFFFFFFFFFFFFFFFFFFFFFFFFFFFFFFFFFFFFFFFFFFFFFFF),
    .INIT_02(256'hFFFFFFFFFFFFFFFFFFFFFFFFFFFFFFFFFFFFFFFFFFFFFFFFFFFFFFFFFFFFFFFF),
    .INIT_03(256'hFFFFFFFFFFFFFFFFFFFFFFFFFFFFFFFFFFFFFFFFFFFFFFFFFFFFFFFFFFFFFFFF),
    .INIT_04(256'hFFFFFFFFFFFFFFFFFFFFFFFFFFFFFFFFFFFFFFFFFFFFFFFFFFFFFFFFFFFFFFFF),
    .INIT_05(256'hFFFFFFFFFFFFFFFFFFFFFFFFFFFFFFFFFFFFFFFFFFFFFFFFFFFFFFFFFFFFFFFF),
    .INIT_06(256'hFFFFFFFFFFFFFFFFFFFFFFFFFFFFFFFFFFFFFFFFFFFFFFFFFFFFFFFFFFFFFFFF),
    .INIT_07(256'hFFFFFFFFFFFFFFFFFFFFFFFFFFFFFFFFFFFFFFFFFFFFFFFFFFFFFFFFFFFFFFFF),
    .INIT_08(256'hFFFFFFFFFFFFFFFFFFFFFFFFFFFFFFFFFFFFFFFFFFFFFFFFFFFFFFFFFFFFFFFF),
    .INIT_09(256'hFFFFFFFFFFFFFFFFFFFFFFFFFFFFFFFFFFFFFFFFFFFFFFFFFFFFFFFFFFFFFFFF),
    .INIT_0A(256'hFFFFFFFFFFFFFFFFFFFFFFFFFFFFFFFFFFFFFFFFFFFFFFFFFFFFFFFFFFFFFFFF),
    .INIT_0B(256'hFFFFFFFFFFFFFFFFFFFFFFFFFFFFFFFFFFFFFFFFFFFFFFFFFFFFFFFFFFFFFFFF),
    .INIT_0C(256'hFFFFFFFFFFFFFFFFFFFFFFFFFFFFFFFFFFFFFFFFFFFFFFFFFFFFFFFFFFFFFFFF),
    .INIT_0D(256'hFFFFFFFFFFFFFFFFFFFFFFFFFFFFFFFFFFFFFFFFFFFFFFFFFFFFFFFFFFFFFFFF),
    .INIT_0E(256'hFFFFFFFFFFFFFFFFFFFFFFFFFFFFFFFFFFFFFFFFFFFFFFFFFFFFFFFFFFFFFFFF),
    .INIT_0F(256'hFFFFFFFFFFFFFFFFFFFFFFFFFFFFFFFFFFFFFFFFFFFFFFFFFFFFFFFFFFFFFFFF),
    .INIT_10(256'hFFFFFFFFFFFFFFFFFFFFFFFFFFFFFFFFFFFFFFFFFFFFFFFFFFFFFFFFFFFFFFFF),
    .INIT_11(256'hFFFFFFFFFFFFFFFFFFFFFFFFFFFFFFFFFFFFFFFFFFFFFFFFFFFFFFFFFFFFFFFF),
    .INIT_12(256'hFFFFFFFFFFFFFFFFFFFFFFFFFFFFFFFFFFFFFFFFFFFFFFFFFFFFFFFFFFFFFFFF),
    .INIT_13(256'hFFFFFFFFFFFFFFFFFFFFFFFFFFFFFFFFFFFFFFFFFFFFFFFFFFFFFFFFFFFFFFFF),
    .INIT_14(256'hFFFFFFFFFFFFFFFFFFFFFFFFFFFFFFFFFFFFFFFFFFFFFFFFFFFFFFFFFFFFFFFF),
    .INIT_15(256'hFFFFFFFFFFFFFFFFFFFFFFFFFFFFFFFFFFFFFFFFFFFFFFFFFFFFFFFFFFFFFFFF),
    .INIT_16(256'hFFFFFFFFFFFFFFFFFFFFFFFFFFFFFFFFFFFFFFFFFFFFFFFFFFFFFFFFFFFFFFFF),
    .INIT_17(256'hFFFFFFFFFFFFFFFFFFFFFFFFFFFFFFFFFFFFFFFFFFFFFFFFFFFFFFFFFFFFFFFF),
    .INIT_18(256'hFFFFFFFFFFFFFFFFFFFFFFFFFFFFFFFFFFFFFFFFFFFFFFFFFFFFFFFFFFFFFFFF),
    .INIT_19(256'hFFFFFFFFFFFFFFFFFFFFFFFFFFFFFFFFFFFFFFFFFFFFFFFFFFFFFFFFFFFFFFFF),
    .INIT_1A(256'hFFFFFFFFFFFFFFFFFFFFFFFFFFFFFFFFFFFFFFFFFFFFFFFFFFFFFFFFFFFFFFFF),
    .INIT_1B(256'hFFFFFFFFFFFFFFFFFFFFFFFFFFFFFFFFFFFFFFFFFFFFFFFFFFFFFFFFFFFFFFFF),
    .INIT_1C(256'hFFFFFFFFFFFFFFFFFFFFFFFFFFFFFFFFFFFFFFFFFFFFFFFFFFFFFFFFFFFFFFFF),
    .INIT_1D(256'hFFFFFFFFFFFFFFFFFFFFFFFFFFFFFFFFFFFFFFFFFFFFFFFFFFFFFFFFFFFFFFFF),
    .INIT_1E(256'hFFFFFFFFFFFFFFFFFFFFFFFFFFFFFFFFFFFFFFFFFFFFFFFFFFFFFFFFFFFFFFFF),
    .INIT_1F(256'hFFFFFFFFFFFFFFFFFFFFFFFFFFFFFFFFFFFFFFFFFFFFFFFFFFFFFFFFFFFFFFFF),
    .MODE("DP8K"),
    .OCEAMUX("0"),
    .REGMODE_A("NOREG"),
    .REGMODE_B("OUTREG"),
    .RESETMODE("SYNC"),
    .RSTAMUX("0"),
    .WEAMUX("1"),
    .WEBMUX("0"),
    .WRITEMODE_A("NORMAL"),
    .WRITEMODE_B("NORMAL"))
    inst_8192x32_sub_000000_028 (
    .addra(addra),
    .addrb(addrb),
    .cea(cea),
    .ceb(ceb),
    .clka(clka),
    .clkb(clkb),
    .dia({open_n163,open_n164,open_n165,open_n166,open_n167,open_n168,open_n169,dia[28],open_n170}),
    .oceb(oceb),
    .rstb(rstb),
    .dob({open_n193,open_n194,open_n195,open_n196,open_n197,open_n198,open_n199,open_n200,inst_dob_i0_028}));
  // address_offset=0;data_offset=29;depth=8192;width=1;num_section=1;width_per_section=1;section_size=32;working_depth=8192;working_width=1;mode_ecc=0;address_step=1;bytes_in_per_section=1;
  EG_PHY_BRAM #(
    .CSA0("1"),
    .CSA1("1"),
    .CSA2("1"),
    .CSB0("1"),
    .CSB1("1"),
    .CSB2("1"),
    .DATA_WIDTH_A("1"),
    .DATA_WIDTH_B("1"),
    .INITP_00(256'h0000000000000000000000000000000000000000000000000000000000000000),
    .INITP_01(256'h0000000000000000000000000000000000000000000000000000000000000000),
    .INITP_02(256'h0000000000000000000000000000000000000000000000000000000000000000),
    .INITP_03(256'h0000000000000000000000000000000000000000000000000000000000000000),
    .INIT_00(256'hFFFFFFFFFFFFFFFFFFFFFFFFFFFFFFFFFFFFFFFFFFFFFFFFFFFFFFFFFFFFFFFF),
    .INIT_01(256'hFFFFFFFFFFFFFFFFFFFFFFFFFFFFFFFFFFFFFFFFFFFFFFFFFFFFFFFFFFFFFFFF),
    .INIT_02(256'hFFFFFFFFFFFFFFFFFFFFFFFFFFFFFFFFFFFFFFFFFFFFFFFFFFFFFFFFFFFFFFFF),
    .INIT_03(256'hFFFFFFFFFFFFFFFFFFFFFFFFFFFFFFFFFFFFFFFFFFFFFFFFFFFFFFFFFFFFFFFF),
    .INIT_04(256'hFFFFFFFFFFFFFFFFFFFFFFFFFFFFFFFFFFFFFFFFFFFFFFFFFFFFFFFFFFFFFFFF),
    .INIT_05(256'hFFFFFFFFFFFFFFFFFFFFFFFFFFFFFFFFFFFFFFFFFFFFFFFFFFFFFFFFFFFFFFFF),
    .INIT_06(256'hFFFFFFFFFFFFFFFFFFFFFFFFFFFFFFFFFFFFFFFFFFFFFFFFFFFFFFFFFFFFFFFF),
    .INIT_07(256'hFFFFFFFFFFFFFFFFFFFFFFFFFFFFFFFFFFFFFFFFFFFFFFFFFFFFFFFFFFFFFFFF),
    .INIT_08(256'hFFFFFFFFFFFFFFFFFFFFFFFFFFFFFFFFFFFFFFFFFFFFFFFFFFFFFFFFFFFFFFFF),
    .INIT_09(256'hFFFFFFFFFFFFFFFFFFFFFFFFFFFFFFFFFFFFFFFFFFFFFFFFFFFFFFFFFFFFFFFF),
    .INIT_0A(256'hFFFFFFFFFFFFFFFFFFFFFFFFFFFFFFFFFFFFFFFFFFFFFFFFFFFFFFFFFFFFFFFF),
    .INIT_0B(256'hFFFFFFFFFFFFFFFFFFFFFFFFFFFFFFFFFFFFFFFFFFFFFFFFFFFFFFFFFFFFFFFF),
    .INIT_0C(256'hFFFFFFFFFFFFFFFFFFFFFFFFFFFFFFFFFFFFFFFFFFFFFFFFFFFFFFFFFFFFFFFF),
    .INIT_0D(256'hFFFFFFFFFFFFFFFFFFFFFFFFFFFFFFFFFFFFFFFFFFFFFFFFFFFFFFFFFFFFFFFF),
    .INIT_0E(256'hFFFFFFFFFFFFFFFFFFFFFFFFFFFFFFFFFFFFFFFFFFFFFFFFFFFFFFFFFFFFFFFF),
    .INIT_0F(256'hFFFFFFFFFFFFFFFFFFFFFFFFFFFFFFFFFFFFFFFFFFFFFFFFFFFFFFFFFFFFFFFF),
    .INIT_10(256'hFFFFFFFFFFFFFFFFFFFFFFFFFFFFFFFFFFFFFFFFFFFFFFFFFFFFFFFFFFFFFFFF),
    .INIT_11(256'hFFFFFFFFFFFFFFFFFFFFFFFFFFFFFFFFFFFFFFFFFFFFFFFFFFFFFFFFFFFFFFFF),
    .INIT_12(256'hFFFFFFFFFFFFFFFFFFFFFFFFFFFFFFFFFFFFFFFFFFFFFFFFFFFFFFFFFFFFFFFF),
    .INIT_13(256'hFFFFFFFFFFFFFFFFFFFFFFFFFFFFFFFFFFFFFFFFFFFFFFFFFFFFFFFFFFFFFFFF),
    .INIT_14(256'hFFFFFFFFFFFFFFFFFFFFFFFFFFFFFFFFFFFFFFFFFFFFFFFFFFFFFFFFFFFFFFFF),
    .INIT_15(256'hFFFFFFFFFFFFFFFFFFFFFFFFFFFFFFFFFFFFFFFFFFFFFFFFFFFFFFFFFFFFFFFF),
    .INIT_16(256'hFFFFFFFFFFFFFFFFFFFFFFFFFFFFFFFFFFFFFFFFFFFFFFFFFFFFFFFFFFFFFFFF),
    .INIT_17(256'hFFFFFFFFFFFFFFFFFFFFFFFFFFFFFFFFFFFFFFFFFFFFFFFFFFFFFFFFFFFFFFFF),
    .INIT_18(256'hFFFFFFFFFFFFFFFFFFFFFFFFFFFFFFFFFFFFFFFFFFFFFFFFFFFFFFFFFFFFFFFF),
    .INIT_19(256'hFFFFFFFFFFFFFFFFFFFFFFFFFFFFFFFFFFFFFFFFFFFFFFFFFFFFFFFFFFFFFFFF),
    .INIT_1A(256'hFFFFFFFFFFFFFFFFFFFFFFFFFFFFFFFFFFFFFFFFFFFFFFFFFFFFFFFFFFFFFFFF),
    .INIT_1B(256'hFFFFFFFFFFFFFFFFFFFFFFFFFFFFFFFFFFFFFFFFFFFFFFFFFFFFFFFFFFFFFFFF),
    .INIT_1C(256'hFFFFFFFFFFFFFFFFFFFFFFFFFFFFFFFFFFFFFFFFFFFFFFFFFFFFFFFFFFFFFFFF),
    .INIT_1D(256'hFFFFFFFFFFFFFFFFFFFFFFFFFFFFFFFFFFFFFFFFFFFFFFFFFFFFFFFFFFFFFFFF),
    .INIT_1E(256'hFFFFFFFFFFFFFFFFFFFFFFFFFFFFFFFFFFFFFFFFFFFFFFFFFFFFFFFFFFFFFFFF),
    .INIT_1F(256'hFFFFFFFFFFFFFFFFFFFFFFFFFFFFFFFFFFFFFFFFFFFFFFFFFFFFFFFFFFFFFFFF),
    .MODE("DP8K"),
    .OCEAMUX("0"),
    .REGMODE_A("NOREG"),
    .REGMODE_B("OUTREG"),
    .RESETMODE("SYNC"),
    .RSTAMUX("0"),
    .WEAMUX("1"),
    .WEBMUX("0"),
    .WRITEMODE_A("NORMAL"),
    .WRITEMODE_B("NORMAL"))
    inst_8192x32_sub_000000_029 (
    .addra(addra),
    .addrb(addrb),
    .cea(cea),
    .ceb(ceb),
    .clka(clka),
    .clkb(clkb),
    .dia({open_n207,open_n208,open_n209,open_n210,open_n211,open_n212,open_n213,dia[29],open_n214}),
    .oceb(oceb),
    .rstb(rstb),
    .dob({open_n237,open_n238,open_n239,open_n240,open_n241,open_n242,open_n243,open_n244,inst_dob_i0_029}));
  // address_offset=0;data_offset=30;depth=8192;width=1;num_section=1;width_per_section=1;section_size=32;working_depth=8192;working_width=1;mode_ecc=0;address_step=1;bytes_in_per_section=1;
  EG_PHY_BRAM #(
    .CSA0("1"),
    .CSA1("1"),
    .CSA2("1"),
    .CSB0("1"),
    .CSB1("1"),
    .CSB2("1"),
    .DATA_WIDTH_A("1"),
    .DATA_WIDTH_B("1"),
    .INITP_00(256'h0000000000000000000000000000000000000000000000000000000000000000),
    .INITP_01(256'h0000000000000000000000000000000000000000000000000000000000000000),
    .INITP_02(256'h0000000000000000000000000000000000000000000000000000000000000000),
    .INITP_03(256'h0000000000000000000000000000000000000000000000000000000000000000),
    .INIT_00(256'hFFFFFFFFFFFFFFFFFFFFFFFFFFFFFFFFFFFFFFFFFFFFFFFFFFFFFFFFFFFFFFFF),
    .INIT_01(256'hFFFFFFFFFFFFFFFFFFFFFFFFFFFFFFFFFFFFFFFFFFFFFFFFFFFFFFFFFFFFFFFF),
    .INIT_02(256'hFFFFFFFFFFFFFFFFFFFFFFFFFFFFFFFFFFFFFFFFFFFFFFFFFFFFFFFFFFFFFFFF),
    .INIT_03(256'hFFFFFFFFFFFFFFFFFFFFFFFFFFFFFFFFFFFFFFFFFFFFFFFFFFFFFFFFFFFFFFFF),
    .INIT_04(256'hFFFFFFFFFFFFFFFFFFFFFFFFFFFFFFFFFFFFFFFFFFFFFFFFFFFFFFFFFFFFFFFF),
    .INIT_05(256'hFFFFFFFFFFFFFFFFFFFFFFFFFFFFFFFFFFFFFFFFFFFFFFFFFFFFFFFFFFFFFFFF),
    .INIT_06(256'hFFFFFFFFFFFFFFFFFFFFFFFFFFFFFFFFFFFFFFFFFFFFFFFFFFFFFFFFFFFFFFFF),
    .INIT_07(256'hFFFFFFFFFFFFFFFFFFFFFFFFFFFFFFFFFFFFFFFFFFFFFFFFFFFFFFFFFFFFFFFF),
    .INIT_08(256'hFFFFFFFFFFFFFFFFFFFFFFFFFFFFFFFFFFFFFFFFFFFFFFFFFFFFFFFFFFFFFFFF),
    .INIT_09(256'hFFFFFFFFFFFFFFFFFFFFFFFFFFFFFFFFFFFFFFFFFFFFFFFFFFFFFFFFFFFFFFFF),
    .INIT_0A(256'hFFFFFFFFFFFFFFFFFFFFFFFFFFFFFFFFFFFFFFFFFFFFFFFFFFFFFFFFFFFFFFFF),
    .INIT_0B(256'hFFFFFFFFFFFFFFFFFFFFFFFFFFFFFFFFFFFFFFFFFFFFFFFFFFFFFFFFFFFFFFFF),
    .INIT_0C(256'hFFFFFFFFFFFFFFFFFFFFFFFFFFFFFFFFFFFFFFFFFFFFFFFFFFFFFFFFFFFFFFFF),
    .INIT_0D(256'hFFFFFFFFFFFFFFFFFFFFFFFFFFFFFFFFFFFFFFFFFFFFFFFFFFFFFFFFFFFFFFFF),
    .INIT_0E(256'hFFFFFFFFFFFFFFFFFFFFFFFFFFFFFFFFFFFFFFFFFFFFFFFFFFFFFFFFFFFFFFFF),
    .INIT_0F(256'hFFFFFFFFFFFFFFFFFFFFFFFFFFFFFFFFFFFFFFFFFFFFFFFFFFFFFFFFFFFFFFFF),
    .INIT_10(256'hFFFFFFFFFFFFFFFFFFFFFFFFFFFFFFFFFFFFFFFFFFFFFFFFFFFFFFFFFFFFFFFF),
    .INIT_11(256'hFFFFFFFFFFFFFFFFFFFFFFFFFFFFFFFFFFFFFFFFFFFFFFFFFFFFFFFFFFFFFFFF),
    .INIT_12(256'hFFFFFFFFFFFFFFFFFFFFFFFFFFFFFFFFFFFFFFFFFFFFFFFFFFFFFFFFFFFFFFFF),
    .INIT_13(256'hFFFFFFFFFFFFFFFFFFFFFFFFFFFFFFFFFFFFFFFFFFFFFFFFFFFFFFFFFFFFFFFF),
    .INIT_14(256'hFFFFFFFFFFFFFFFFFFFFFFFFFFFFFFFFFFFFFFFFFFFFFFFFFFFFFFFFFFFFFFFF),
    .INIT_15(256'hFFFFFFFFFFFFFFFFFFFFFFFFFFFFFFFFFFFFFFFFFFFFFFFFFFFFFFFFFFFFFFFF),
    .INIT_16(256'hFFFFFFFFFFFFFFFFFFFFFFFFFFFFFFFFFFFFFFFFFFFFFFFFFFFFFFFFFFFFFFFF),
    .INIT_17(256'hFFFFFFFFFFFFFFFFFFFFFFFFFFFFFFFFFFFFFFFFFFFFFFFFFFFFFFFFFFFFFFFF),
    .INIT_18(256'hFFFFFFFFFFFFFFFFFFFFFFFFFFFFFFFFFFFFFFFFFFFFFFFFFFFFFFFFFFFFFFFF),
    .INIT_19(256'hFFFFFFFFFFFFFFFFFFFFFFFFFFFFFFFFFFFFFFFFFFFFFFFFFFFFFFFFFFFFFFFF),
    .INIT_1A(256'hFFFFFFFFFFFFFFFFFFFFFFFFFFFFFFFFFFFFFFFFFFFFFFFFFFFFFFFFFFFFFFFF),
    .INIT_1B(256'hFFFFFFFFFFFFFFFFFFFFFFFFFFFFFFFFFFFFFFFFFFFFFFFFFFFFFFFFFFFFFFFF),
    .INIT_1C(256'hFFFFFFFFFFFFFFFFFFFFFFFFFFFFFFFFFFFFFFFFFFFFFFFFFFFFFFFFFFFFFFFF),
    .INIT_1D(256'hFFFFFFFFFFFFFFFFFFFFFFFFFFFFFFFFFFFFFFFFFFFFFFFFFFFFFFFFFFFFFFFF),
    .INIT_1E(256'hFFFFFFFFFFFFFFFFFFFFFFFFFFFFFFFFFFFFFFFFFFFFFFFFFFFFFFFFFFFFFFFF),
    .INIT_1F(256'hFFFFFFFFFFFFFFFFFFFFFFFFFFFFFFFFFFFFFFFFFFFFFFFFFFFFFFFFFFFFFFFF),
    .MODE("DP8K"),
    .OCEAMUX("0"),
    .REGMODE_A("NOREG"),
    .REGMODE_B("OUTREG"),
    .RESETMODE("SYNC"),
    .RSTAMUX("0"),
    .WEAMUX("1"),
    .WEBMUX("0"),
    .WRITEMODE_A("NORMAL"),
    .WRITEMODE_B("NORMAL"))
    inst_8192x32_sub_000000_030 (
    .addra(addra),
    .addrb(addrb),
    .cea(cea),
    .ceb(ceb),
    .clka(clka),
    .clkb(clkb),
    .dia({open_n251,open_n252,open_n253,open_n254,open_n255,open_n256,open_n257,dia[30],open_n258}),
    .oceb(oceb),
    .rstb(rstb),
    .dob({open_n281,open_n282,open_n283,open_n284,open_n285,open_n286,open_n287,open_n288,inst_dob_i0_030}));
  // address_offset=0;data_offset=31;depth=8192;width=1;num_section=1;width_per_section=1;section_size=32;working_depth=8192;working_width=1;mode_ecc=0;address_step=1;bytes_in_per_section=1;
  EG_PHY_BRAM #(
    .CSA0("1"),
    .CSA1("1"),
    .CSA2("1"),
    .CSB0("1"),
    .CSB1("1"),
    .CSB2("1"),
    .DATA_WIDTH_A("1"),
    .DATA_WIDTH_B("1"),
    .INITP_00(256'h0000000000000000000000000000000000000000000000000000000000000000),
    .INITP_01(256'h0000000000000000000000000000000000000000000000000000000000000000),
    .INITP_02(256'h0000000000000000000000000000000000000000000000000000000000000000),
    .INITP_03(256'h0000000000000000000000000000000000000000000000000000000000000000),
    .INIT_00(256'hFFFFFFFFFFFFFFFFFFFFFFFFFFFFFFFFFFFFFFFFFFFFFFFFFFFFFFFFFFFFFFFF),
    .INIT_01(256'hFFFFFFFFFFFFFFFFFFFFFFFFFFFFFFFFFFFFFFFFFFFFFFFFFFFFFFFFFFFFFFFF),
    .INIT_02(256'hFFFFFFFFFFFFFFFFFFFFFFFFFFFFFFFFFFFFFFFFFFFFFFFFFFFFFFFFFFFFFFFF),
    .INIT_03(256'hFFFFFFFFFFFFFFFFFFFFFFFFFFFFFFFFFFFFFFFFFFFFFFFFFFFFFFFFFFFFFFFF),
    .INIT_04(256'hFFFFFFFFFFFFFFFFFFFFFFFFFFFFFFFFFFFFFFFFFFFFFFFFFFFFFFFFFFFFFFFF),
    .INIT_05(256'hFFFFFFFFFFFFFFFFFFFFFFFFFFFFFFFFFFFFFFFFFFFFFFFFFFFFFFFFFFFFFFFF),
    .INIT_06(256'hFFFFFFFFFFFFFFFFFFFFFFFFFFFFFFFFFFFFFFFFFFFFFFFFFFFFFFFFFFFFFFFF),
    .INIT_07(256'hFFFFFFFFFFFFFFFFFFFFFFFFFFFFFFFFFFFFFFFFFFFFFFFFFFFFFFFFFFFFFFFF),
    .INIT_08(256'hFFFFFFFFFFFFFFFFFFFFFFFFFFFFFFFFFFFFFFFFFFFFFFFFFFFFFFFFFFFFFFFF),
    .INIT_09(256'hFFFFFFFFFFFFFFFFFFFFFFFFFFFFFFFFFFFFFFFFFFFFFFFFFFFFFFFFFFFFFFFF),
    .INIT_0A(256'hFFFFFFFFFFFFFFFFFFFFFFFFFFFFFFFFFFFFFFFFFFFFFFFFFFFFFFFFFFFFFFFF),
    .INIT_0B(256'hFFFFFFFFFFFFFFFFFFFFFFFFFFFFFFFFFFFFFFFFFFFFFFFFFFFFFFFFFFFFFFFF),
    .INIT_0C(256'hFFFFFFFFFFFFFFFFFFFFFFFFFFFFFFFFFFFFFFFFFFFFFFFFFFFFFFFFFFFFFFFF),
    .INIT_0D(256'hFFFFFFFFFFFFFFFFFFFFFFFFFFFFFFFFFFFFFFFFFFFFFFFFFFFFFFFFFFFFFFFF),
    .INIT_0E(256'hFFFFFFFFFFFFFFFFFFFFFFFFFFFFFFFFFFFFFFFFFFFFFFFFFFFFFFFFFFFFFFFF),
    .INIT_0F(256'hFFFFFFFFFFFFFFFFFFFFFFFFFFFFFFFFFFFFFFFFFFFFFFFFFFFFFFFFFFFFFFFF),
    .INIT_10(256'hFFFFFFFFFFFFFFFFFFFFFFFFFFFFFFFFFFFFFFFFFFFFFFFFFFFFFFFFFFFFFFFF),
    .INIT_11(256'hFFFFFFFFFFFFFFFFFFFFFFFFFFFFFFFFFFFFFFFFFFFFFFFFFFFFFFFFFFFFFFFF),
    .INIT_12(256'hFFFFFFFFFFFFFFFFFFFFFFFFFFFFFFFFFFFFFFFFFFFFFFFFFFFFFFFFFFFFFFFF),
    .INIT_13(256'hFFFFFFFFFFFFFFFFFFFFFFFFFFFFFFFFFFFFFFFFFFFFFFFFFFFFFFFFFFFFFFFF),
    .INIT_14(256'hFFFFFFFFFFFFFFFFFFFFFFFFFFFFFFFFFFFFFFFFFFFFFFFFFFFFFFFFFFFFFFFF),
    .INIT_15(256'hFFFFFFFFFFFFFFFFFFFFFFFFFFFFFFFFFFFFFFFFFFFFFFFFFFFFFFFFFFFFFFFF),
    .INIT_16(256'hFFFFFFFFFFFFFFFFFFFFFFFFFFFFFFFFFFFFFFFFFFFFFFFFFFFFFFFFFFFFFFFF),
    .INIT_17(256'hFFFFFFFFFFFFFFFFFFFFFFFFFFFFFFFFFFFFFFFFFFFFFFFFFFFFFFFFFFFFFFFF),
    .INIT_18(256'hFFFFFFFFFFFFFFFFFFFFFFFFFFFFFFFFFFFFFFFFFFFFFFFFFFFFFFFFFFFFFFFF),
    .INIT_19(256'hFFFFFFFFFFFFFFFFFFFFFFFFFFFFFFFFFFFFFFFFFFFFFFFFFFFFFFFFFFFFFFFF),
    .INIT_1A(256'hFFFFFFFFFFFFFFFFFFFFFFFFFFFFFFFFFFFFFFFFFFFFFFFFFFFFFFFFFFFFFFFF),
    .INIT_1B(256'hFFFFFFFFFFFFFFFFFFFFFFFFFFFFFFFFFFFFFFFFFFFFFFFFFFFFFFFFFFFFFFFF),
    .INIT_1C(256'hFFFFFFFFFFFFFFFFFFFFFFFFFFFFFFFFFFFFFFFFFFFFFFFFFFFFFFFFFFFFFFFF),
    .INIT_1D(256'hFFFFFFFFFFFFFFFFFFFFFFFFFFFFFFFFFFFFFFFFFFFFFFFFFFFFFFFFFFFFFFFF),
    .INIT_1E(256'hFFFFFFFFFFFFFFFFFFFFFFFFFFFFFFFFFFFFFFFFFFFFFFFFFFFFFFFFFFFFFFFF),
    .INIT_1F(256'hFFFFFFFFFFFFFFFFFFFFFFFFFFFFFFFFFFFFFFFFFFFFFFFFFFFFFFFFFFFFFFFF),
    .MODE("DP8K"),
    .OCEAMUX("0"),
    .REGMODE_A("NOREG"),
    .REGMODE_B("OUTREG"),
    .RESETMODE("SYNC"),
    .RSTAMUX("0"),
    .WEAMUX("1"),
    .WEBMUX("0"),
    .WRITEMODE_A("NORMAL"),
    .WRITEMODE_B("NORMAL"))
    inst_8192x32_sub_000000_031 (
    .addra(addra),
    .addrb(addrb),
    .cea(cea),
    .ceb(ceb),
    .clka(clka),
    .clkb(clkb),
    .dia({open_n295,open_n296,open_n297,open_n298,open_n299,open_n300,open_n301,dia[31],open_n302}),
    .oceb(oceb),
    .rstb(rstb),
    .dob({open_n325,open_n326,open_n327,open_n328,open_n329,open_n330,open_n331,open_n332,inst_dob_i0_031}));
  // address_offset=1024;data_offset=0;depth=1024;width=9;num_section=1;width_per_section=9;section_size=32;working_depth=1024;working_width=9;mode_ecc=0;address_step=1;bytes_in_per_section=1;
  EG_PHY_BRAM #(
    .CSA0("SIG"),
    .CSA1("INV"),
    .CSA2("INV"),
    .CSB0("SIG"),
    .CSB1("INV"),
    .CSB2("INV"),
    .DATA_WIDTH_A("9"),
    .DATA_WIDTH_B("9"),
    .INITP_00(256'hFFFFFFFFFFFFFFFFFFFFFFFFFFFFFFFFFFFFFFFFFFFFFFFFFFFFFFFFFFFFFFFF),
    .INITP_01(256'hFFFFFFFFFFFFFFFFFFFFFFFFFFFFFFFFFFFFFFFFFFFFFFFFFFFFFFFFFFFFFFFF),
    .INITP_02(256'hFFFFFFFFFFFFFFFFFFFFFFFFFFFFFFFFFFFFFFFFFFFFFFFFFFFFFFFFFFFFFFFF),
    .INITP_03(256'hFFFFFFFFFFFFFFFFFFFFFFFFFFFFFFFFFFFFFFFFFFFFFFFFFFFFFFFFFFFFFFFF),
    .INIT_00(256'hFFFFFFFFFFFFFFFFFFFFFFFFFFFFFFFFFFFFFFFFFFFFFFFFFFFFFFFFFFFFFFFF),
    .INIT_01(256'hFFFFFFFFFFFFFFFFFFFFFFFFFFFFFFFFFFFFFFFFFFFFFFFFFFFFFFFFFFFFFFFF),
    .INIT_02(256'hFFFFFFFFFFFFFFFFFFFFFFFFFFFFFFFFFFFFFFFFFFFFFFFFFFFFFFFFFFFFFFFF),
    .INIT_03(256'hFFFFFFFFFFFFFFFFFFFFFFFFFFFFFFFFFFFFFFFFFFFFFFFFFFFFFFFFFFFFFFFF),
    .INIT_04(256'hFFFFFFFFFFFFFFFFFFFFFFFFFFFFFFFFFFFFFFFFFFFFFFFFFFFFFFFFFFFFFFFF),
    .INIT_05(256'hFFFFFFFFFFFFFFFFFFFFFFFFFFFFFFFFFFFFFFFFFFFFFFFFFFFFFFFFFFFFFFFF),
    .INIT_06(256'hFFFFFFFFFFFFFFFFFFFFFFFFFFFFFFFFFFFFFFFFFFFFFFFFFFFFFFFFFFFFFFFF),
    .INIT_07(256'hFFFFFFFFFFFFFFFFFFFFFFFFFFFFFFFFFFFFFFFFFFFFFFFFFFFFFFFFFFFFFFFF),
    .INIT_08(256'hFFFFFFFFFFFFFFFFFFFFFFFFFFFFFFFFFFFFFFFFFFFFFFFFFFFFFFFFFFFFFFFF),
    .INIT_09(256'hFFFFFFFFFFFFFFFFFFFFFFFFFFFFFFFFFFFFFFFFFFFFFFFFFFFFFFFFFFFFFFFF),
    .INIT_0A(256'hFFFFFFFFFFFFFFFFFFFFFFFFFFFFFFFFFFFFFFFFFFFFFFFFFFFFFFFFFFFFFFFF),
    .INIT_0B(256'hFFFFFFFFFFFFFFFFFFFFFFFFFFFFFFFFFFFFFFFFFFFFFFFFFFFFFFFFFFFFFFFF),
    .INIT_0C(256'hFFFFFFFFFFFFFFFFFFFFFFFFFFFFFFFFFFFFFFFFFFFFFFFFFFFFFFFFFFFFFFFF),
    .INIT_0D(256'hFFFFFFFFFFFFFFFFFFFFFFFFFFFFFFFFFFFFFFFFFFFFFFFFFFFFFFFFFFFFFFFF),
    .INIT_0E(256'hFFFFFFFFFFFFFFFFFFFFFFFFFFFFFFFFFFFFFFFFFFFFFFFFFFFFFFFFFFFFFFFF),
    .INIT_0F(256'hFFFFFFFFFFFFFFFFFFFFFFFFFFFFFFFFFFFFFFFFFFFFFFFFFFFFFFFFFFFFFFFF),
    .INIT_10(256'hFFFFFFFFFFFFFFFFFFFFFFFFFFFFFFFFFFFFFFFFFFFFFFFFFFFFFFFFFFFFFFFF),
    .INIT_11(256'hFFFFFFFFFFFFFFFFFFFFFFFFFFFFFFFFFFFFFFFFFFFFFFFFFFFFFFFFFFFFFFFF),
    .INIT_12(256'hFFFFFFFFFFFFFFFFFFFFFFFFFFFFFFFFFFFFFFFFFFFFFFFFFFFFFFFFFFFFFFFF),
    .INIT_13(256'hFFFFFFFFFFFFFFFFFFFFFFFFFFFFFFFFFFFFFFFFFFFFFFFFFFFFFFFFFFFFFFFF),
    .INIT_14(256'hFFFFFFFFFFFFFFFFFFFFFFFFFFFFFFFFFFFFFFFFFFFFFFFFFFFFFFFFFFFFFFFF),
    .INIT_15(256'hFFFFFFFFFFFFFFFFFFFFFFFFFFFFFFFFFFFFFFFFFFFFFFFFFFFFFFFFFFFFFFFF),
    .INIT_16(256'hFFFFFFFFFFFFFFFFFFFFFFFFFFFFFFFFFFFFFFFFFFFFFFFFFFFFFFFFFFFFFFFF),
    .INIT_17(256'hFFFFFFFFFFFFFFFFFFFFFFFFFFFFFFFFFFFFFFFFFFFFFFFFFFFFFFFFFFFFFFFF),
    .INIT_18(256'hFFFFFFFFFFFFFFFFFFFFFFFFFFFFFFFFFFFFFFFFFFFFFFFFFFFFFFFFFFFFFFFF),
    .INIT_19(256'hFFFFFFFFFFFFFFFFFFFFFFFFFFFFFFFFFFFFFFFFFFFFFFFFFFFFFFFFFFFFFFFF),
    .INIT_1A(256'hFFFFFFFFFFFFFFFFFFFFFFFFFFFFFFFFFFFFFFFFFFFFFFFFFFFFFFFFFFFFFFFF),
    .INIT_1B(256'hFFFFFFFFFFFFFFFFFFFFFFFFFFFFFFFFFFFFFFFFFFFFFFFFFFFFFFFFFFFFFFFF),
    .INIT_1C(256'hFFFFFFFFFFFFFFFFFFFFFFFFFFFFFFFFFFFFFFFFFFFFFFFFFFFFFFFFFFFFFFFF),
    .INIT_1D(256'hFFFFFFFFFFFFFFFFFFFFFFFFFFFFFFFFFFFFFFFFFFFFFFFFFFFFFFFFFFFFFFFF),
    .INIT_1E(256'hFFFFFFFFFFFFFFFFFFFFFFFFFFFFFFFFFFFFFFFFFFFFFFFFFFFFFFFFFFFFFFFF),
    .INIT_1F(256'hFFFFFFFFFFFFFFFFFFFFFFFFFFFFFFFFFFFFFFFFFFFFFFFFFFFFFFFFFFFFFFFF),
    .MODE("DP8K"),
    .OCEAMUX("0"),
    .REGMODE_A("NOREG"),
    .REGMODE_B("OUTREG"),
    .RESETMODE("SYNC"),
    .RSTAMUX("0"),
    .WEAMUX("1"),
    .WEBMUX("0"),
    .WRITEMODE_A("NORMAL"),
    .WRITEMODE_B("NORMAL"))
    inst_8192x32_sub_001024_000 (
    .addra({addra[9:0],3'b111}),
    .addrb({addrb[9:0],3'b111}),
    .cea(cea),
    .ceb(ceb),
    .clka(clka),
    .clkb(clkb),
    .csa(addra[12:10]),
    .csb(addrb[12:10]),
    .dia(dia[8:0]),
    .oceb(oceb),
    .rstb(rstb),
    .dob({inst_dob_i1_008,inst_dob_i1_007,inst_dob_i1_006,inst_dob_i1_005,inst_dob_i1_004,inst_dob_i1_003,inst_dob_i1_002,inst_dob_i1_001,inst_dob_i1_000}));
  // address_offset=1024;data_offset=9;depth=1024;width=9;num_section=1;width_per_section=9;section_size=32;working_depth=1024;working_width=9;mode_ecc=0;address_step=1;bytes_in_per_section=1;
  EG_PHY_BRAM #(
    .CSA0("SIG"),
    .CSA1("INV"),
    .CSA2("INV"),
    .CSB0("SIG"),
    .CSB1("INV"),
    .CSB2("INV"),
    .DATA_WIDTH_A("9"),
    .DATA_WIDTH_B("9"),
    .INITP_00(256'hFFFFFFFFFFFFFFFFFFFFFFFFFFFFFFFFFFFFFFFFFFFFFFFFFFFFFFFFFFFFFFFF),
    .INITP_01(256'hFFFFFFFFFFFFFFFFFFFFFFFFFFFFFFFFFFFFFFFFFFFFFFFFFFFFFFFFFFFFFFFF),
    .INITP_02(256'hFFFFFFFFFFFFFFFFFFFFFFFFFFFFFFFFFFFFFFFFFFFFFFFFFFFFFFFFFFFFFFFF),
    .INITP_03(256'hFFFFFFFFFFFFFFFFFFFFFFFFFFFFFFFFFFFFFFFFFFFFFFFFFFFFFFFFFFFFFFFF),
    .INIT_00(256'hFFFFFFFFFFFFFFFFFFFFFFFFFFFFFFFFFFFFFFFFFFFFFFFFFFFFFFFFFFFFFFFF),
    .INIT_01(256'hFFFFFFFFFFFFFFFFFFFFFFFFFFFFFFFFFFFFFFFFFFFFFFFFFFFFFFFFFFFFFFFF),
    .INIT_02(256'hFFFFFFFFFFFFFFFFFFFFFFFFFFFFFFFFFFFFFFFFFFFFFFFFFFFFFFFFFFFFFFFF),
    .INIT_03(256'hFFFFFFFFFFFFFFFFFFFFFFFFFFFFFFFFFFFFFFFFFFFFFFFFFFFFFFFFFFFFFFFF),
    .INIT_04(256'hFFFFFFFFFFFFFFFFFFFFFFFFFFFFFFFFFFFFFFFFFFFFFFFFFFFFFFFFFFFFFFFF),
    .INIT_05(256'hFFFFFFFFFFFFFFFFFFFFFFFFFFFFFFFFFFFFFFFFFFFFFFFFFFFFFFFFFFFFFFFF),
    .INIT_06(256'hFFFFFFFFFFFFFFFFFFFFFFFFFFFFFFFFFFFFFFFFFFFFFFFFFFFFFFFFFFFFFFFF),
    .INIT_07(256'hFFFFFFFFFFFFFFFFFFFFFFFFFFFFFFFFFFFFFFFFFFFFFFFFFFFFFFFFFFFFFFFF),
    .INIT_08(256'hFFFFFFFFFFFFFFFFFFFFFFFFFFFFFFFFFFFFFFFFFFFFFFFFFFFFFFFFFFFFFFFF),
    .INIT_09(256'hFFFFFFFFFFFFFFFFFFFFFFFFFFFFFFFFFFFFFFFFFFFFFFFFFFFFFFFFFFFFFFFF),
    .INIT_0A(256'hFFFFFFFFFFFFFFFFFFFFFFFFFFFFFFFFFFFFFFFFFFFFFFFFFFFFFFFFFFFFFFFF),
    .INIT_0B(256'hFFFFFFFFFFFFFFFFFFFFFFFFFFFFFFFFFFFFFFFFFFFFFFFFFFFFFFFFFFFFFFFF),
    .INIT_0C(256'hFFFFFFFFFFFFFFFFFFFFFFFFFFFFFFFFFFFFFFFFFFFFFFFFFFFFFFFFFFFFFFFF),
    .INIT_0D(256'hFFFFFFFFFFFFFFFFFFFFFFFFFFFFFFFFFFFFFFFFFFFFFFFFFFFFFFFFFFFFFFFF),
    .INIT_0E(256'hFFFFFFFFFFFFFFFFFFFFFFFFFFFFFFFFFFFFFFFFFFFFFFFFFFFFFFFFFFFFFFFF),
    .INIT_0F(256'hFFFFFFFFFFFFFFFFFFFFFFFFFFFFFFFFFFFFFFFFFFFFFFFFFFFFFFFFFFFFFFFF),
    .INIT_10(256'hFFFFFFFFFFFFFFFFFFFFFFFFFFFFFFFFFFFFFFFFFFFFFFFFFFFFFFFFFFFFFFFF),
    .INIT_11(256'hFFFFFFFFFFFFFFFFFFFFFFFFFFFFFFFFFFFFFFFFFFFFFFFFFFFFFFFFFFFFFFFF),
    .INIT_12(256'hFFFFFFFFFFFFFFFFFFFFFFFFFFFFFFFFFFFFFFFFFFFFFFFFFFFFFFFFFFFFFFFF),
    .INIT_13(256'hFFFFFFFFFFFFFFFFFFFFFFFFFFFFFFFFFFFFFFFFFFFFFFFFFFFFFFFFFFFFFFFF),
    .INIT_14(256'hFFFFFFFFFFFFFFFFFFFFFFFFFFFFFFFFFFFFFFFFFFFFFFFFFFFFFFFFFFFFFFFF),
    .INIT_15(256'hFFFFFFFFFFFFFFFFFFFFFFFFFFFFFFFFFFFFFFFFFFFFFFFFFFFFFFFFFFFFFFFF),
    .INIT_16(256'hFFFFFFFFFFFFFFFFFFFFFFFFFFFFFFFFFFFFFFFFFFFFFFFFFFFFFFFFFFFFFFFF),
    .INIT_17(256'hFFFFFFFFFFFFFFFFFFFFFFFFFFFFFFFFFFFFFFFFFFFFFFFFFFFFFFFFFFFFFFFF),
    .INIT_18(256'hFFFFFFFFFFFFFFFFFFFFFFFFFFFFFFFFFFFFFFFFFFFFFFFFFFFFFFFFFFFFFFFF),
    .INIT_19(256'hFFFFFFFFFFFFFFFFFFFFFFFFFFFFFFFFFFFFFFFFFFFFFFFFFFFFFFFFFFFFFFFF),
    .INIT_1A(256'hFFFFFFFFFFFFFFFFFFFFFFFFFFFFFFFFFFFFFFFFFFFFFFFFFFFFFFFFFFFFFFFF),
    .INIT_1B(256'hFFFFFFFFFFFFFFFFFFFFFFFFFFFFFFFFFFFFFFFFFFFFFFFFFFFFFFFFFFFFFFFF),
    .INIT_1C(256'hFFFFFFFFFFFFFFFFFFFFFFFFFFFFFFFFFFFFFFFFFFFFFFFFFFFFFFFFFFFFFFFF),
    .INIT_1D(256'hFFFFFFFFFFFFFFFFFFFFFFFFFFFFFFFFFFFFFFFFFFFFFFFFFFFFFFFFFFFFFFFF),
    .INIT_1E(256'hFFFFFFFFFFFFFFFFFFFFFFFFFFFFFFFFFFFFFFFFFFFFFFFFFFFFFFFFFFFFFFFF),
    .INIT_1F(256'hFFFFFFFFFFFFFFFFFFFFFFFFFFFFFFFFFFFFFFFFFFFFFFFFFFFFFFFFFFFFFFFF),
    .MODE("DP8K"),
    .OCEAMUX("0"),
    .REGMODE_A("NOREG"),
    .REGMODE_B("OUTREG"),
    .RESETMODE("SYNC"),
    .RSTAMUX("0"),
    .WEAMUX("1"),
    .WEBMUX("0"),
    .WRITEMODE_A("NORMAL"),
    .WRITEMODE_B("NORMAL"))
    inst_8192x32_sub_001024_009 (
    .addra({addra[9:0],3'b111}),
    .addrb({addrb[9:0],3'b111}),
    .cea(cea),
    .ceb(ceb),
    .clka(clka),
    .clkb(clkb),
    .csa(addra[12:10]),
    .csb(addrb[12:10]),
    .dia(dia[17:9]),
    .oceb(oceb),
    .rstb(rstb),
    .dob({inst_dob_i1_017,inst_dob_i1_016,inst_dob_i1_015,inst_dob_i1_014,inst_dob_i1_013,inst_dob_i1_012,inst_dob_i1_011,inst_dob_i1_010,inst_dob_i1_009}));
  // address_offset=1024;data_offset=18;depth=1024;width=9;num_section=1;width_per_section=9;section_size=32;working_depth=1024;working_width=9;mode_ecc=0;address_step=1;bytes_in_per_section=1;
  EG_PHY_BRAM #(
    .CSA0("SIG"),
    .CSA1("INV"),
    .CSA2("INV"),
    .CSB0("SIG"),
    .CSB1("INV"),
    .CSB2("INV"),
    .DATA_WIDTH_A("9"),
    .DATA_WIDTH_B("9"),
    .INITP_00(256'hFFFFFFFFFFFFFFFFFFFFFFFFFFFFFFFFFFFFFFFFFFFFFFFFFFFFFFFFFFFFFFFF),
    .INITP_01(256'hFFFFFFFFFFFFFFFFFFFFFFFFFFFFFFFFFFFFFFFFFFFFFFFFFFFFFFFFFFFFFFFF),
    .INITP_02(256'hFFFFFFFFFFFFFFFFFFFFFFFFFFFFFFFFFFFFFFFFFFFFFFFFFFFFFFFFFFFFFFFF),
    .INITP_03(256'hFFFFFFFFFFFFFFFFFFFFFFFFFFFFFFFFFFFFFFFFFFFFFFFFFFFFFFFFFFFFFFFF),
    .INIT_00(256'hFFFFFFFFFFFFFFFFFFFFFFFFFFFFFFFFFFFFFFFFFFFFFFFFFFFFFFFFFFFFFFFF),
    .INIT_01(256'hFFFFFFFFFFFFFFFFFFFFFFFFFFFFFFFFFFFFFFFFFFFFFFFFFFFFFFFFFFFFFFFF),
    .INIT_02(256'hFFFFFFFFFFFFFFFFFFFFFFFFFFFFFFFFFFFFFFFFFFFFFFFFFFFFFFFFFFFFFFFF),
    .INIT_03(256'hFFFFFFFFFFFFFFFFFFFFFFFFFFFFFFFFFFFFFFFFFFFFFFFFFFFFFFFFFFFFFFFF),
    .INIT_04(256'hFFFFFFFFFFFFFFFFFFFFFFFFFFFFFFFFFFFFFFFFFFFFFFFFFFFFFFFFFFFFFFFF),
    .INIT_05(256'hFFFFFFFFFFFFFFFFFFFFFFFFFFFFFFFFFFFFFFFFFFFFFFFFFFFFFFFFFFFFFFFF),
    .INIT_06(256'hFFFFFFFFFFFFFFFFFFFFFFFFFFFFFFFFFFFFFFFFFFFFFFFFFFFFFFFFFFFFFFFF),
    .INIT_07(256'hFFFFFFFFFFFFFFFFFFFFFFFFFFFFFFFFFFFFFFFFFFFFFFFFFFFFFFFFFFFFFFFF),
    .INIT_08(256'hFFFFFFFFFFFFFFFFFFFFFFFFFFFFFFFFFFFFFFFFFFFFFFFFFFFFFFFFFFFFFFFF),
    .INIT_09(256'hFFFFFFFFFFFFFFFFFFFFFFFFFFFFFFFFFFFFFFFFFFFFFFFFFFFFFFFFFFFFFFFF),
    .INIT_0A(256'hFFFFFFFFFFFFFFFFFFFFFFFFFFFFFFFFFFFFFFFFFFFFFFFFFFFFFFFFFFFFFFFF),
    .INIT_0B(256'hFFFFFFFFFFFFFFFFFFFFFFFFFFFFFFFFFFFFFFFFFFFFFFFFFFFFFFFFFFFFFFFF),
    .INIT_0C(256'hFFFFFFFFFFFFFFFFFFFFFFFFFFFFFFFFFFFFFFFFFFFFFFFFFFFFFFFFFFFFFFFF),
    .INIT_0D(256'hFFFFFFFFFFFFFFFFFFFFFFFFFFFFFFFFFFFFFFFFFFFFFFFFFFFFFFFFFFFFFFFF),
    .INIT_0E(256'hFFFFFFFFFFFFFFFFFFFFFFFFFFFFFFFFFFFFFFFFFFFFFFFFFFFFFFFFFFFFFFFF),
    .INIT_0F(256'hFFFFFFFFFFFFFFFFFFFFFFFFFFFFFFFFFFFFFFFFFFFFFFFFFFFFFFFFFFFFFFFF),
    .INIT_10(256'hFFFFFFFFFFFFFFFFFFFFFFFFFFFFFFFFFFFFFFFFFFFFFFFFFFFFFFFFFFFFFFFF),
    .INIT_11(256'hFFFFFFFFFFFFFFFFFFFFFFFFFFFFFFFFFFFFFFFFFFFFFFFFFFFFFFFFFFFFFFFF),
    .INIT_12(256'hFFFFFFFFFFFFFFFFFFFFFFFFFFFFFFFFFFFFFFFFFFFFFFFFFFFFFFFFFFFFFFFF),
    .INIT_13(256'hFFFFFFFFFFFFFFFFFFFFFFFFFFFFFFFFFFFFFFFFFFFFFFFFFFFFFFFFFFFFFFFF),
    .INIT_14(256'hFFFFFFFFFFFFFFFFFFFFFFFFFFFFFFFFFFFFFFFFFFFFFFFFFFFFFFFFFFFFFFFF),
    .INIT_15(256'hFFFFFFFFFFFFFFFFFFFFFFFFFFFFFFFFFFFFFFFFFFFFFFFFFFFFFFFFFFFFFFFF),
    .INIT_16(256'hFFFFFFFFFFFFFFFFFFFFFFFFFFFFFFFFFFFFFFFFFFFFFFFFFFFFFFFFFFFFFFFF),
    .INIT_17(256'hFFFFFFFFFFFFFFFFFFFFFFFFFFFFFFFFFFFFFFFFFFFFFFFFFFFFFFFFFFFFFFFF),
    .INIT_18(256'hFFFFFFFFFFFFFFFFFFFFFFFFFFFFFFFFFFFFFFFFFFFFFFFFFFFFFFFFFFFFFFFF),
    .INIT_19(256'hFFFFFFFFFFFFFFFFFFFFFFFFFFFFFFFFFFFFFFFFFFFFFFFFFFFFFFFFFFFFFFFF),
    .INIT_1A(256'hFFFFFFFFFFFFFFFFFFFFFFFFFFFFFFFFFFFFFFFFFFFFFFFFFFFFFFFFFFFFFFFF),
    .INIT_1B(256'hFFFFFFFFFFFFFFFFFFFFFFFFFFFFFFFFFFFFFFFFFFFFFFFFFFFFFFFFFFFFFFFF),
    .INIT_1C(256'hFFFFFFFFFFFFFFFFFFFFFFFFFFFFFFFFFFFFFFFFFFFFFFFFFFFFFFFFFFFFFFFF),
    .INIT_1D(256'hFFFFFFFFFFFFFFFFFFFFFFFFFFFFFFFFFFFFFFFFFFFFFFFFFFFFFFFFFFFFFFFF),
    .INIT_1E(256'hFFFFFFFFFFFFFFFFFFFFFFFFFFFFFFFFFFFFFFFFFFFFFFFFFFFFFFFFFFFFFFFF),
    .INIT_1F(256'hFFFFFFFFFFFFFFFFFFFFFFFFFFFFFFFFFFFFFFFFFFFFFFFFFFFFFFFFFFFFFFFF),
    .MODE("DP8K"),
    .OCEAMUX("0"),
    .REGMODE_A("NOREG"),
    .REGMODE_B("OUTREG"),
    .RESETMODE("SYNC"),
    .RSTAMUX("0"),
    .WEAMUX("1"),
    .WEBMUX("0"),
    .WRITEMODE_A("NORMAL"),
    .WRITEMODE_B("NORMAL"))
    inst_8192x32_sub_001024_018 (
    .addra({addra[9:0],3'b111}),
    .addrb({addrb[9:0],3'b111}),
    .cea(cea),
    .ceb(ceb),
    .clka(clka),
    .clkb(clkb),
    .csa(addra[12:10]),
    .csb(addrb[12:10]),
    .dia(dia[26:18]),
    .oceb(oceb),
    .rstb(rstb),
    .dob({inst_dob_i1_026,inst_dob_i1_025,inst_dob_i1_024,inst_dob_i1_023,inst_dob_i1_022,inst_dob_i1_021,inst_dob_i1_020,inst_dob_i1_019,inst_dob_i1_018}));
  // address_offset=2048;data_offset=0;depth=1024;width=9;num_section=1;width_per_section=9;section_size=32;working_depth=1024;working_width=9;mode_ecc=0;address_step=1;bytes_in_per_section=1;
  EG_PHY_BRAM #(
    .CSA0("INV"),
    .CSA1("SIG"),
    .CSA2("INV"),
    .CSB0("INV"),
    .CSB1("SIG"),
    .CSB2("INV"),
    .DATA_WIDTH_A("9"),
    .DATA_WIDTH_B("9"),
    .INITP_00(256'hFFFFFFFFFFFFFFFFFFFFFFFFFFFFFFFFFFFFFFFFFFFFFFFFFFFFFFFFFFFFFFFF),
    .INITP_01(256'hFFFFFFFFFFFFFFFFFFFFFFFFFFFFFFFFFFFFFFFFFFFFFFFFFFFFFFFFFFFFFFFF),
    .INITP_02(256'hFFFFFFFFFFFFFFFFFFFFFFFFFFFFFFFFFFFFFFFFFFFFFFFFFFFFFFFFFFFFFFFF),
    .INITP_03(256'hFFFFFFFFFFFFFFFFFFFFFFFFFFFFFFFFFFFFFFFFFFFFFFFFFFFFFFFFFFFFFFFF),
    .INIT_00(256'hFFFFFFFFFFFFFFFFFFFFFFFFFFFFFFFFFFFFFFFFFFFFFFFFFFFFFFFFFFFFFFFF),
    .INIT_01(256'hFFFFFFFFFFFFFFFFFFFFFFFFFFFFFFFFFFFFFFFFFFFFFFFFFFFFFFFFFFFFFFFF),
    .INIT_02(256'hFFFFFFFFFFFFFFFFFFFFFFFFFFFFFFFFFFFFFFFFFFFFFFFFFFFFFFFFFFFFFFFF),
    .INIT_03(256'hFFFFFFFFFFFFFFFFFFFFFFFFFFFFFFFFFFFFFFFFFFFFFFFFFFFFFFFFFFFFFFFF),
    .INIT_04(256'hFFFFFFFFFFFFFFFFFFFFFFFFFFFFFFFFFFFFFFFFFFFFFFFFFFFFFFFFFFFFFFFF),
    .INIT_05(256'hFFFFFFFFFFFFFFFFFFFFFFFFFFFFFFFFFFFFFFFFFFFFFFFFFFFFFFFFFFFFFFFF),
    .INIT_06(256'hFFFFFFFFFFFFFFFFFFFFFFFFFFFFFFFFFFFFFFFFFFFFFFFFFFFFFFFFFFFFFFFF),
    .INIT_07(256'hFFFFFFFFFFFFFFFFFFFFFFFFFFFFFFFFFFFFFFFFFFFFFFFFFFFFFFFFFFFFFFFF),
    .INIT_08(256'hFFFFFFFFFFFFFFFFFFFFFFFFFFFFFFFFFFFFFFFFFFFFFFFFFFFFFFFFFFFFFFFF),
    .INIT_09(256'hFFFFFFFFFFFFFFFFFFFFFFFFFFFFFFFFFFFFFFFFFFFFFFFFFFFFFFFFFFFFFFFF),
    .INIT_0A(256'hFFFFFFFFFFFFFFFFFFFFFFFFFFFFFFFFFFFFFFFFFFFFFFFFFFFFFFFFFFFFFFFF),
    .INIT_0B(256'hFFFFFFFFFFFFFFFFFFFFFFFFFFFFFFFFFFFFFFFFFFFFFFFFFFFFFFFFFFFFFFFF),
    .INIT_0C(256'hFFFFFFFFFFFFFFFFFFFFFFFFFFFFFFFFFFFFFFFFFFFFFFFFFFFFFFFFFFFFFFFF),
    .INIT_0D(256'hFFFFFFFFFFFFFFFFFFFFFFFFFFFFFFFFFFFFFFFFFFFFFFFFFFFFFFFFFFFFFFFF),
    .INIT_0E(256'hFFFFFFFFFFFFFFFFFFFFFFFFFFFFFFFFFFFFFFFFFFFFFFFFFFFFFFFFFFFFFFFF),
    .INIT_0F(256'hFFFFFFFFFFFFFFFFFFFFFFFFFFFFFFFFFFFFFFFFFFFFFFFFFFFFFFFFFFFFFFFF),
    .INIT_10(256'hFFFFFFFFFFFFFFFFFFFFFFFFFFFFFFFFFFFFFFFFFFFFFFFFFFFFFFFFFFFFFFFF),
    .INIT_11(256'hFFFFFFFFFFFFFFFFFFFFFFFFFFFFFFFFFFFFFFFFFFFFFFFFFFFFFFFFFFFFFFFF),
    .INIT_12(256'hFFFFFFFFFFFFFFFFFFFFFFFFFFFFFFFFFFFFFFFFFFFFFFFFFFFFFFFFFFFFFFFF),
    .INIT_13(256'hFFFFFFFFFFFFFFFFFFFFFFFFFFFFFFFFFFFFFFFFFFFFFFFFFFFFFFFFFFFFFFFF),
    .INIT_14(256'hFFFFFFFFFFFFFFFFFFFFFFFFFFFFFFFFFFFFFFFFFFFFFFFFFFFFFFFFFFFFFFFF),
    .INIT_15(256'hFFFFFFFFFFFFFFFFFFFFFFFFFFFFFFFFFFFFFFFFFFFFFFFFFFFFFFFFFFFFFFFF),
    .INIT_16(256'hFFFFFFFFFFFFFFFFFFFFFFFFFFFFFFFFFFFFFFFFFFFFFFFFFFFFFFFFFFFFFFFF),
    .INIT_17(256'hFFFFFFFFFFFFFFFFFFFFFFFFFFFFFFFFFFFFFFFFFFFFFFFFFFFFFFFFFFFFFFFF),
    .INIT_18(256'hFFFFFFFFFFFFFFFFFFFFFFFFFFFFFFFFFFFFFFFFFFFFFFFFFFFFFFFFFFFFFFFF),
    .INIT_19(256'hFFFFFFFFFFFFFFFFFFFFFFFFFFFFFFFFFFFFFFFFFFFFFFFFFFFFFFFFFFFFFFFF),
    .INIT_1A(256'hFFFFFFFFFFFFFFFFFFFFFFFFFFFFFFFFFFFFFFFFFFFFFFFFFFFFFFFFFFFFFFFF),
    .INIT_1B(256'hFFFFFFFFFFFFFFFFFFFFFFFFFFFFFFFFFFFFFFFFFFFFFFFFFFFFFFFFFFFFFFFF),
    .INIT_1C(256'hFFFFFFFFFFFFFFFFFFFFFFFFFFFFFFFFFFFFFFFFFFFFFFFFFFFFFFFFFFFFFFFF),
    .INIT_1D(256'hFFFFFFFFFFFFFFFFFFFFFFFFFFFFFFFFFFFFFFFFFFFFFFFFFFFFFFFFFFFFFFFF),
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
