liyuxuan3003/PrismGC/(commit log)

2023-02-12 初始化提交。
2023-02-12 在资源汇总中添加了一些链接。
2023-02-12 添加了一些链接。
2023-02-21 增加了一些菜鸟教程的链接
2023-02-21 更新了Verilog相关教学和流水灯实验链接
2023-02-21 更新了C语言及M0链接
2023-03-10 更新了实验1-3
2023-03-10 增加了一个Hello World
2023-03-10 增加了七段数码管的实验
2023-03-10 修改了gitignore
2023-03-10 增加了hello lyx and lmj！
2023-03-10 新增了一个Hello world！
2023-03-10 增加了一行没用的注释
2023-03-10 将Resource目录更名为Project，作为存储项目文本资料的文件夹，并在Resouce.md添加了一些新的链接。
2023-03-10 新增了任务列表，在其中添加了考试周假期的任务。
2023-03-10 新增了工作流程。
2023-03-10 修复了Workflow.md中的一个小错误
2023-03-10 增加了CortexM0的测试项目
2023-03-10 新建了静态资源目录，添加了M0和M3的硬件代码，添加了硬木课堂M0的教程代码。
2023-03-11 更新了板子链接
2023-03-12 更新了十个数的数值比较器和猜数字游戏
2023-03-13 完成了前三个实验的复习合并和第四个实验的编写优化（已跑通）
2023-03-14 使用了Malloc实现任意数量的数值排序
2023-03-14 新增了第二个M0实验，修正了第一个M0实验中的错误
2023-03-15 完成了M0的实验3
2023-03-15 上传实验五的代码结果
2023-03-15 完成了M0的实验4
2023-03-15 完成实验6的相关内容
2023-03-15 完成了M0的实验8，实现了串口通讯
2023-03-15 新建了M0的Final实验
2023-03-16 做了一些实验
2023-03-16 重整了Final的Verilog代码，添加了注释，删除了不必要的代码
2023-03-16 尝试在Final中添加了软件代码，但未成功
2023-03-16 尝试重新引入了最简汇编代码，并修正了硬件代码AHBlite_Decoder.v中的一个错误
2023-03-16 没啥变化
2023-03-16 加了一些无意义的空格
2023-03-16 修改了Final的启动汇编，新增了GPIO硬件代码
2023-03-16 初步完成了GPIO的引入
2023-03-16 修正了一个小错误
2023-03-16 尝试将GPIO从8位改为32位
2023-03-16 继续修改软硬件代码以适配GPIO
2023-03-16 更新了跑马灯实验和蜂鸣器实验的keil文件和hex等文件
2023-03-16 继续修改代码，但反正没完全工作
2023-03-16 Final的GPIO初步调通，但非对齐访问会崩溃，有待修复
2023-03-17 无显著修改
2023-03-17 GPIO成功跑通
2023-03-17 完成了实验7-9的主要工作，但8 9的连接存在问题 有待进一步完善
2023-03-17 GPIO多通道扩展的尝试，但还有问题
2023-03-17 添加了显示屏的图纸
2023-03-17 GPIO多通道扩展继续尝试，目前单通道能跑通了
2023-03-18 尝试引入七段数码管的硬件驱动
2023-03-18 尝试引入七段数码管的硬件驱动和软件驱动，未成功
2023-03-18 做了些调试，没通
2023-03-18 提交了一份STM32寄存器版本的MDK工程模板
2023-03-18 确认多路GPIO跑通
2023-03-18 M0现在可以正常驱动硬件了
2023-03-18 添加了gitignore项
2023-03-18 项目文件无意义的变化
2023-03-18 更新了HAL库类型的工程建立模板
2023-03-18 更新了自建项目：或运算表决器
2023-03-19 新建了集创赛宣讲记录
2023-03-21 暂不清楚什么时候发生的改动，但保险起见先上传
2023-03-24 引入了有关显示屏和内存的代码样例
2023-03-25 向Final项目中引入了HDMI代码
2023-03-25 调制好了HDMI的代码，但不工作
2023-03-25 尝试将lcd_para中的参数改成1920x1080，但仍然没有解决问题
2023-03-25 增加了手柄相关资料链接
2023-03-25 显示屏好像开始工作了，但似乎不太稳定
2023-03-25 尝试连接了VGA的部分
2023-03-25 无实质更改
2023-03-25 成功的可以显示单种状态
2023-03-28 完成WII的编译
2023-04-01 现在HDMI_DATA及其相关问题被解决
2023-04-01 现在M0可以自由控制显示图案了
2023-04-01 现在M0可以用按键控制显示屏图案了
2023-04-01 引入LCD测试项目
2023-04-01 可以自行创建pll的IP，降低了显示屏的分辨率
2023-04-01 逐步取得对显示器的控制，但仍然有问题
2023-04-01 显示器调试成功
2023-04-01 显示器分辨率改至1024x600
2023-04-01 引入了SDRAM_AS_BRAM的代码
2023-04-02 改了很多东西，反正没啥东西在工作
2023-04-02 引入了SDRAM_VGA的示例
2023-04-02 找到了图案生成的关键代码，优化了它的缩进
2023-04-02 清理了大量无用代码
2023-04-02 显示屏取得控制
2023-04-03 游戏机功能雏形
2023-04-04 游戏内容进行了丰富
2023-04-08 在HDMITest中移除了RAM相关内容
2023-04-08 更换了Final中的HDMI部分
2023-04-08 尝试搞一些显示指令，失败
2023-04-08 显示取得了一些进展，现在可以控制显示屏的局部了
2023-04-09 可以在局部显示，但有怪问题
2023-04-09 改了一些问题，更糟了
2023-04-10 上传已经完成的IIC部分
2023-04-15 简化代码，尚能显示
2023-04-15 现在可以在红色的背景上显示绿色条带
2023-04-15 现在可以在红色的背景上显示花色条带，以最高频率工作
2023-04-15 现在可以显示一个半条带，但是还是散发着诡异的气息
2023-04-15 现在可以以最小32为步长写数据
2023-04-15 现在可以基本实现单像素写
2023-04-15 现在可以动态的调整写入长度，但刷屏速率是3秒
2023-04-15 现在真的好像可以工作了，前一个版本似乎有问题
2023-04-15 去除了不必要的内容，该版本是SDRAM_VGA_Display在挂总线前的最后版本
2023-04-16 将SDRAM_VGA项目并入Final，初步实现M0对显示屏的可控，但尚有两个问题，首先是sys_vaild的读取不成功，其次是分辨率变成了1920x1200。
2023-04-16 现在可用读取到sys_vaild等内容，可以正常绘制，但HDMI的时序似乎有问题，显示屏花的。
2023-04-16 做了些无用的改动
2023-04-16 现在屏幕好像好了？改动是加了个rst_n
2023-04-16 编写了一些C程序进行测试，基本成功，但刷新有问题
2023-04-16 没啥改动的
2023-04-22 修改了Final的main.c使得同时可以绘制两个方块
2023-04-22 上传了最近修改和C++代码
2023-04-22 开始正式项目，但是没工作
2023-04-22 可以正常开启调试，但程序无法运行
2023-04-22 新增了Final的一个副本
2023-04-22 向预期的方向靠近了一点
    [TD_devicesetting.cfg]
2023-04-22 向预期的方向又靠近一步
2023-04-24 游戏机初代V1.0
2023-04-29 现在RAM在Interconnect下了
2023-04-29 乱套了2
2023-04-29 将AHBLite级宏定义化
2023-04-29 将HDMI的复位信号标准化，将GPIO置于AHBLiteGPIO下
2023-04-29 将UART置于AHBLiteUART下
2023-04-29 将HDMI置于AHBLiteHDMI下
2023-04-29 变动了顶层架构
2023-04-29 修复了丢失的iopin
2023-04-29 将RAM部分进一步参数化
2023-04-29 修改了AHBLite下的实例名称
2023-04-29 GPIO初步调整成功
2023-04-29 找到一个神奇的片选语法，现在GPIO清楚多了
2023-04-29 取消了M的宏定义，GPIO调试完成
2023-04-29 将外设地址参数化
2023-04-29 将Digit改挂于AHBLite下
2023-04-29 为Digit添加了重置
2023-04-29 UART调试完毕
2023-04-30 引入了开源的HDMI编码
2023-04-30 现在项目可以在新的HDMI下工作了
2023-04-30 修改了main文件使得显示屏在不同颜色间切换
2023-04-30 除了1024x600的分辨率都无法在FinalCopy中运行，删除了相关宏定义
2023-04-30 不稳定的小游戏2
2023-04-30 尝试引入SDRAM as BRAM，未成功
2023-05-01 恢复旧的HDMI_SDRAM
2023-05-01 将GPU接口标准化
2023-05-02 实现了蜂鸣器的M0控制
2023-05-02 键盘功能受M0控制了
2023-05-02 将FinalCopy中的HDMI更换为开源版本
2023-05-02 将开源的HDMI调试稳定
2023-05-03 尝试引入PingPong，但未成功，系统仍然能运作
2023-05-03 约束了部分外设的addrin和addrout，这似乎与SoC工作不稳定有关
2023-05-03 为Buzzer,Digit,UART的addrin和addrout的约束
2023-05-03 切除了部分SDRAM原有的PingPong代码，现在的PingPong初步开始运作
2023-05-03 PingPong开始运作
2023-05-03 继续梳理SDRAM逻辑
2023-05-03 重建PrismGC项目
    [TD_devicesetting.cfg]
2023-05-04 错误的游戏
2023-05-07 实现了单像素的显示
2023-05-08 更新了失败的IIC
2023-05-09 贪吃蛇原型机（垃圾代码）
2023-05-11 添加了定时器功能
2023-05-11 错误代码
2023-05-11 调制代码架构，但现在M0运行紊乱
2023-05-11 无效的更改
2023-05-11 实现了一个基本框架代码
2023-05-11 测试了一下定时器，好像有点问题
2023-05-11 5月11日新代码
2023-05-11 修改了GPULite，现在不需要人为指定sys_wr_len了
2023-05-11 修正了main中的问题
2023-05-12 无事发生存个档
2023-05-12 增加了初始页BGM，恢复了血量计分功能
2023-05-13 更新了利用Timer优化开口位置功能
2023-05-17 更新了Level2关卡，完善了游戏内容
2023-05-26 完成了报告
2023-07-02 增加了gitignore以忽略视频文件
2023-07-02 新的IIC代码
2023-07-02 初赛后重新进入工作
2023-07-03 尝试引入I2C的代码，失败
2023-07-04 在C语言层面实现了字符的显示
2023-07-04 整理了部分顶层硬件代码
2023-07-04 将各模块的硬件代码格式化
2023-07-04 移除了部分无用文件，提出了两个GPU相关代码
2023-07-04 进一步移除无用的GPU相关文件
2023-07-04 删除了fifo的包装文件
2023-07-04 将GPU模块中mem的使用参数化
2023-07-04 移除了SDRAM_HDMI_Display，将其内容并入GPU
2023-07-04 将GPU部分整理干净
2023-07-04 将GPUDataControl中的变量名与上级一致化
2023-07-04 修正了若干警告
2023-07-04 修改了WriteFIFO的触发深度至8及其关联值，大幅提示了效率
2023-07-05 尝试将GPUDataControl提至GPU，失败，文件备份至Test/GPUFailed
2023-07-05 将GPU恢复原样
2023-07-05 进一步提高显示速度
2023-07-05 删除了硬件代码一些无用的注释
2023-07-05 增大RAM空间由16KB至32KB
2023-07-05 Pixels缓冲区的大小由16增大至64
2023-07-05 C语言进行了整理
2023-07-05 假期调试完毕
2023-07-07 不知道修改了啥
2023-07-07 开始修改
2023-07-07 开始了方块的测试
2023-07-07 测试绘图
2023-07-07 编写了一个地图绘制的Demo
2023-07-07 合并后完成了地图Demo的渲染
2023-07-07 “更正格式”
2023-07-07 上传了主角的画法和第一关内容
2023-07-07 实现了字符缩放，但最多两倍，三倍会出问题
2023-07-07 画出起点、终点和陷阱方块
2023-07-07 合并后做了一些修改
2023-07-07 尝试引入LCDPrintf，失败
2023-07-07 增加了按键控制方块移动功能
2023-07-07 增加了只能在冰块上行走的功能，但尚需改进
2023-07-07 加入了LCDPrintf，将主角的绘制代码规范化
2023-07-07 优化了上下左右的移动
2023-07-07 造成了一定的错误
2023-07-07 完成了lmj设计关卡的录入和起始位置选择（未制作具有选择关卡功能的副本）
2023-07-08 奇怪的不知道哪里来的修改
2023-07-08 完善了移动功能
2023-07-08 上传了启动页和选关菜单的代码
2023-07-08 实现了文字和主角的多倍放大
2023-07-08 项目文件的无效修改
2023-07-09 合并lmj的分支，修改了一个错误
2023-07-09 优化了菜单界面
2023-07-09 未完成的移动改进
2023-07-10 修复异常修改
2023-07-10 优化了史莱姆图像
2023-07-10 重新提交菜单页面
2023-07-10 修正了菜单界面的问题，将菜单和游戏连接起来
2023-07-10 完成了启动页和选关菜单的基本工作
2023-07-10 还需要完善的移动
2023-07-11 现在可以用手柄控制游戏了
2023-07-11 暂时改回用按键控制
2023-07-11 到终点时可以进行换页
2023-07-11 画了个苹果并放到了启动页上
2023-07-11 完善了移动，增加了不完整的结算页面
2023-07-12 引入了GetKey()统一手柄和按键操作
2023-07-12 首页上也可以用手柄进入菜单了
2023-07-12 完成了第一关苹果的显示和吃苹果判定
2023-07-12 增加了END页面
2023-07-12 修复了一个在边缘移动出错的bug
2023-07-12 尝试修复PageMazeGame，未成功
2023-07-12 完成对zy的分支
2023-07-12 关闭了手柄操作
2023-07-12 完善了end页面
2023-07-12 进行有关终点的测试
2023-07-12 初步完成主角和苹果的调色盘
2023-07-12 有缺陷的规定方向方块
2023-07-13 完成了当前characters的调色盘并新增了白色箭头
2023-07-13 完善了移动方块，改进了end页面，绘制了右箭头，但存在问题
2023-07-13 合并lmj的分支
2023-07-14 审阅了代码
2023-07-14 现在折射方块可以正常工作了
2023-07-14 稍有改进
2023-07-14 合并了zy的代码
2023-07-14 增加了level2
2023-07-14 删除了GPULite中的一个无用的注释
2023-07-14 修复了显示地图时写死level1的问题
2023-07-14 修复了箭头绘制的问题 并且新增控制箭头颜色的参数
2023-07-14 修复了左右箭头不对称的问题
2023-07-14 优化了调色盘方案的实现
2023-07-14 END又双叒叕出bug了
2023-07-14 修复了level2无法正常结束的问题
2023-07-14 完成了碎石的显示部分，并且改用点画矩形
2023-07-14 增加了level2和level3
2023-07-14 调试管卡
2023-07-14 优化了冰块的显示
2023-07-14 改进了level1
2023-07-14 修改了首页
2023-07-14 将RamWrite由udelay(5)改为ndelay(1000)，但End界面再次会消失
2023-07-14 修复了End界面消失的问题
2023-07-14 继续调试
2023-07-14 关卡更新至level10
2023-07-14 实现了碎石块
2023-07-14 现在GetKey()在手柄没有接入时也能正常工作了
2023-07-14 令PageMenu能记住上一次选中的关卡
2023-07-14 引入传送门方块
2023-07-15 增加至level16
2023-07-15 引入了传送门
2023-07-15 完成17-20关的关卡和传送门显示的修改
2023-07-15 合并zy的分支
2023-07-15 增加了lmj游戏的注释
2023-07-16 修复了传送门的bug
2023-07-16 修改答案位置
2023-07-16 完成了关卡28-32的设计
2023-07-16 更新至level27
2023-07-16 更新音效
2023-07-16 新增了复赛文档
2023-07-17 更新了Menu界面的音效
2023-07-17 完成了游戏介绍的文字部分
2023-07-17 设想了部分答辩问题并上传了元素图片
2023-07-17 引入了绘制地图的程序
2023-07-18 新增了lmj关卡的答案
2023-07-20 任意键进入游戏菜单
2023-07-21 完成文档
2023-07-21 修复了一个小问题
2023-07-21 新建了演讲稿
2023-07-28 增加了TRP方块
2023-07-30 完成了机关门及其开关动效的绘制
2023-07-30 更新了机关
2023-08-01 绘制了陷阱方块，并通过测试
2023-08-01 进一步完善了机关
2023-08-01 完善了机关，单支switch语句已修改为if语句
2023-08-06 稍作修改
2023-08-06 自制板卡
    [Adapter-B_Cu.gbr, Adapter-B_Mask.gbr, Adapter-B_Paste.gbr, Adapter-B_Silkscreen.gbr, Adapter-Edge_Cuts.gbr, Adapter-F_Cu.gbr, Adapter-F_Mask.gbr, Adapter-F_Paste.gbr]
2023-08-06 动画和机关合并完毕
2023-08-07 完成对应状态按钮的绘制，并尝试加入画圆的函数
2023-08-08 优化了画圆算法 同步了关卡中开关函数（备注：主界面画的圆中心裂开了 但关卡不受影响）
2023-08-08 修复了一些问题
2023-08-08 更新了关卡33和关卡34
2023-08-12 完成了33到46关的设计
2023-08-12 完成机加工文件
    [002.dwg, 002.stp, Adapter.kicad_pcb, PrismGC.0004.ipt, PrismGC.ipt, PrismGCNew.0004.dwg, PrismGCNew.0015.ipt, PrismGCNew.dwg]
2023-08-12 修复了内存的问题
2023-08-13 尝试修改硬件RAM配置
2023-08-14 改用BRAM32k实现程序空间
2023-08-14 现在BRAM32k的程序空间扩大到64KB，修正printf的一个错误
2023-08-14 现在可以脱离电源工作
2023-08-14 乱七八糟的烂摊子
2023-08-14 TD版本升级到5.0.5，恢复稳定
2023-08-14 没啥修改
2023-08-14 大量修改，现在勉强可以稳定运行
2023-08-14 又做了些修改
2023-08-15 完成了关卡的初步设计
2023-08-16 修复了栅栏门的bug
2023-08-16 分支合并完成
2023-08-16 优化显示
2023-08-16 完成了33-35关的重新设计 优化了苹果、陷阱的显示
2023-08-16 修复了启动页面方块显示异常的问题
2023-08-16 完成了失败页面的颜色调整
2023-08-16 调整了菜单页面的色彩
2023-08-17 硬件上支持了3.5mm音频输出
2023-08-17 现在可以切换音频输出了
2023-08-17 现在可以接受14个音高了
2023-08-17 绘制了云彩 优化了启动页面显示 并尝试修改菜单和游戏页背景
2023-08-17 更新end界面两首bgm
2023-08-17 调整手柄的交互
2023-08-17 更新了致爱丽丝
2023-08-17 完成合并
2023-08-18 新增了决赛报告
    [Adapter.kicad_pcb]
2023-08-19 完成决赛PPT
