liyuxuan3003/PrismGC/(notices)

Notices in the files:
Test/zy/PersonalTest/GAME01/Drivers/SYSTEM/usart/usart.c:
@license Copyright (c) 2020-2032, ¹ãÖÝÊÐÐÇÒíµç×Ó¿Æ¼¼ÓÐÏÞ¹«Ë¾
