liyuxuan3003/PrismGC/Report/20230817-PrismGCDocumentFinal/image/3.jpg

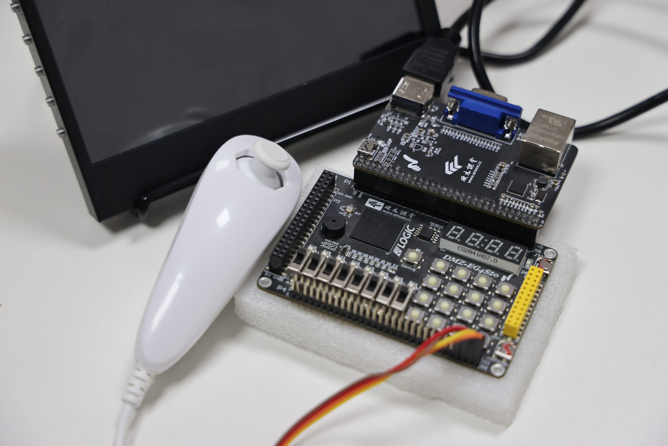
Report/20230817-PrismGCDocumentFinal/image/3.jpg
